Freezepok/CAD-Paspa/Useless Box/Dokumentation/Dokumentation JH/Screenshots/Montage_10.png

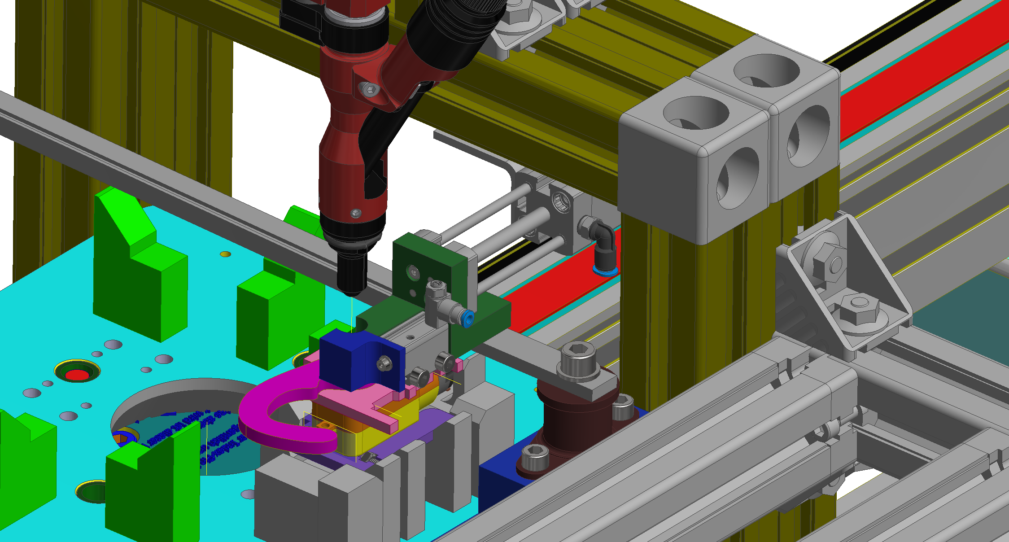
Useless Box/Dokumentation/Dokumentation JH/Screenshots/Montage_10.png
