Freezepok/CAD-Paspa/Useless Box/Dokumentation/Dokumentation JH/Screenshots/Montage_14.png

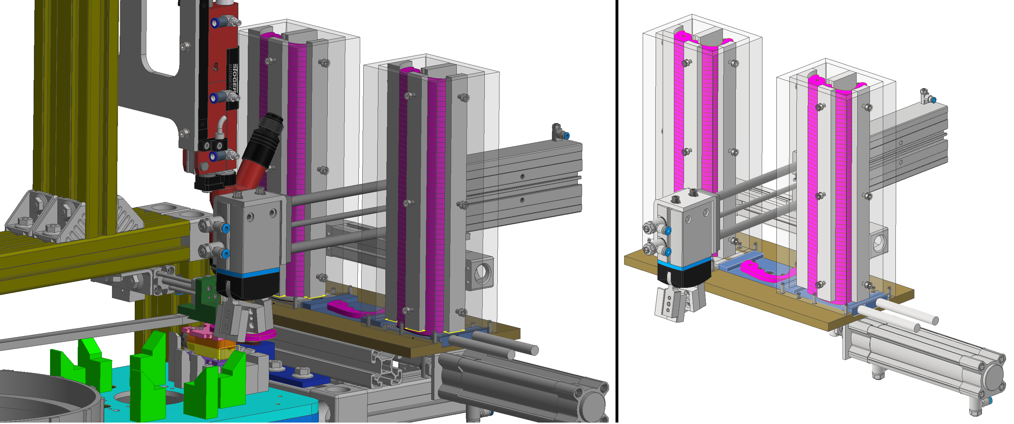
Useless Box/Dokumentation/Dokumentation JH/Screenshots/Montage_14.png
