Freezepok/CAD-Paspa/Useless Box/Praesentation/Praesentation_Gruppe5.pptx

## Useless Box

- Gruppe 5: Fingermontage auf der Antriebseinheit

- Jakob Hoffman, Tino Stöhr, Erik Reisich | MR | SoSe 2025

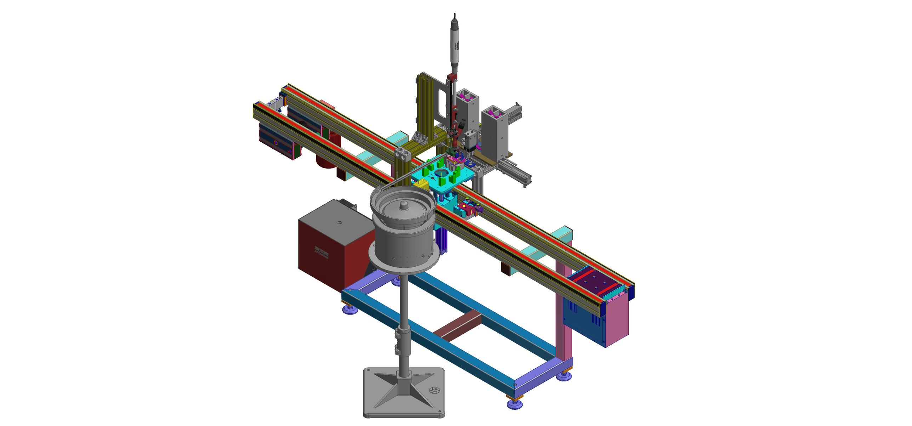
[picture p3: figure]

Useless Box | Jakob Hoffman, Tino Stöhr, Erik Reisich | MR | SoSe 2025

## Themen

- Konzeptentwicklung
- Baugruppen
- Fazit

## Konzeptentwicklung

- Aufgabenstellung
- erste Ideen
- Vorgehensweise

## Konzeptentwicklung

## Baugruppen

- Erkennung Wellenlage
- Handhabung Finger
- Handhabung Unterlegscheiben
- Verschraubeinheit

## Baugruppen

## Fazit

## Fazit

## Slide 9

- Gruppe 5

- Vielen Dank
