Freezepok/CAD-Paspa/Useless Box/__Projekt_Useless_Box.pdf

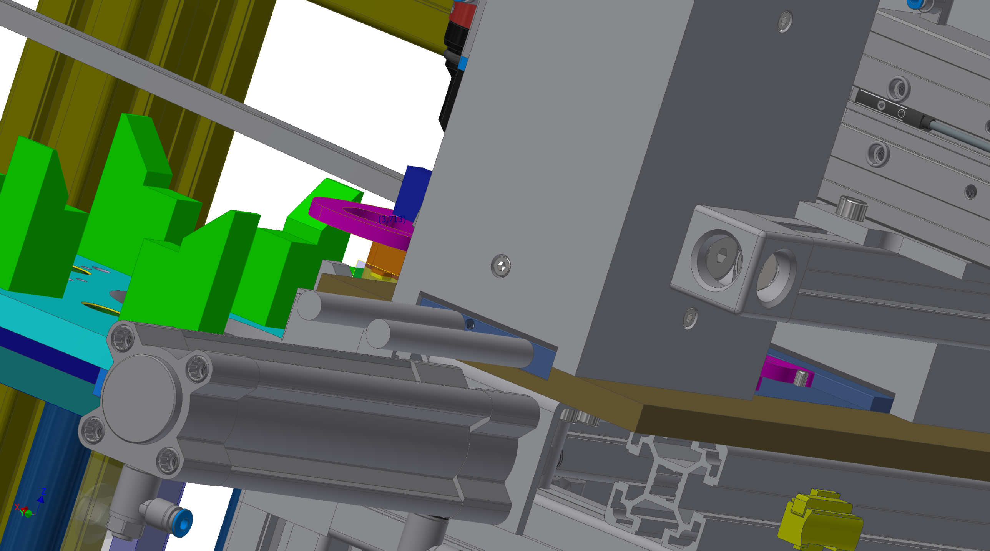
[picture p26: page 1]
