Freezepok/CAD-Paspa/Paspa/Vorlesung/KmC-03.pdf

## Konstruieren mit CAD

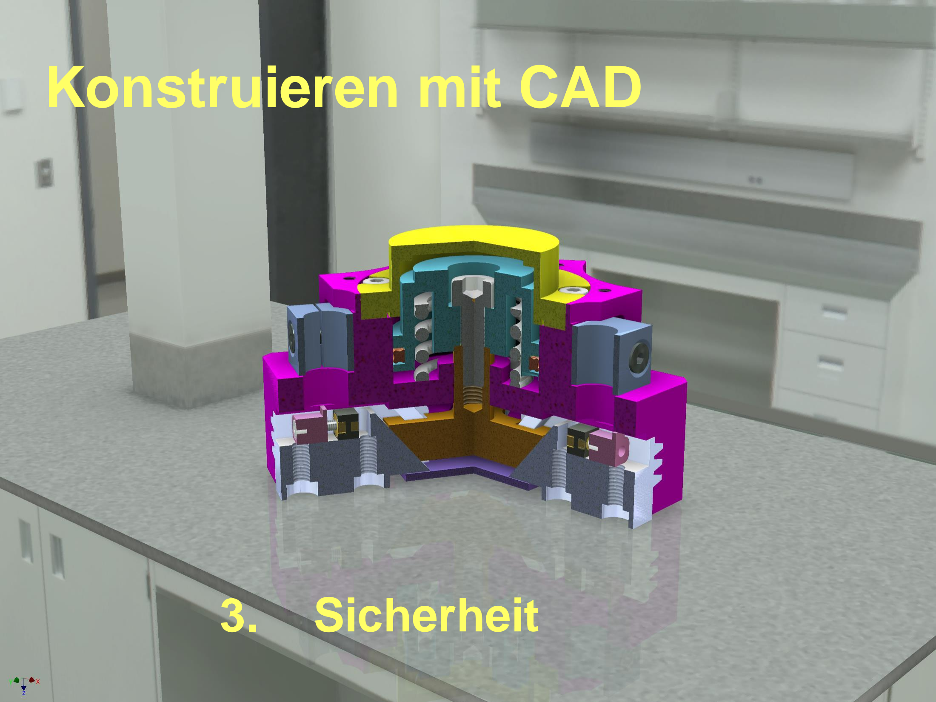
[picture p27: page 1]

### 3. Sicherheit

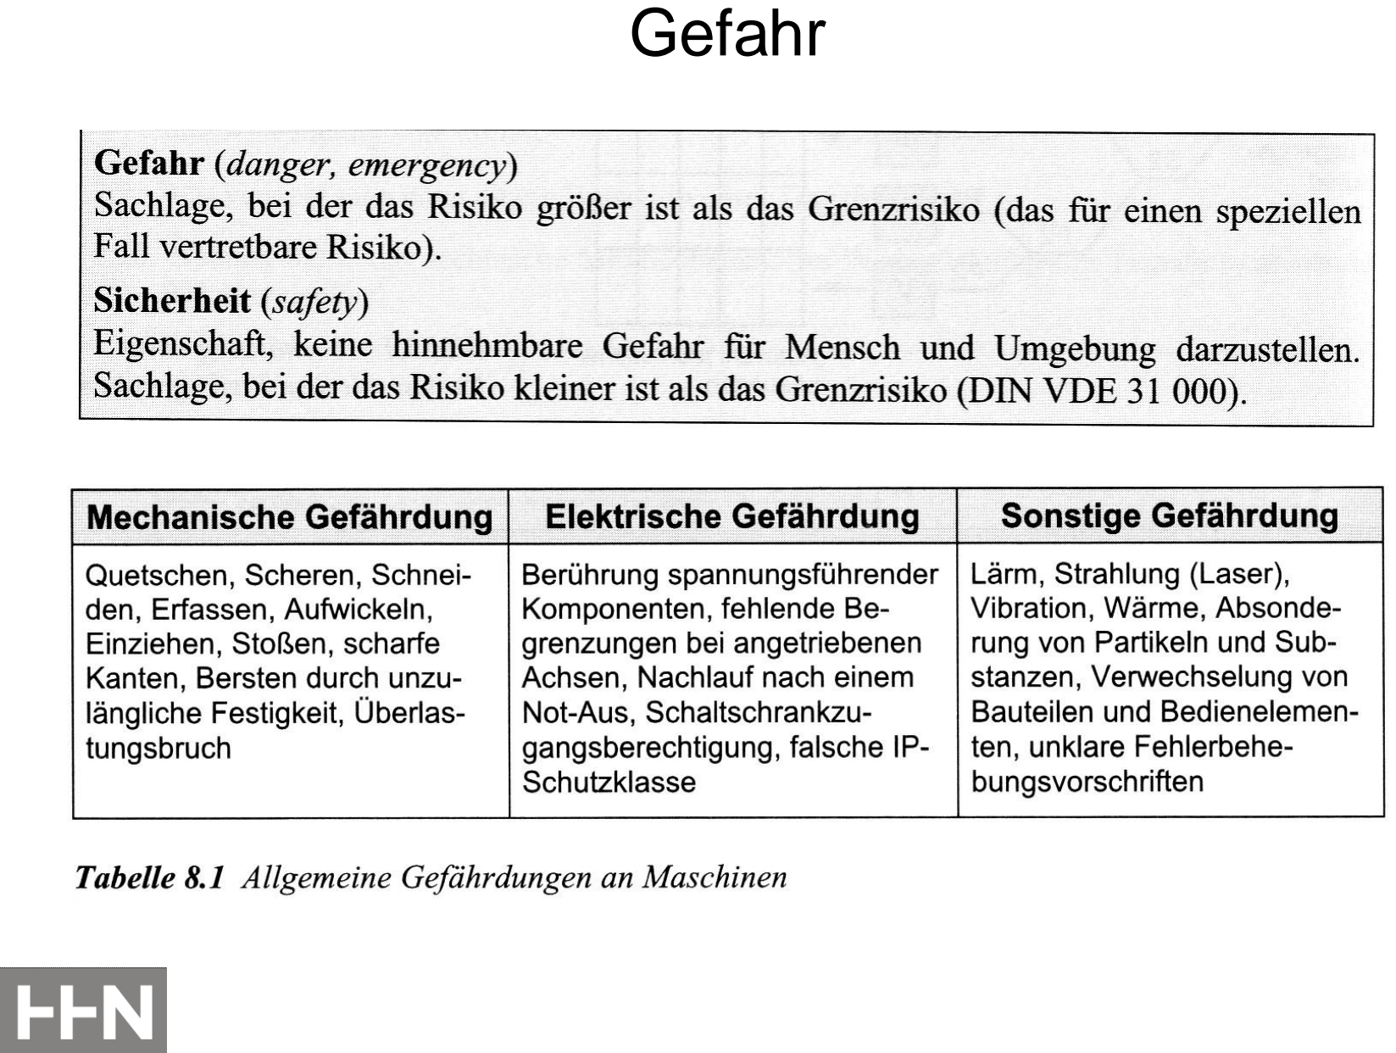
[picture p28: page 2]

Gefahr

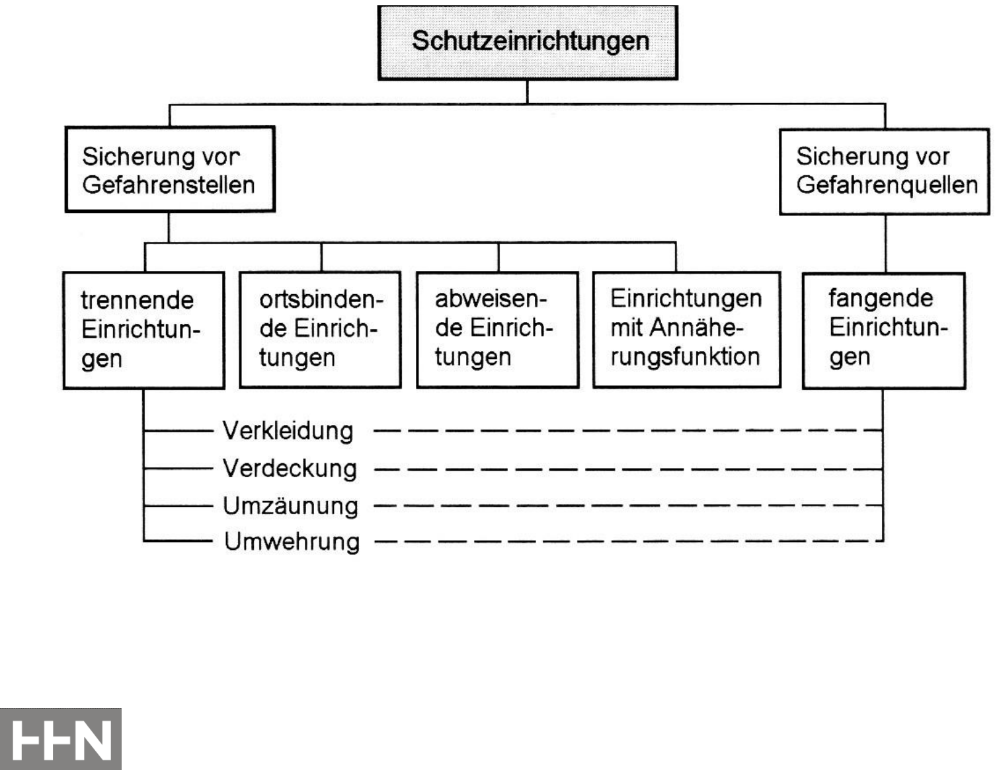
[picture p29: page 3]

Schutzeinrichtungen

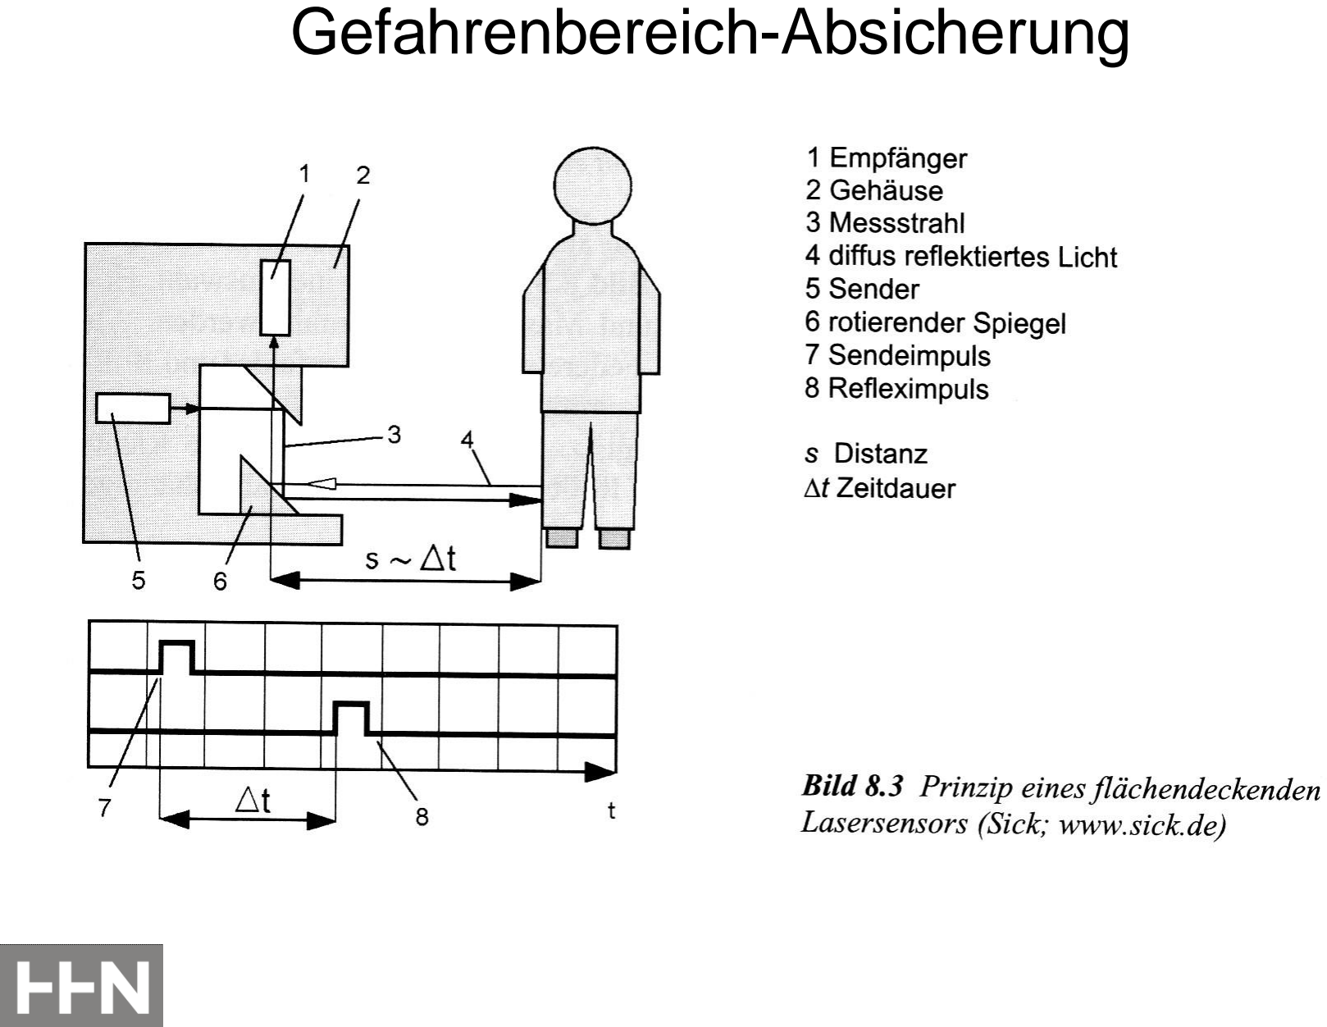
[picture p30: page 4]

Gefahrenbereich-Absicherung

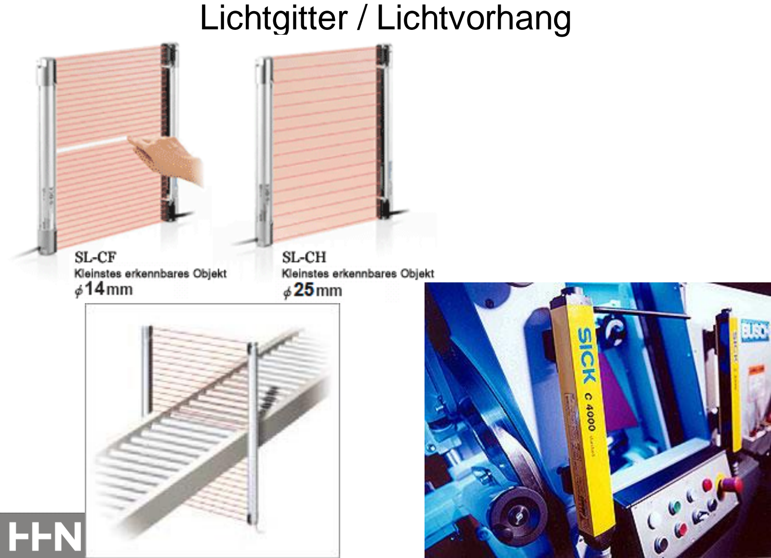
[picture p31: page 5]

Lichtgitter / Lichtvorhang

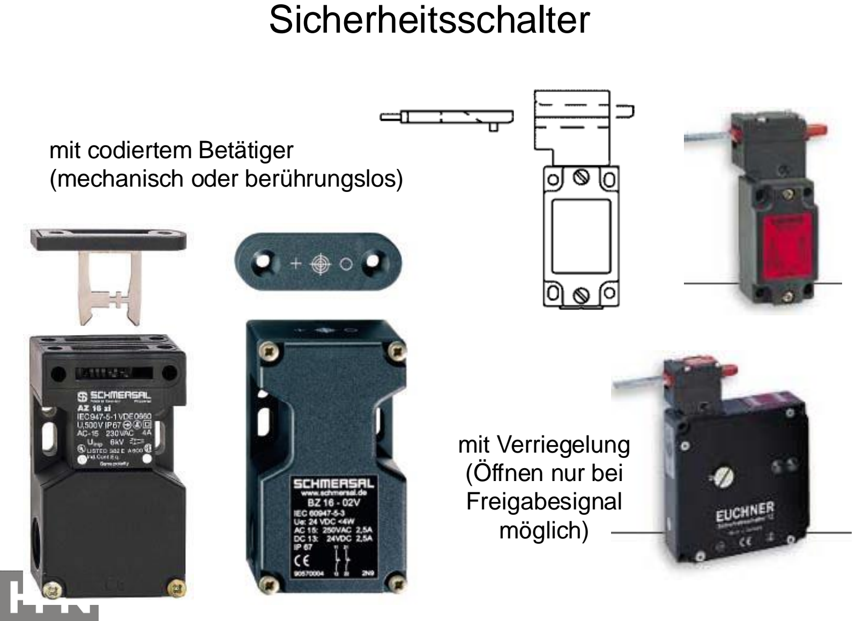
[picture p32: page 6]

Sicherheitsschalter

mit codiertem Betätiger
(mechanisch oder berührungslos)

mit Verriegelung
(Öffnen nur bei
Freigabesignal
möglich)

Sicherheitsvorrichtung bei Teilezuführung

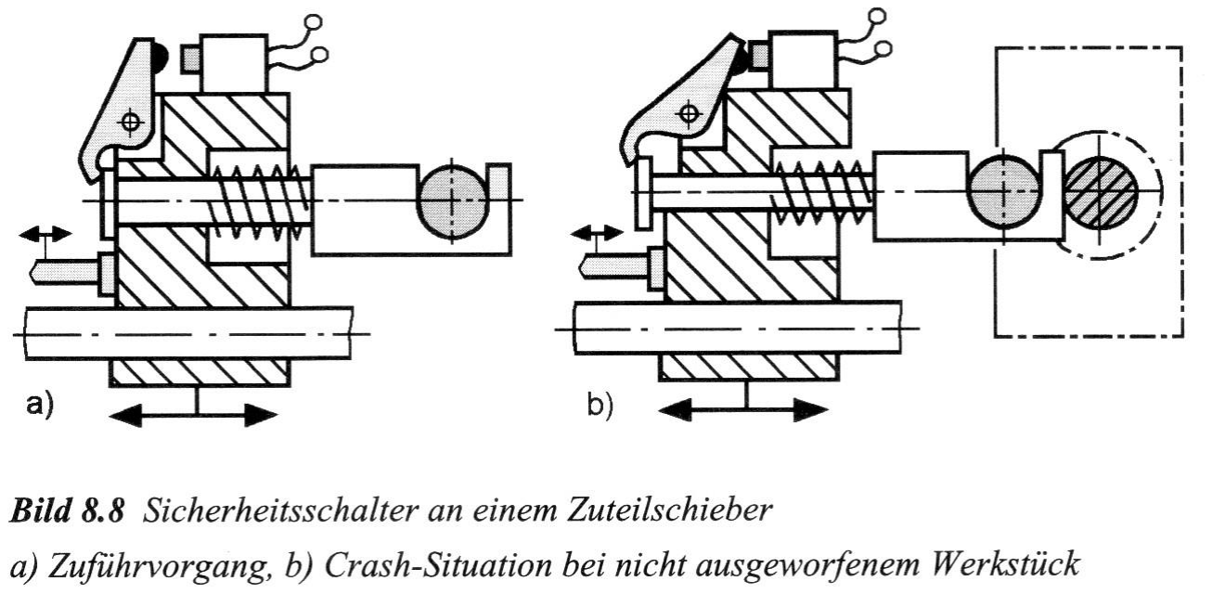
[picture p33: figure]

Sicherheitsvorrichtung bei Teilezuführung

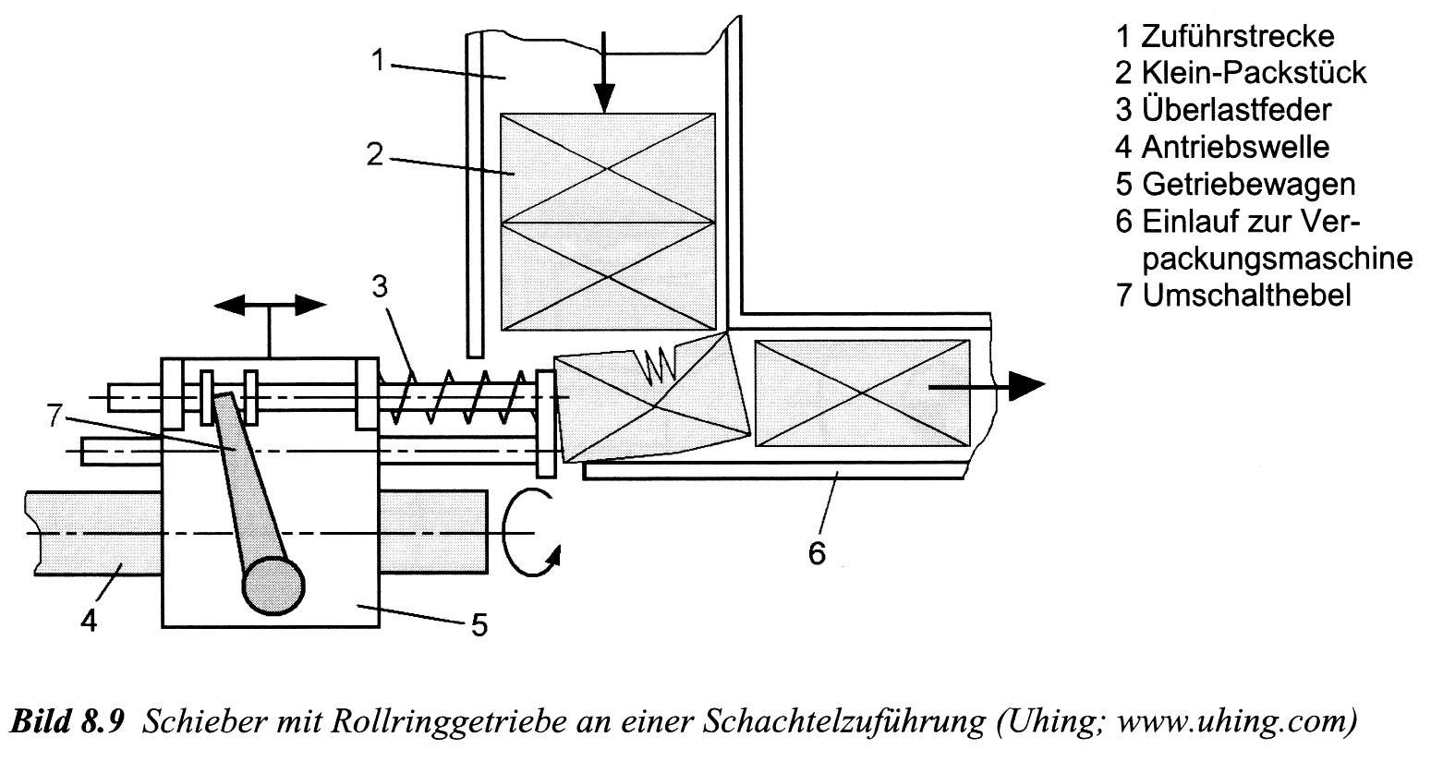
[picture p34: figure]
