Freezepok/CAD-Paspa/Paspa/Vorlesung/KmC-05.pdf

## Methodische Produktentwicklung

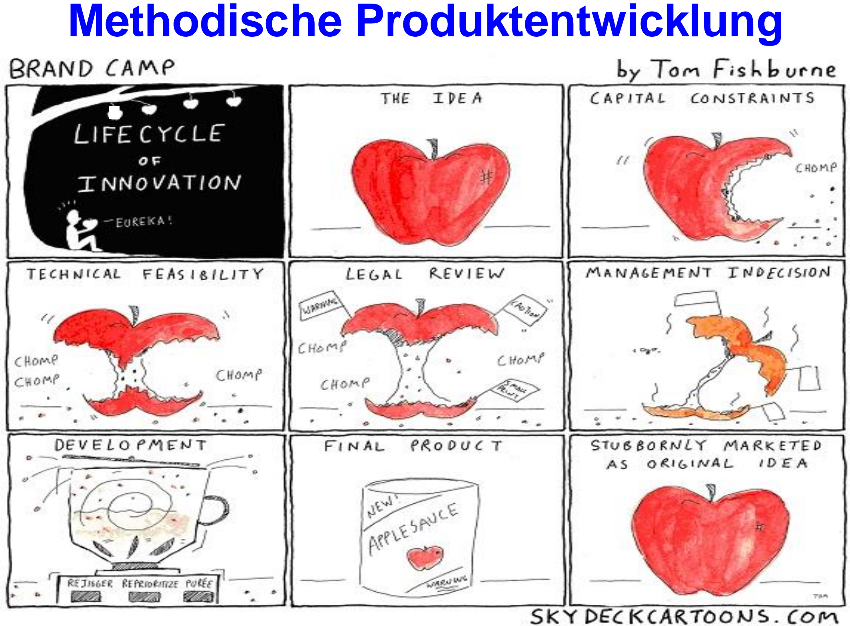
[picture p35: page 1]

Zunahme der
Informationen zur
Erzeugung einer
Lösungsvielfalt

Einschränkung der
Lösungsvielfalt

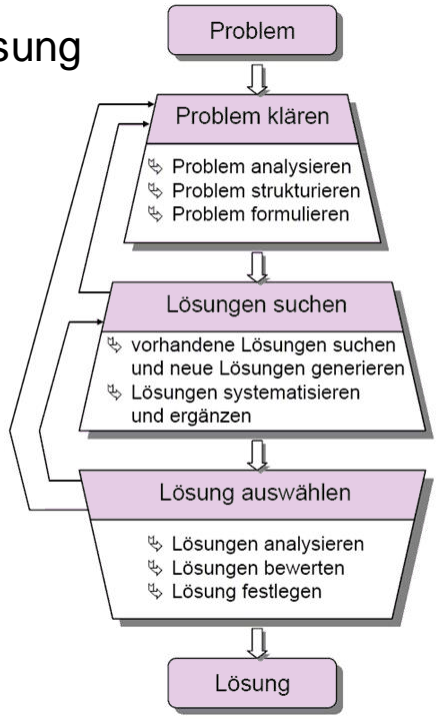
[picture p36: figure]

## Vom Problem zur Lösung

## Teilschritte

## Entwicklungsprozess nach VDI 2223

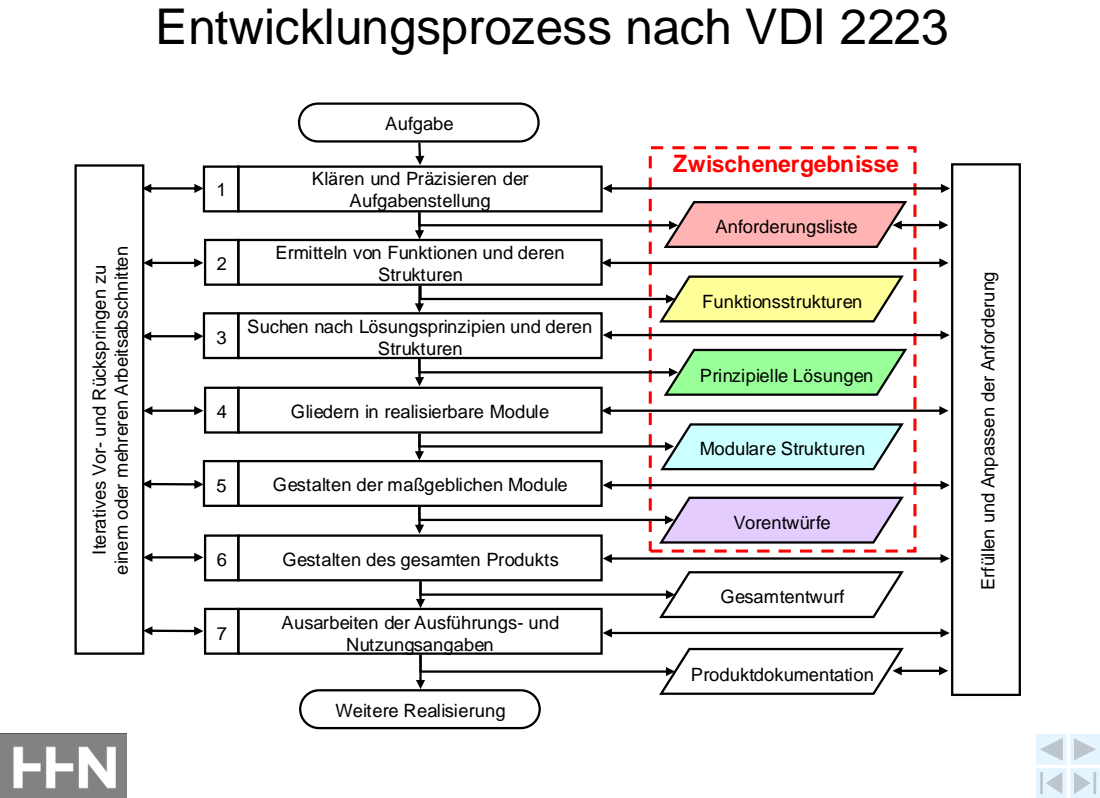
[picture p37: page 3]
Zwischenergebnisse; Aufgabe; Aufgabenstellung 1; Strukturen 2; Weitere Realisierung; Gliedern in realisierbare Module; Gestalten der maßgeblichen Module; Gestalten des gesamten Produkts; Nutzungsangaben 7; Anforderungsliste; Funktionsstrukturen; Prinzipielle Lösungen; Modulare Strukturen; Vorentwürfe; Gesamtentwurf; Produktdokumentation

Klären und Präzisieren der

einem oder mehreren Arbeitsabschnitten

Ermitteln von Funktionen und deren

Iteratives Vor- und Rückspringen zu

Erfüllen und Anpassen der Anforderung

Suchen nach Lösungsprinzipien und deren
Strukturen 3

Ausarbeiten der Ausführungs- und

## Straßenbeleuchtung früher | und heute

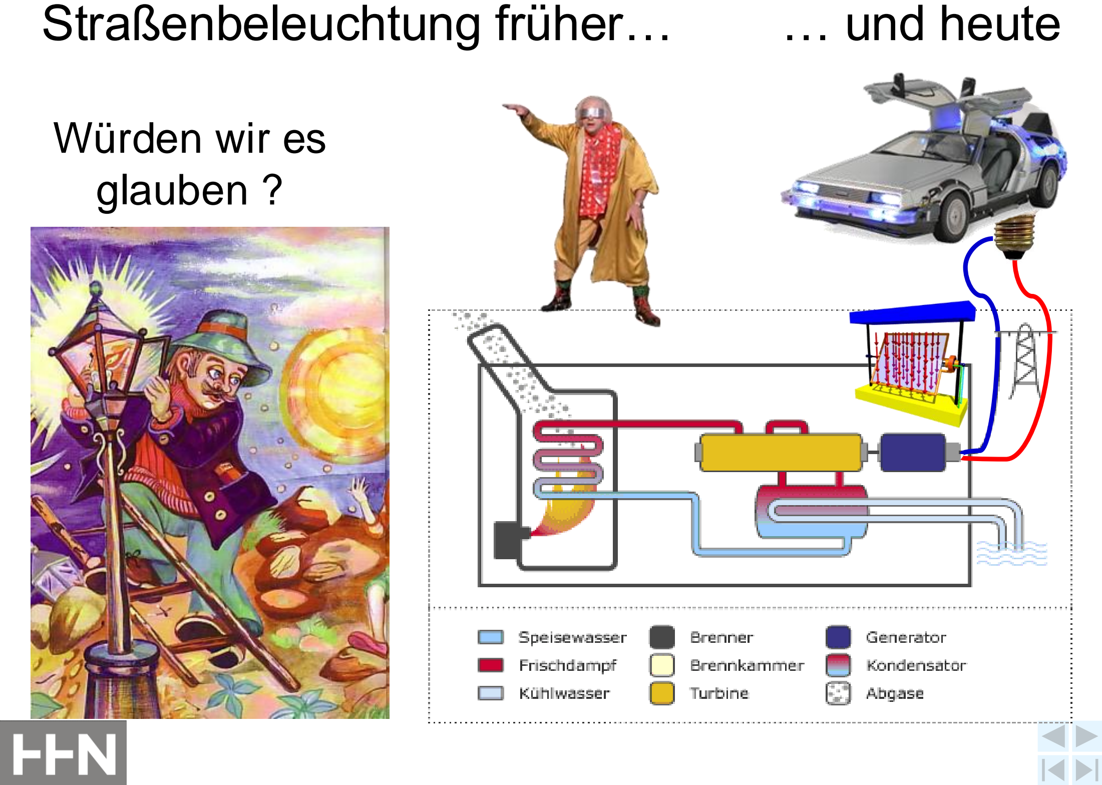
[picture p38: page 4]

Würden wir es
glauben ?

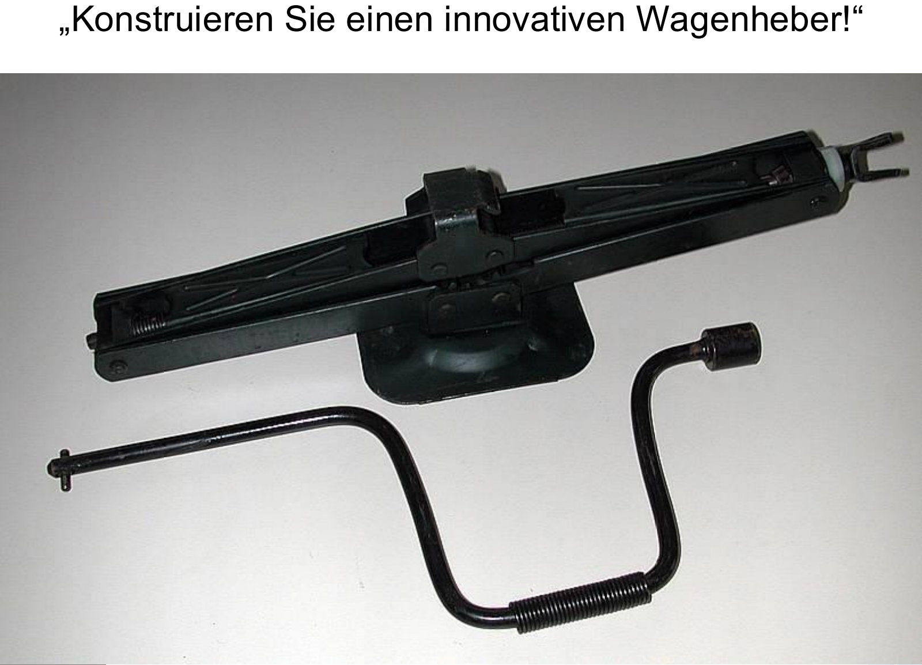
[picture p39: page 5]

„Konstruieren Sie einen innovativen Wagenheber!“

## Die Crux

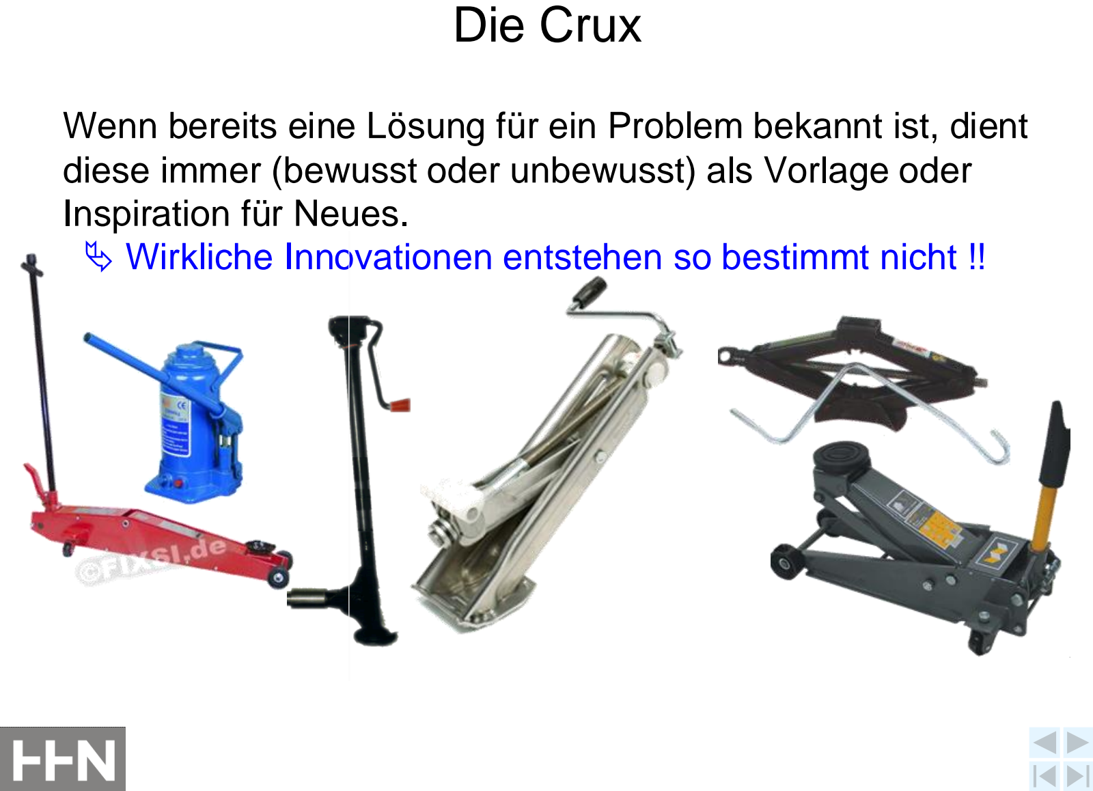
[picture p40: page 6]

Wenn bereits eine Lösung für ein Problem bekannt ist, dient diese immer (bewusst oder unbewusst) als Vorlage oder Inspiration für Neues.
- Wirkliche Innovationen entstehen so bestimmt nicht !!

## Hauptfunktion und Nebenfunktionen

Hauptfunktion
- Fahrzeug anheben
Nebenfunktion
- Befestigung im Fahrzeug bei Nichtgebrauch
- Demontierbar (einfachere Unterbringung)

## Anforderungen

Hauptfunktion
- Fahrzeug anheben
Nebenfunktion
- Befestigung im Fahrzeug bei Nichtgebrauch
- Demontierbar (einfachere Unterbringung)

Teilfunktion
- Fixierung am Fahrzeug ➔ Wo, Wie ?
- Muskelkraft verstärken ➔ Betrag ?
- Fahrzeug oben halten ➔ Gewicht ?

## Anforderungsliste

Nr. | Anforderung | Zahlenwert Toleranz | Forderung Wunsch | Name | Datum
1 | Befestigungsmöglichkeit | | F | AB | 31.10.
2 | Verfügbare Muskelkraft | 100 N | F | EF | 25.09.
3 | Fahrzeugmasse | 2000 kg | F | AB | 05.11.
4 | Unterbringung | | W | GH | 10.12.
5 | Demontierbarkeit | W | CF | 08.11.

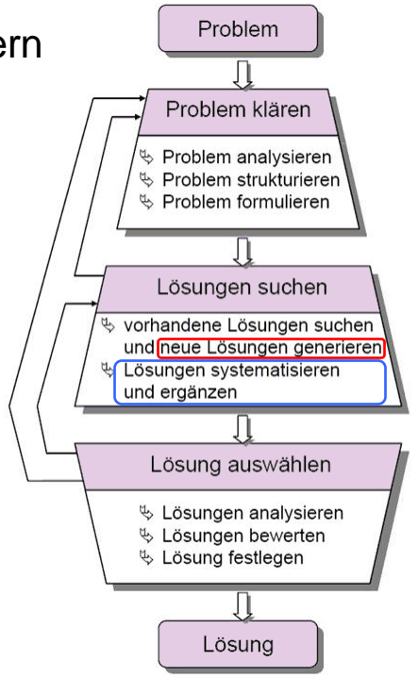
[picture p41: figure]

## Lösungsraum erweitern

## Lösungsraum erweitern

- Bekannte oder zufällig gefundene Lösungen könnten unterschieden werden anhand:
– Effekte, Form, Größe, Wirkflächen, Freiheitsgrade, Verbindungsarten, Fertigungsverfahren
- Gezielte Variation einzelner Merkmale vereinfacht die Suche nach alternativen Lösungen
- Zusammenfassung der Kombinationen einzelner Merkmale in Matrix-Form
- Zunächst freibleibende Felder deuten auf weitere, bisher unbekannte Lösungen hin (Systematische Erweiterung)

## Aufgabe: „Objekt beschleunigen“ (vgl. „Werfen“)

# Brainstorming: 1.Idee: 2.Idee: 3.Idee: 4.Idee:

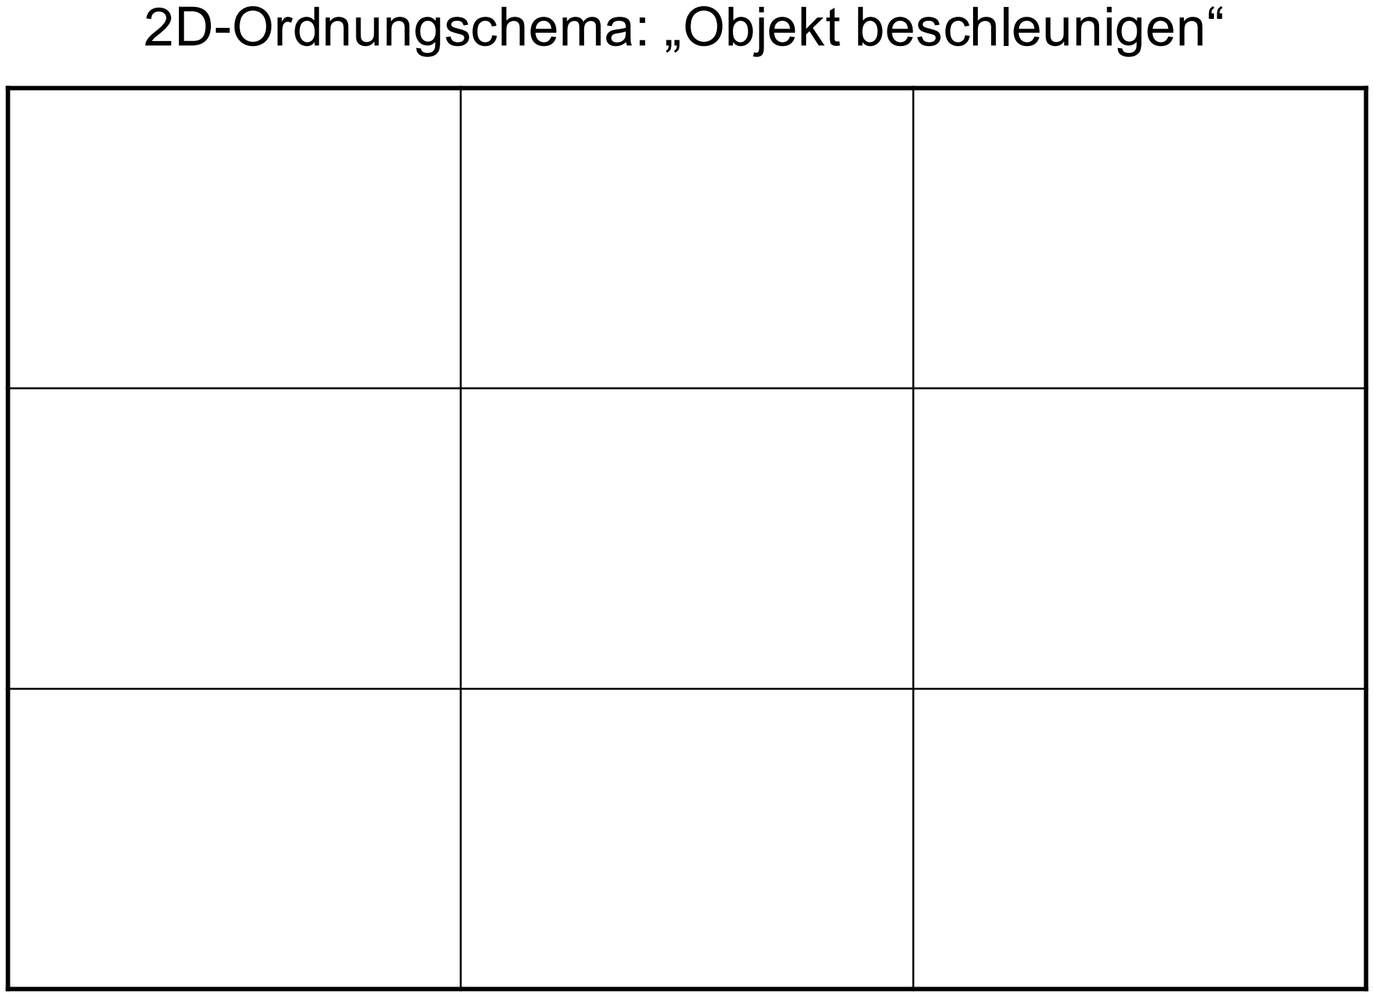
[picture p42: figure]
2D-Ordnungschema: „Objekt beschleunigen“

## Morphologischer Kasten

- Hilfsmittel zur Zusammenfassung von Teillösungen für Teilfunktionen
- Erlaubt die übersichtliche Kombination zu verschiedensten Gesamtlösungen
Funktion | Lösungen
Teilfunktion 1 | Teillösung 1.1 | Teillösung 1.2
Teilfunktion 2 | Teillösung 2.1 | Teillösung 2.2
Teilfunktion 3 | Teillösung 3.1 | Teillösung 3.2 | Teillösung 3.3
Teilfunktion 4 | Teillösung 4.1 | Teillösung 4.2 | Teillösung 4.3
Teilfunktion 5 | Teillösung 5.1 | Teillösung 5.2 | Teillösung 5.3 | Teillösung 5.4
Ges.-Lös. A Ges.-Lös. B | Ges.-Lös. C

## Methodeneinsatz zu vorchristlicher Zeit

Holzscheiben mit gruppierten Konstruktionsmerkmalen zur Entwicklung neuer Kampfmaschinen
(Archimedes v. Syracus, 287-212 v.Chr.)

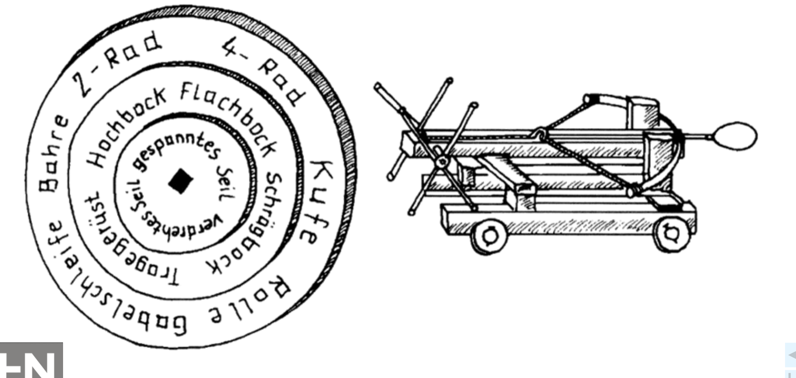
[picture p43: figure]

## Variation der Lage

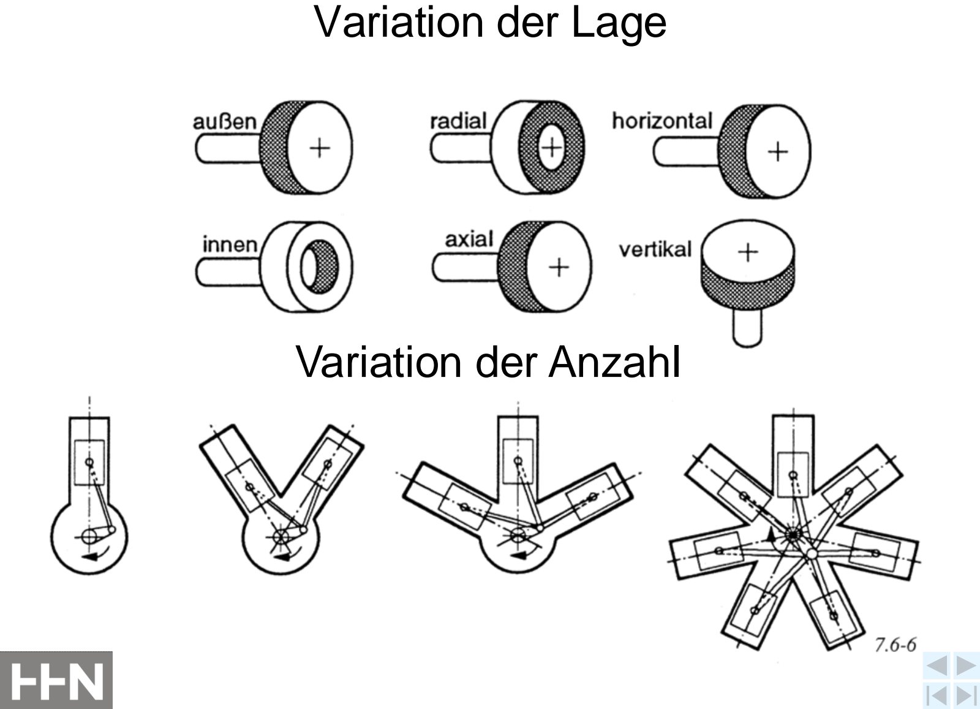
[picture p44: page 16]

## Variation der Anzahl

## Variation der Verbindungsstruktur

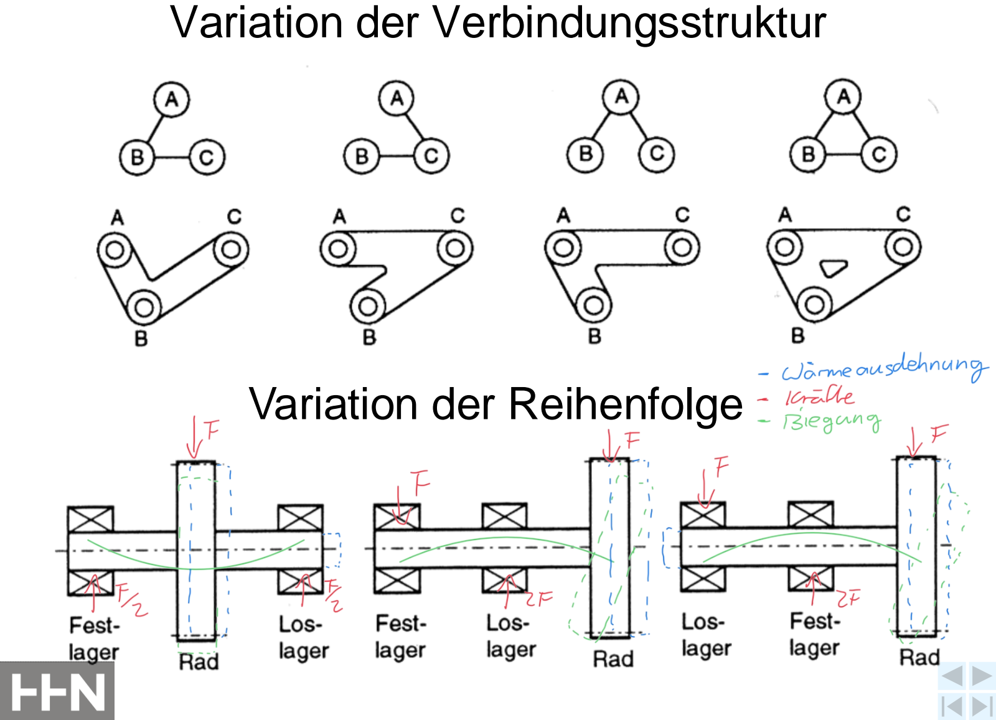
[picture p45: page 17]

## Variation der Reihenfolge

## Variation der Kompaktheit

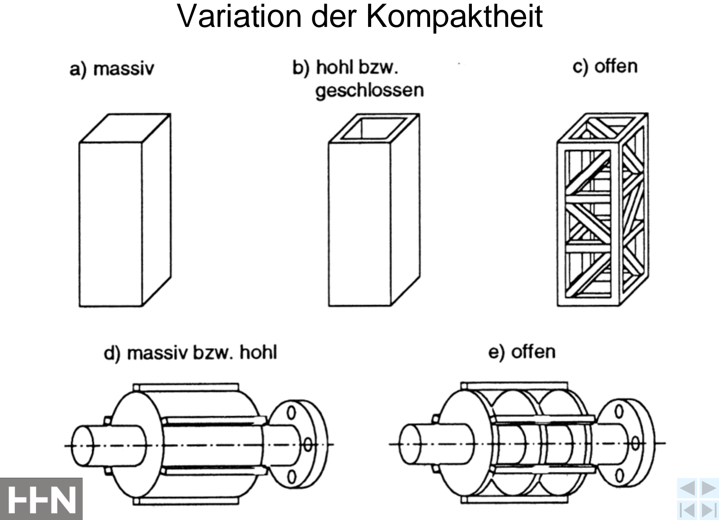
[picture p46: page 18]

Umwelt

System

Wagenheber als System

Abstrakte Betrachtungsweise (Black-Box-Prinzip)
Ein System interagiert über die Systemgrenzen hinweg mit
seiner Umwelt
Systemgrenzen sollte derart festgelegt werden, dass die Zahl der Interaktionen gering ist und die Arten (Funktionen) der Interaktion bekannt bzw. einfach bestimmbar sind
Ein System kann aus Elementen und Subsystemen bestehen

Systemgrenze

Umwelt | Wagenheber als System

Abstrakte Betrachtungsweise (Black-Box-Prinzip)
Ein System interagiert über die Systemgrenzen hinweg mit
seiner Umwelt
Systemgrenzen sollte derart festgelegt werden, dass die Zahl der Interaktionen gering ist und die Arten (Funktionen) der Interaktion bekannt bzw. einfach bestimmbar sind
Ein System kann aus Elementen und Subsystemen bestehen

Untergrund

KFZ | Mensch

System

Systemgrenze

Wirkzusammenhänge
(Relationen)

Wagenheber als System

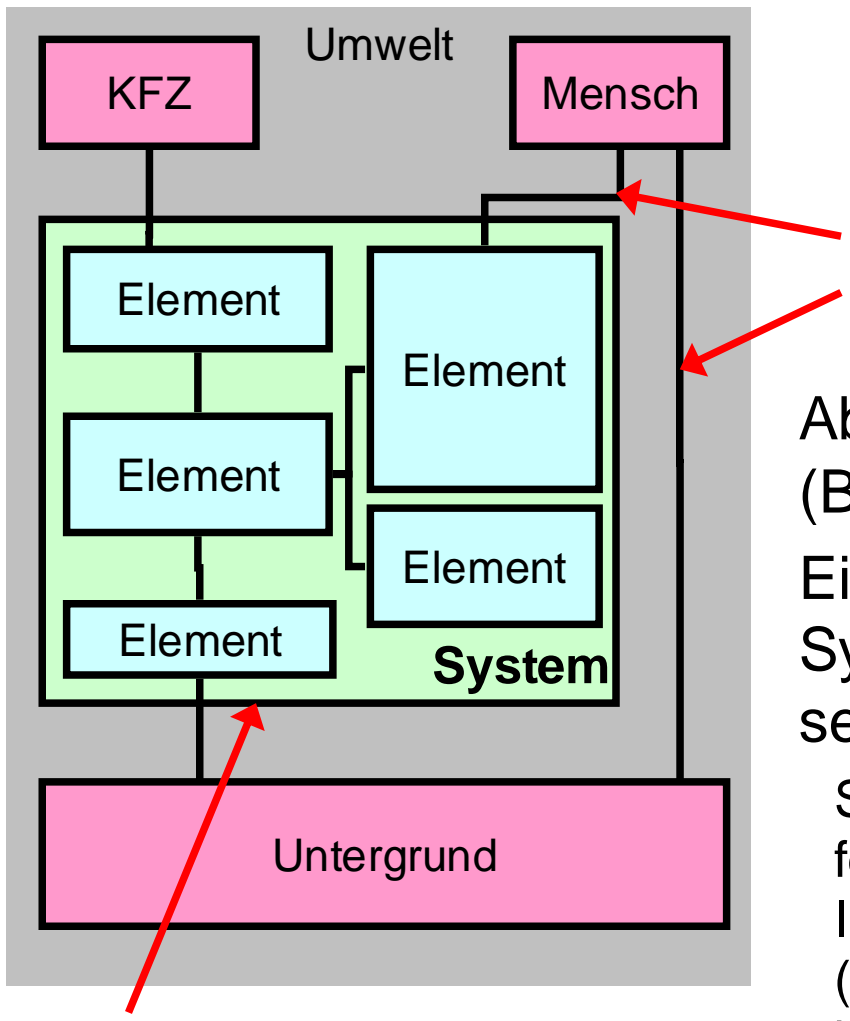
[picture p47: figure]
Umwelt; System; Untergrund; Element; KFZ; Mensch

Abstrakte Betrachtungsweise (Black-Box-Prinzip)
Ein System interagiert über die Systemgrenzen hinweg mit
seiner Umwelt
Systemgrenzen sollte derart festgelegt werden, dass die Zahl der Interaktionen gering ist und die Arten (Funktionen) der Interaktion bekannt bzw. einfach bestimmbar sind
Ein System kann aus Elementen und Subsystemen bestehen

Wirkzusammenhänge
(Relationen)

Systemgrenze

Wagenheber als System

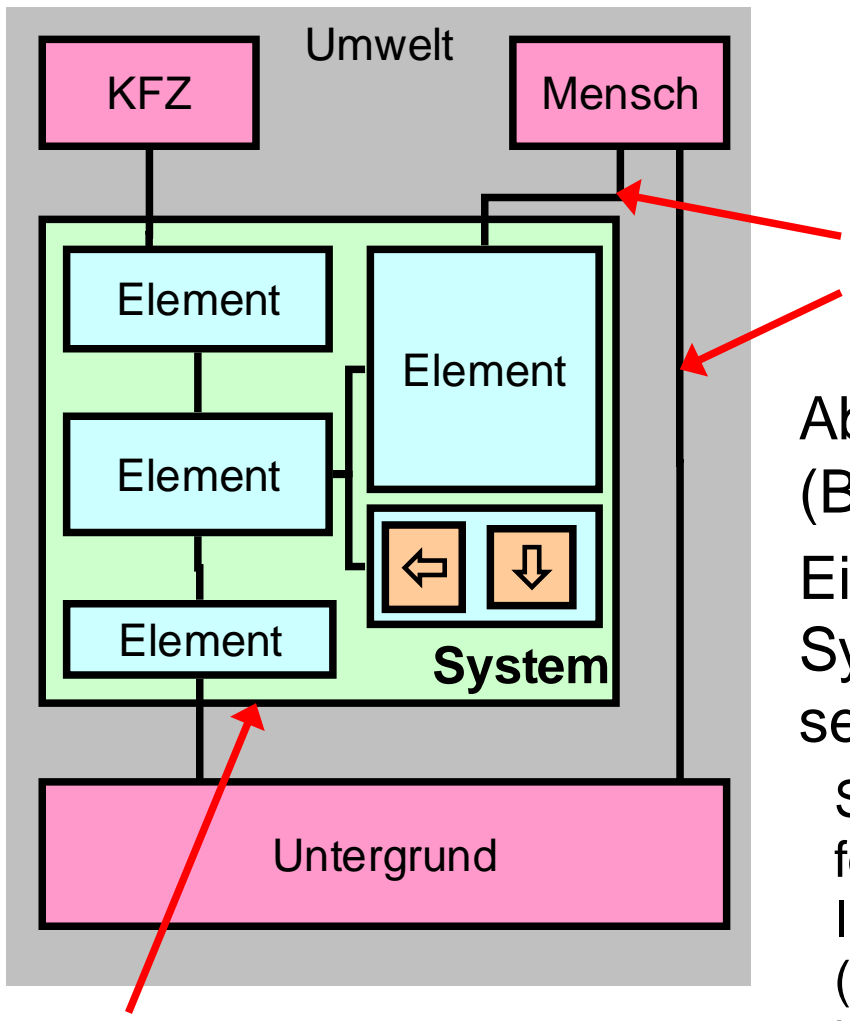
[picture p48: figure]
Umwelt; System; Untergrund; Element; KFZ; Mensch

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

Wirkzusammenhänge
(Relationen)

Systemgrenze

## Systemtheorie (Black-Box-Prinzip)

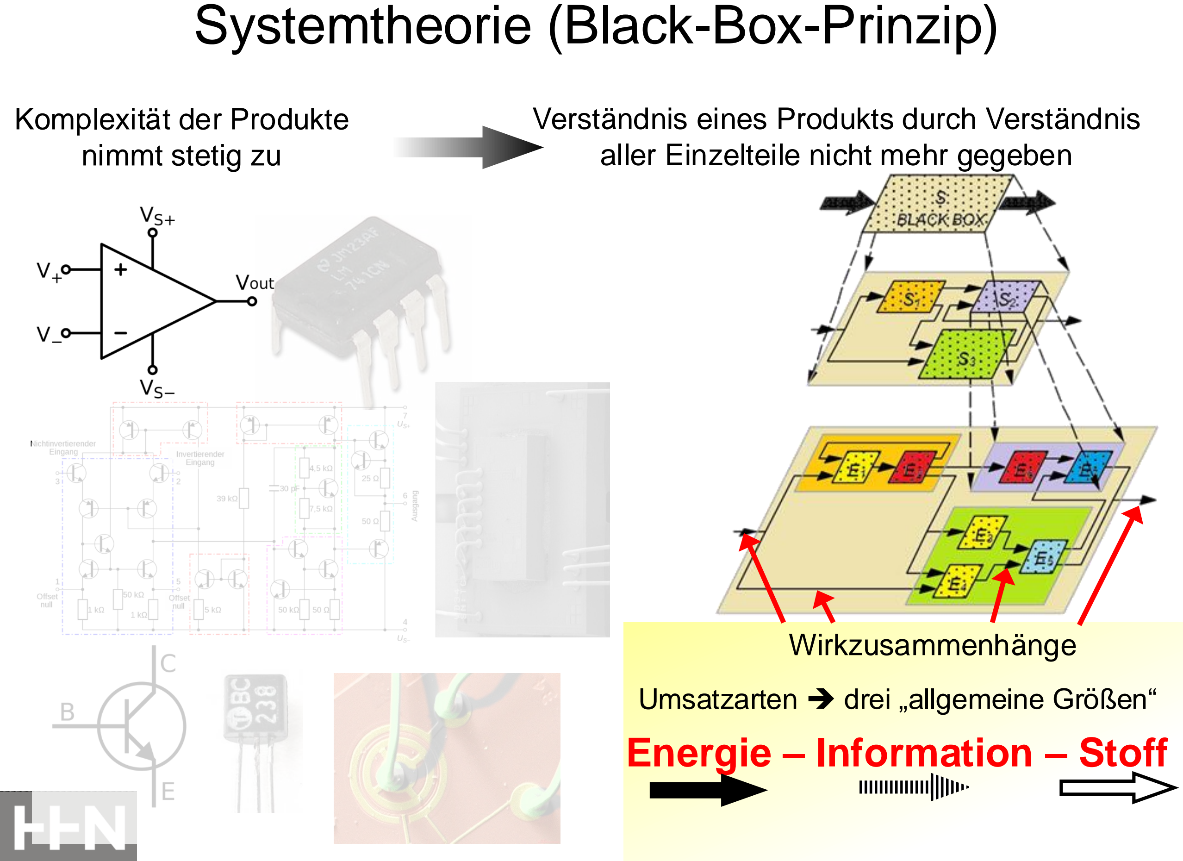
[picture p49: page 23]

Umsatzarten ➔ drei „allgemeine Größen“
Energie – Information – Stoff

Wirkzusammenhänge

Verständnis eines Produkts durch Verständnis aller Einzelteile nicht mehr gegeben

Komplexität der Produkte
nimmt stetig zu

## Funktionen

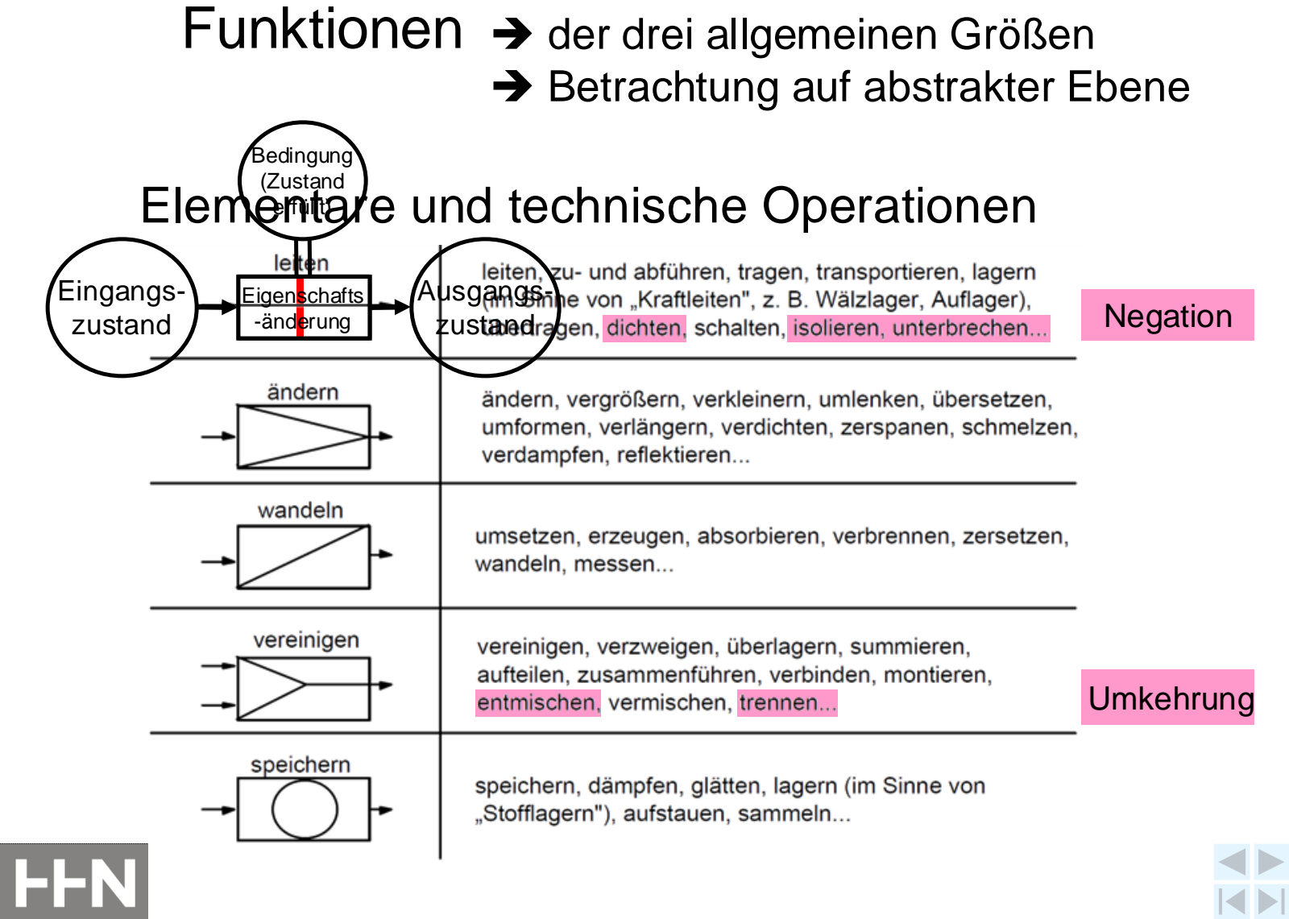
[picture p50: page 24]

Umkehrung

Negation

Ausgangszustand

Eingangszustand

Eigenschafts
-änderung

Bedingung
(Zustand Elementare und technische Operationen erfüllt)

➔ der drei allgemeinen Größen
➔ Betrachtung auf abstrakter Ebene

## Ermitteln von Funktionen

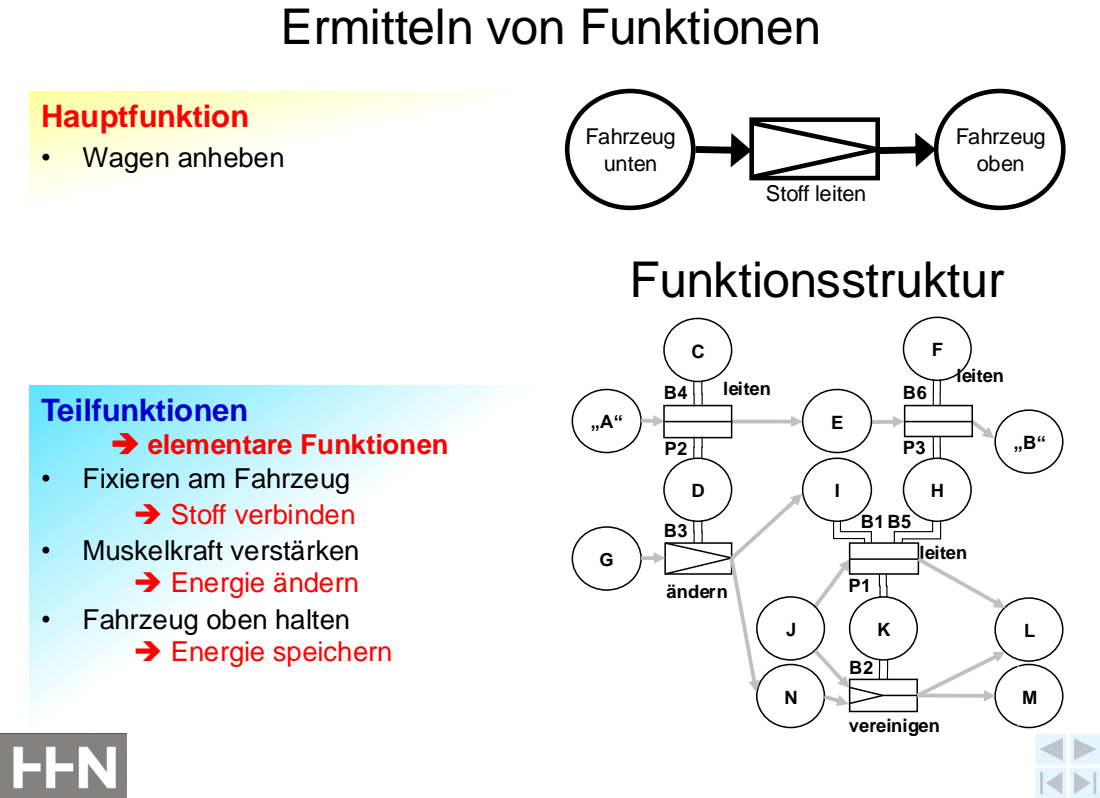
[picture p51: page 25]
Hauptfunktion; • Wagen anheben; • Muskelkraft verstärken; ➔ Stoff verbinden; ➔ Energie ändern; ➔ Energie speichern; Stoff leiten; Fahrzeug oben; Fahrzeug unten; leiten; ändern; vereinigen; Funktionsstruktur

Teilfunktionen
➔ elementare Funktionen
• Fixieren am Fahrzeug

• Fahrzeug oben halten

## Funktionen realisieren ➔ Suche nach Effekten

## Funktionsstruktur Prinziplösung

Effekte
- sind in der Natur vorkommende physikalische und chemische Phänomene
- können nur „entdeckt“ aber nicht „erfunden“ werden
- Die Nutzbarmachung eines Effekts kann sehr wohl eine Erfindung sein

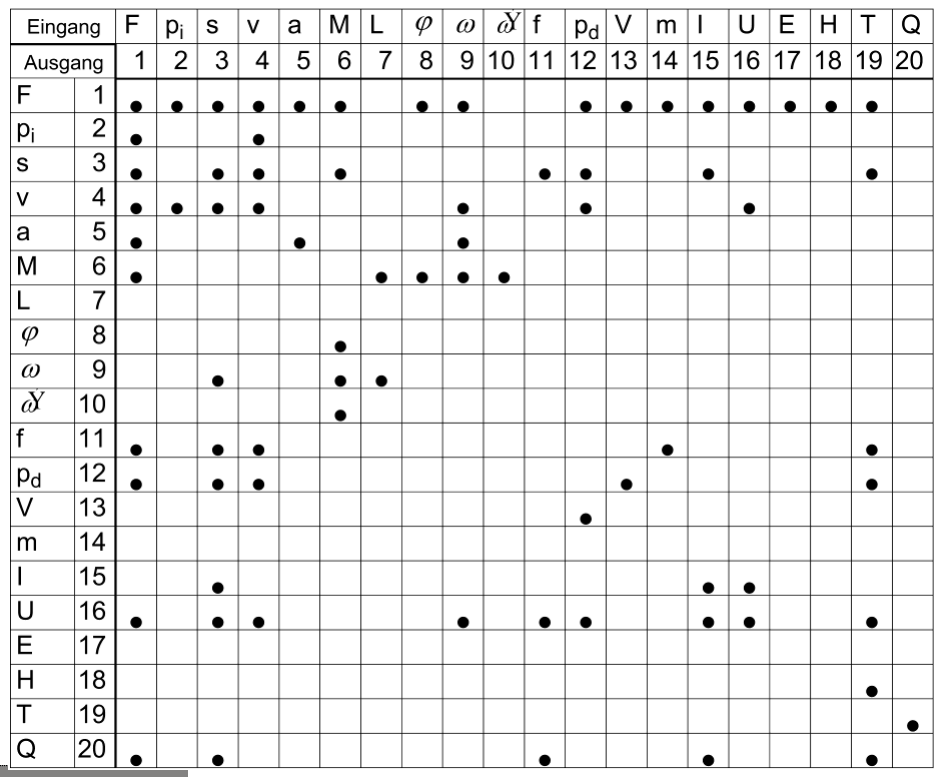
[picture p52: figure]
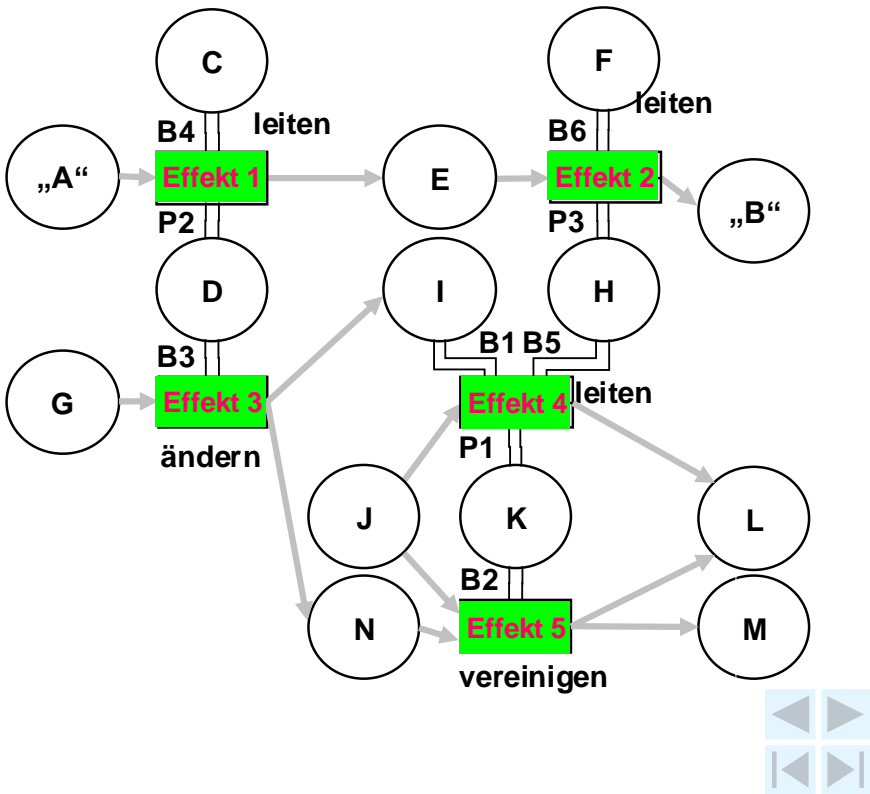
[picture p53: figure]
leiten; ändern; vereinigen; Effekt 1; Effekt 2; Effekt 3; Effekt 4; Effekt 5

## Beispiel: Antrieb eines Schwenkarms

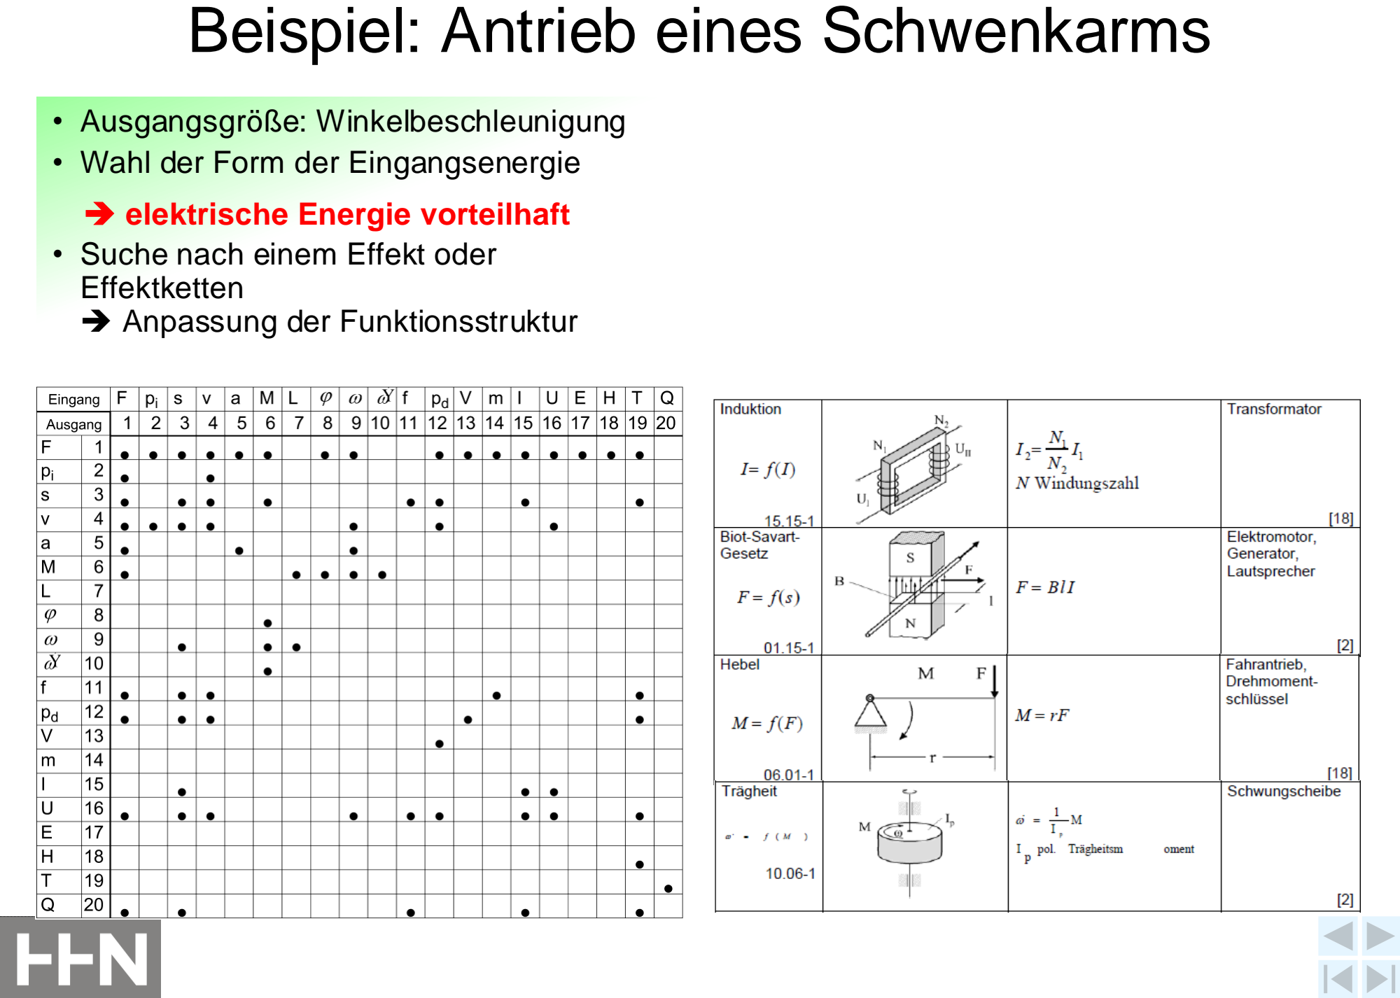
[picture p54: page 27]

- Ausgangsgröße: Winkelbeschleunigung
- Wahl der Form der Eingangsenergie
- Suche nach einem Effekt oder Effektketten
➔ Anpassung der Funktionsstruktur

➔ elektrische Energie vorteilhaft

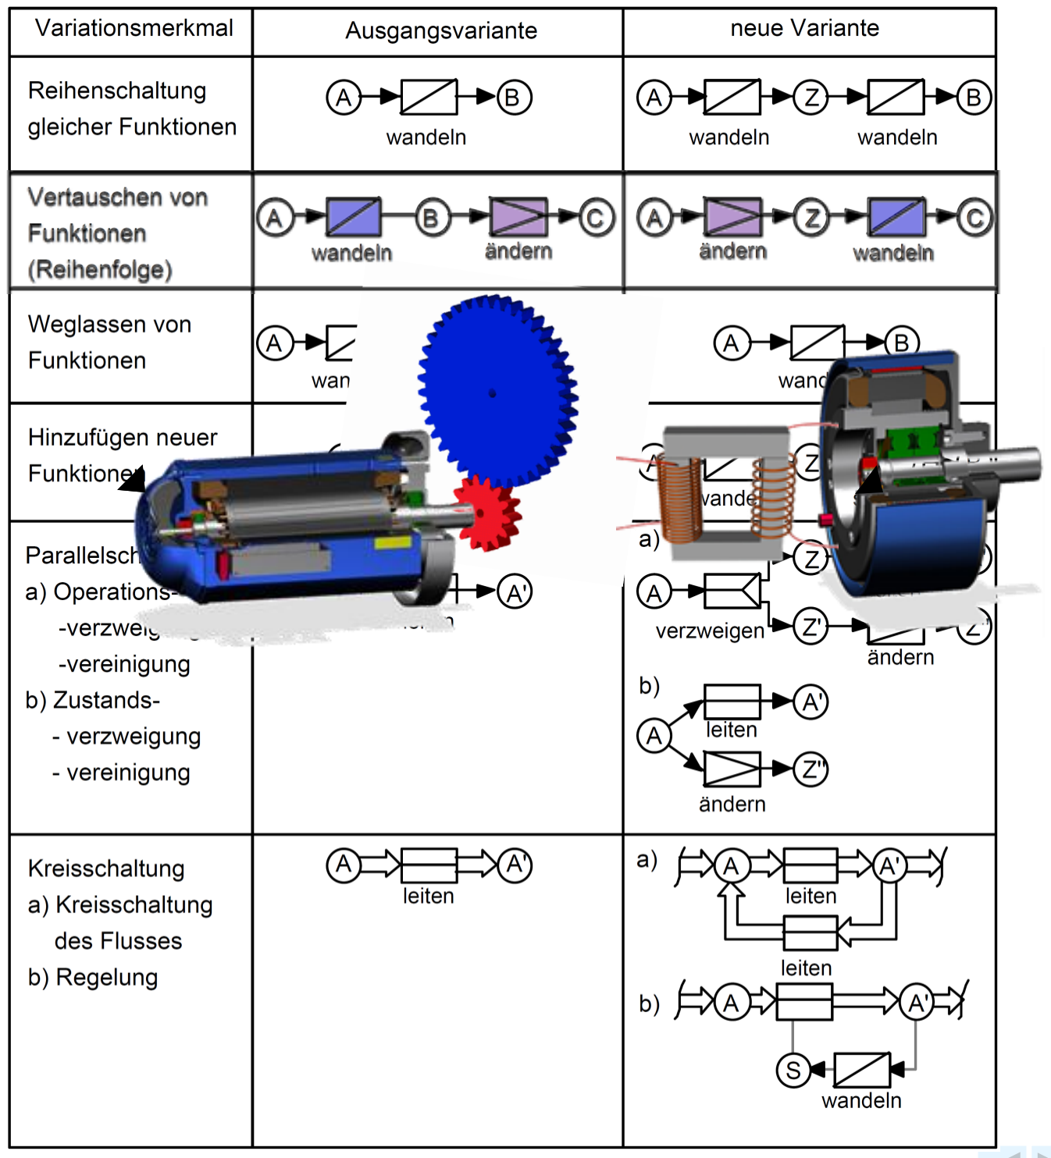
[picture p55: figure]

## Variationen

Vorteil der Abstrahierung:
- Einfacheres Erzeugen
alternativer Lösungen
- Variation der Funktionsstruktur auf der abstrakten Ebene
- Variation der
physikalischen Effekte
- Freimachen von
„Althergebrachtem“
- Überwindung von
Blockaden

01.01 – 01.02

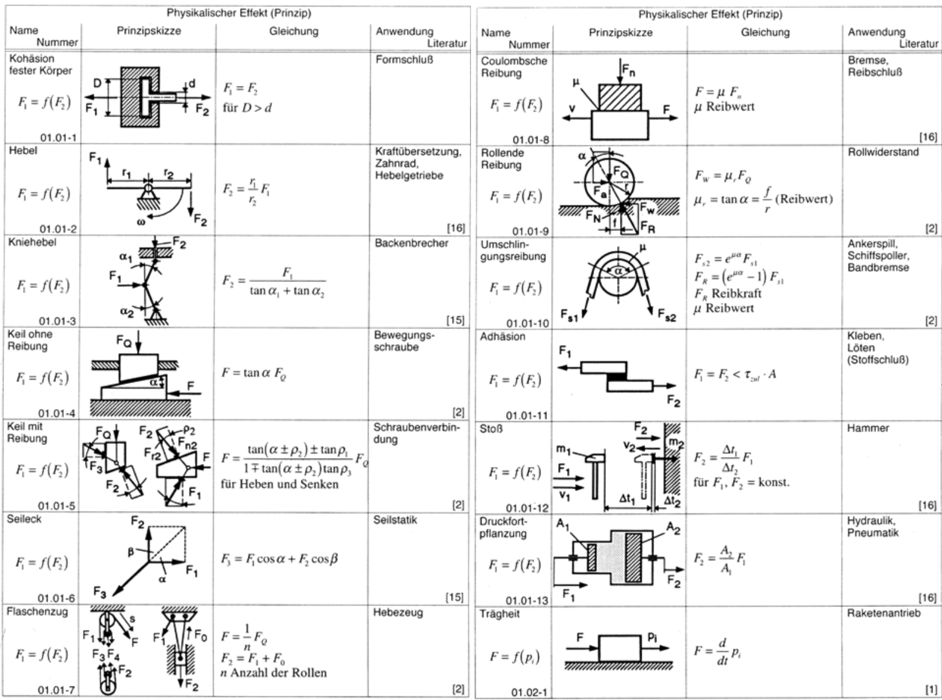
[picture p56: page 29]

01.08 – 01.15

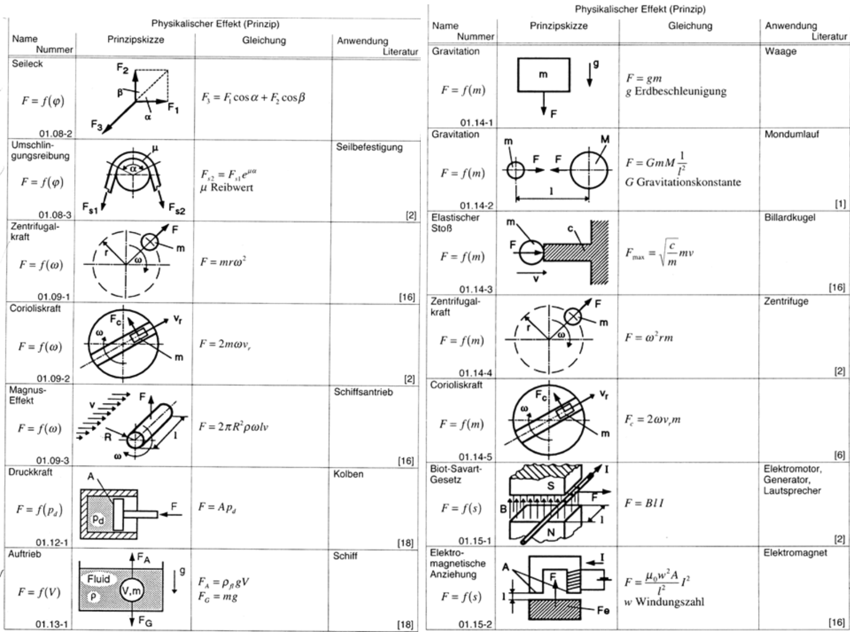
[picture p57: page 30]

## Was ist bekannt?

1. Wagen (Stoff) anheben (Potentielle Energie erhöhen)
2. Wagen oben halten (zugeführte Energie speichern)

A: Schwerenwagenheber
Muskelkraft einbringen ➔ mechanische Kraftverstärkung Energie Speichern ➔ ?

B: Hydraulischer Wagenheber

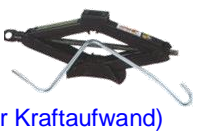
[picture p58: figure]

Muskelkraft einbringen ➔ hydraulisch-mechanische Kraftverstärkung Energie speichern ➔ ?

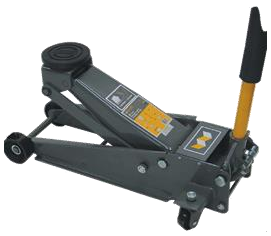
[picture p59: figure]

C: innovative Lösung?

Effekt: Reibung (Nachteilig, da hoher Kraftaufwand)

Stoff trennen (Rückschlagventil für Hydrauliköl)

## Alternative Lösung

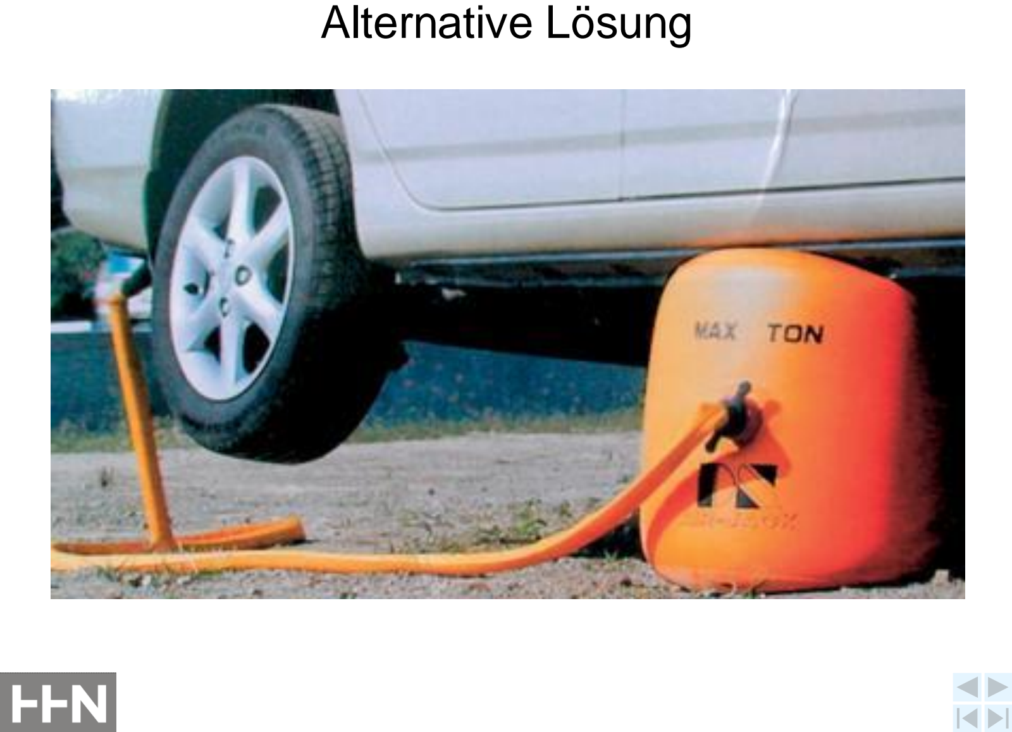
[picture p60: page 32]

## Lösungsauswahl

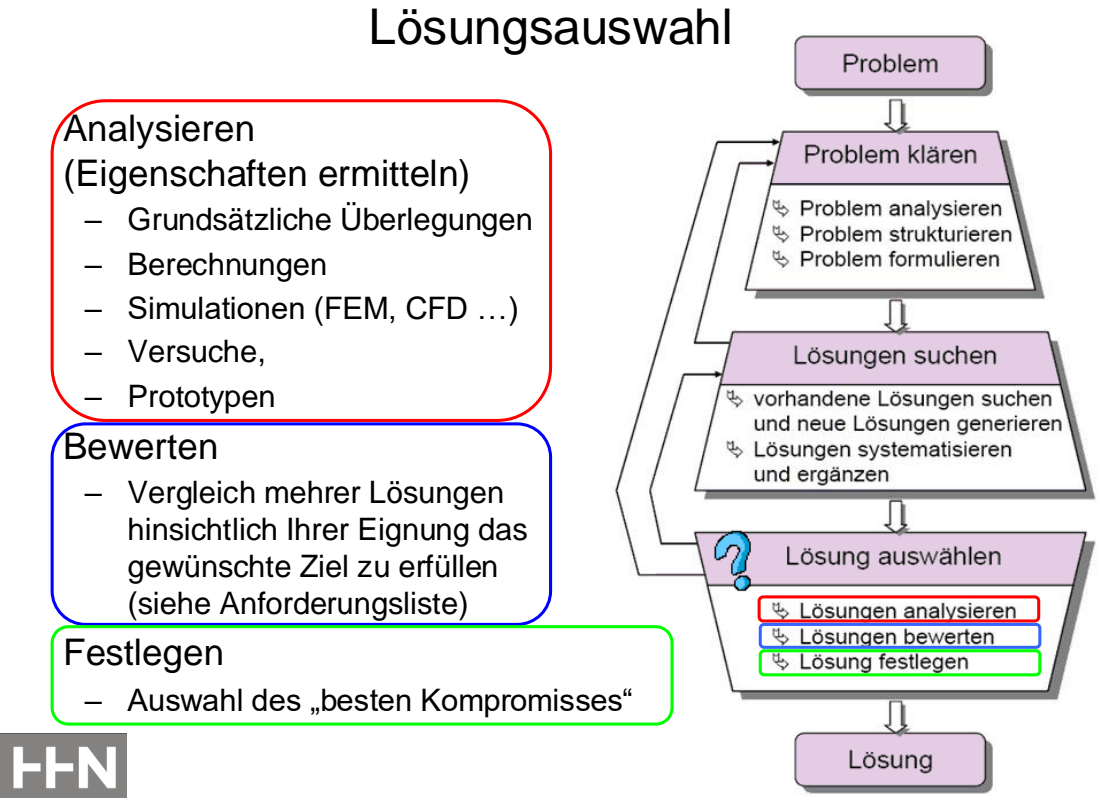
[picture p61: page 33]

Analysieren
(Eigenschaften ermitteln)
– Grundsätzliche Überlegungen
– Berechnungen
– Simulationen (FEM, CFD …)
– Versuche,
– Prototypen
Bewerten
– Vergleich mehrer Lösungen
hinsichtlich Ihrer Eignung das
gewünschte Ziel zu erfüllen
(siehe Anforderungsliste)
Festlegen
– Auswahl des „besten Kompromisses“

## Auswahl anhand von K.O.-Kriterien

Anforderung | Fahr-rad | Motor-rad | PKW | LKW
Nur Führerschein Klasse A und B vorhanden | J | J | J | N
Witterungsunabhängig | N | N | J | J
Lösung verwendbar | N | N | J | N

## Einfache Punktbewertung

Anforderung | Fahr-rad | Motor-rad | PKW | LKW
Geringe Kosten | 6 | 4 | 2 | 1
Hohe Geschwindigkeit | 1 | 6 | 5 | 3
Hoher Komfort | 2 | 4 | 6 | 4
Hohe Nutzlast | 1 | 2 | 4 | 6
Summe | 10 | 16 | 17 | 14
Relativ [%] | | 58 | 94 | 100 | 82

1 = Anforderung nicht erfüllt … 6 = Anforderung sehr gut erfüllt

## Gewichtete Punktbewertung

Anforderung | Gew. G | Fahr-rad | Motor-rad | PKW | LKW
E | E·G | E | E·G | E | E·G | E | E·G
Geringe Kosten | 3 | 6 | 18 | 4 | 12 | 2 | 6 | 1 | 3
Hohe Geschwindigkeit | 5 | 1 | 5 | 6 | 30 | 5 | 25 | 3 | 15
Hoher Komfort | 4 | 2 | 8 | 4 | 16 | 6 | 24 | 4 | 16
Hohe Nutzlast | 1 | 1 | 1 | 2 | 2 | 4 | 4 | 6 | 6
Summe | | | 32 | | 60 | | 59 | | 40
Relativ [%] | | | 53 | | 100 | | 98 | | 67

E: 1 = Anforderung nicht erfüllt … 6 = Anforderung sehr gut erfüllt
