Freezepok/CAD-Paspa/Paspa/Vorlesung/KmC-06.pdf

## Konstruieren mit CAD

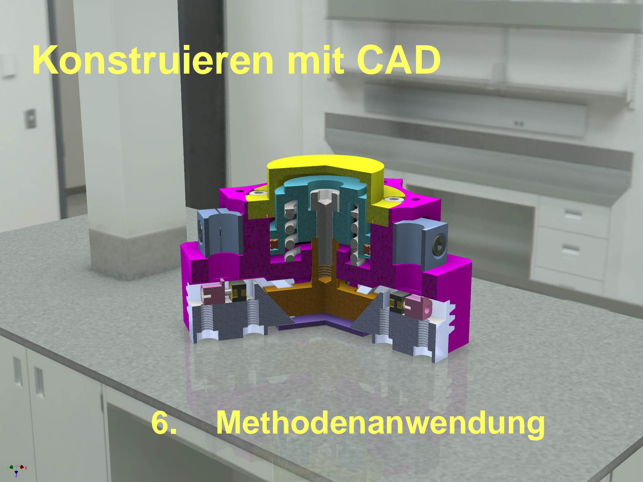
[picture p62: page 1]

## 6. Methodenanwendung

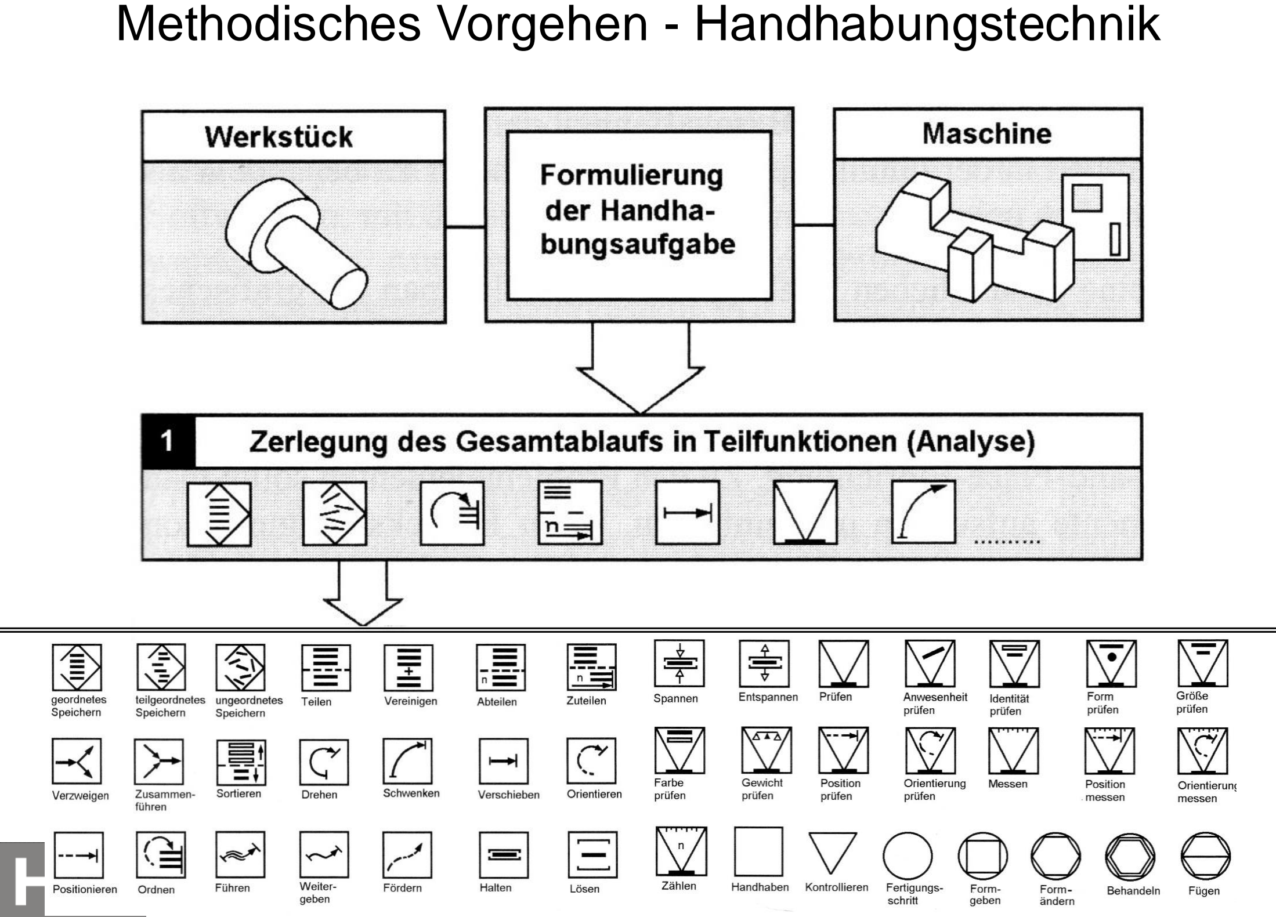
[picture p63: page 2]

Methodisches Vorgehen - Handhabungstechnik

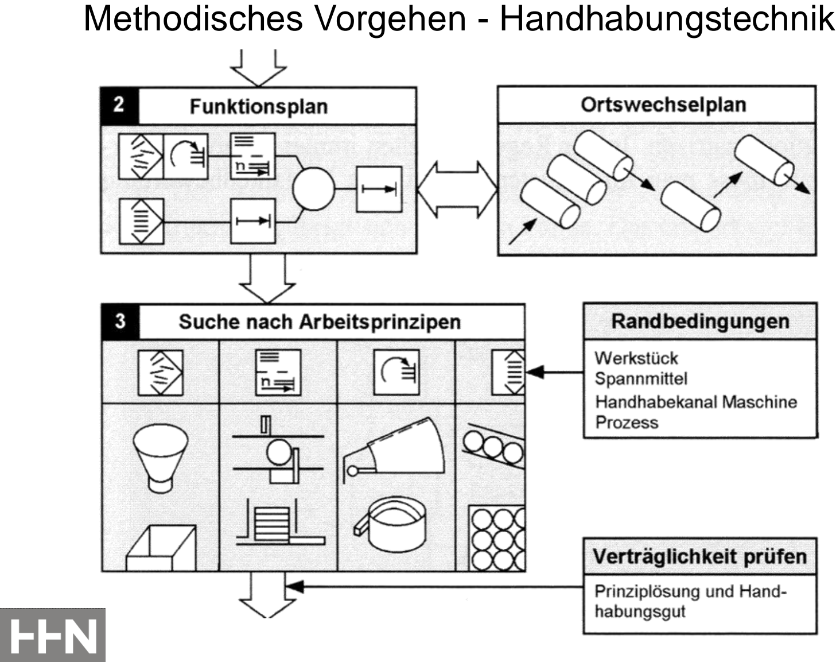
[picture p64: page 3]

Methodisches Vorgehen - Handhabungstechnik

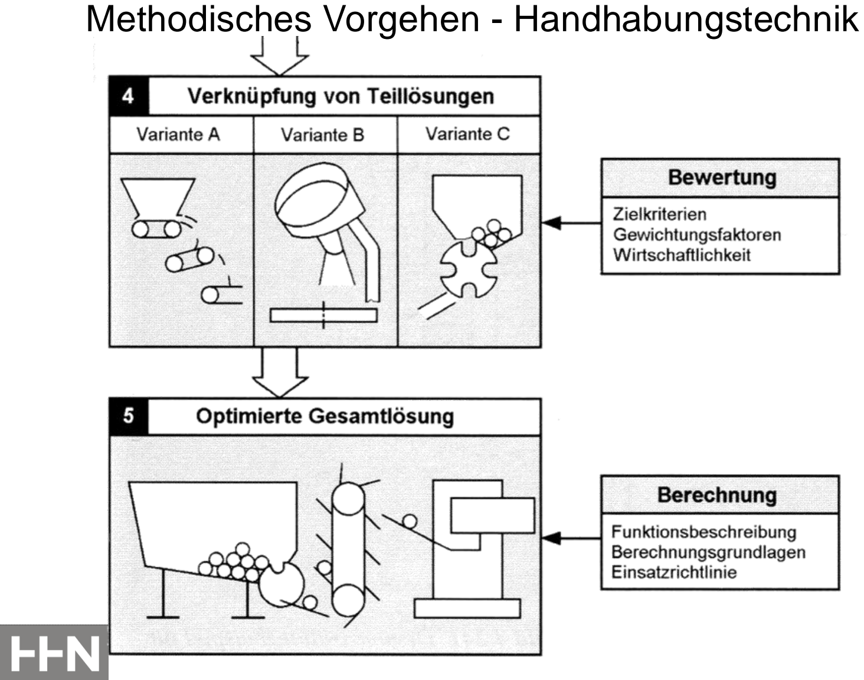
[picture p65: page 4]

Methodisches Vorgehen - Handhabungstechnik

Symbole für Handhabungsoperationen

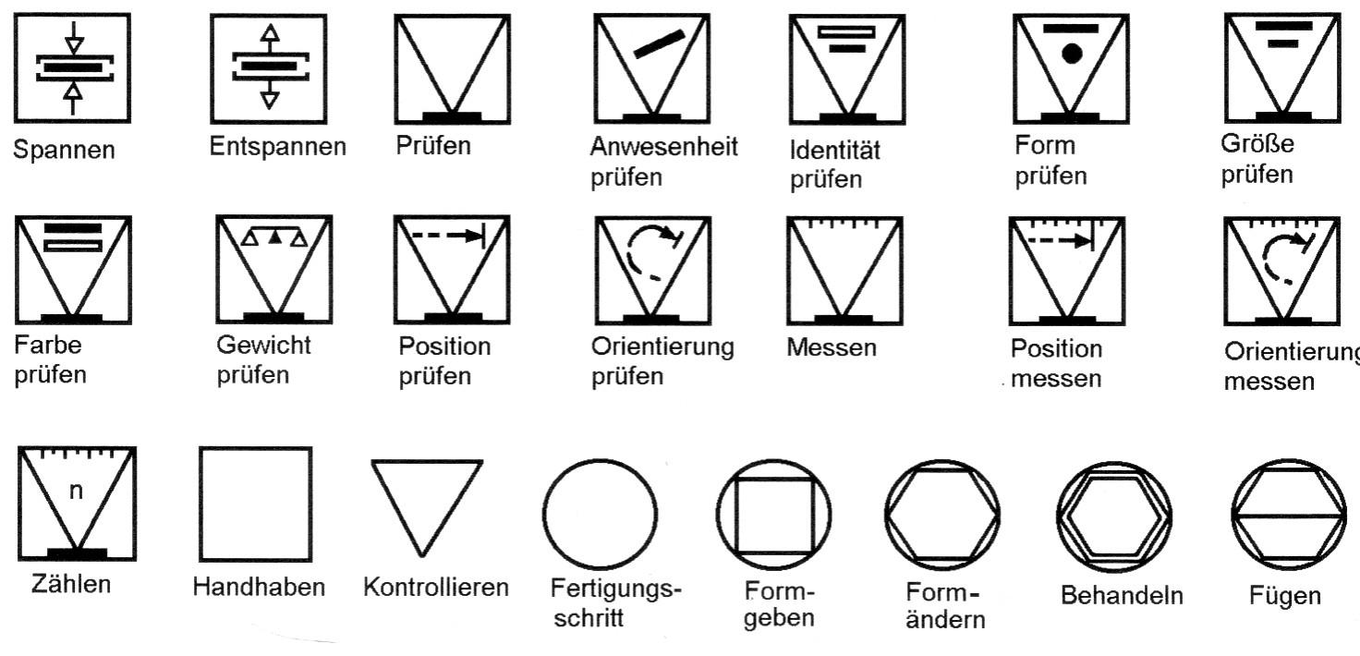
[picture p66: figure]

Symbole für Handhabungsoperationen

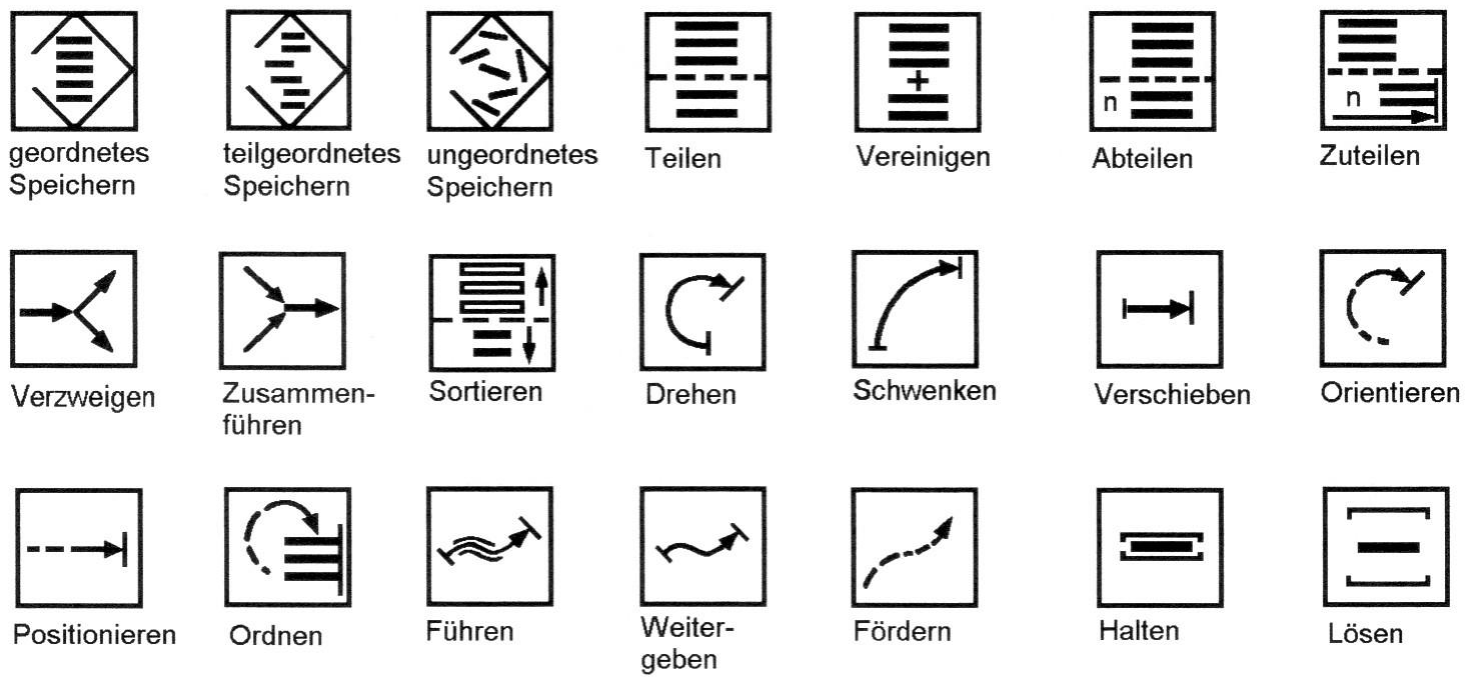
[picture p67: figure]

Morphologischer Kasten (Beispiel)

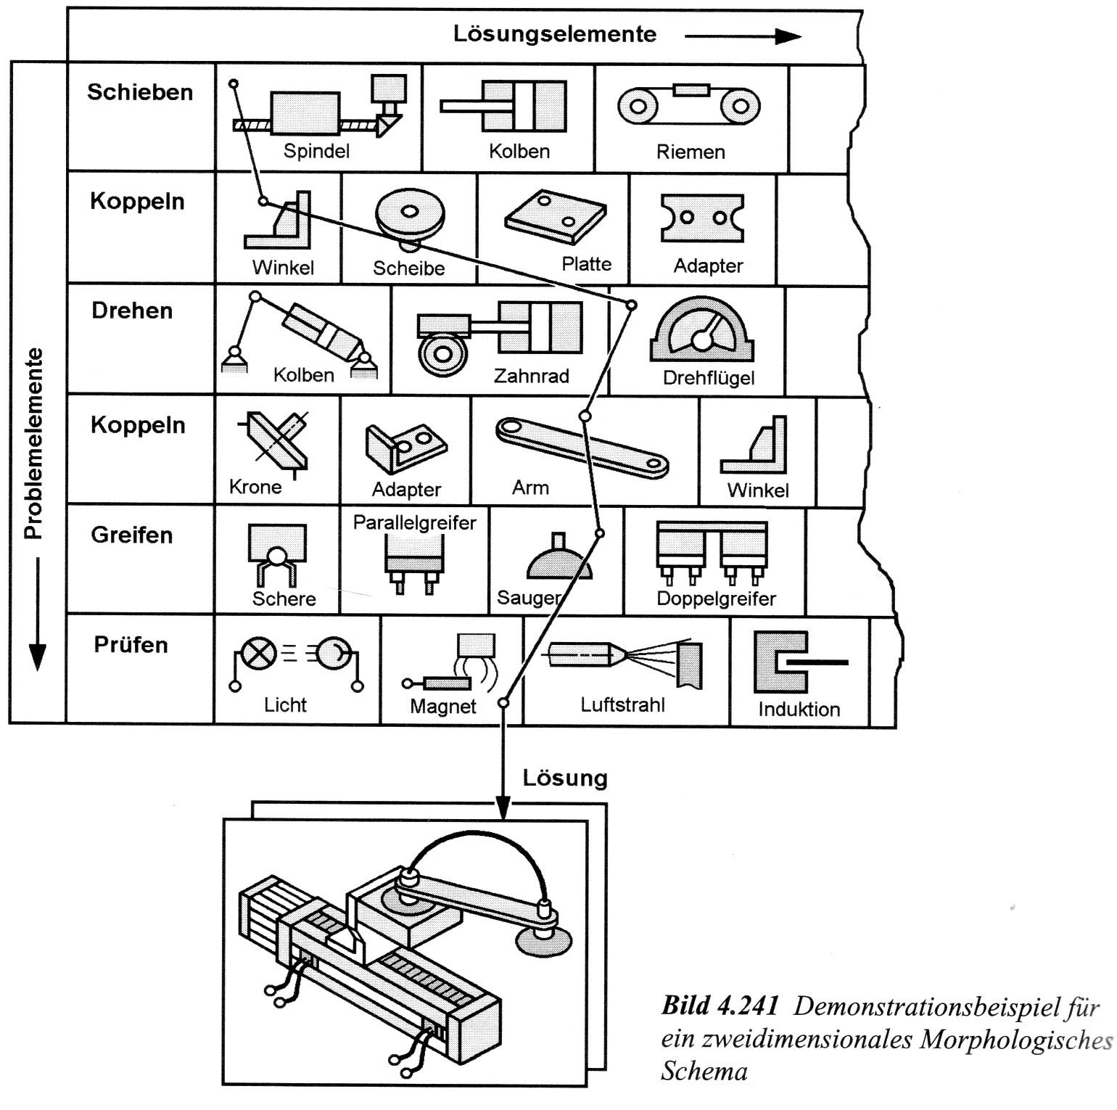
[picture p68: figure]
