Freezepok/CAD-Paspa/Useless Box/Zeichnungen FINAL/Handskizze_Ideen.pdf

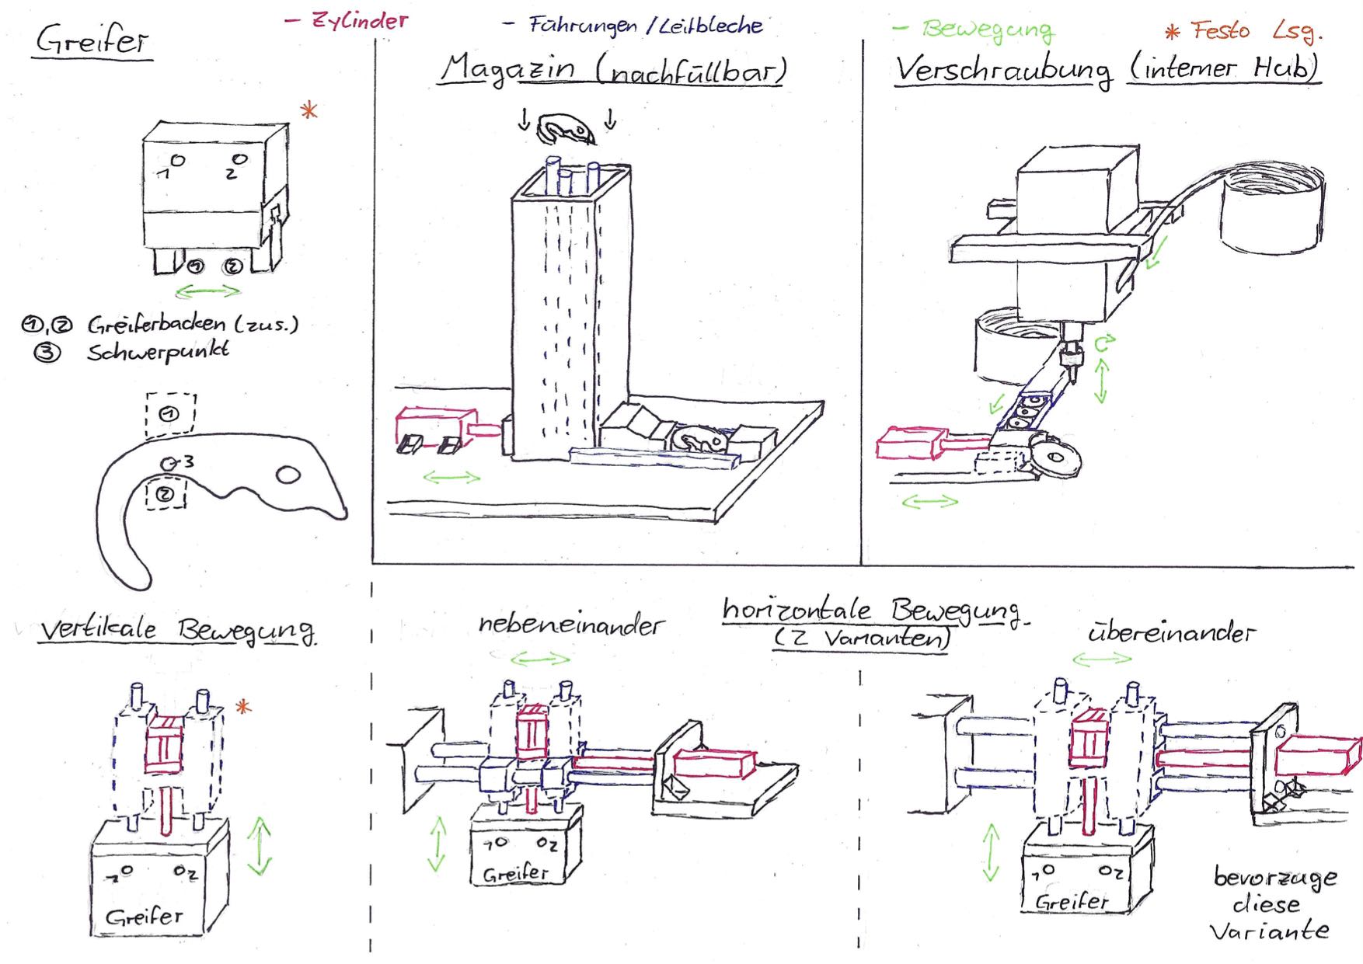
[picture p69: page 1]
