Freezepok/CAD-Paspa/Useless Box/_Useless_Box/Motor_Ausgangswelle schief.png

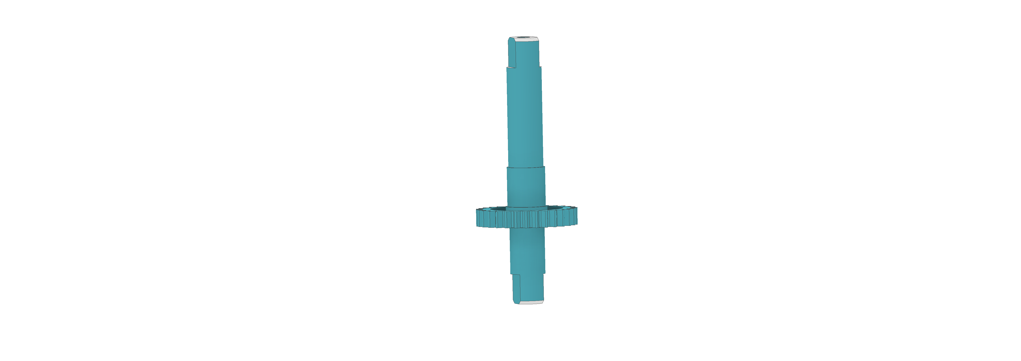
Useless Box/_Useless_Box/Motor_Ausgangswelle schief.png
