Freezepok/CAD-Paspa/Useless Box/Dokumentation/Bilder/HHN BW.jpg

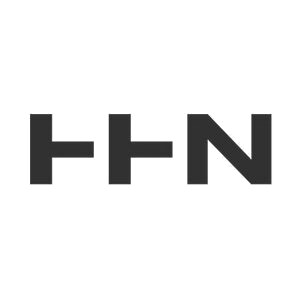
Useless Box/Dokumentation/Bilder/HHN BW.jpg
