Freezepok/CAD-Paspa/Useless Box/Dokumentation/Bilder/Projekt_Useless_Box Detailansicht.png

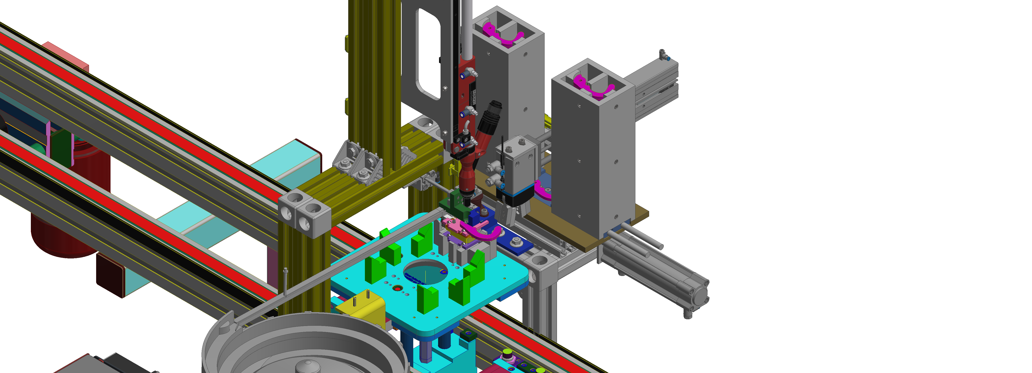
Useless Box/Dokumentation/Bilder/Projekt_Useless_Box Detailansicht.png
