Freezepok/CAD-Paspa/Useless Box/Dokumentation/Bilder/Projekt_Useless_Box Drahtmodell.png

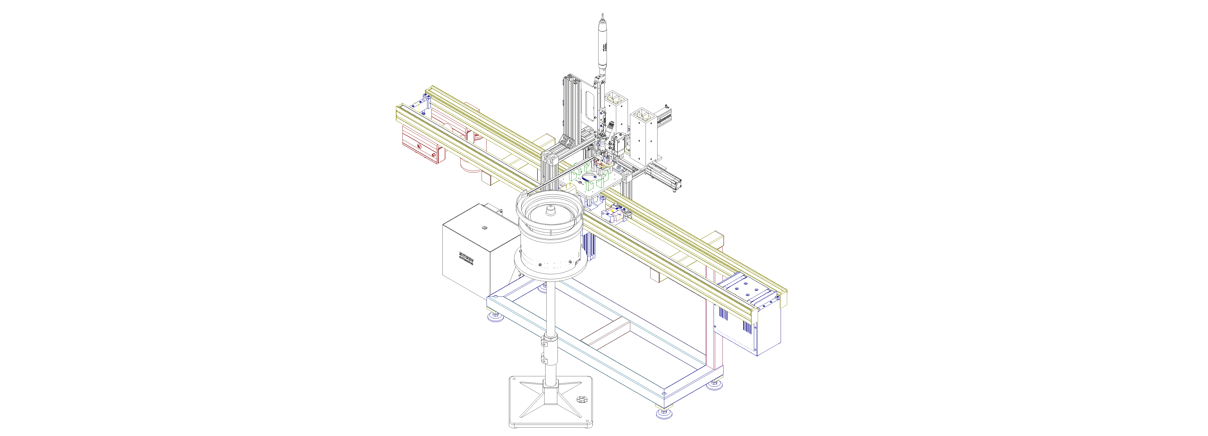
Useless Box/Dokumentation/Bilder/Projekt_Useless_Box Drahtmodell.png
