Freezepok/CAD-Paspa/Useless Box/Dokumentation/Dokumentation JH/Screenshots/Deckblatt.png

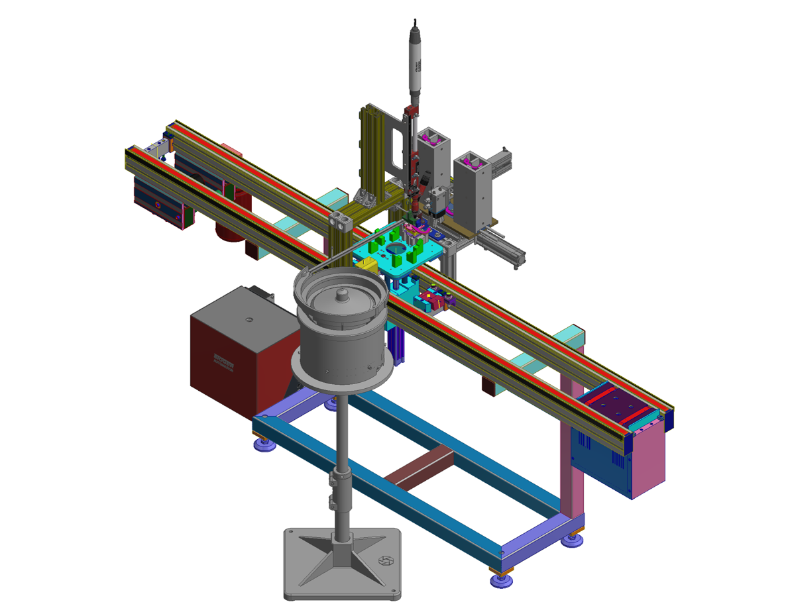
Useless Box/Dokumentation/Dokumentation JH/Screenshots/Deckblatt.png
