Freezepok/CAD-Paspa/Useless Box/Praesentation/Bilder/Greifer_1.png

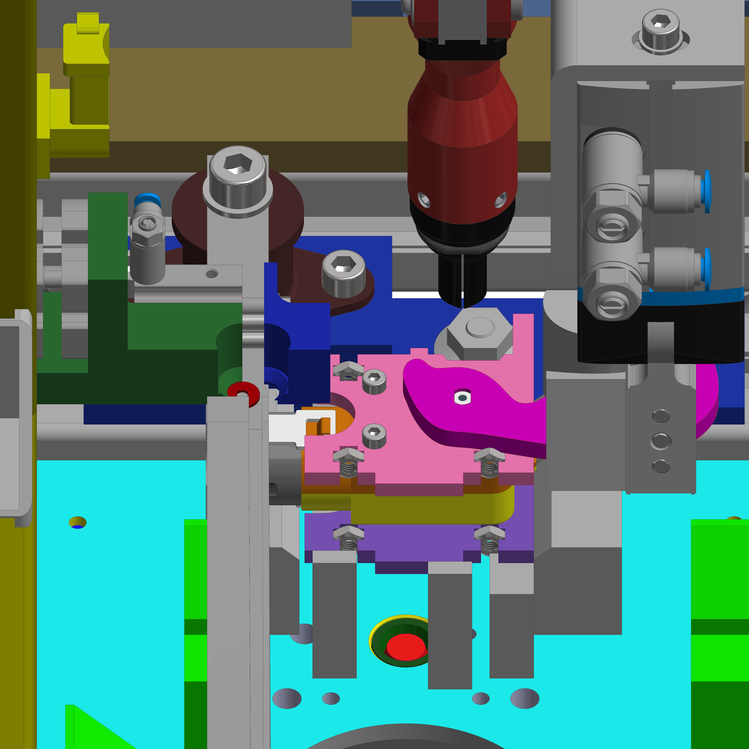
Useless Box/Praesentation/Bilder/Greifer_1.png
