Freezepok/CAD-Paspa/Useless Box/Praesentation/Bilder/Greifer_3.png

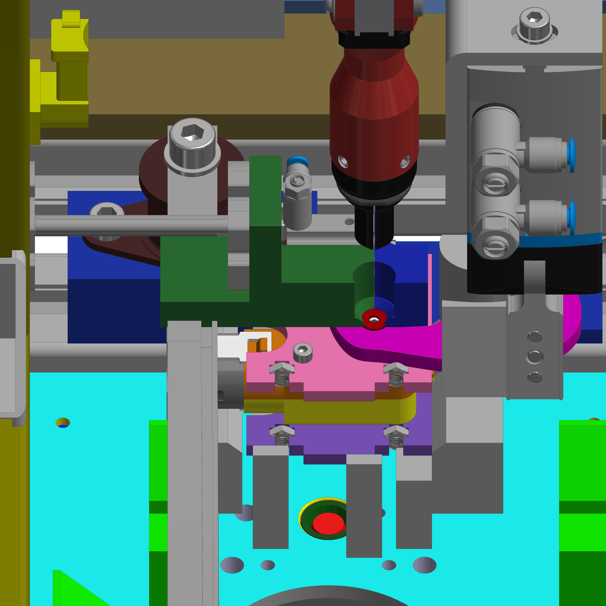
Useless Box/Praesentation/Bilder/Greifer_3.png
