Freezepok/CAD-Paspa/Useless Box/Praesentation/Bilder/Greifer_4.png

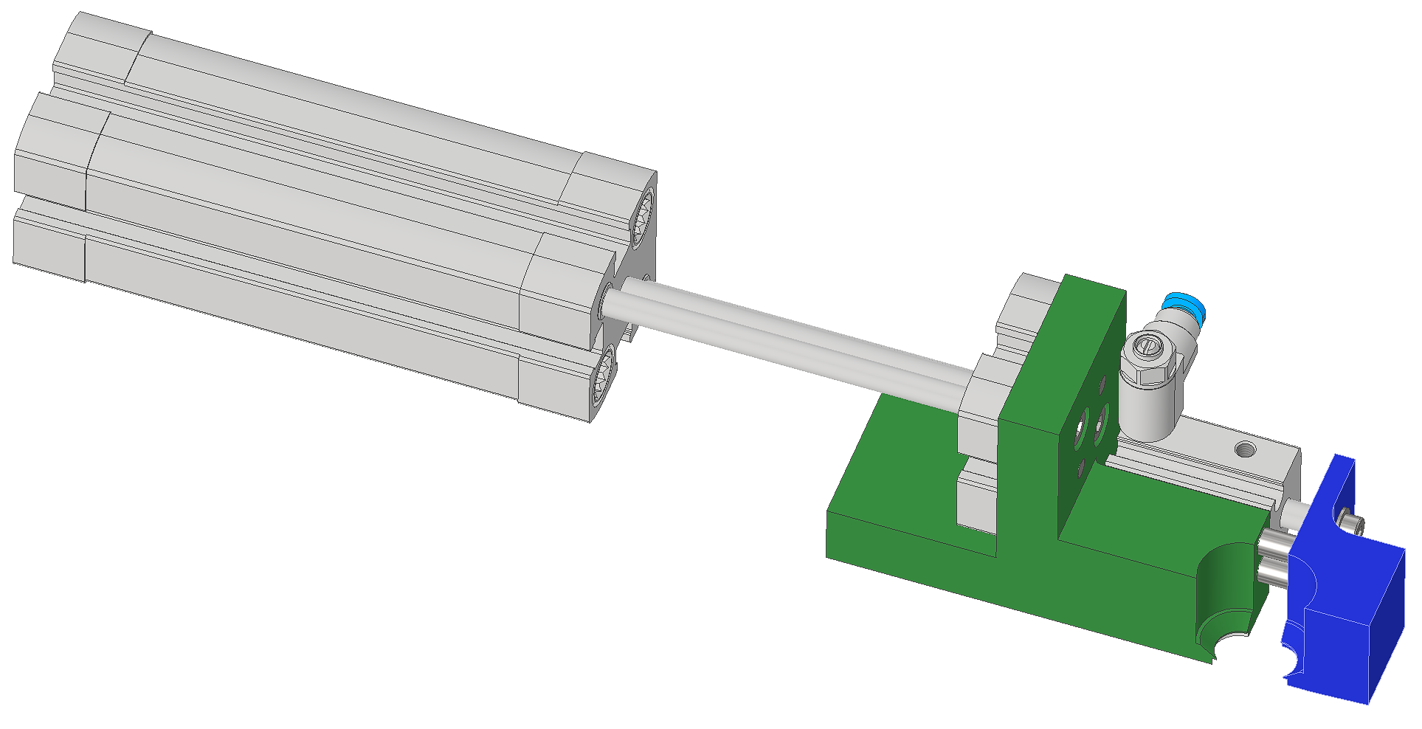
Useless Box/Praesentation/Bilder/Greifer_4.png
