Freezepok/CAD-Paspa/Useless Box/Praesentation/Bilder/Greifer_5.png

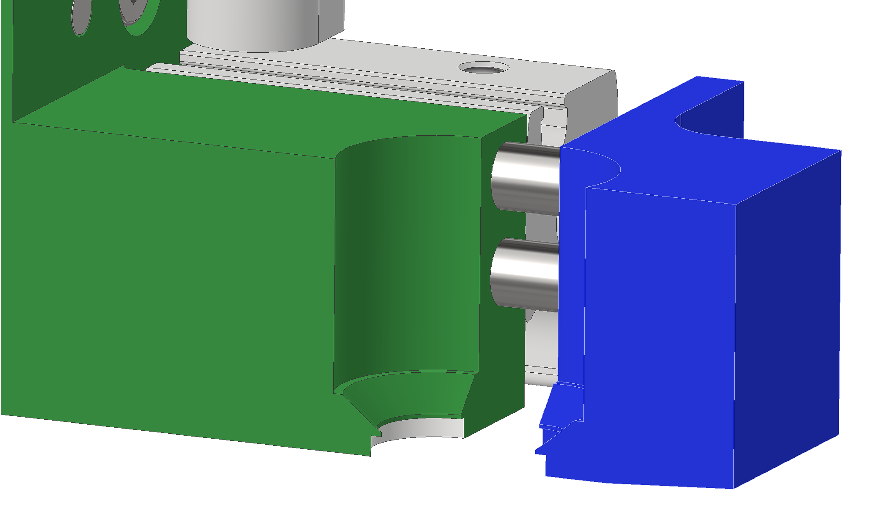
Useless Box/Praesentation/Bilder/Greifer_5.png
