Freezepok/CAD-Paspa/Useless Box/Praesentation/Bilder/Greifer_6.png

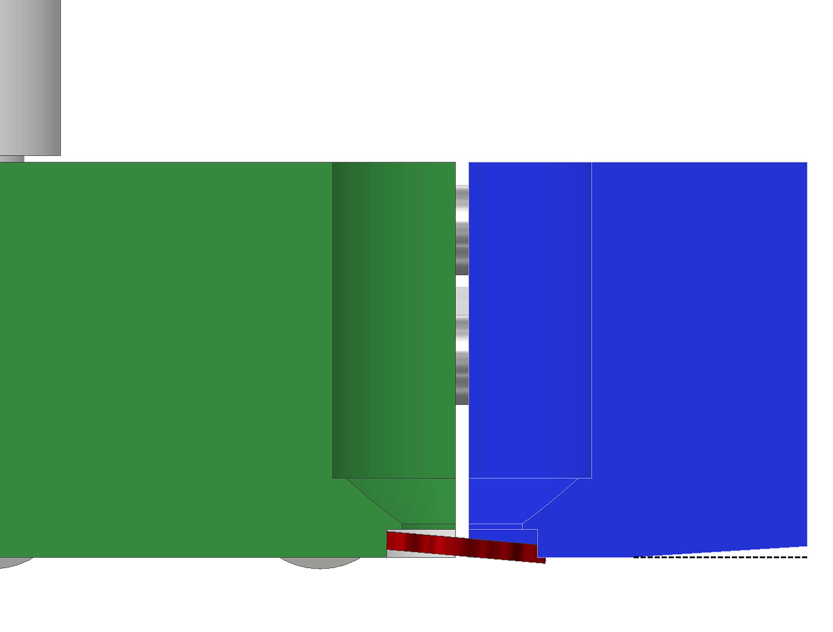
Useless Box/Praesentation/Bilder/Greifer_6.png
