Freezepok/CAD-Paspa/Useless Box/Praesentation/Bilder/Greifer_7.png

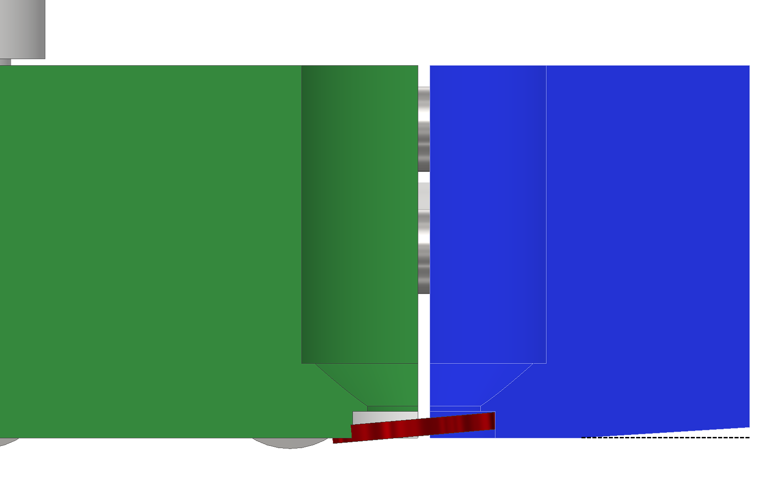
Useless Box/Praesentation/Bilder/Greifer_7.png
