Freezepok/CAD-Paspa/Useless Box/Praesentation/Bilder/Greifer_8.png

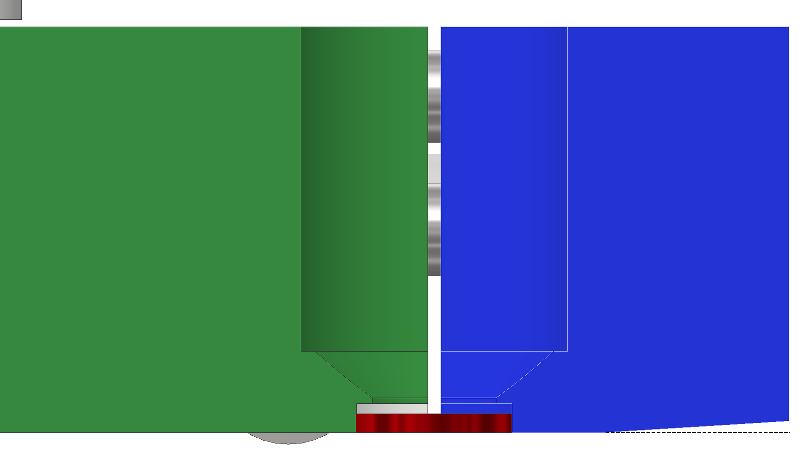
Useless Box/Praesentation/Bilder/Greifer_8.png
