Freezepok/CAD-Paspa/Useless Box/Praesentation/Bilder/Greifer_9.png

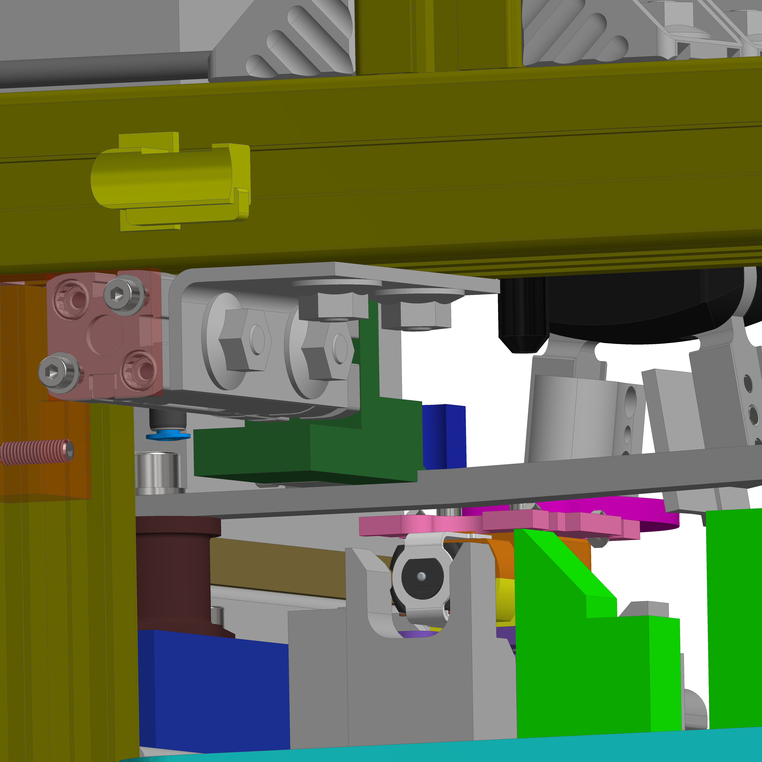
Useless Box/Praesentation/Bilder/Greifer_9.png
