Freezepok/CAD-Paspa/Useless Box/Praesentation/Bilder/Greifer_10.png

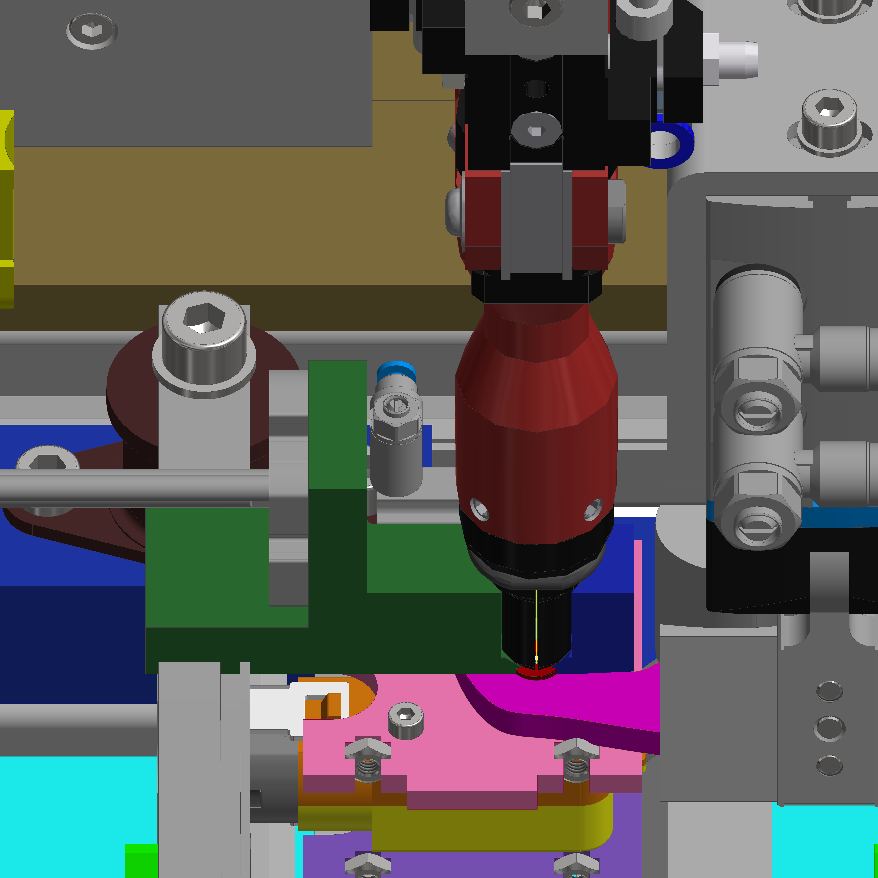
Useless Box/Praesentation/Bilder/Greifer_10.png
