Freezepok/CAD-Paspa/Useless Box/Praesentation/Bilder/Halterung.png

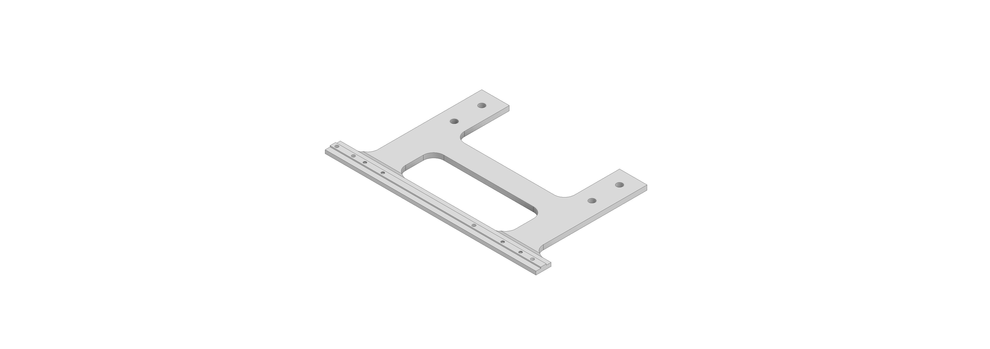
Useless Box/Praesentation/Bilder/Halterung.png
