Freezepok/CAD-Paspa/Useless Box/Praesentation/Bilder/Hubeinheit.png

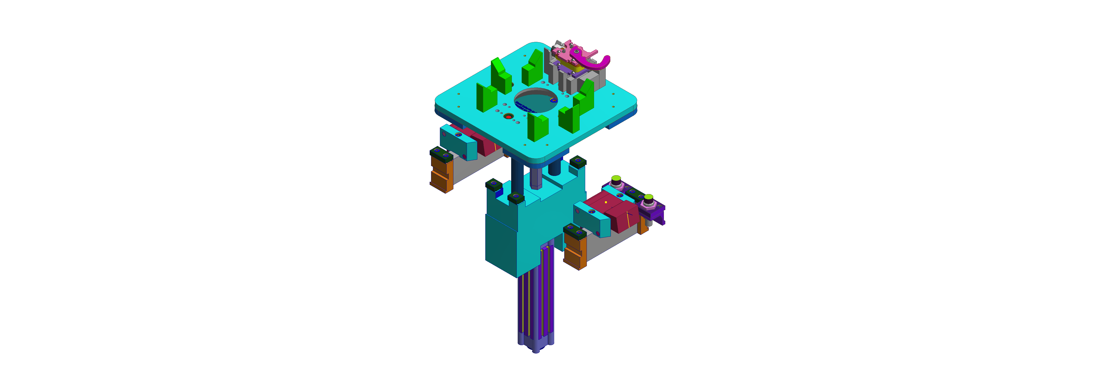
Useless Box/Praesentation/Bilder/Hubeinheit.png
