Freezepok/CAD-Paspa/Useless Box/Praesentation/Bilder/JH_Greifer_Scheibe_final lang.png

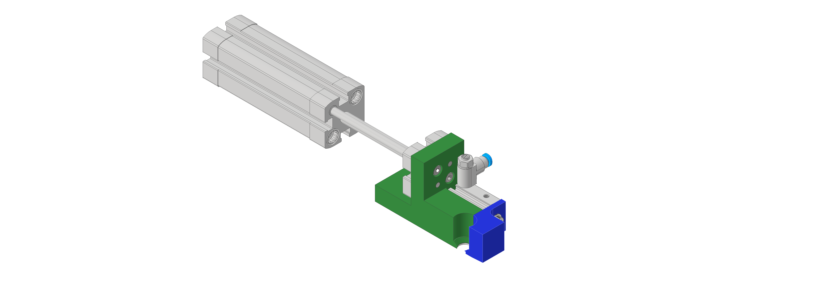
Useless Box/Praesentation/Bilder/JH_Greifer_Scheibe_final lang.png
