Freezepok/CAD-Paspa/Useless Box/Praesentation/Bilder/Kantensensor 2.png

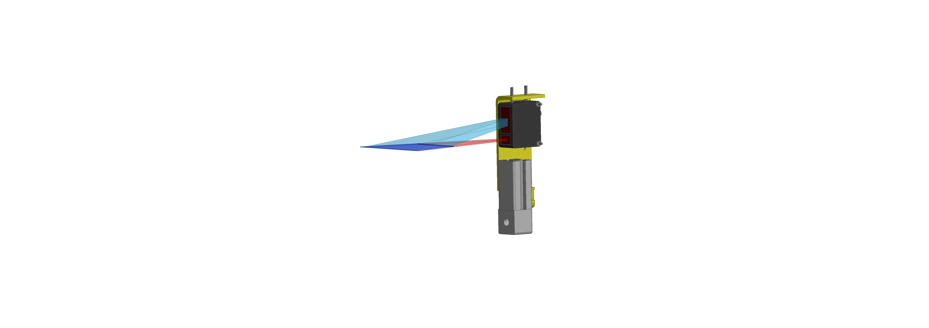
Useless Box/Praesentation/Bilder/Kantensensor 2.png
