Freezepok/CAD-Paspa/Useless Box/Praesentation/Bilder/Kantensensor mit Welle nahe.png

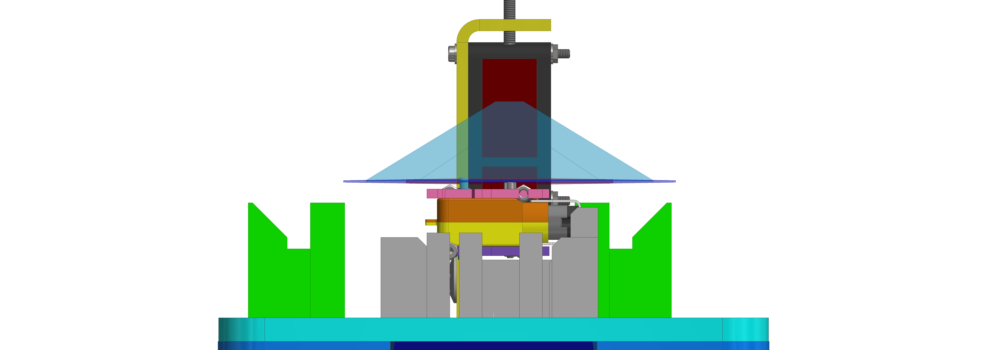
Useless Box/Praesentation/Bilder/Kantensensor mit Welle nahe.png
