Freezepok/CAD-Paspa/Useless Box/Praesentation/Bilder/Kantensensor mit Welle.png

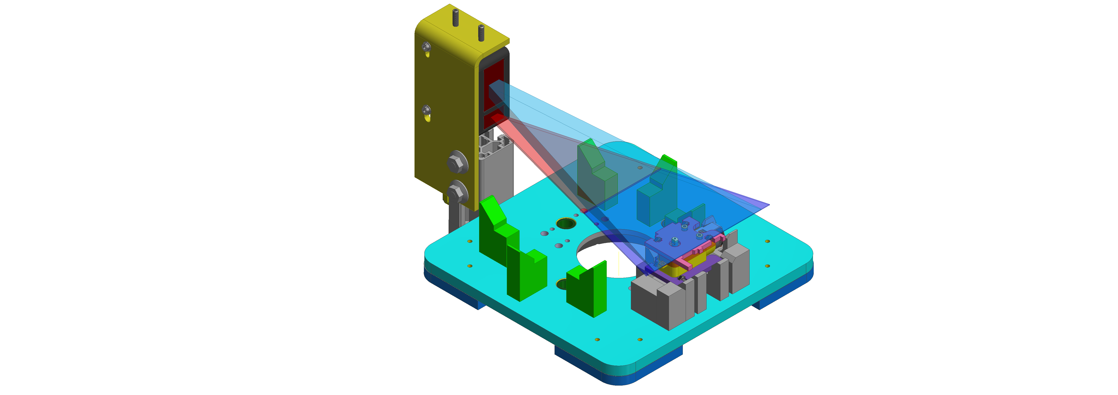
Useless Box/Praesentation/Bilder/Kantensensor mit Welle.png
