Freezepok/CAD-Paspa/Useless Box/Praesentation/Bilder/Kantensensor.png

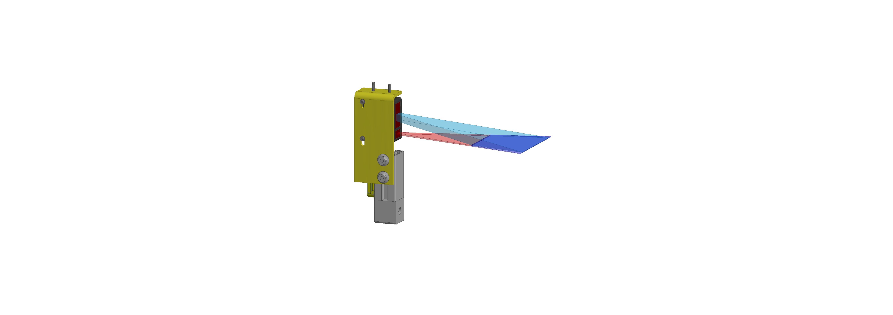
Useless Box/Praesentation/Bilder/Kantensensor.png
