Freezepok/CAD-Paspa/Useless Box/Praesentation/Bilder/TS_V1_Fallmagazin_gesamt.png

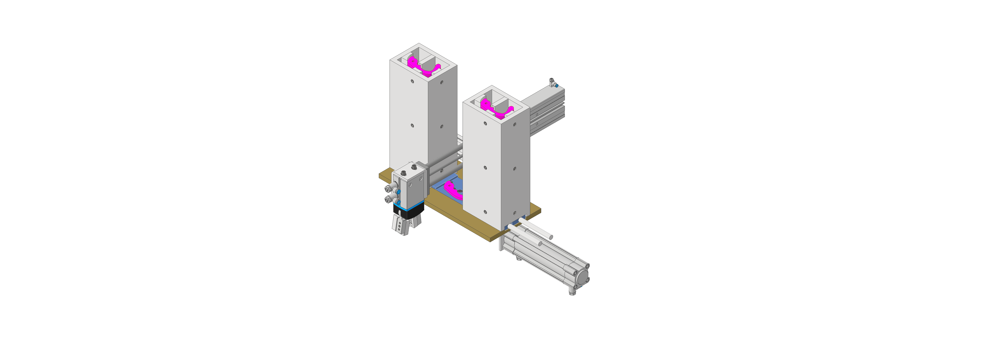
Useless Box/Praesentation/Bilder/TS_V1_Fallmagazin_gesamt.png
