Freezepok/CAD-Paspa/Useless Box/Praesentation/Bilder/Verschraubungseinheit toleranz.png

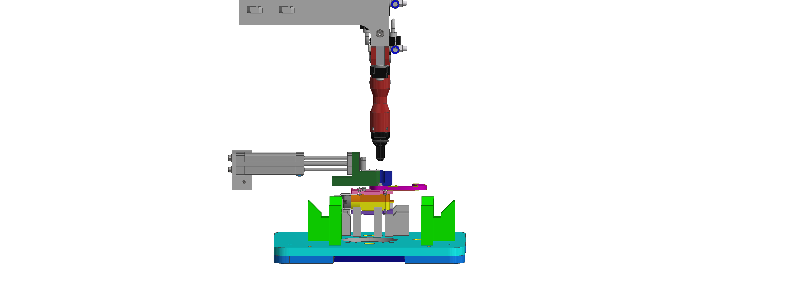
Useless Box/Praesentation/Bilder/Verschraubungseinheit toleranz.png
