Freezepok/CAD-Paspa/Schillo/CAD_Test/Eingangs- und Abschlusstest/Zusammenbau Feder Topf.stp

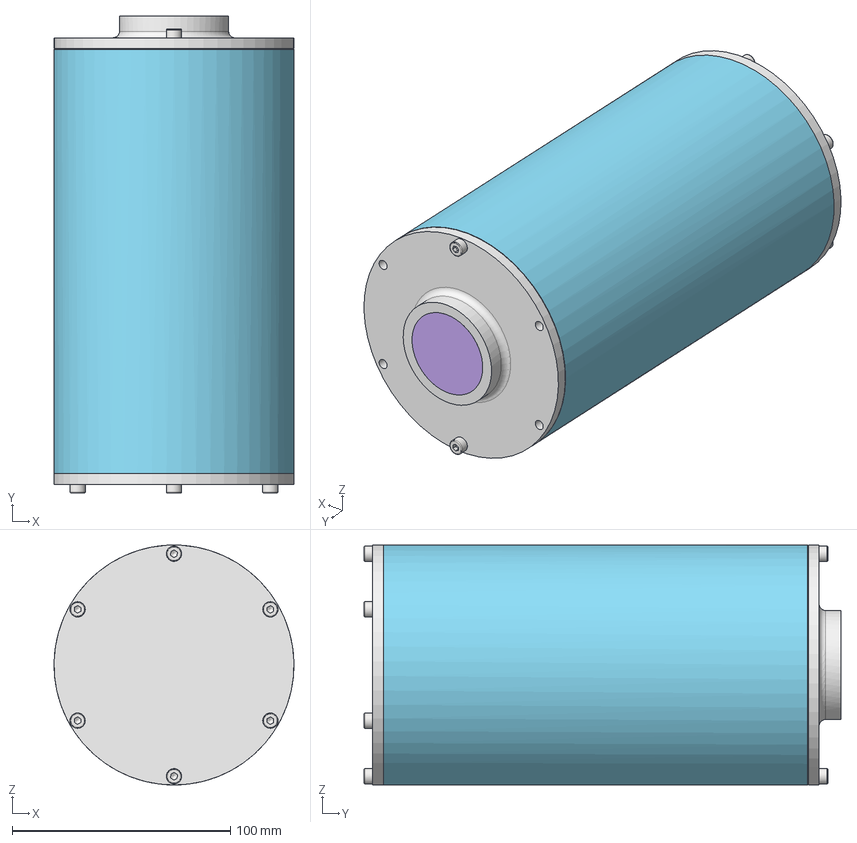
[picture p93: CAD file, 2025-06-01]
Schillo/CAD_Test/Eingangs- und Abschlusstest/Zusammenbau Feder Topf.stp
110.0 x 218.6 x 110.0 mm
Deckel Stempel
Stempel
Gehäuse
ISO 4762 - M4 x 10 x 8
Deckel Stempel 2
Compress Spring1
Topf
Compress Spring1_1
