Freezepok/CAD-Paspa/Useless Box/Dokumentation/Bilder/path1.dxf

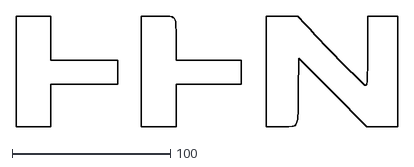
[picture p94: CAD file, 2025-06-25]
Useless Box/Dokumentation/Bilder/path1.dxf
241.0 x 70.0
