Freezepok/CAD-Paspa/Useless Box/Kaufteile/Rexroth_40x40_Profil+Wuerfel/Rexroth_40x40_Wuerfel.stp

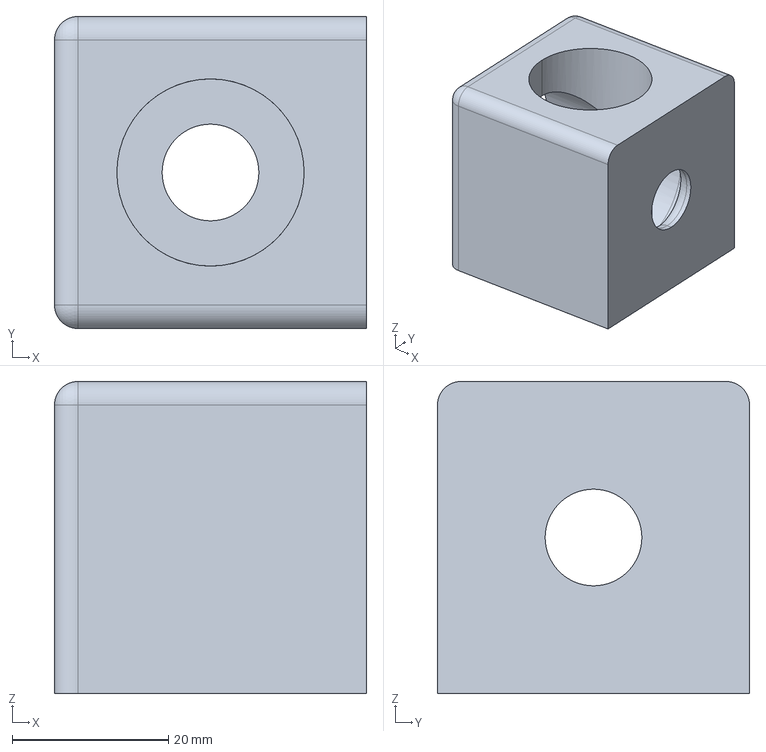
[picture p95: CAD file, 2025-06-19]
Useless Box/Kaufteile/Rexroth_40x40_Profil+Wuerfel/Rexroth_40x40_Wuerfel.stp
40.0 x 40.0 x 40.0 mm
