Freezepok/CAD-Paspa/Useless Box/Kaufteile/Rexroth_Hammermuttern/Rexroth_Hammermutter_8_M6.stp

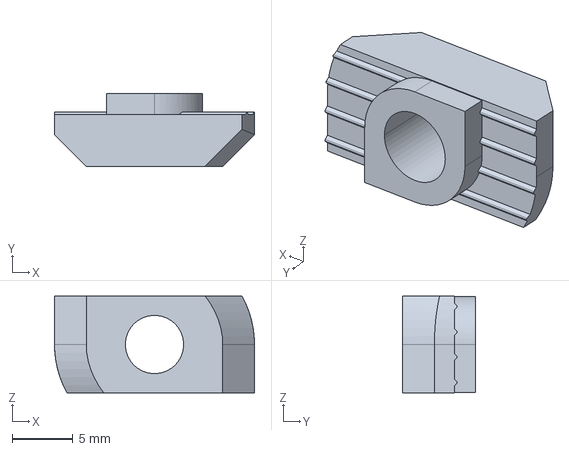
[picture p96: CAD file, 2025-06-19]
Useless Box/Kaufteile/Rexroth_Hammermuttern/Rexroth_Hammermutter_8_M6.stp
16.5 x 6.00 x 8.00 mm
