Freezepok/CAD-Paspa/Useless Box/Kaufteile/Rexroth_Profil+Winkel_30x30/Rexroth_30x30_Winkel_ext.stp

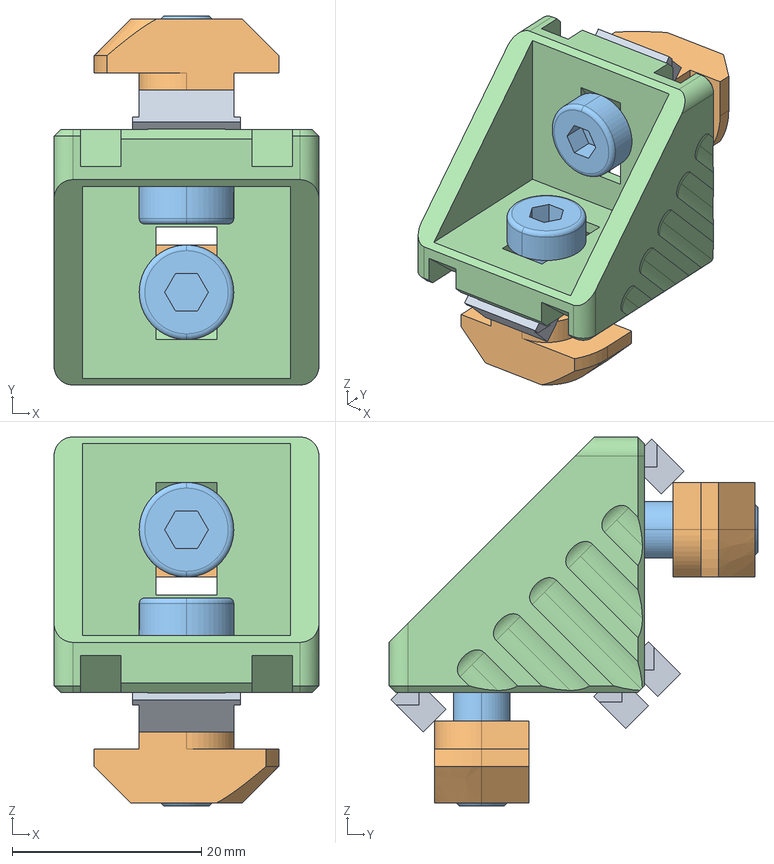
[picture p97: CAD file, 2025-06-19]
Useless Box/Kaufteile/Rexroth_Profil+Winkel_30x30/Rexroth_30x30_Winkel_ext.stp
28.0 x 39.0 x 39.0 mm
