Freezepok/CAD-Paspa/Useless Box/Kaufteile/Rexroth_Profil_40x40_142/Rexroth_Profil_40x40_142.stp

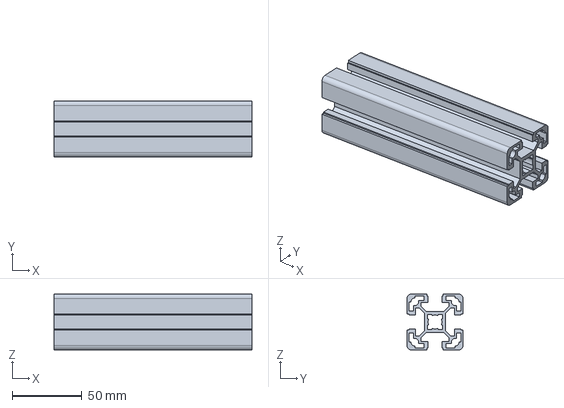
[picture p98: CAD file, 2025-06-19]
Useless Box/Kaufteile/Rexroth_Profil_40x40_142/Rexroth_Profil_40x40_142.stp
142.0 x 40.0 x 40.0 mm
