Freezepok/CAD-Paspa/Useless Box/Kaufteile/Rexroth_Profil_40x40_168mm/Rexroth_Profil_40x40_168mm.stp

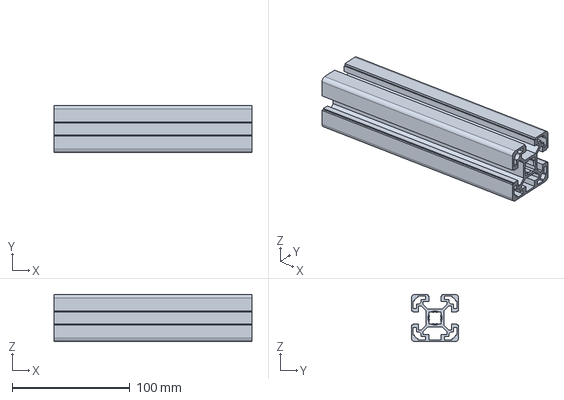
[picture p99: CAD file, 2025-05-27]
Useless Box/Kaufteile/Rexroth_Profil_40x40_168mm/Rexroth_Profil_40x40_168mm.stp
168.0 x 40.0 x 40.0 mm
