Freezepok/CAD-Paspa/Useless Box/Kaufteile/Rexroth_Profil_40x40_60mm/Rexroth_Profil_40x40_60mm.stp

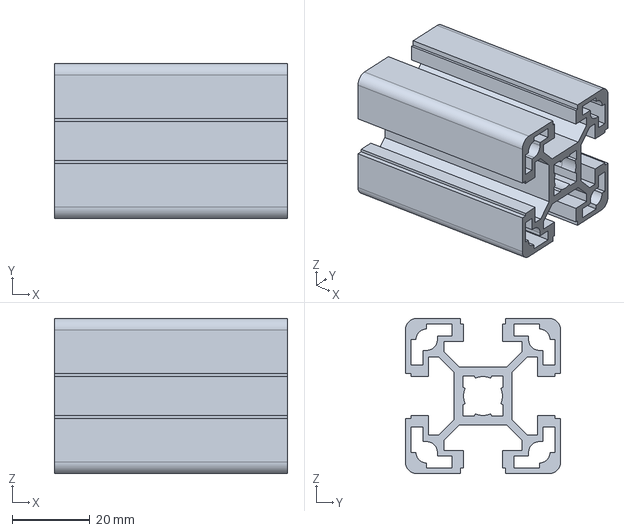
[picture p100: CAD file, 2025-05-27]
Useless Box/Kaufteile/Rexroth_Profil_40x40_60mm/Rexroth_Profil_40x40_60mm.stp
60.0 x 40.0 x 40.0 mm
