Freezepok/CAD-Paspa/Useless Box/Kaufteile/Rexroth_Profil_40x80_227mm/Rexroth_Profil_40x80_227mm.stp

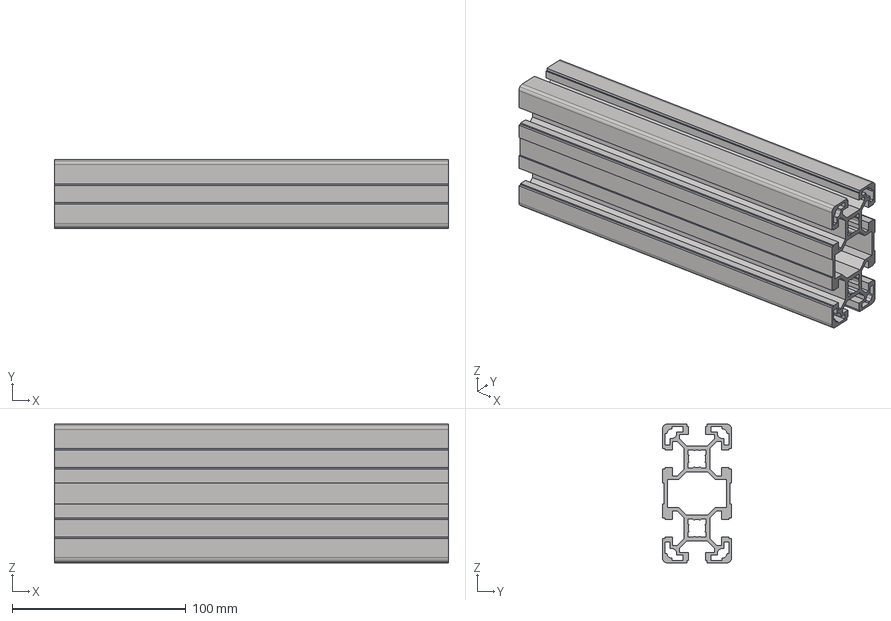
[picture p101: CAD file, 2025-06-17]
Useless Box/Kaufteile/Rexroth_Profil_40x80_227mm/Rexroth_Profil_40x80_227mm.stp
227.0 x 40.0 x 80.0 mm
