Freezepok/CAD-Paspa/Useless Box/Kaufteile/Rexroth_Winkel_100x50/Winkel_Rexroth_3D_203.stp

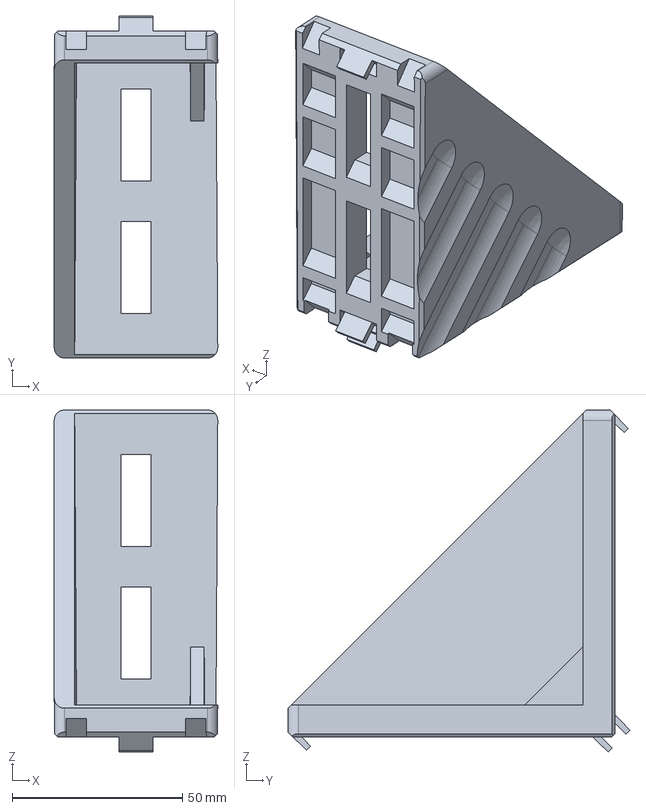
[picture p102: CAD file, 2025-06-17]
Useless Box/Kaufteile/Rexroth_Winkel_100x50/Winkel_Rexroth_3D_203.stp
48.0 x 100.3 x 100.3 mm
