Freezepok/CAD-Paspa/Useless Box/Kaufteile/T-Verbinder 40x40 Rexroth/T_Verbinder_40x40_3D_203.stp

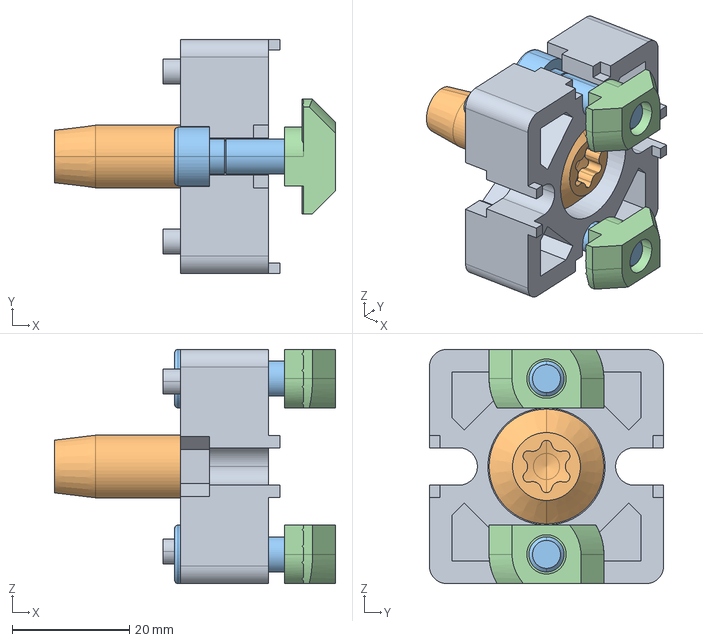
[picture p103: CAD file, 2025-06-17]
Useless Box/Kaufteile/T-Verbinder 40x40 Rexroth/T_Verbinder_40x40_3D_203.stp
48.0 x 40.0 x 40.0 mm
