Freezepok/CAD-Paspa/Useless Box/Kaufteile/WUERTH_federndes_Druckstueck/Wuerth_5099201004_Federndes_Druckstueck,_Kugel,_Edelstahl_LOD_High.stp

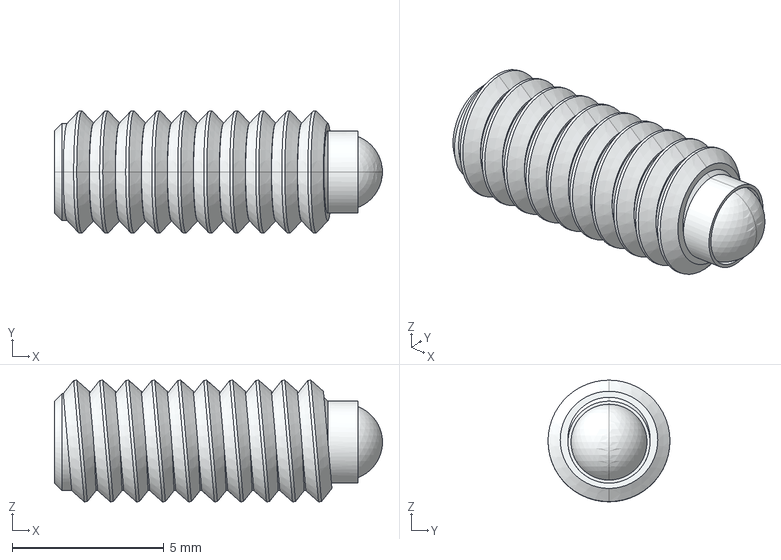
[picture p104: CAD file, 2025-06-13]
Useless Box/Kaufteile/WUERTH_federndes_Druckstueck/Wuerth_5099201004_Federndes_Druckstueck,_Kugel,_Edelstahl_LOD_High.stp
10.8 x 4.02 x 4.01 mm
