Freezepok/CAD-Paspa/Useless Box/Dokumentation/Bilder/HHN.dxf

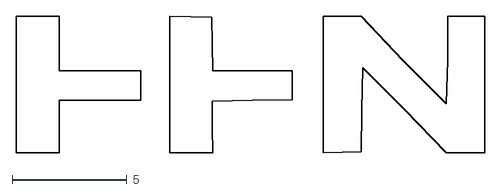
[picture p105: CAD file, 2025-06-25]
Useless Box/Dokumentation/Bilder/HHN.dxf
20.4 x 5.94
