Freezepok/CAD-Paspa/Useless Box/Kaufteile/Rexroth_Profil+Winkel_30x30/Rexroth_30x30_160_ext.stp

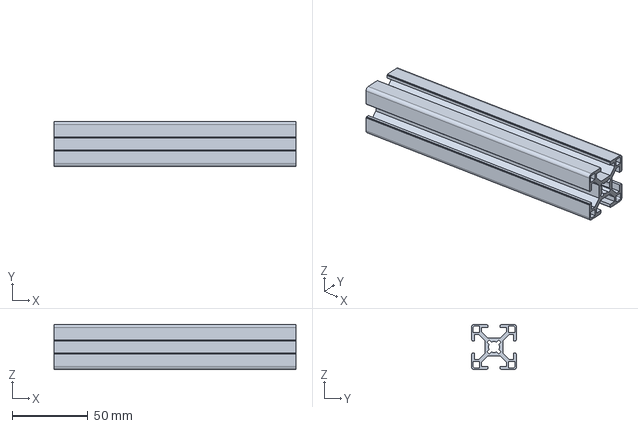
[picture p106: CAD file, 2025-06-19]
Useless Box/Kaufteile/Rexroth_Profil+Winkel_30x30/Rexroth_30x30_160_ext.stp
160.0 x 30.0 x 30.0 mm
