Freezepok/CAD-Paspa/Useless Box/Kaufteile/Rexroth_Profil+Winkel_30x30/Rexroth_30x30_Wuerfel.stp

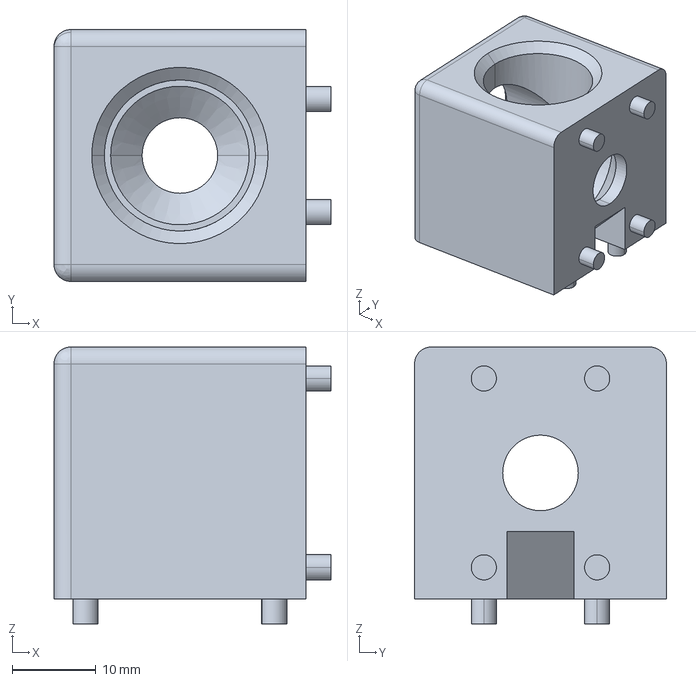
[picture p107: CAD file, 2025-06-19]
Useless Box/Kaufteile/Rexroth_Profil+Winkel_30x30/Rexroth_30x30_Wuerfel.stp
33.0 x 30.0 x 33.0 mm
