Freezepok/CAD-Paspa/(list of files, cad)

Other CAD files:
Schillo/CAD_Test/Zusammenbau Feder Topf_Tino_Stoehr_220758.dwg
Useless Box/Templates/Norm.dwg
Useless Box/Zeichnung ER/__Projekt_Useless_Box.dwg
Useless Box/Zeichnung_ER/Halter_Verschraubung.dwg
Useless Box/Zeichnung_JH/Montagezeichnung Greifer.dwg
Useless Box/Zeichnung_TS/Formnest_Fallmagazin.dwg
Schillo/CAD_Test/Schwalbenschwanzhalterung_Tino_Stoehr_220758.dwg
Useless Box/Zeichnung ER/ER_Montagezeichnung_Fallmagazin.dwg
Useless Box/Zeichnung_JH/Montagezeichnung Kantensensor.dwg
Schillo/CAD_Test/Feder_Topf_Tino_Stoehr_220758_Version2.dwg
Useless Box/Zeichnung_JH/Montagezeichnung Vibrationsämpfereinheit.dwg
Useless Box/Zeichnung_JH/Greiferbacke.dwg
Schillo/CAD_Test/Bauteil1.ipt
Schillo/CAD_Test/Eingangs- und Abschlusstest/Compress Spring11.ipt
Schillo/CAD_Test/Eingangs- und Abschlusstest/Compress Spring12.ipt
Schillo/CAD_Test/Eingangs- und Abschlusstest/Deckel Federnzusammenbau.iam
Schillo/CAD_Test/Eingangs- und Abschlusstest/Deckel Stempel 2.ipt
Schillo/CAD_Test/Eingangs- und Abschlusstest/Deckel Stempel.ipt
Schillo/CAD_Test/Eingangs- und Abschlusstest/Gehaeuse.ipt
Schillo/CAD_Test/Eingangs- und Abschlusstest/OldVersions/Gehaeuse.0012.ipt
Schillo/CAD_Test/Eingangs- und Abschlusstest/OldVersions/Zusammenbau Feder Topf.0006.iam
Schillo/CAD_Test/Eingangs- und Abschlusstest/Schwalbenschwanzhalterung.ipt
Schillo/CAD_Test/Eingangs- und Abschlusstest/Stempel.ipt
Schillo/CAD_Test/Eingangs- und Abschlusstest/Topf.ipt
Schillo/CAD_Test/Eingangs- und Abschlusstest/Zusammenbau Feder Topf.iam
Schillo/CAD_Test/OldVersions/Bauteil1.0001.ipt
Schillo/CAD_Test/OldVersions/Rohrleitung_Tino_Stoehr_220758.0001.ipt
Schillo/CAD_Test/OldVersions/Schwalbenschwanzhalterung_Tino_Stoehr_220758.0004.dwg
Schillo/CAD_Test/OldVersions/Zusammenbau Feder Topf_Tino_Stoehr_220758.0002.dwg
Schillo/CAD_Test/OldVersions/Zusammenbau Feder Topf_Tino_Stoehr_220758_Version2.0002.dwg
Schillo/CAD_Test/Rohrleitung_Tino_Stoehr_220758.ipt
Useless Box/Eigene Bauteile/ER_Backe_Links.ipt
Useless Box/Eigene Bauteile/ER_Backe_Links_neu.ipt
Useless Box/Eigene Bauteile/ER_Backe_Rechts.ipt
Useless Box/Eigene Bauteile/ER_Backe_Rechts_neu.ipt
Useless Box/Eigene Bauteile/ER_Halterung_Kantensensor.ipt
Useless Box/Eigene Bauteile/ER_Halterung_Verschraubeinheit.ipt
Useless Box/Eigene Bauteile/ER_Positionierungseinheit_Backe_int.ipt
Useless Box/Eigene Bauteile/ER_Positionierungseinheit_Backe_int_MIR.ipt
Useless Box/Eigene Bauteile/ER_Positionierungseinheit_Backe_int_MIR1.ipt
Useless Box/Eigene Bauteile/ER_Positionierungseinheit_Greifer.ipt
Useless Box/Eigene Bauteile/ER_Stopper_Rexroth.ipt
Useless Box/Eigene Bauteile/ER_Verbindungsplatte_Verschraubeinheit.ipt
Useless Box/Eigene Bauteile/Fallmagazin/Magazin Wände/ER_Wand_1.ipt
Useless Box/Eigene Bauteile/Fallmagazin/Magazin Wände/ER_Wand_2.ipt
Useless Box/Eigene Bauteile/Fallmagazin/Magazin Wände/ER_Wand_3.ipt
Useless Box/Eigene Bauteile/Fallmagazin/Magazin Wände/ER_Wand_4.ipt
Useless Box/Eigene Bauteile/Fallmagazin/Magazin Wände/Magazin.iam
Useless Box/Eigene Bauteile/Fallmagazin/Magazin Wände/Magazin.ipn
Useless Box/Eigene Bauteile/Fallmagazin/Magazin Wände/OldVersions/ER_Wand_1.0001.ipt
Useless Box/Eigene Bauteile/Fallmagazin/Magazin Wände/OldVersions/ER_Wand_2.0003.ipt
Useless Box/Eigene Bauteile/Fallmagazin/Magazin Wände/OldVersions/ER_Wand_3.0002.ipt
Useless Box/Eigene Bauteile/Fallmagazin/Magazin Wände/OldVersions/ER_Wand_4.0004.ipt
Useless Box/Eigene Bauteile/Fallmagazin/Magazin Wände/OldVersions/Magazin.0001.iam
Useless Box/Eigene Bauteile/Fallmagazin/OldVersions/TS_V1_Fallmagazin_Boden_int.0024.ipt
Useless Box/Eigene Bauteile/Fallmagazin/OldVersions/TS_V1_Fallmagazin_Haltewinkel_Fuehrung_int.0003.ipt
Useless Box/Eigene Bauteile/Fallmagazin/OldVersions/TS_V1_Fallmagazin_Leitbleche_vorne_int.0011.ipt
Useless Box/Eigene Bauteile/Fallmagazin/OldVersions/TS_V1_Fallmagazin_Schieber.0054.iam
Useless Box/Eigene Bauteile/Fallmagazin/OldVersions/TS_V1_Fallmagazin_Schieber_int.0029.ipt
Useless Box/Eigene Bauteile/Fallmagazin/OldVersions/TS_V1_Fallmagazin_Schieberanbindung_int.0002.ipt
Useless Box/Eigene Bauteile/Fallmagazin/OldVersions/TS_V1_Fallmagazin_Stopper_int.0003.ipt
Useless Box/Eigene Bauteile/Fallmagazin/OldVersions/TS_V1_Fallmagazin_Verbindungsstange_int.0006.ipt
Useless Box/Eigene Bauteile/Fallmagazin/OldVersions/TS_V1_Fallmagazin_Wandung_int.0016.ipt
Useless Box/Eigene Bauteile/Fallmagazin/OldVersions/TS_V1_Fallmagazin_Zylinderanbindung_int.0007.ipt
Useless Box/Eigene Bauteile/Fallmagazin/OldVersions/TS_V1_Fallmagazin_Zylinderhalter_int.0005.ipt
Useless Box/Eigene Bauteile/Fallmagazin/OldVersions/TS_V1_Fallmagazin_gesamt.0111.iam
Useless Box/Eigene Bauteile/Fallmagazin/TS_V1_Fallmagazin_Boden_int.ipt
Useless Box/Eigene Bauteile/Fallmagazin/TS_V1_Fallmagazin_Haltewinkel_Fuehrung_int.ipt
Useless Box/Eigene Bauteile/Fallmagazin/TS_V1_Fallmagazin_Leitbleche_hinten_int.ipt
Useless Box/Eigene Bauteile/Fallmagazin/TS_V1_Fallmagazin_Leitbleche_vorne_int.ipt
Useless Box/Eigene Bauteile/Fallmagazin/TS_V1_Fallmagazin_Leitbleche_vorne_int_CPY.ipt
Useless Box/Eigene Bauteile/Fallmagazin/TS_V1_Fallmagazin_Schieber.iam
Useless Box/Eigene Bauteile/Fallmagazin/TS_V1_Fallmagazin_Schieber_int.ipt
Useless Box/Eigene Bauteile/Fallmagazin/TS_V1_Fallmagazin_Schieberanbindung_int.ipt
Useless Box/Eigene Bauteile/Fallmagazin/TS_V1_Fallmagazin_Stopper_int.ipt
Useless Box/Eigene Bauteile/Fallmagazin/TS_V1_Fallmagazin_Verbindungsstange_int.ipt
Useless Box/Eigene Bauteile/Fallmagazin/TS_V1_Fallmagazin_Wandung_int.ipt
Useless Box/Eigene Bauteile/Fallmagazin/TS_V1_Fallmagazin_Wandung_int_CPY.ipt
Useless Box/Eigene Bauteile/Fallmagazin/TS_V1_Fallmagazin_Zylinderanbindung_int.ipt
Useless Box/Eigene Bauteile/Fallmagazin/TS_V1_Fallmagazin_Zylinderhalter_int.ipt
Useless Box/Eigene Bauteile/Fallmagazin/TS_V1_Fallmagazin_gesamt.iam
Useless Box/Eigene Bauteile/Feder_adaptiv.ipt
Useless Box/Eigene Bauteile/Federmagazin/TS_Magazin_Begrenzung_int.ipt
Useless Box/Eigene Bauteile/Federmagazin/TS_Magazin_Begrenzung_int_MIR.ipt
Useless Box/Eigene Bauteile/Federmagazin/TS_Magazin_Begrenzung_int_MIR1.ipt
Useless Box/Eigene Bauteile/Federmagazin/TS_Magazin_Druckfeder_int.ipt
Useless Box/Eigene Bauteile/Federmagazin/TS_Magazin_Feder_int.ipt
Useless Box/Eigene Bauteile/Federmagazin/TS_Magazin_Fuehrungselement_int.ipt
Useless Box/Eigene Bauteile/Federmagazin/TS_Magazin_Gehause_int.ipt
Useless Box/Eigene Bauteile/Federmagazin/TS_Magazin_Gleitbuchse_int.ipt
Useless Box/Eigene Bauteile/Federmagazin/TS_Magazin_Grundplatte_int.ipt.ipt
Useless Box/Eigene Bauteile/Federmagazin/TS_Magazin_gesamt_int.iam
Useless Box/Eigene Bauteile/Finger.ipt
Useless Box/Eigene Bauteile/JH_Greifer_Unterlegscheibe/Eigene Bauteile/JH_Greifer_Scheibe.iam
Useless Box/Eigene Bauteile/JH_Greifer_Unterlegscheibe/Eigene Bauteile/JH_Greifer_Scheibe_final.iam
Useless Box/Eigene Bauteile/JH_Greifer_Unterlegscheibe/Eigene Bauteile/JH_int_Adapterplatte.ipt
Useless Box/Eigene Bauteile/JH_Greifer_Unterlegscheibe/Eigene Bauteile/JH_int_Greiferkoerper.ipt
Useless Box/Eigene Bauteile/JH_Greifer_Unterlegscheibe/Eigene Bauteile/JH_int_Greiferkoerper_Gegenstueck.ipt
Useless Box/Eigene Bauteile/JH_Greifer_Unterlegscheibe/Eigene Bauteile/OldVersions/JH_Greifer_Scheibe.0055.iam
Useless Box/Eigene Bauteile/JH_Greifer_Unterlegscheibe/Eigene Bauteile/OldVersions/JH_Greifer_Scheibe_final.0020.iam
Useless Box/Eigene Bauteile/JH_Greifer_Unterlegscheibe/Eigene Bauteile/OldVersions/JH_int_Adapterplatte.0022.ipt
Useless Box/Eigene Bauteile/JH_Greifer_Unterlegscheibe/Eigene Bauteile/OldVersions/JH_int_Greiferkoerper.0015.ipt
Useless Box/Eigene Bauteile/JH_Greifer_Unterlegscheibe/Eigene Bauteile/OldVersions/JH_int_Greiferkoerper_Gegenstueck.0014.ipt
Useless Box/Eigene Bauteile/JH_Greifer_Unterlegscheibe/Eigene Bauteile/OldVersions/Rexroth_Schraube_Mutter_modifiziert.0003.iam
Useless Box/Eigene Bauteile/JH_Greifer_Unterlegscheibe/Eigene Bauteile/OldVersions/Winkelblech.0004.ipt
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
