Freezepok/CAD-Paspa/Useless Box/Zeichnung ER/ER_Montagezeichnung_Fallmagazin FINAL2.pdf

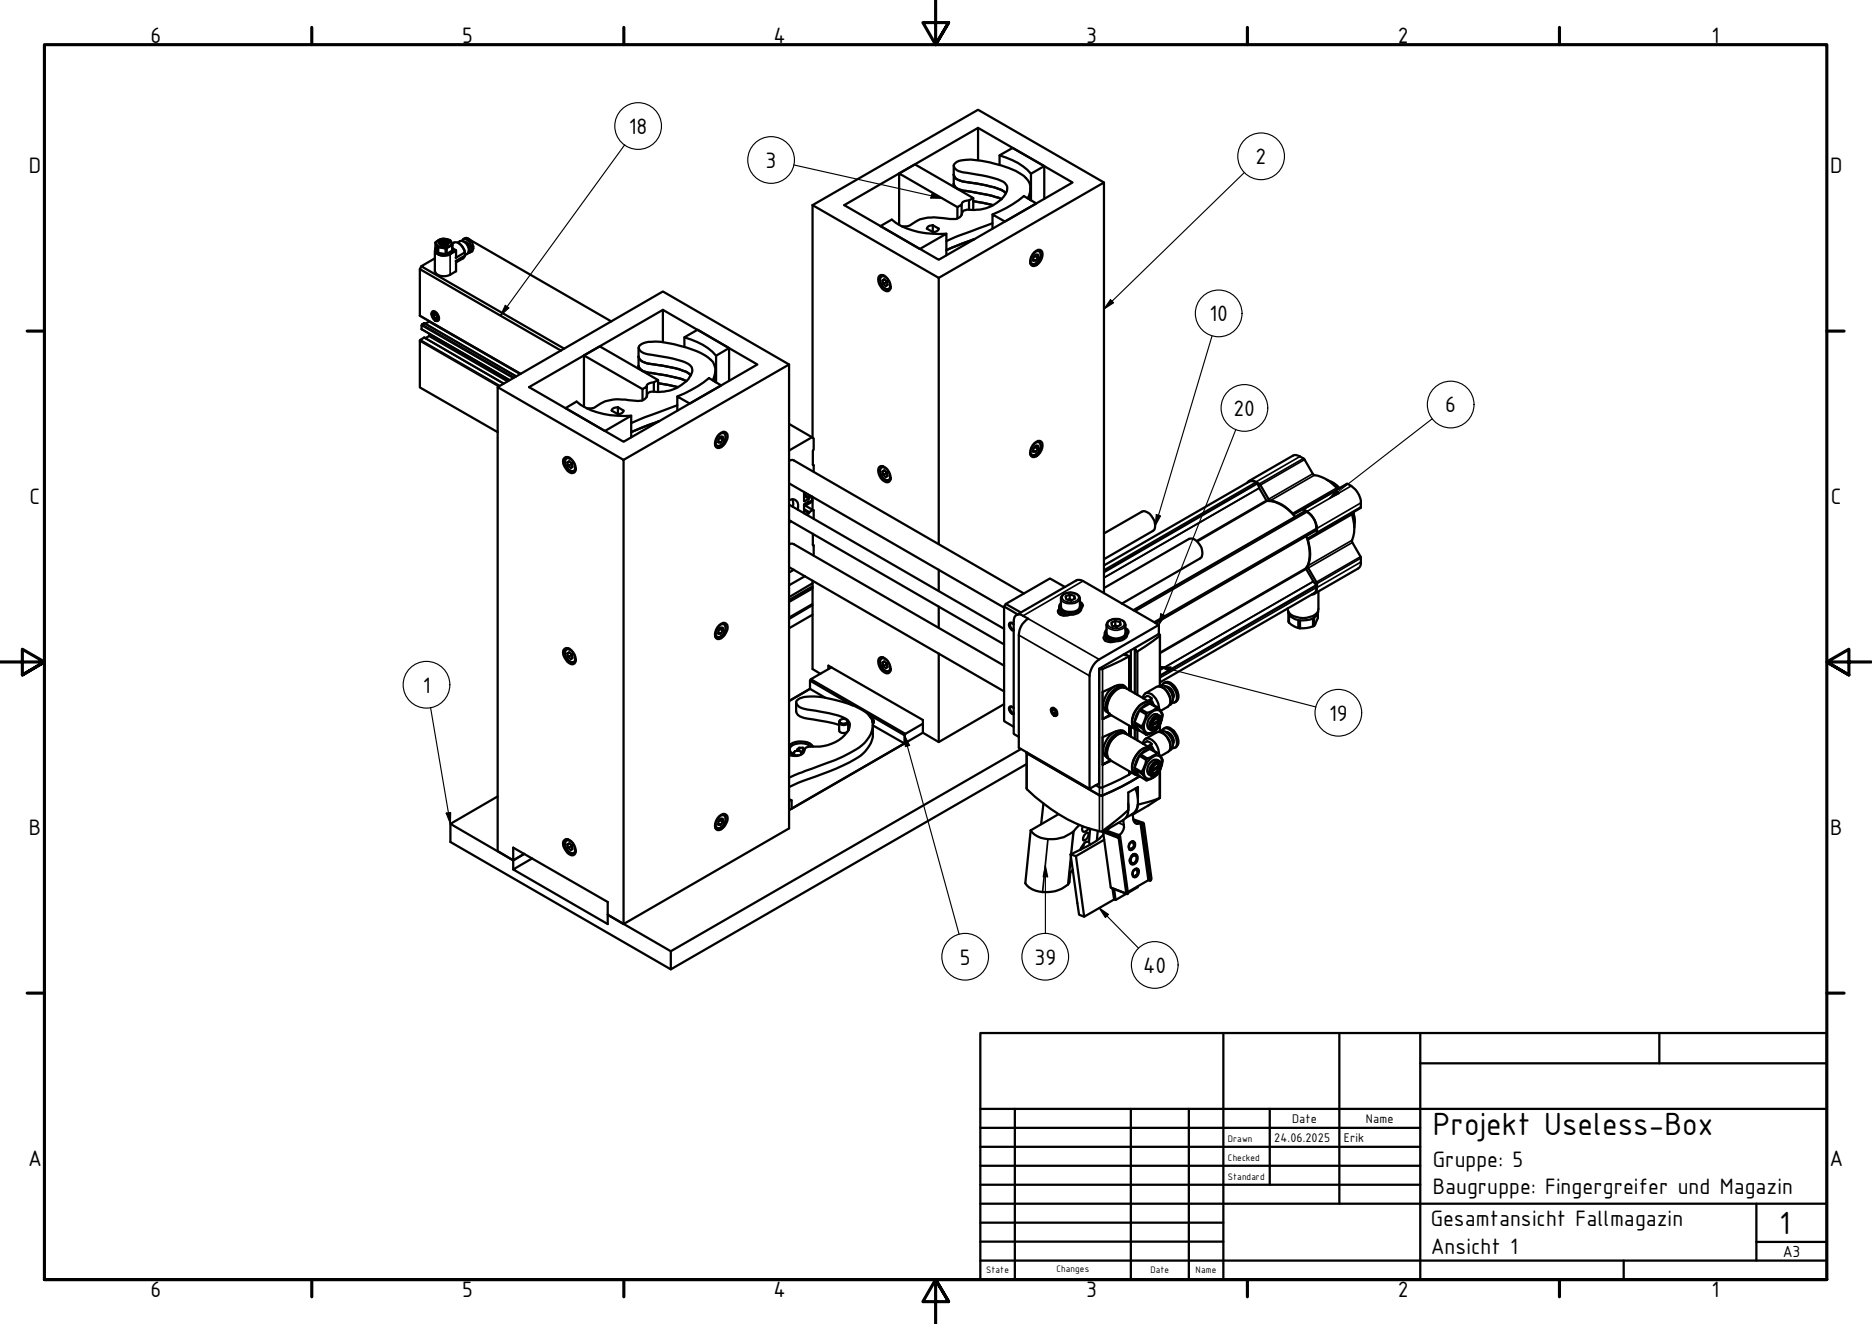
[picture p108: page 1]

Date | Name | Projekt Useless-Box Gruppe: 5 Baugruppe: Fingergreifer und Magazin

Drawn | 24.06.2025 | Erik

Checked

Standard

Gesamtansicht Fallmagazin Ansicht 1

State | Changes | Date | Name

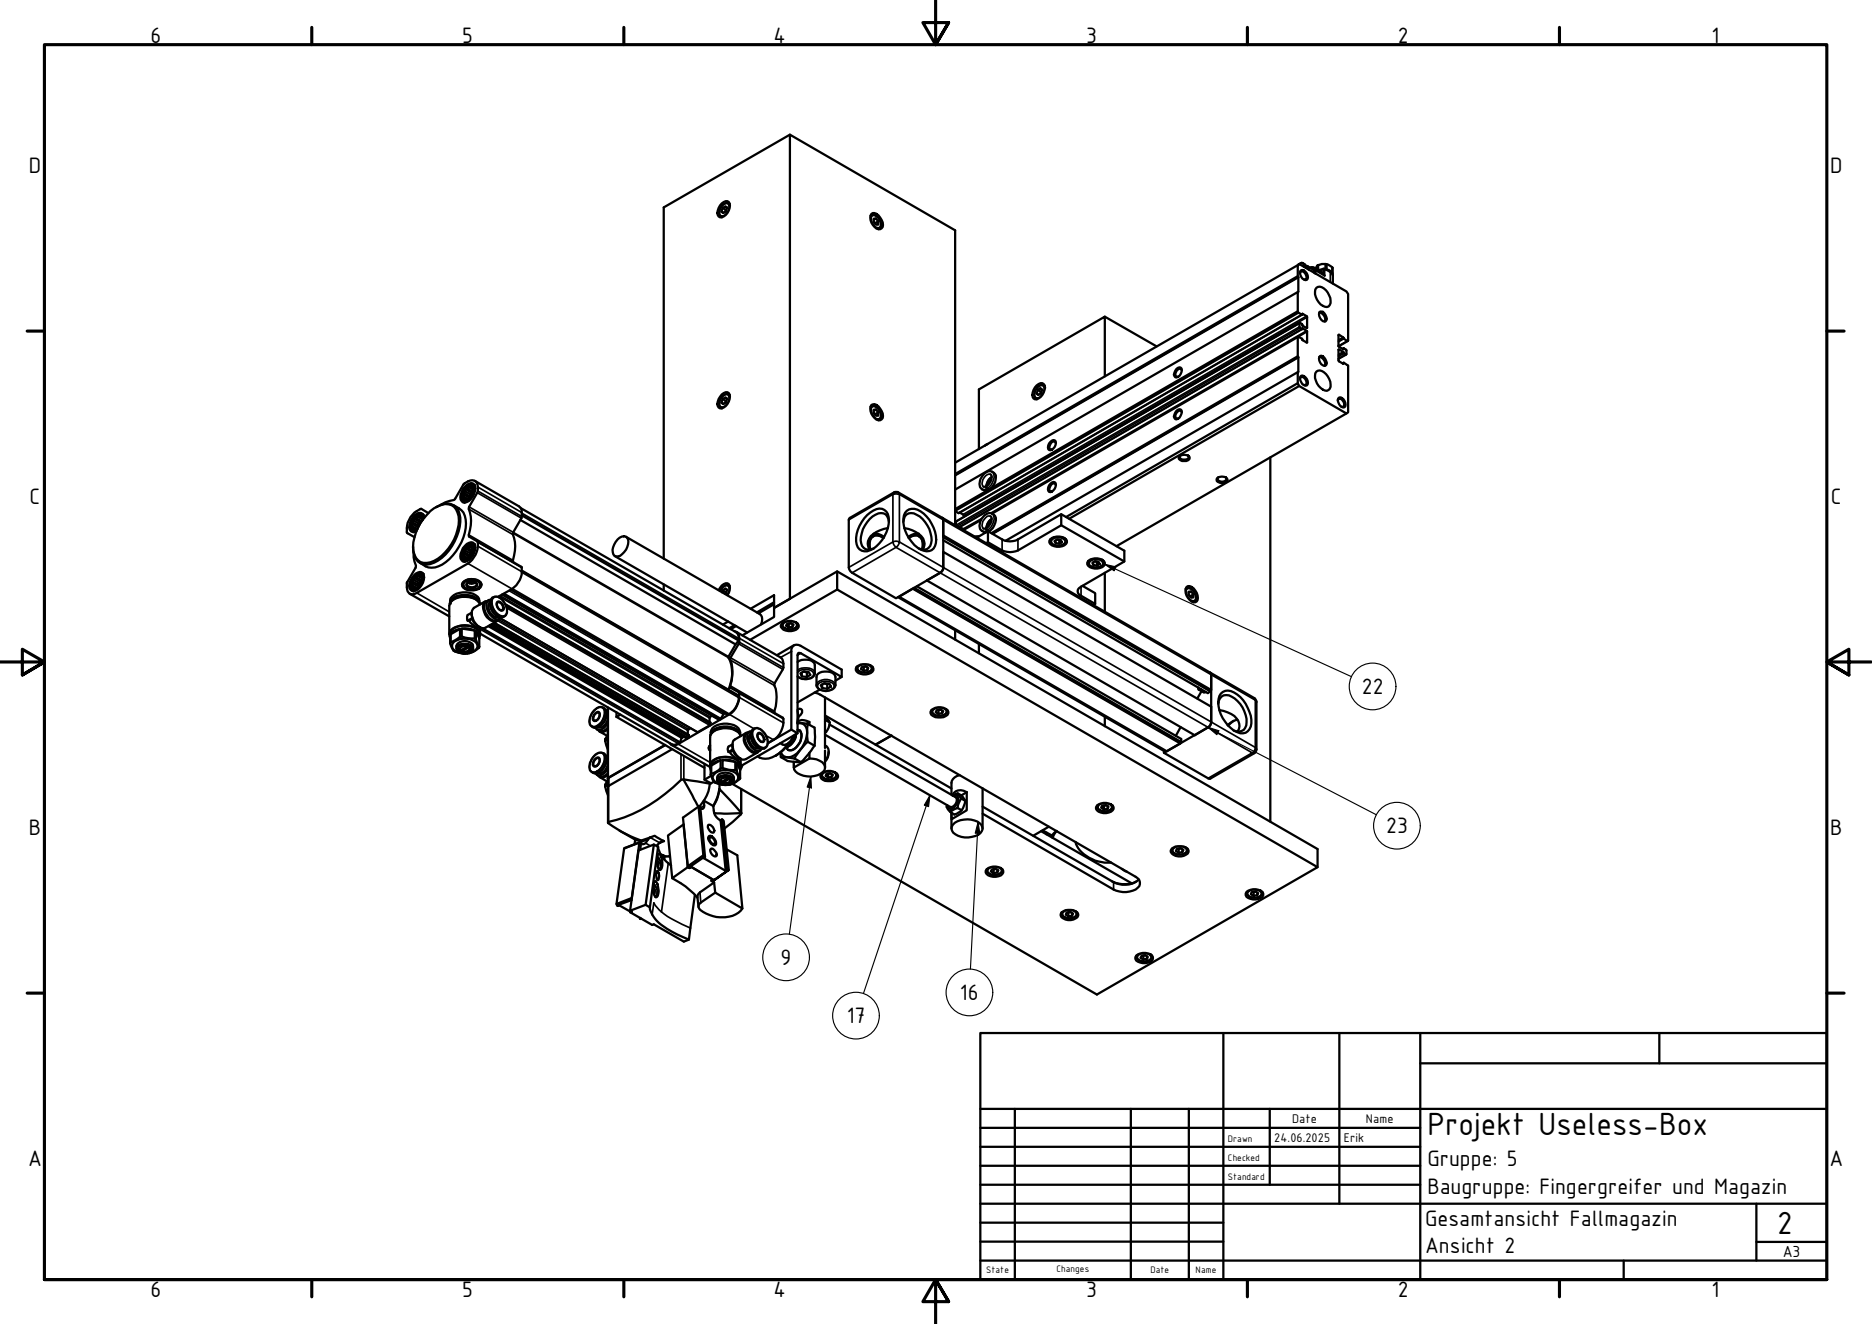
[picture p109: page 2]
Gesamtansicht Fallmagazin Ansicht 2

Date | Name | Projekt Useless-Box Gruppe: 5 Baugruppe: Fingergreifer und Magazin

Drawn | 24.06.2025 | Erik

Checked

Standard

BAUTEILLISTE
OBJEKT | ANZAHL | BEZEICHNUNG | BAUTEILNUMMER | NORM | ZULIEFERER | MATERIAL
1 | 1 | Fallmagazin Boden | | ISO 4762 - m | | S235JR
2 | 2 | Fallmagazin Wandung | | ISO 4762 - m | | S235JR
3 | 2 | Fallmagazin Leitbleche | | ISO 4762 - m | | S235JR
5 | 2 | Fallmagazin Schieber | | ISO 4762 - m | | S235JR
6 | 1 | Zweiwegezylinder | DSBC-32-100-PPVA-N3---(0) | | FESTO | AW-6061
10 | 4 | Fallmagazin Führungsstange | | ISO 4762 - m | | S355J2(+N)
16 | 1 | Fallmagazin Schieberanbindung | | ISO 4762 - m | | S235JR
17 | 1 | Fallmagazin Verbindungsstange | | ISO 4762 - m | | S235JR
18 | 1 | Zweiwegezylinder mit Führung | DFM-16-150-B-P-A-KF---(0) | | FESTO | AW-6061
19 | 1 | Radialgreifer | DHRS-32-A---(0) | | FESTO | AW-6061
20 | 1 | Adapter Greifer | | ISO 4762 - m | | S235JR
22 | 1 | Halterung Fuehrungszylinder | | ISO 4762 - m | | S235JR
23 | 2 | Verbindungsstück Rexrothprofil | Rexroth 30x30 Wuerfel | | Rexroth | S235JR
39 | 1 | Fingergreiferbacke Links | | ISO 4762 - m | | Stahl, gehärtet
40 | 1 | Fingergreiferbacke Rechts | | ISO 4762 - m | | Stahl, gehärtet

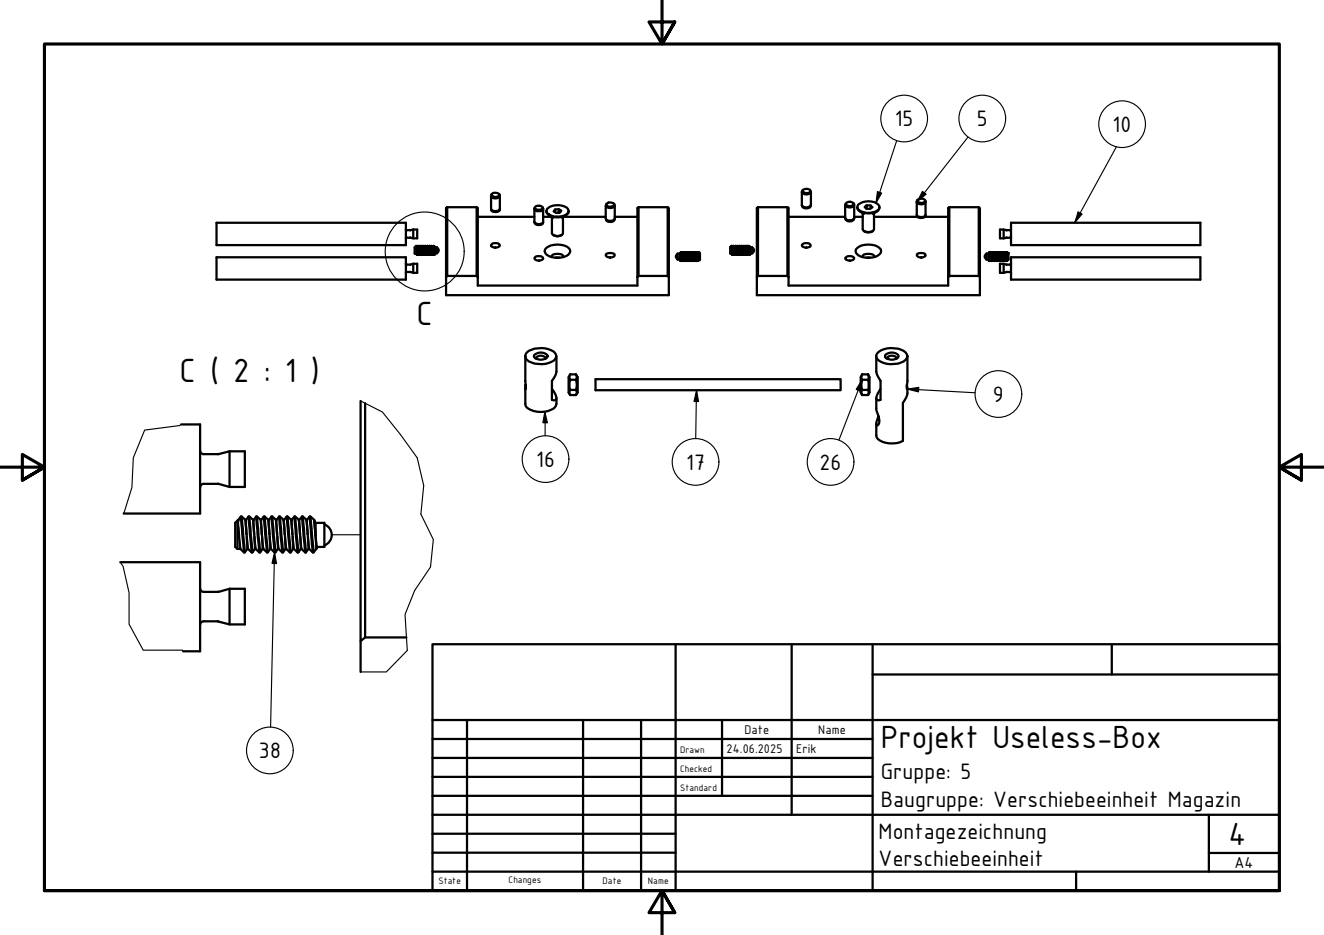
[picture p110: page 4]

Date | Name | Projekt Useless-Box Gruppe: 5 Baugruppe: Verschiebeeinheit Magazin

Drawn | 24.06.2025 | Erik

Checked

Standard

BAUTEILLISTE
OBJEKT | ANZAHL | BEZEICHNUNG | BAUTEILNUMMER | NORM | ZULIEFERER | MATERIAL
5 | 2 | Fallmagazin Schieber | | ISO 4762 - m | | S235JR
9 | 1 | Fallmagazin Zylinderanbindung | | ISO 4762 - m | | S235JR
10 | 4 | Fallmagazin Führungsstange | | ISO 4762 - m | | S355J2(+N)
15 | 2 | Senkkopfschraube | DIN 7991 - M5x12 | DIN 7991 | Autodesk Inc. | Stahl
16 | 1 | Fallmagazin Schieberanbindung | | ISO 4762 - m | | S235JR
17 | 1 | Fallmagazin Verbindungsstange | | ISO 4762 - m | | S235JR
27 | 2 | Zylinderkopfschraube | ISO 4762 - M6 x 12 | ISO 4762 | Autodesk Inc. | Stahl
38 | 4 | Wuerth Federndes Druckstueck Kugel | Wuerth 5099201004 | | Wuerth | Stahl, gehärtet

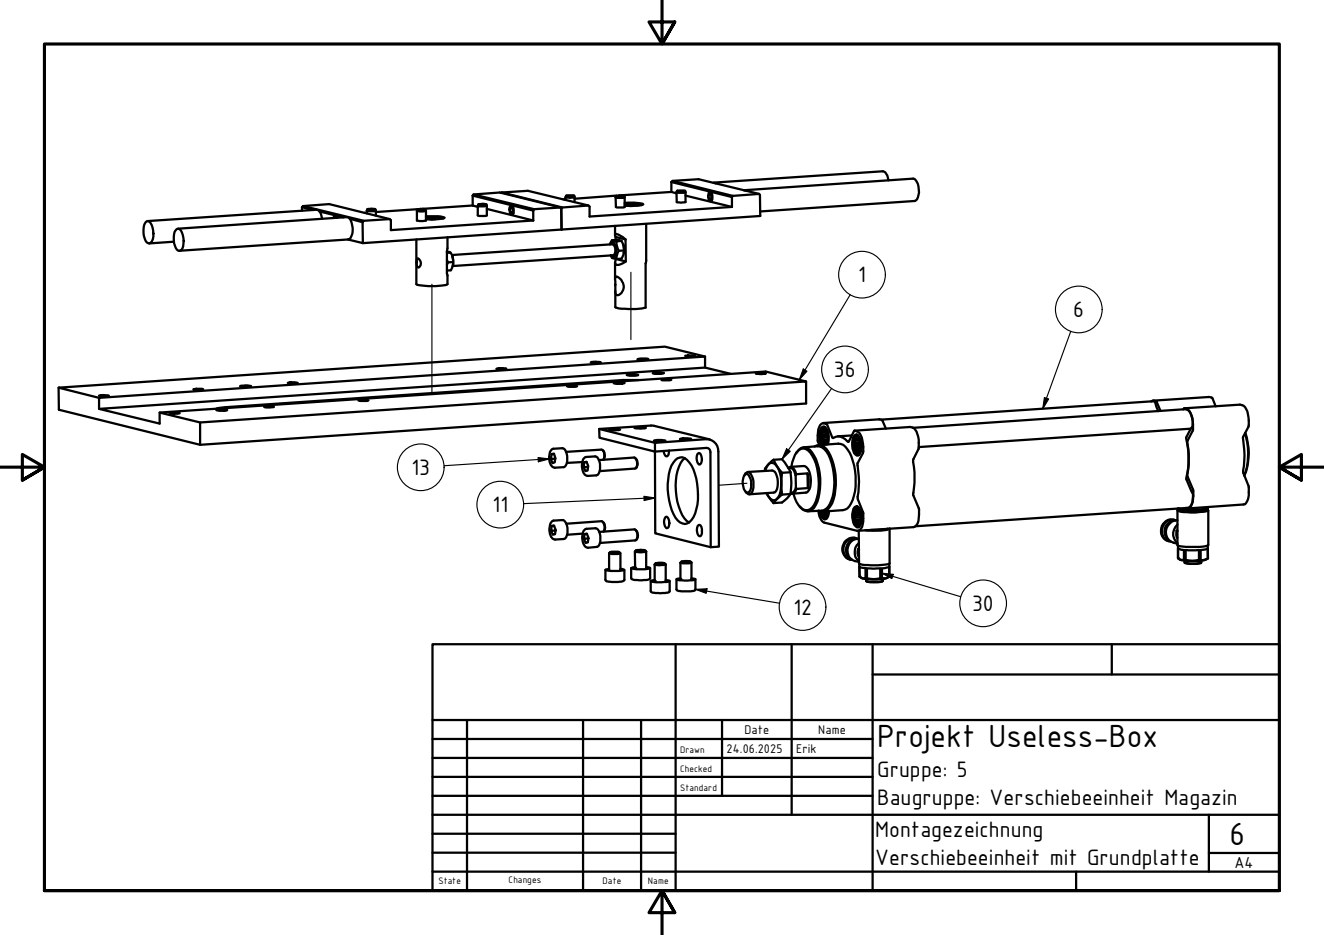
[picture p111: page 6]

Date | Name | Projekt Useless-Box Gruppe: 5 Baugruppe: Verschiebeeinheit Magazin

Drawn | 24.06.2025 | Erik

Checked

Standard

Montagezeichnung
Verschiebeeinheit mit Grundplatte

BAUTEILLISTE
OBJEKT | ANZAHL | BEZEICHNUNG | BAUTEILNUMMER | NORM | ZULIEFERER | MATERIAL
6 | 1 | Zweiwegezylinder | DSBC-32-100-PPVA-N3---(0) | | FESTO | AW-6061
11 | 1 | Fallmagazin Zylinderhalter | | | | S235JR
12 | 4 | Zylinderkopfschraube | ISO 4762 - M5 x 8 | ISO 4762 | Autodesk Inc. | Edelstahl, 440C
13 | 4 | Zylinderkopfschraube | ISO 4762 - M5 x 20 | ISO 4762 | Autodesk Inc. | Edelstahl, 440C
30 | 4 | Drosselrückschlagventil | GRLA-1/8-QS-4-D | | FESTO | AW-6061
36 | 1 | Sechskantmutter M10 | DIN-439-B - M10x1_25 | DIN 439 | Autodesk Inc. | Stahl

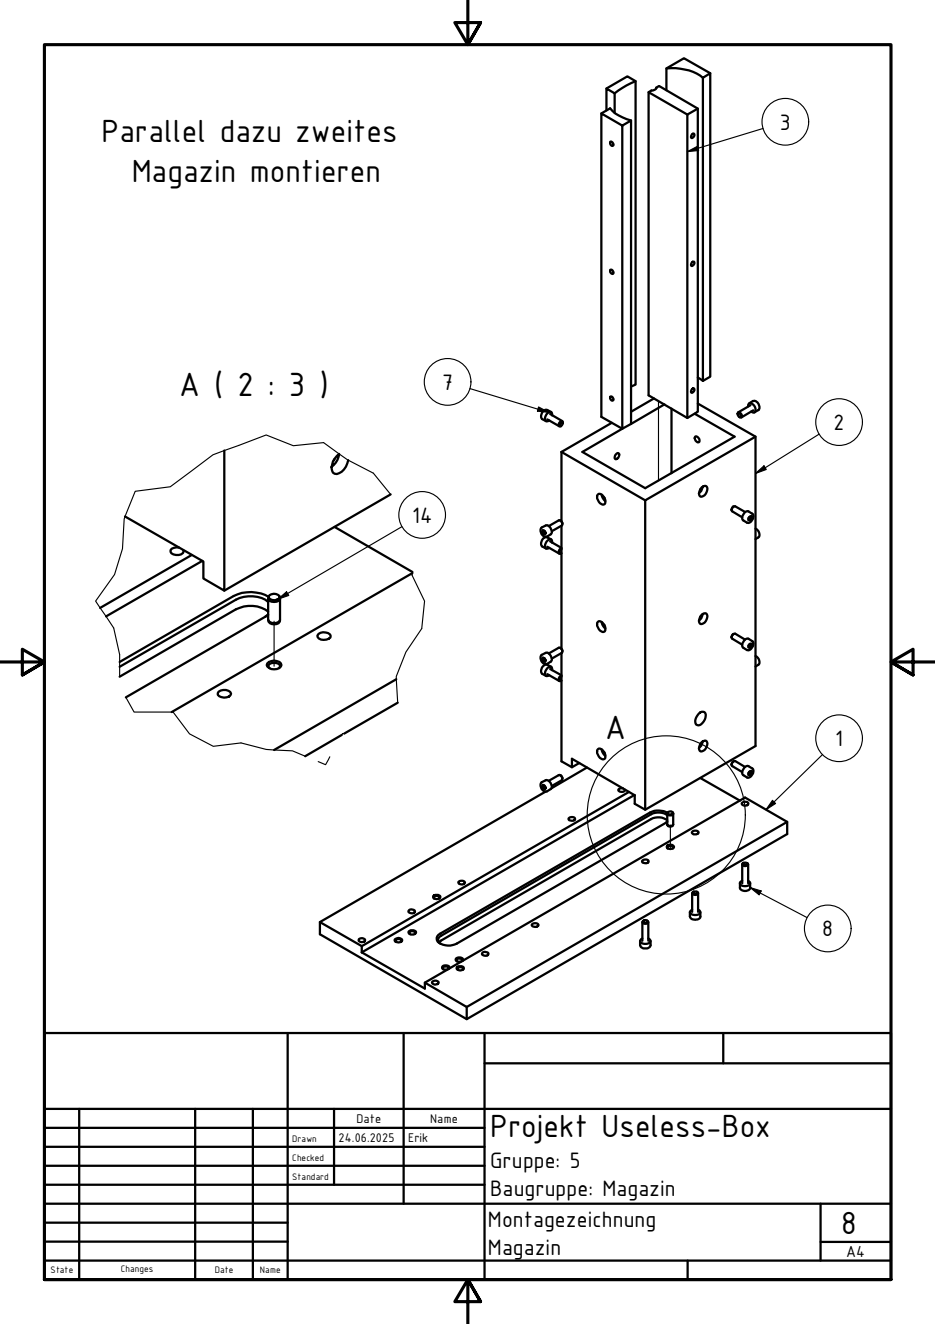
[picture p112: page 8]

Parallel dazu zweites
Magazin montieren

Date | Name | Projekt Useless-Box Gruppe: 5 Baugruppe: Magazin

Drawn | 24.06.2025 | Erik

Checked

Standard

BAUTEILLISTE
OBJEKT | ANZAHL | BEZEICHNUNG | BAUTEILNUMMER | NORM | ZULIEFERER | MATERIAL
1 | 1 | Fallmagazin Boden | | ISO 4762 - m | | S235JR
2 | 2 | Fallmagazin Wandung | | ISO 4762 - m | | S235JR
7 | 24 | Zylinderkopfschraube | ISO 4762 - M4 x 12 | ISO 4762 - m | Autodesk Inc. | Edelstahl, 440C
8 | 12 | Zylinderkopfschraube | ISO 4762 - M4 x 16 | ISO 4762 | Autodesk Inc. | Edelstahl, 440C
14 | 6 | Zylinderstift 4 mm | ISO 2338 - 4 m6 x 10 | DIN EN ISO 2338 | Autodesk Inc. | Edelstahl, austenitisch

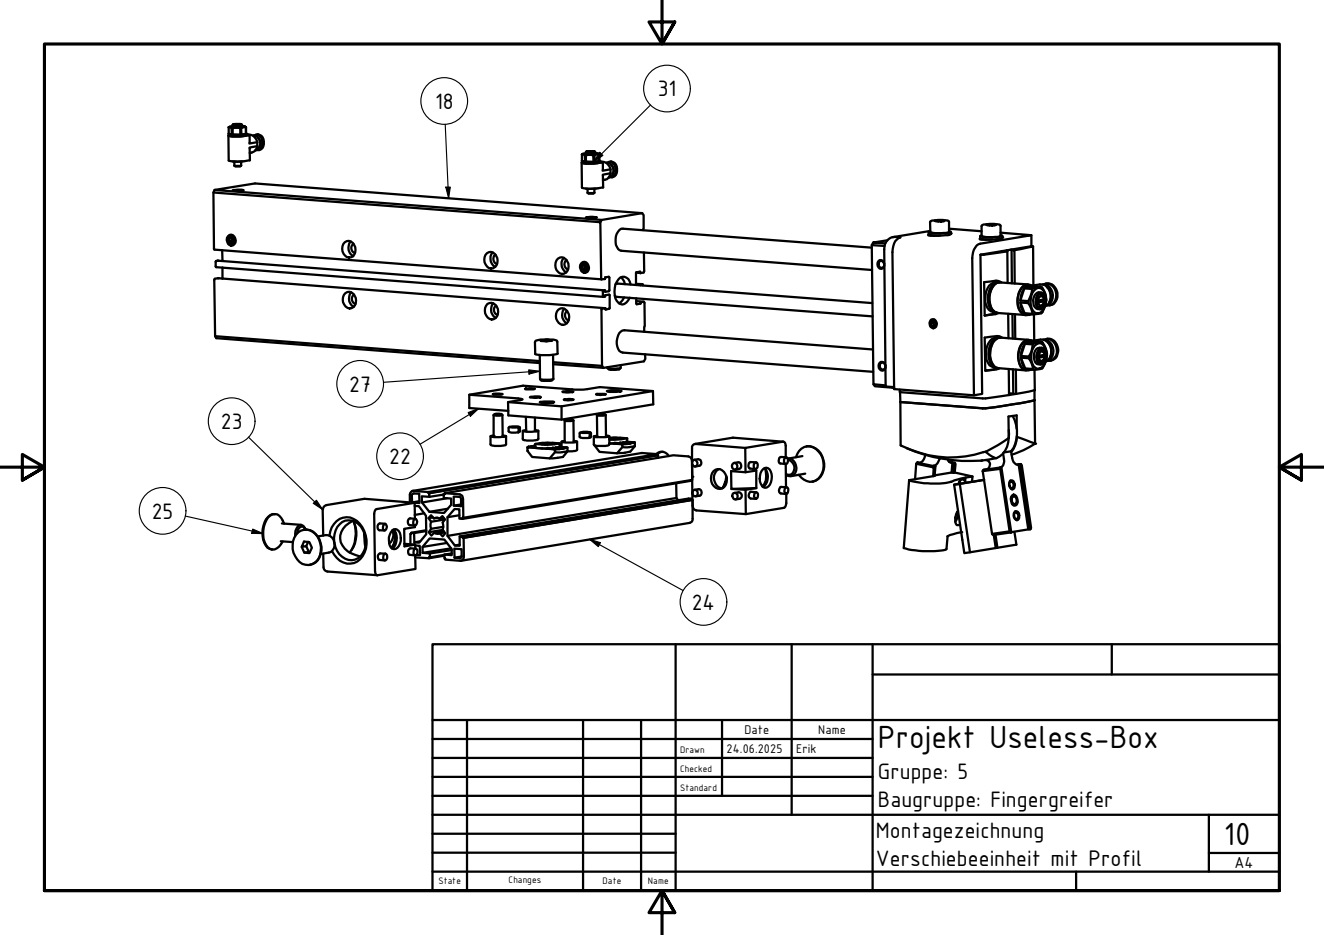
[picture p113: page 10]

Date | Name | Projekt Useless-Box Gruppe: 5 Baugruppe: Fingergreifer

Drawn | 24.06.2025 | Erik

Checked

Standard

Montagezeichnung
Verschiebeeinheit mit Profil

BAUTEILLISTE
OBJEKT | ANZAHL | BEZEICHNUNG | BAUTEILNUMMER | NORM | ZULIEFERER | MATERIAL
18 | 1 | Zweiwegezylinder mit Führung | DFM-16-150-B-P-A-KF---(0) | | FESTO | AW-6061
22 | 1 | Halterung Fuehrungszylinder | | ISO 4762 - m | | S235JR
23 | 2 | Verbindungsstück Rexrothprofil | Rexroth 30x30 Wuerfel | | Rexroth | S235JR
24 | 1 | Rexroth Profil 30x30 160 mm | Rexroth 30x30 160 | | | AW-6061
25 | 4 | Senkkopfschraube | DIN 7991 - M8x16 | DIN 7991 | Autodesk Inc. | Stahl
27 | 2 | Zylinderkopfschraube | ISO 4762 - M6 x 12 | ISO 4762 | Autodesk Inc. | Stahl
31 | 2 | Drosselrückschlagventil | GRLZ-M3-QS-3 | | FESTO | AW-6061

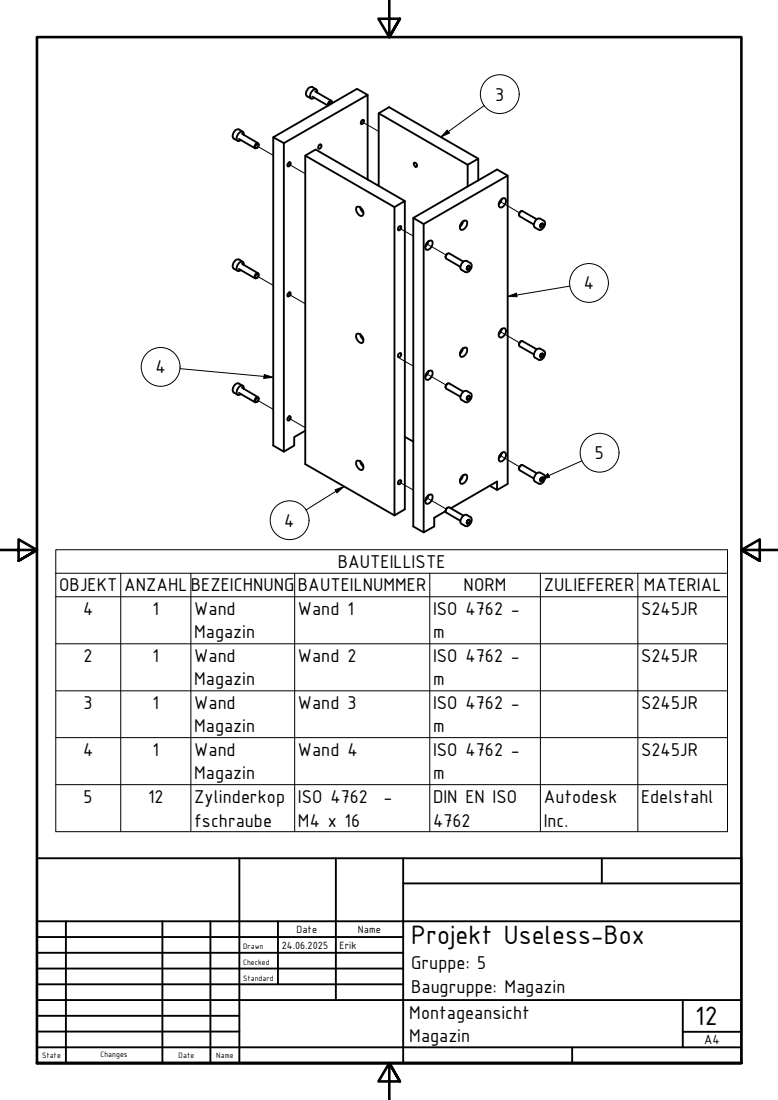
[picture p114: page 12]

OBJEKT | ANZAHL BEZEICHNUNG BAUTEILNUMMER | | | NORM | ZULIEFERER | MATERIAL
4 | 1 | Wand Magazin | Wand 1 | ISO 4762 -m | | S245JR

2 | 1 | Wand Magazin | Wand 2 | ISO 4762 -m | | S245JR

3 | 1 | Wand Magazin | Wand 3 | ISO 4762 -m | | S245JR

4 | 1 | Wand Magazin | Wand 4 | ISO 4762 -m | | S245JR

5 | 12 | Zylinderkop fschraube | ISO 4762 -M4 x 16 | DIN EN ISO 4762 | Autodesk Inc. | Edelstahl

Date | Name | Projekt Useless-Box Gruppe: 5 Baugruppe: Magazin

Drawn | 24.06.2025 | Erik

Checked

Standard

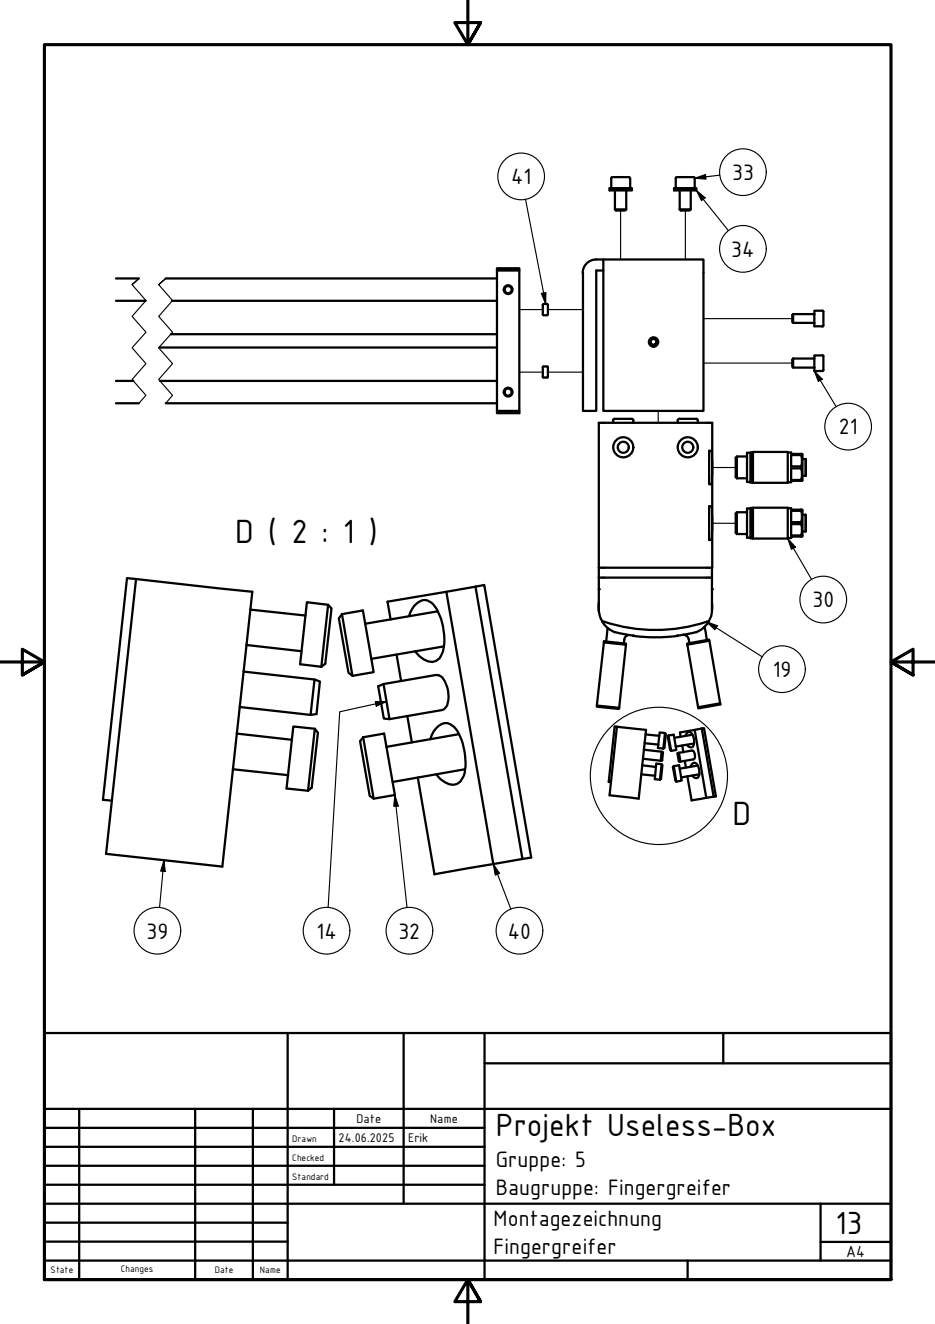
[picture p115: page 13]

Date | Name | Projekt Useless-Box Gruppe: 5 Baugruppe: Fingergreifer

Drawn | 24.06.2025 | Erik

Checked

Standard

BAUTEILLISTE
OBJEKT | ANZAHL | BEZEICHNUNG | BAUTEILNUMMER | NORM | ZULIEFERER | MATERIAL
19 | 1 | Radialgreifer | DHRS-32-A---(0) | | FESTO | AW-6061
21 | 8 | | ISO 4762 - M4 x 10 | ISO 4762 - m | | Edelstahl, 440C
30 | 4 | Drosselrückschlagventil | GRLA-1/8-QS-4-D | | FESTO | AW-6061
32 | 4 | | DIN 6912 - M4 x 10 | DIN 6912 | Autodesk Inc. | Stahl
33 | 2 | | ISO 4762 - M5 x 10 | DIN EN ISO 4762 | Autodesk Inc. | Edelstahl, 440C
34 | 2 | | DIN 125 - A 5,3 | DIN 125 | Autodesk Inc. | Stahl, Weich
39 | 1 | Fingergreiferbacke Links | | ISO 4762 - m | | Stahl, gehärtet
40 | 1 | Fingergreiferbacke Rechts | | ISO 4762 - m | | Stahl, gehärtet
41 | 1 | Führungsring | 8146543 ZBH-5-B:1 | | FESTO | Stahl, gehärtet

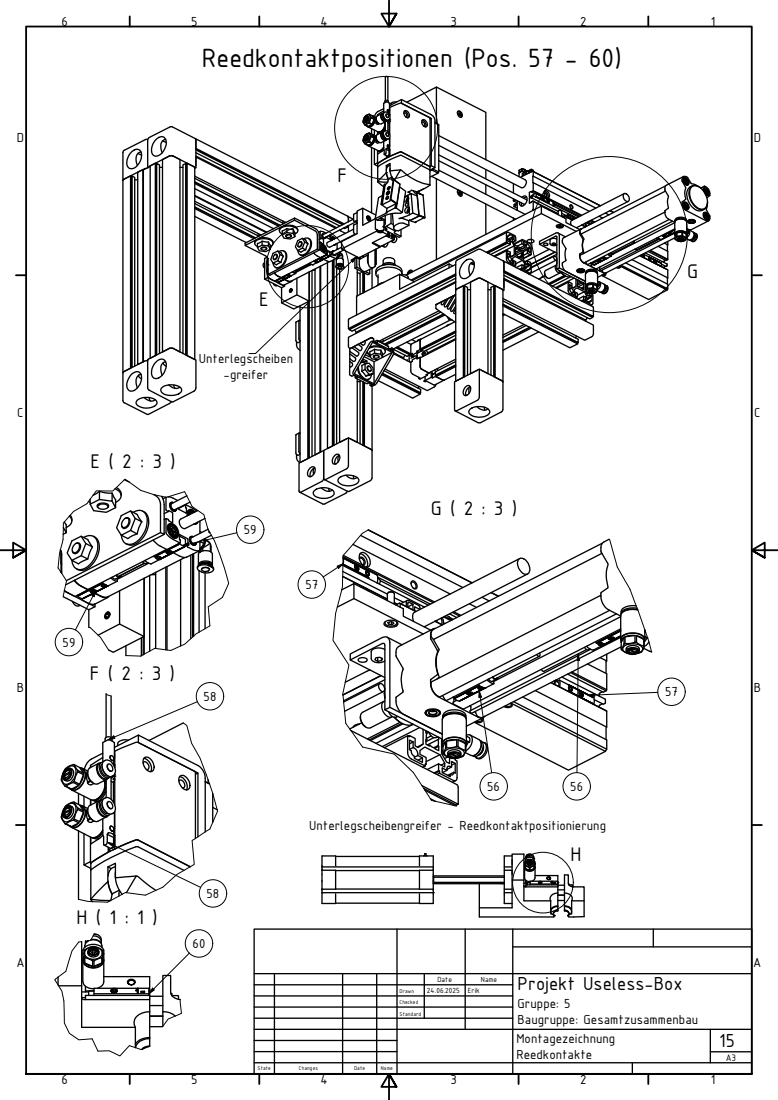
[picture p116: page 15]
Unterlegscheibengreifer - Reedkontaktpositionierung; Reedkontaktpositionen (Pos. 57 - 60)

Date | Name | Projekt Useless-Box Gruppe: 5 Baugruppe: Gesamtzusammenbau

Drawn | 24.06.2025 | Erik

Checked

Standard

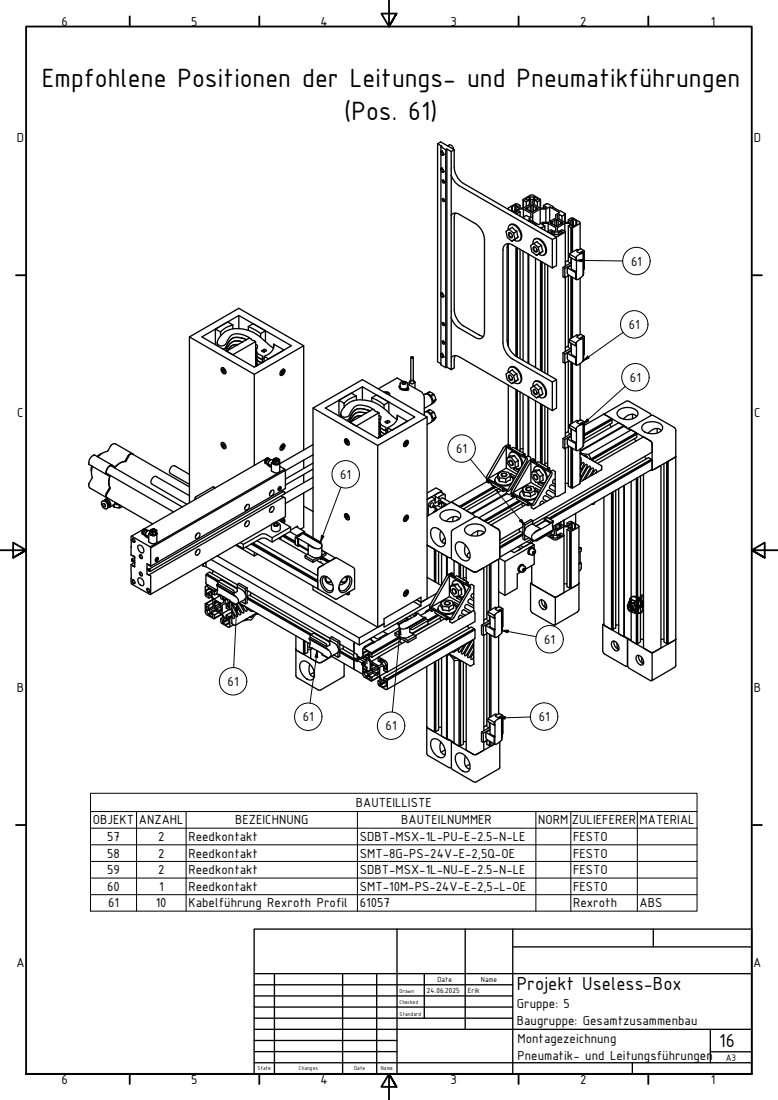
[picture p117: page 16]
(Pos. 61)

Empfohlene Positionen der Leitungs- und Pneumatikführungen

OBJEKT | ANZAHL | BEZEICHNUNG | BAUTEILNUMMER | NORM | ZULIEFERER MATERIAL
57 | 2 | Reedkontakt | SDBT-MSX-1L-PU-E-2.5-N-LE | | FESTO
58 | 2 | Reedkontakt | SMT-8G-PS-24V-E-2,5Q-OE | | FESTO
59 | 2 | Reedkontakt | SDBT-MSX-1L-NU-E-2.5-N-LE | | FESTO
60 | 1 | Reedkontakt | SMT-10M-PS-24V-E-2,5-L-OE | | FESTO
61 | 10 | Kabelführung Rexroth Profil | 61057 | | Rexroth | ABS

Date | Name | Projekt Useless-Box Gruppe: 5 Baugruppe: Gesamtzusammenbau

Drawn | 24.06.2025 | Erik

Checked

Standard

Montagezeichnung
Pneumatik- und Leitungsführungen
