Freezepok/CAD-Paspa/Useless Box/Zeichnungen FINAL/Montagezeichnungen A4.pdf

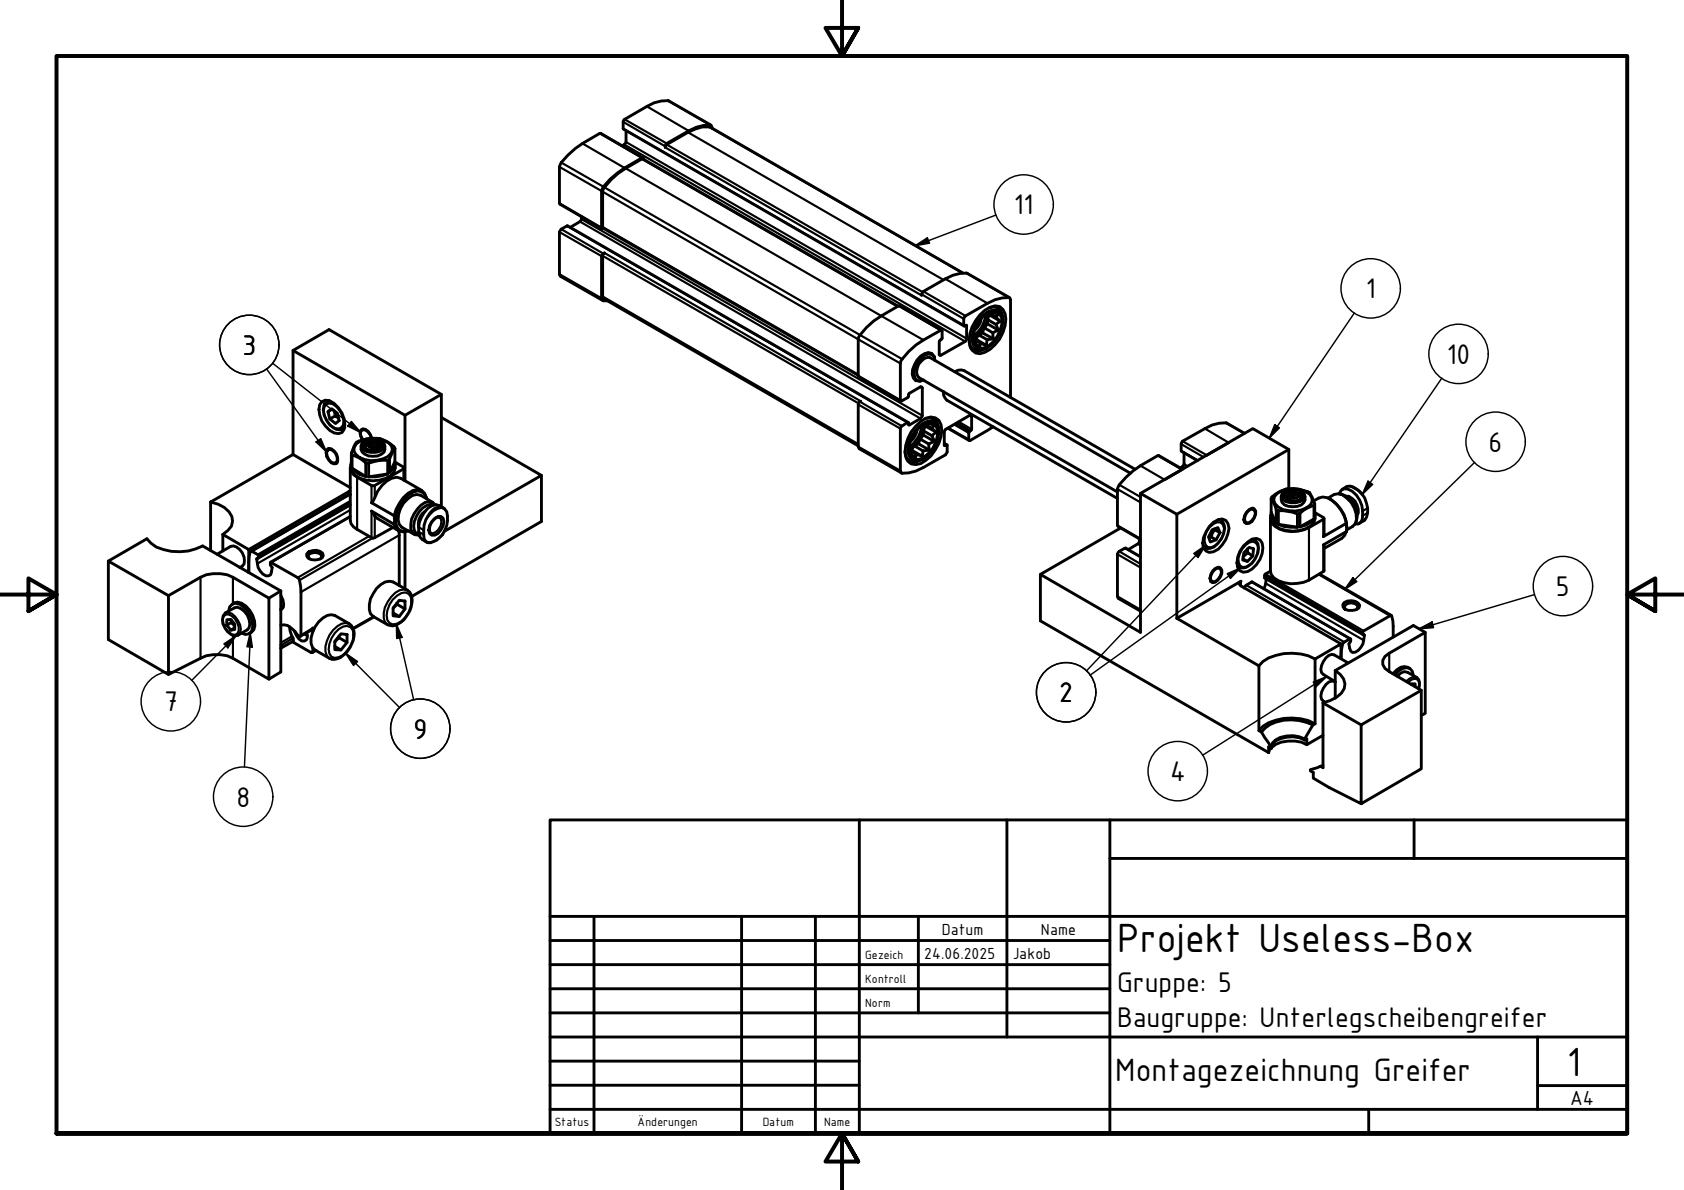
[picture p123: page 1]
Status; Änderungen; Datum; Name; Gezeich; Kontroll; Norm; Jakob

Projekt Useless-Box
Gruppe: 5
Baugruppe: Unterlegscheibengreifer
Montagezeichnung Greifer

BAUTEILLISTE
OBJEKT | ANZAHL | BEZEICHNUNG | BAUTEILNUMMER | NORM | ZULIEFERER | MATERIAL
| | | | | | X90CrMoV18 - gehärtet

Basis Greiferbacke11

Stainless Steel,
440C

Autodesk Inc. DIN EN ISO
4762

ISO 4762 - M3 x 10Zylinderkopfschraube22

Stainless Steel,
Austenitic

Autodesk Inc. DIN EN ISO
2338

ISO 2338 - 3 h8 x 14Zylinderstift23

Stainless Steel,
Austenitic

Autodesk Inc. DIN EN ISO
2338

ISO 2338 - 4 h8 x 14Zylinderstift24

X90CrMoV18 -
gehärtet

ück Gegenst
Greiferbacke

15

FESTO 5267300 AEN-S-6-5-I-APneumatikzylinder (einfachwirkend)

16

Stainless Steel,
440C

Autodesk Inc. DIN EN ISO
4762

ISO 4762 - M2,5 x 5Zylinderkopfschraube17

ibe18 | Steel, MildAutodesk Inc. DIN 125DIN 125 - A 2,7Sche
Stainless Steel,
440C

Autodesk Inc. DIN EN ISO
4762

ISO 4762 - M4 x 16Zylinderkopfschraube29

ückschlagventil110 | FESTO 175043 GRLZ-M3-QS-3Drosselr
ührungszylinder111 | FESTO 537123 ADNGF-12-50-P-AF

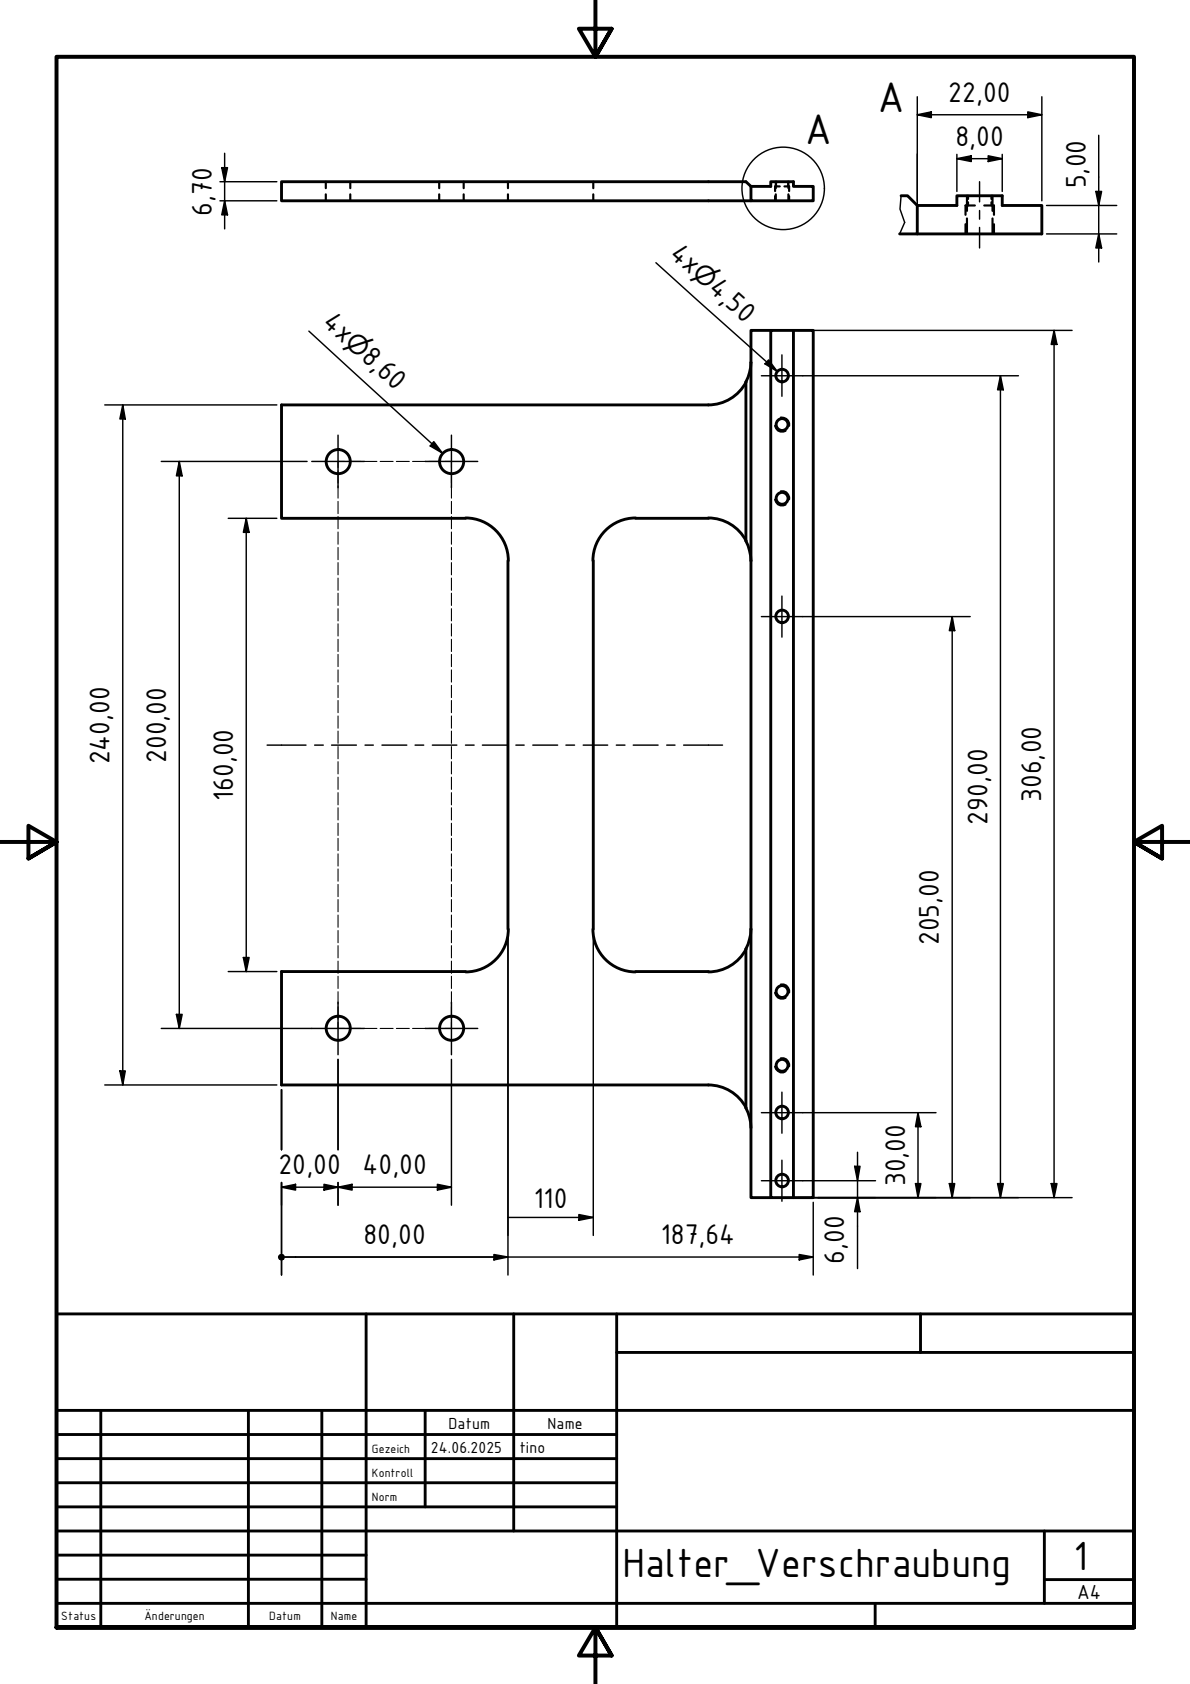
[picture p124: page 4]
Halter_Verschraubung; Status; Änderungen; Datum; Name

Datum | Name

Gezeich | 24.06.2025 | tino

Kontroll

Norm

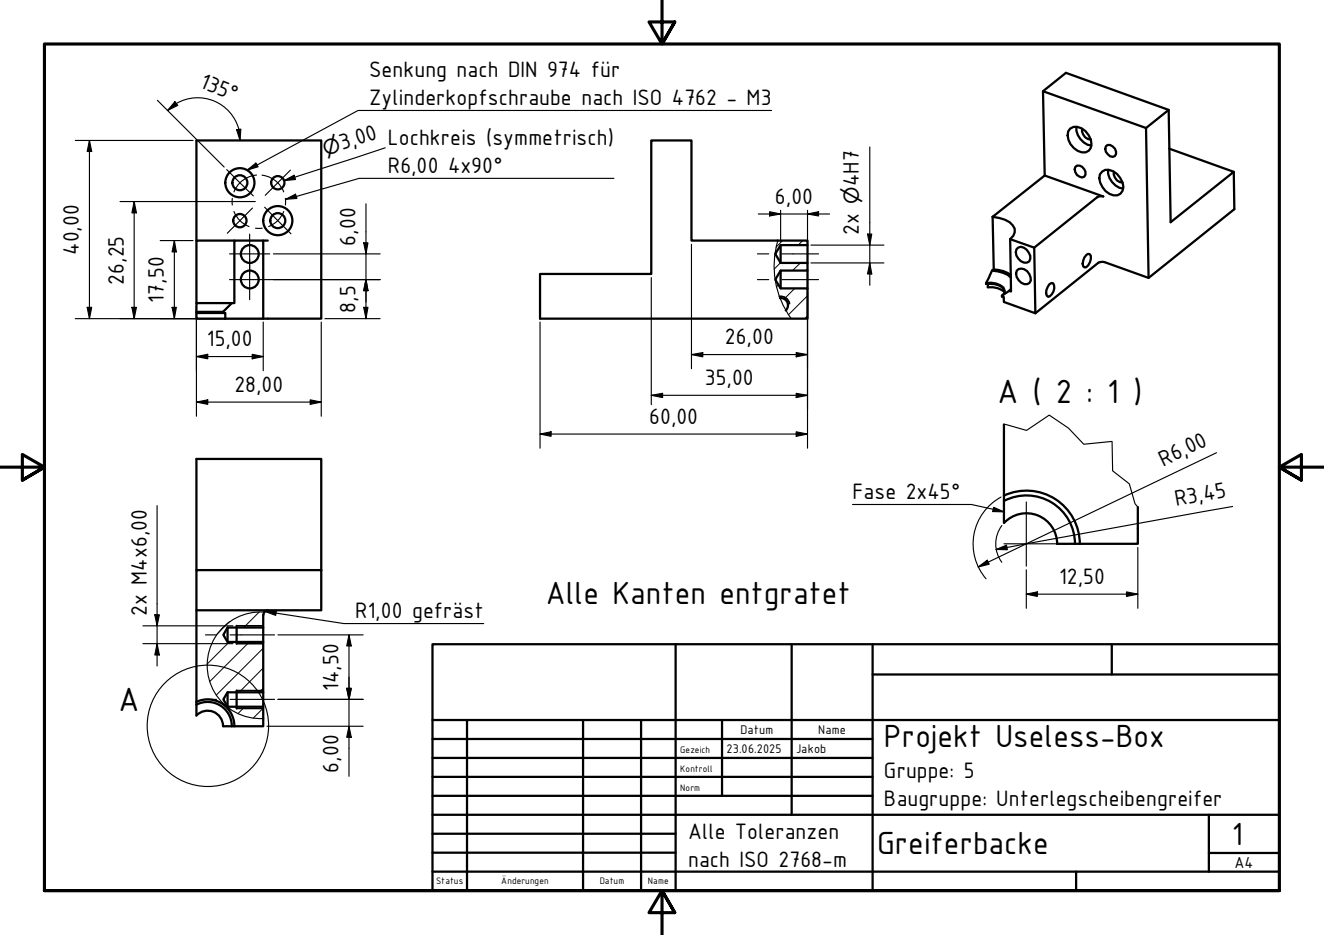
[picture p125: page 5]
Status; Änderungen; Datum; Name; Gezeich; Kontroll; Norm; Jakob; R1,00 gefräst; Fase 2x45°; Alle Toleranzen nach ISO 2768-m

Senkung nach DIN 974 für
Zylinderkopfschraube nach ISO 4762 - M3
Lochkreis (symmetrisch)

Alle Kanten entgratet

Projekt Useless-Box
Gruppe: 5
Baugruppe: Unterlegscheibengreifer
Greiferbacke

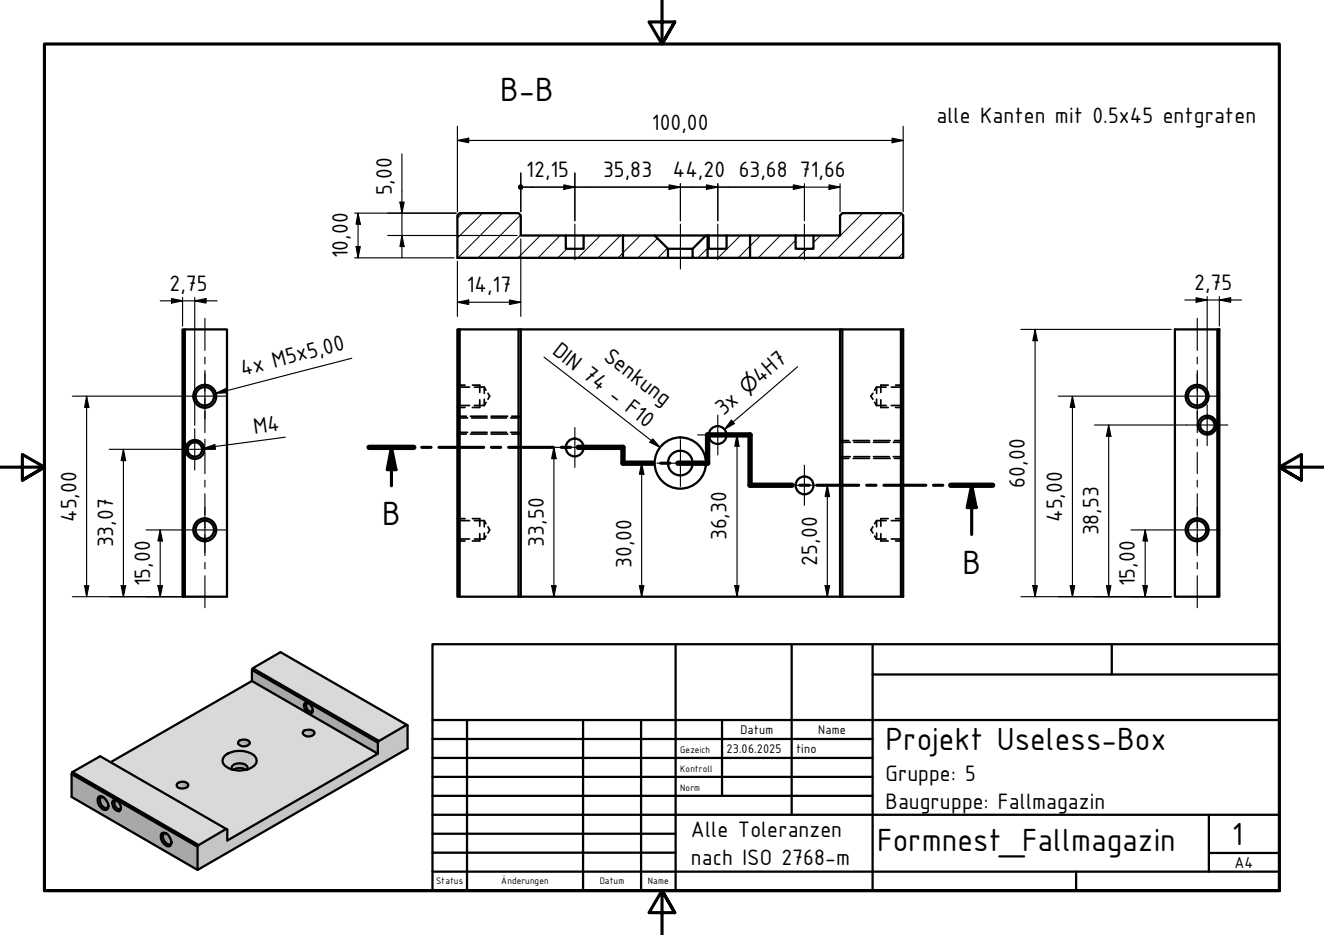
[picture p126: page 6]
Status; Änderungen; Datum; Name; Gezeich; Kontroll; Norm; tino; Senkung; DIN 74 - F10; Alle Toleranzen nach ISO 2768-m

alle Kanten mit 0.5x45 entgraten

Projekt Useless-Box
Gruppe: 5
Baugruppe: Fallmagazin
Formnest_Fallmagazin

BAUTEILLISTE
OBJEKT | ANZAHL | BEZEICHNUNG | BAUTEILNUMMER | NORM | ZULIEFERER | MATERIAL
S235JR ISO 4762 - m Fallmagazin Boden11 S235JR ISO 4762 - m Fallmagazin Wandung22 S235JR ISO 4762 - m Fallmagazin Leitbleche23 S235JR ISO 4762 - m Fallmagazin Schieber25 AW-6061FESTO DSBC-32-100-PPVA-N3-
| | | --(0)

Zweiwegezylinder16

ührungsstange410 | ISO 4762 - m Fallmagazin F | S355J2(+N)
S235JR ISO 4762 - m Fallmagazin Schieberanbindung

116

S235JR ISO 4762 - m Fallmagazin Verbindungsstange

117

AW-6061FESTO DFM-16-150-B-P-A-KF---(0)

Zweiwegezylinder mit Führung118

Radialgreifer 119 | DHRS-32-A---(0) | AW-6061FESTO
S235JR ISO 4762 - m Adapter Greifer120 S235JR ISO 4762 - m Halterung Fuehrungszylinder122
ück | S235JRRexroth Rexroth 30x30 WuerfelVerbindungsst
Rexrothprofil

223

Stahl, gehärtet ISO 4762 - m Fingergreiferbacke Links139 Stahl, gehärtet ISO 4762 - m Fingergreiferbacke Rechts140

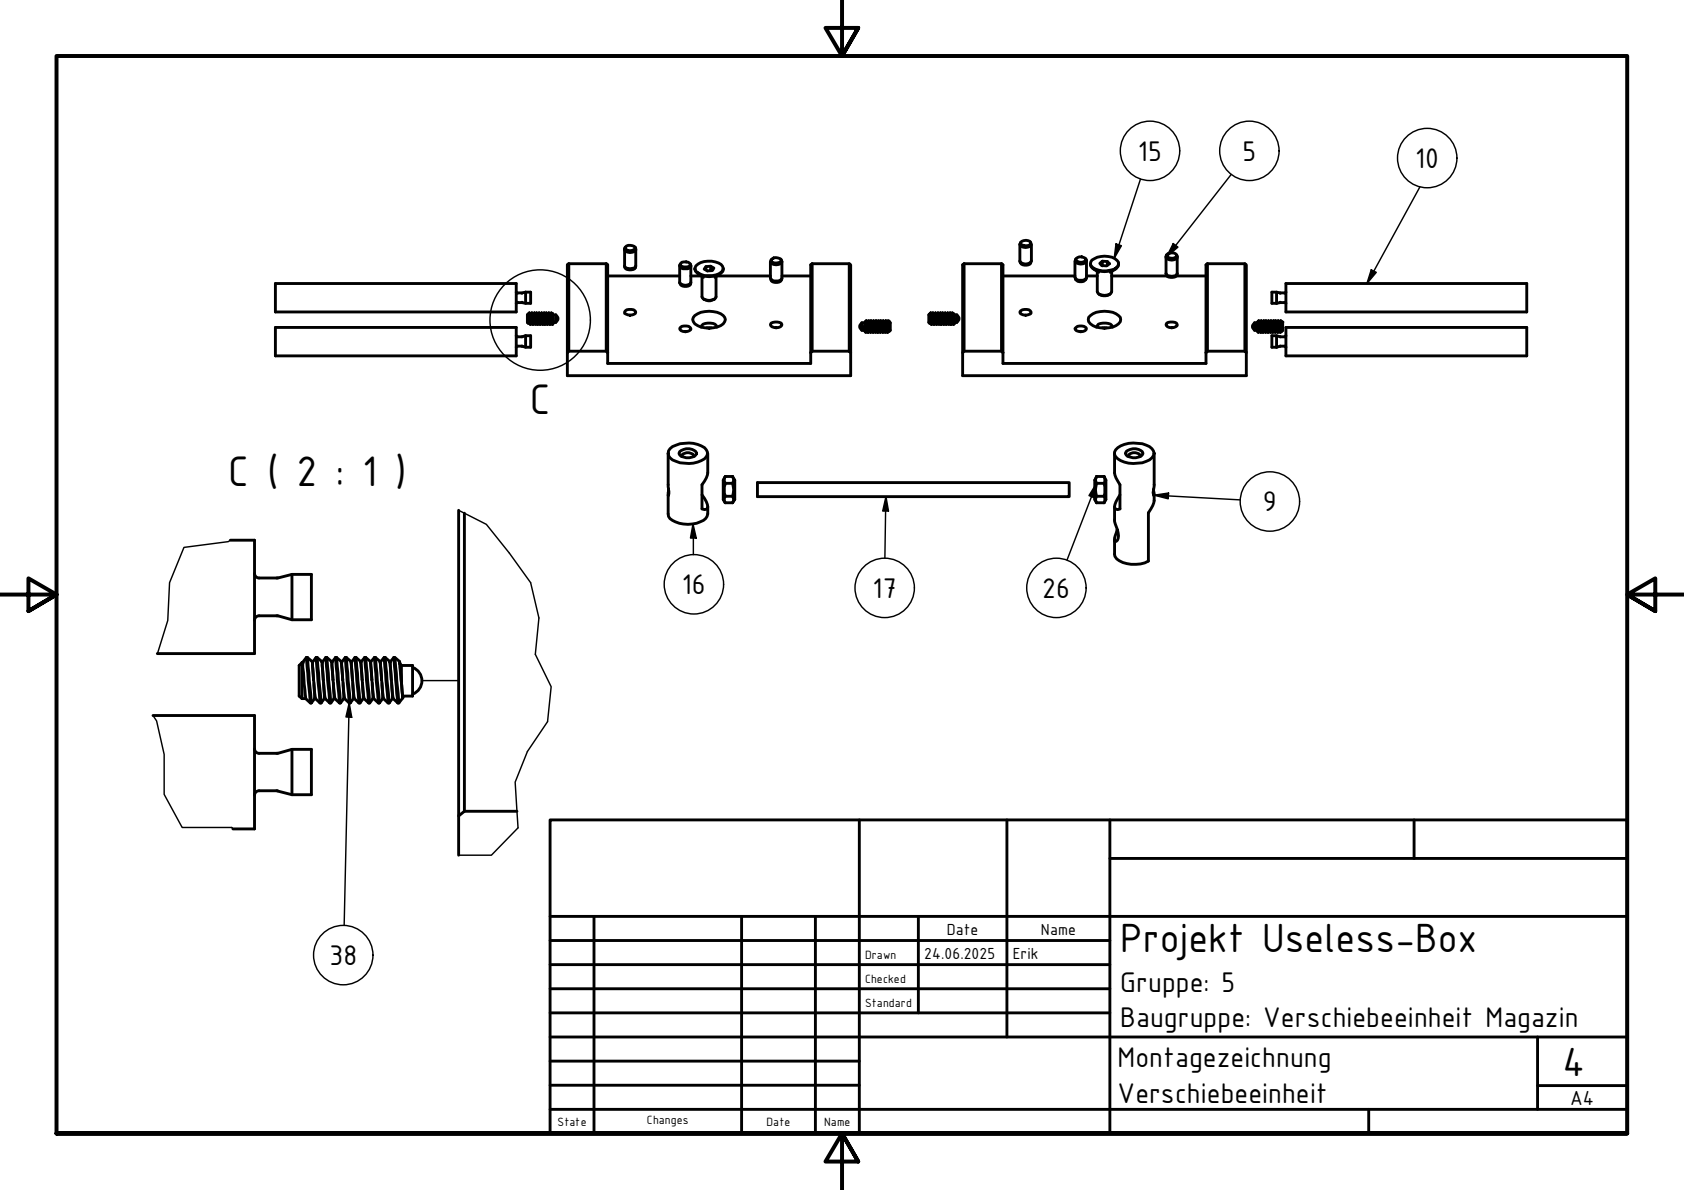
[picture p127: page 8]
State; Changes; Date; Name; Drawn; Checked; Standard; Erik; Projekt Useless-Box

Gruppe: 5
Baugruppe: Verschiebeeinheit Magazin
Montagezeichnung
Verschiebeeinheit

BAUTEILLISTE
OBJEKT | ANZAHL | BEZEICHNUNG | BAUTEILNUMMER | NORM | ZULIEFERER | MATERIAL
S235JR ISO 4762 - m Fallmagazin Boden11 S235JR ISO 4762 - m Fallmagazin Schieber25 S235JR ISO 4762 - m Fallmagazin Zylinderanbindung19
ührungsstange410 | ISO 4762 - m Fallmagazin F | S355J2(+N)
StahlAutodesk
| | | | | Inc.

DIN 7991DIN 7991 - M5x12Senkkopfschraube215

S235JR ISO 4762 - m Fallmagazin Schieberanbindung

116

S235JR ISO 4762 - m Fallmagazin Verbindungsstange

117

StahlAutodesk
Inc.

ISO 4762ISO 4762 - M6 x 12Zylinderkopfschraube227

Stahl, gehärtetWuerth Wuerth 5099201004Wuerth Federndes Druckstueck Kugel

438

## Parallel dazu zweites Magazin montieren

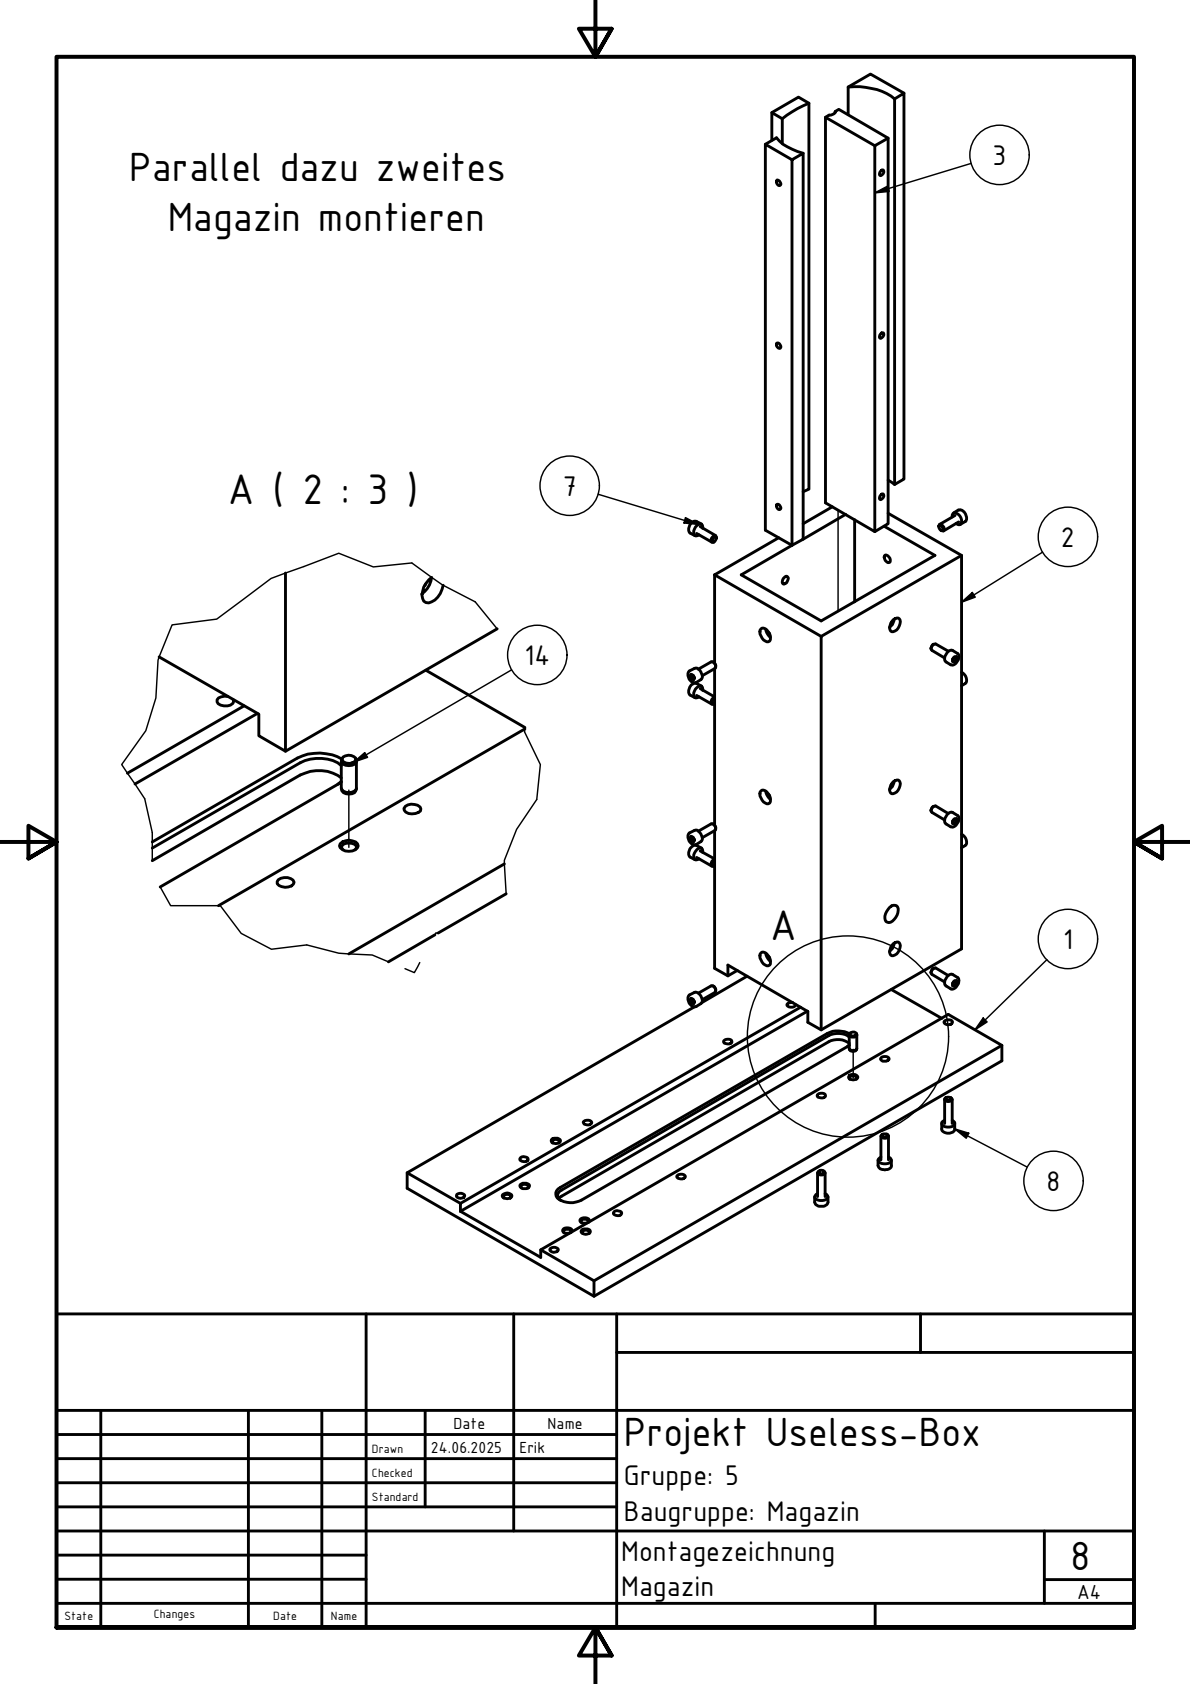
[picture p128: page 10]
State; Changes; Date; Name; Montagezeichnung Magazin

Date | Name | Projekt Useless-Box Gruppe: 5 Baugruppe: Magazin

Drawn | 24.06.2025 | Erik

Checked

Standard

BAUTEILLISTE
OBJEKT | ANZAHL | BEZEICHNUNG | BAUTEILNUMMER | NORM | ZULIEFERER | MATERIAL
S235JR ISO 4762 - m Fallmagazin Boden11 S235JR ISO 4762 - m Fallmagazin Wandung22 Edelstahl, 440CAutodesk
| | | | | Inc.
47 | ISO 4762 - mISO 4762 - M4 x 12Zylinderkopfschraube2

Edelstahl, 440CAutodesk
Inc.

ISO 4762ISO 4762 - M4 x 16Zylinderkopfschraube128

Edelstahl,
austenitisch

Autodesk
Inc.

DIN EN ISO
2338

ISO 2338 - 4 m6 x 10Zylinderstift 4 mm614

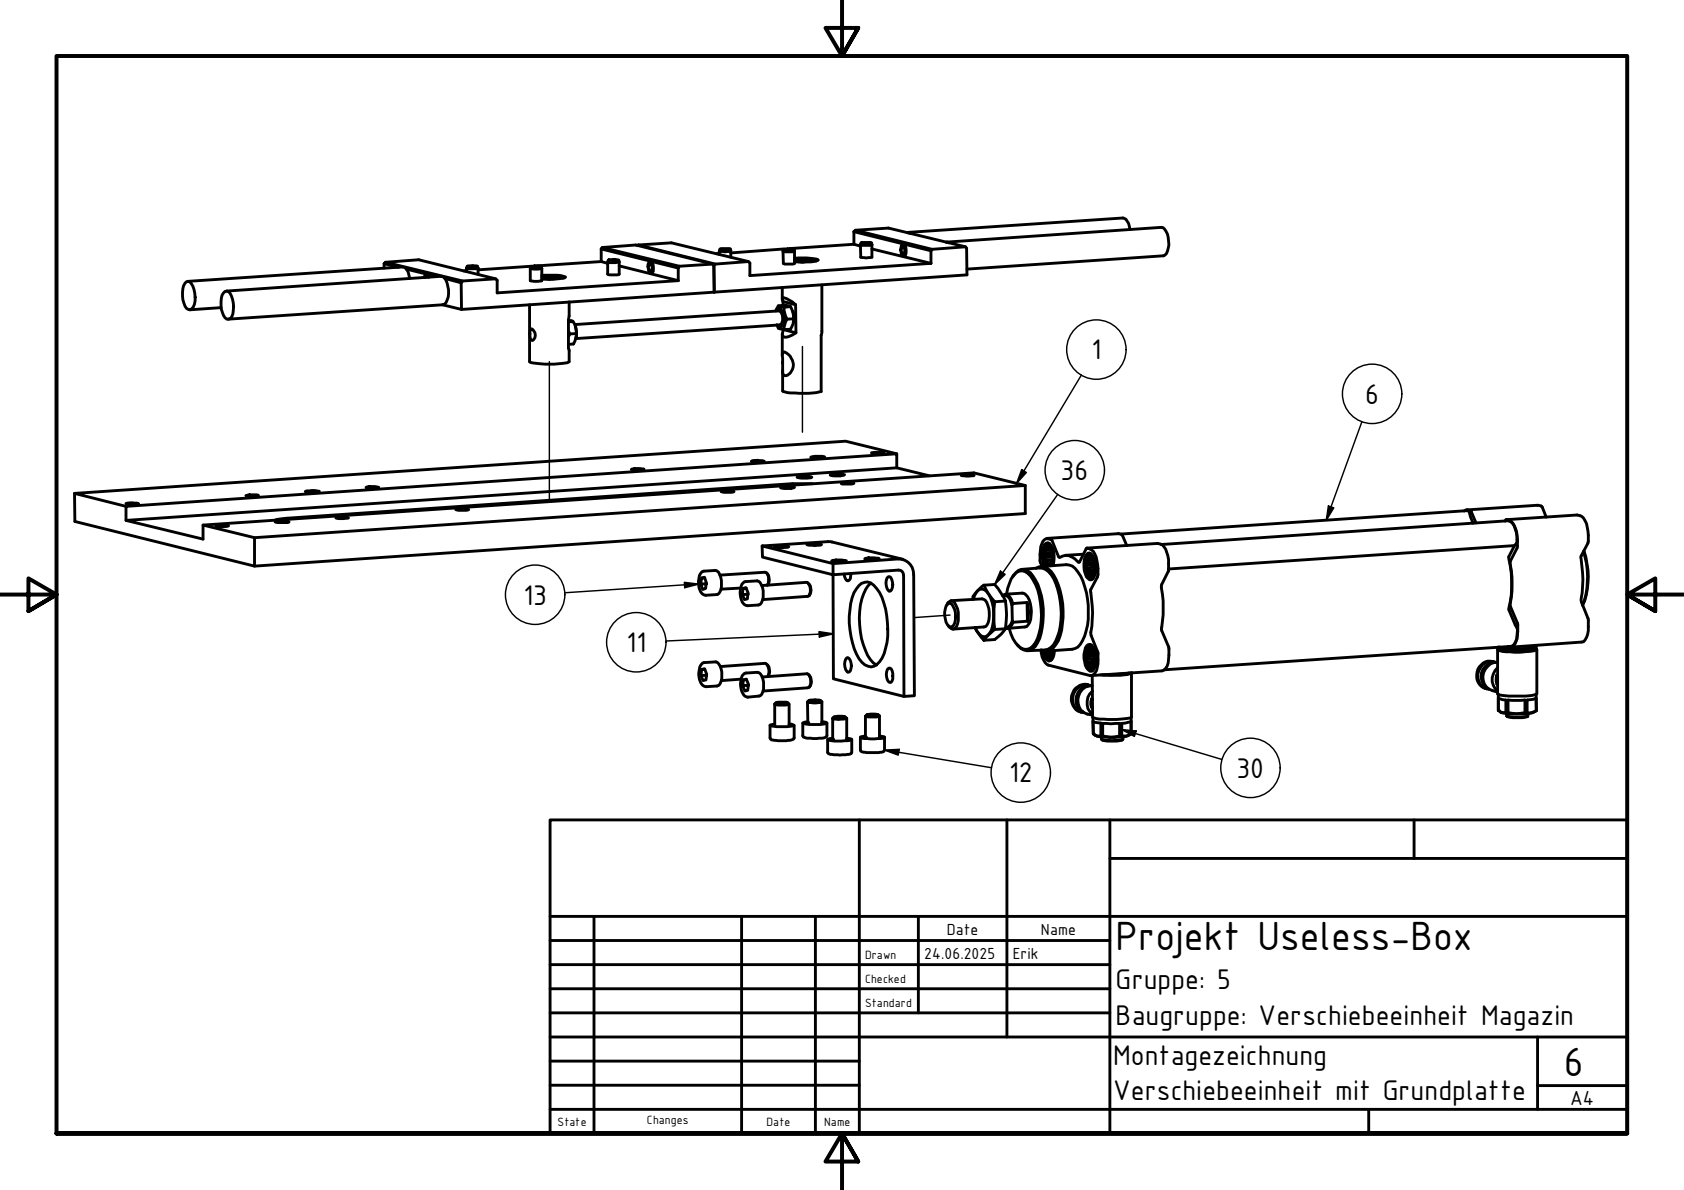
[picture p129: page 12]
State; Changes; Date; Name

Date | Name | Projekt Useless-Box Gruppe: 5 Baugruppe: Verschiebeeinheit Magazin

Drawn | 24.06.2025 | Erik

Checked

Standard

Montagezeichnung
Verschiebeeinheit mit Grundplatte

BAUTEILLISTE
OBJEKT | ANZAHL | BEZEICHNUNG | BAUTEILNUMMER | NORM | ZULIEFERER | MATERIAL
AW-6061FESTO DSBC-32-100-PPVA-N3-
| | | --(0)

Zweiwegezylinder16

S235JR Fallmagazin Zylinderhalter111 Edelstahl, 440CAutodesk
Inc.

ISO 4762ISO 4762 - M5 x 8Zylinderkopfschraube412

Edelstahl, 440CAutodesk
Inc.

ISO 4762ISO 4762 - M5 x 20Zylinderkopfschraube413

ückschlagventil430 | AW-6061FESTO GRLA-1/8-QS-4-DDrosselr
StahlAutodesk
Inc.

DIN 439DIN-439-B - M10x1_25Sechskantmutter M10136

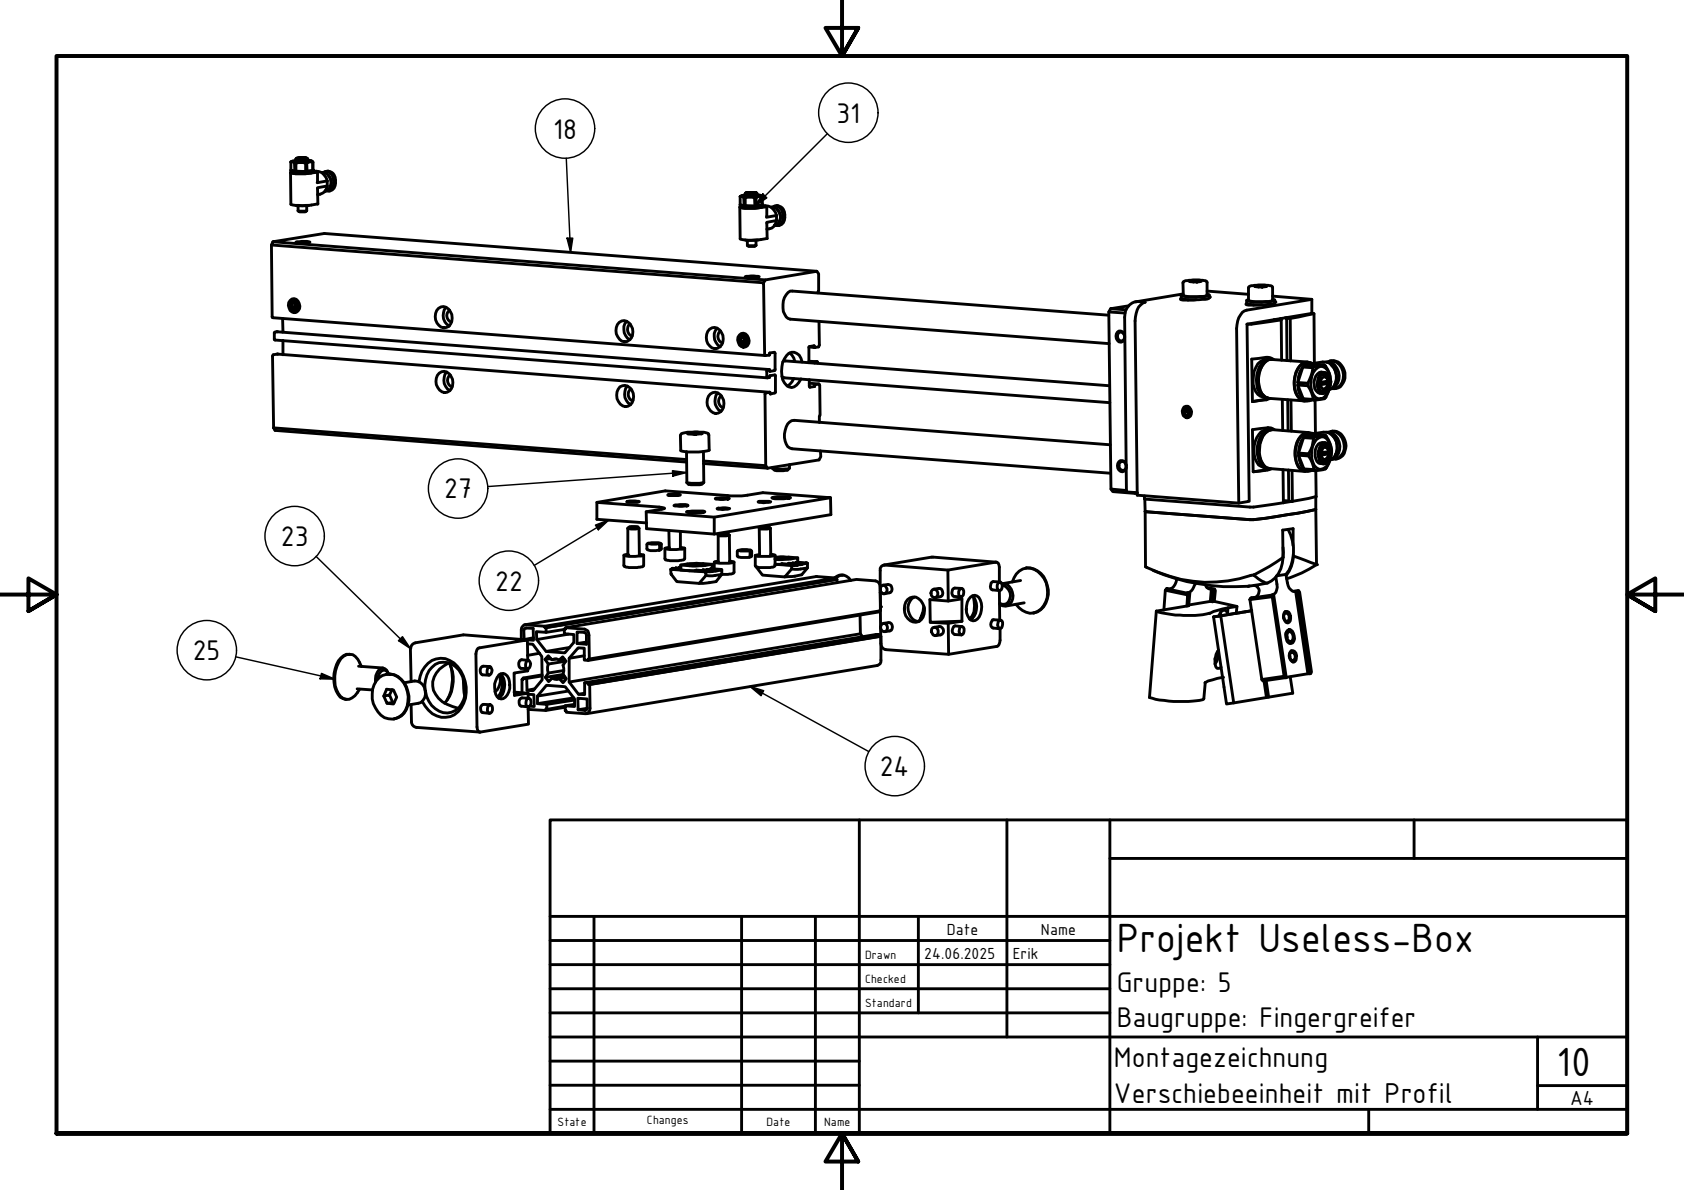
[picture p130: page 14]
State; Changes; Date; Name; Drawn; Checked; Standard; Erik

Projekt Useless-Box
Gruppe: 5
Baugruppe: Fingergreifer
Montagezeichnung
Verschiebeeinheit mit Profil

BAUTEILLISTE
OBJEKT | ANZAHL | BEZEICHNUNG | BAUTEILNUMMER | NORM | ZULIEFERER | MATERIAL
AW-6061FESTO DFM-16-150-B-P-A-KF---(0)

Zweiwegezylinder mit Führung118

S235JR ISO 4762 - m Halterung Fuehrungszylinder122
ück | S235JRRexroth Rexroth 30x30 WuerfelVerbindungsst
Rexrothprofil

223

mm124 | AW-6061 Rexroth 30x30 160Rexroth Profil 30x30 160
StahlAutodesk
Inc.

DIN 7991DIN 7991 - M8x16Senkkopfschraube425

StahlAutodesk
Inc.

ISO 4762ISO 4762 - M6 x 12Zylinderkopfschraube227

ückschlagventil231 | AW-6061FESTO GRLZ-M3-QS-3Drosselr

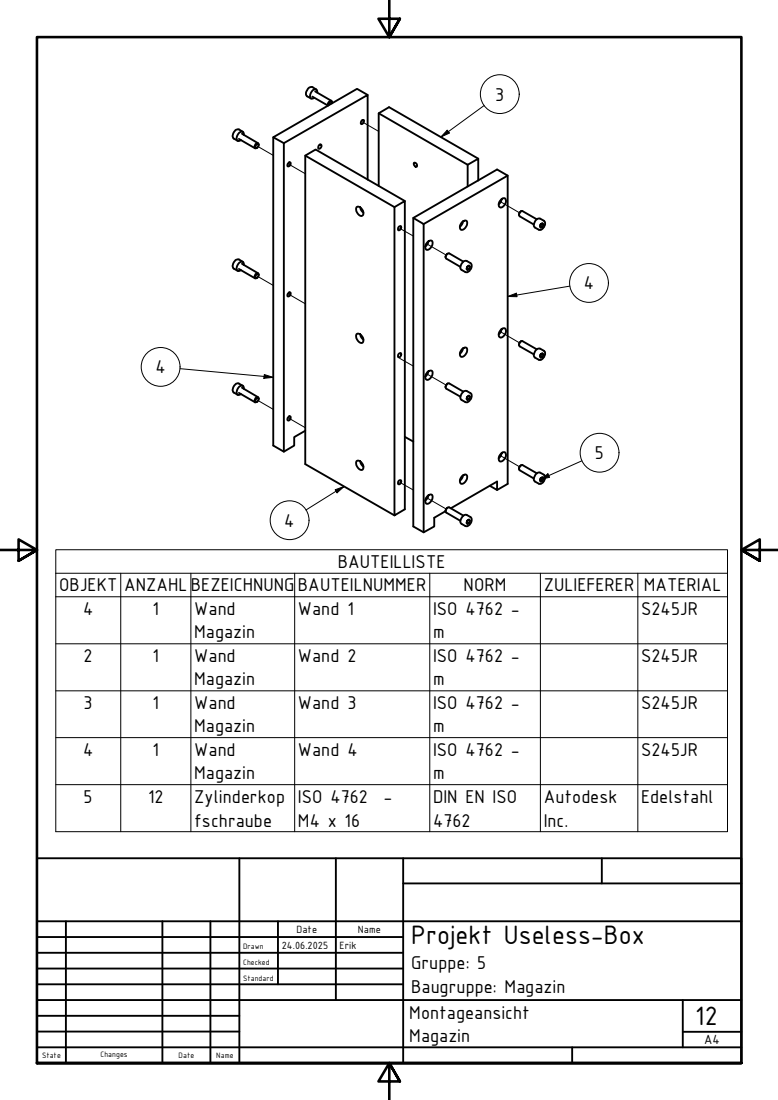
[picture p131: page 16]
BAUTEILLISTE; OBJEKT; ANZAHL BEZEICHNUNG BAUTEILNUMMER; NORM; ZULIEFERER; MATERIAL; S245JR ISO 4762 - m; Wand 1Wand Magazin; Wand 2Wand Magazin; Wand 3Wand Magazin; Wand 4Wand Magazin; EdelstahlAutodesk Inc.; DIN EN ISO 4762; ISO 4762 - M4 x 16; Zylinderkop fschraube; State; Changes; Date; Name; Montageansicht Magazin

Date | Name | Projekt Useless-Box Gruppe: 5 Baugruppe: Magazin

Drawn | 24.06.2025 | Erik

Checked

Standard

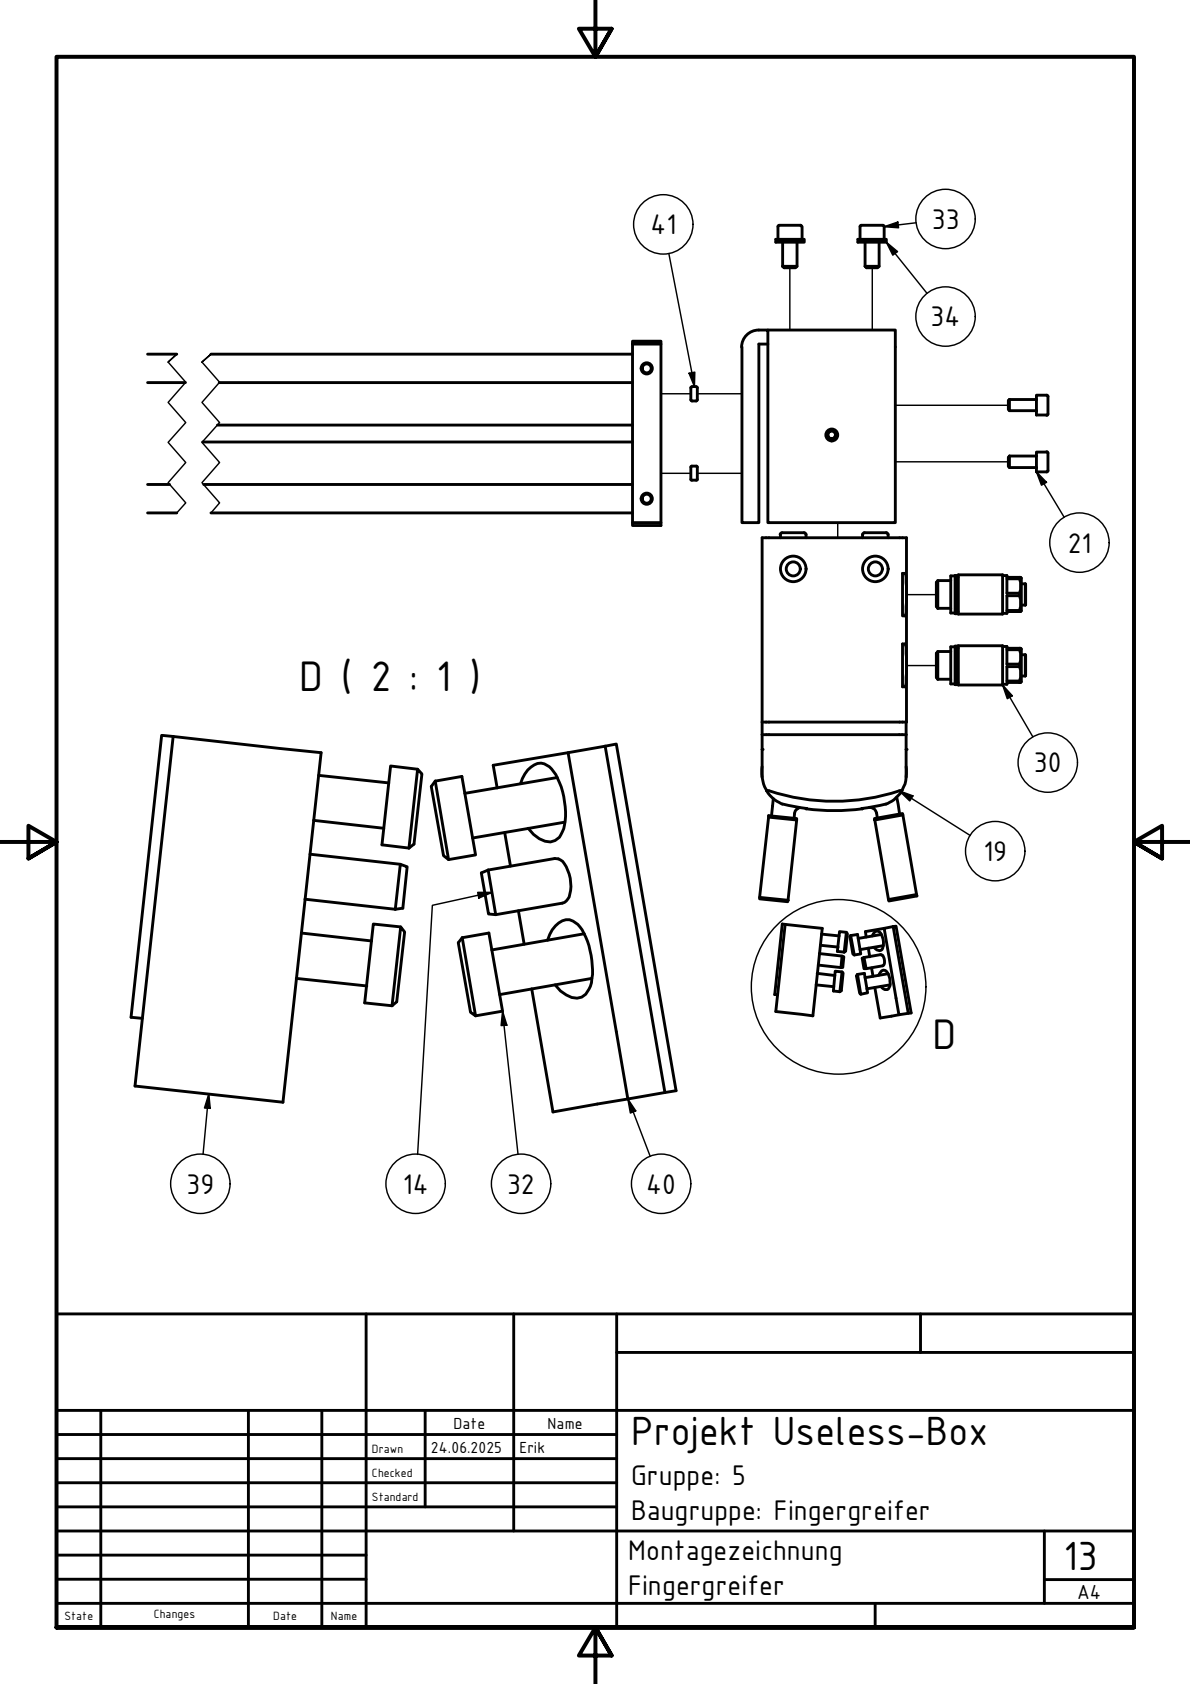
[picture p132: page 17]
State; Changes; Date; Name; Montagezeichnung Fingergreifer

Date | Name | Projekt Useless-Box Gruppe: 5 Baugruppe: Fingergreifer

Drawn | 24.06.2025 | Erik

Checked

Standard

BAUTEILLISTE
OBJEKT | ANZAHL | BEZEICHNUNG | BAUTEILNUMMER | NORM | ZULIEFERER | MATERIAL
Radialgreifer 119 | DHRS-32-A---(0) | AW-6061FESTO
Edelstahl, 440C ISO 4762 - mISO 4762 - M4 x 10 821
ückschlagventil430 | AW-6061FESTO GRLA-1/8-QS-4-DDrosselr
StahlAutodesk
| | | | | Inc.

DIN 6912DIN 6912 - M4 x 10 432

Edelstahl, 440CAutodesk
Inc.

DIN EN ISO
4762

ISO 4762 - M5 x 10 233

Stahl, WeichAutodesk
Inc.

DIN 125DIN 125 - A 5,3 234

Stahl, gehärtet ISO 4762 - m Fingergreiferbacke Links139 Stahl, gehärtet ISO 4762 - m Fingergreiferbacke Rechts140
ührungsring141 | Stahl, gehärtetFESTO 8146543 ZBH-5-B:1F
