Freezepok/CAD-Paspa/Useless Box/Dokumentation/Dokumentation JH/Screenshots/Montage_2.png

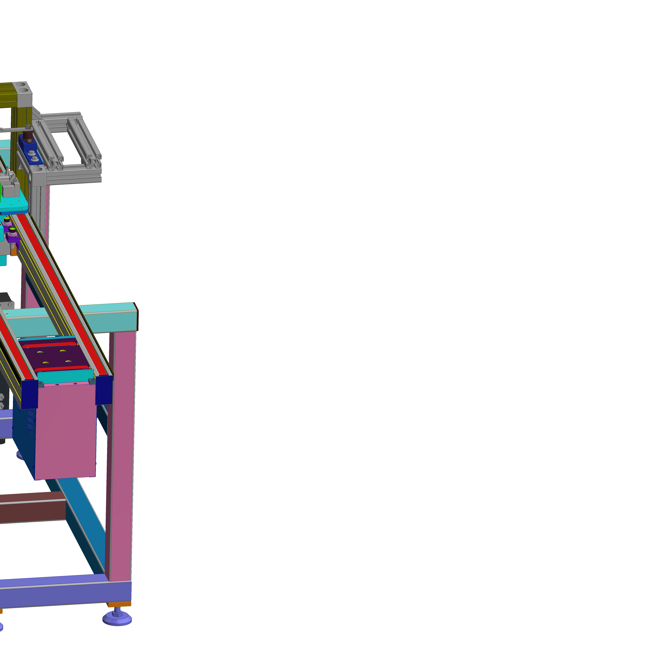
Useless Box/Dokumentation/Dokumentation JH/Screenshots/Montage_2.png
