Freezepok/CAD-Paspa/Useless Box/Dokumentation/Dokumentation JH/Screenshots/Montage_3.png

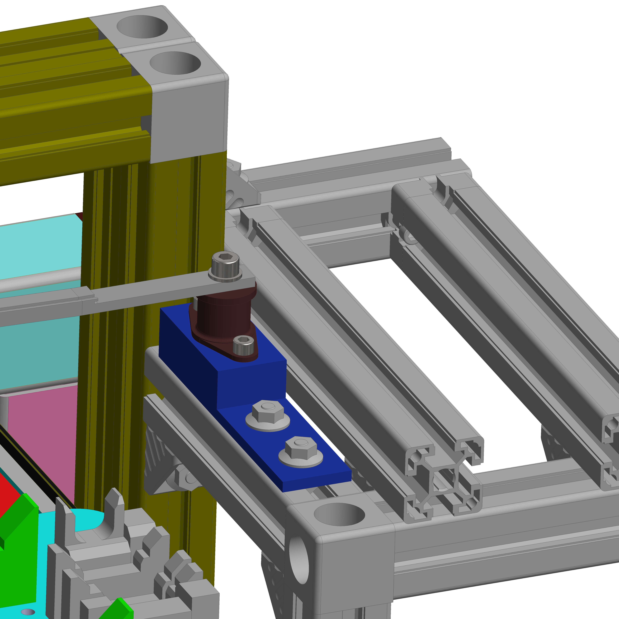
Useless Box/Dokumentation/Dokumentation JH/Screenshots/Montage_3.png
