Freezepok/CAD-Paspa/Useless Box/Dokumentation/Dokumentation JH/Screenshots/Montage_5.png

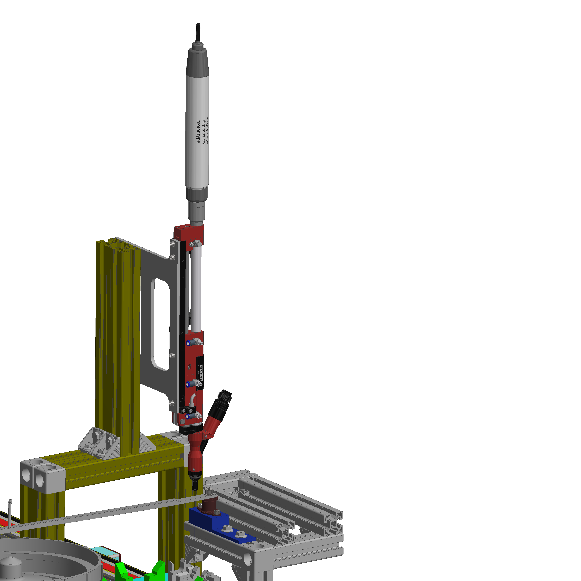
Useless Box/Dokumentation/Dokumentation JH/Screenshots/Montage_5.png
