Freezepok/CAD-Paspa/Useless Box/Dokumentation/Dokumentation JH/Screenshots/Montage_6.png

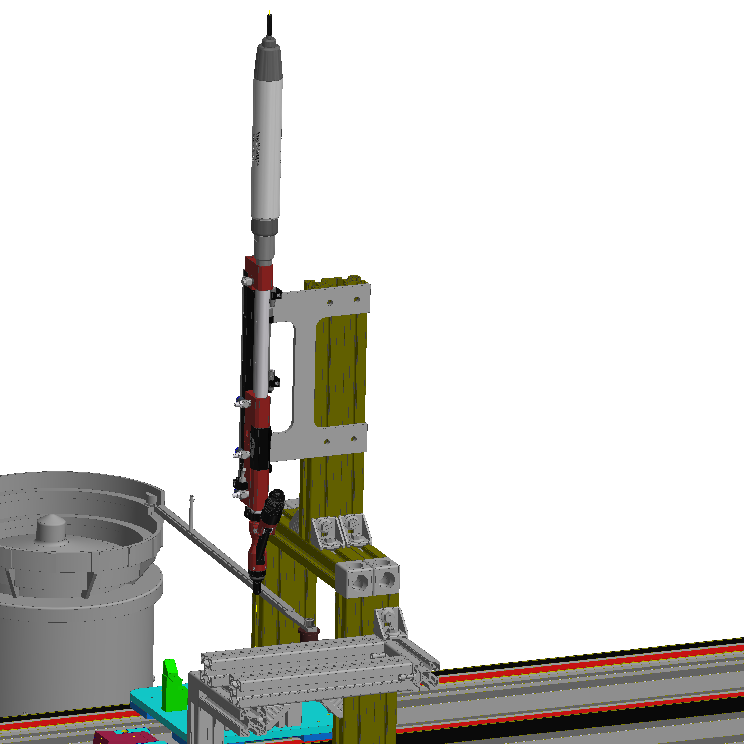
Useless Box/Dokumentation/Dokumentation JH/Screenshots/Montage_6.png
