Freezepok/CAD-Paspa/Useless Box/Dokumentation/Dokumentation JH/Screenshots/Montage_8.png

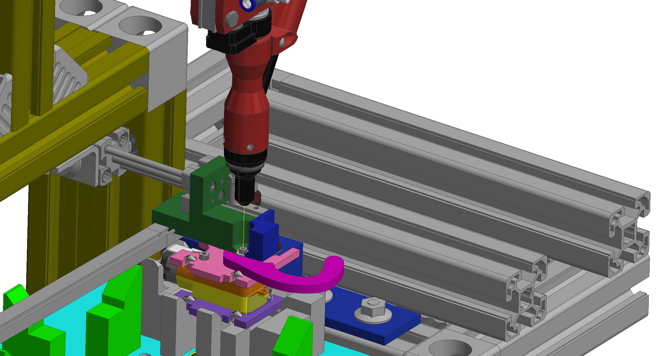
Useless Box/Dokumentation/Dokumentation JH/Screenshots/Montage_8.png
