Freezepok/CAD-Paspa/Useless Box/Dokumentation/Dokumentation JH/Screenshots/Montage_9.png

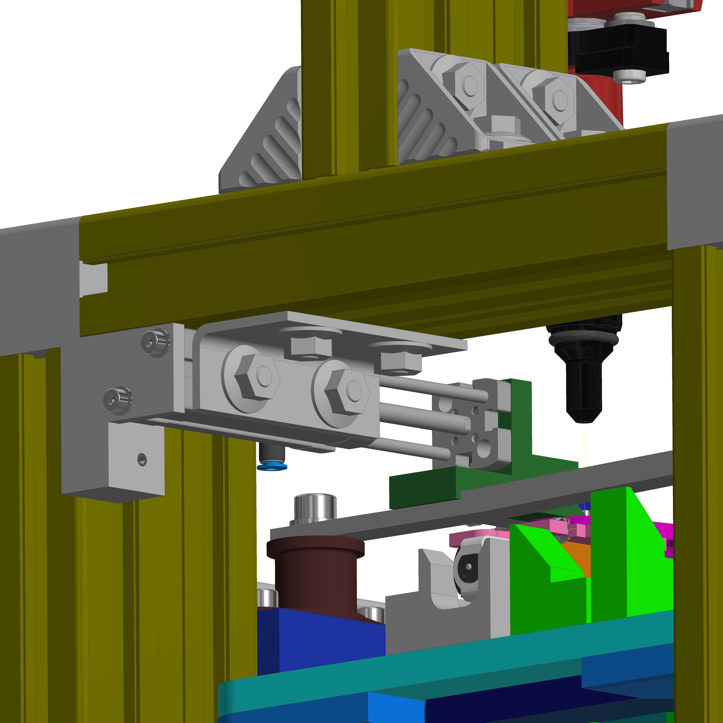
Useless Box/Dokumentation/Dokumentation JH/Screenshots/Montage_9.png
