Freezepok/CAD-Paspa/Useless Box/Dokumentation/Dokumentation JH/Screenshots/Montage_12.png

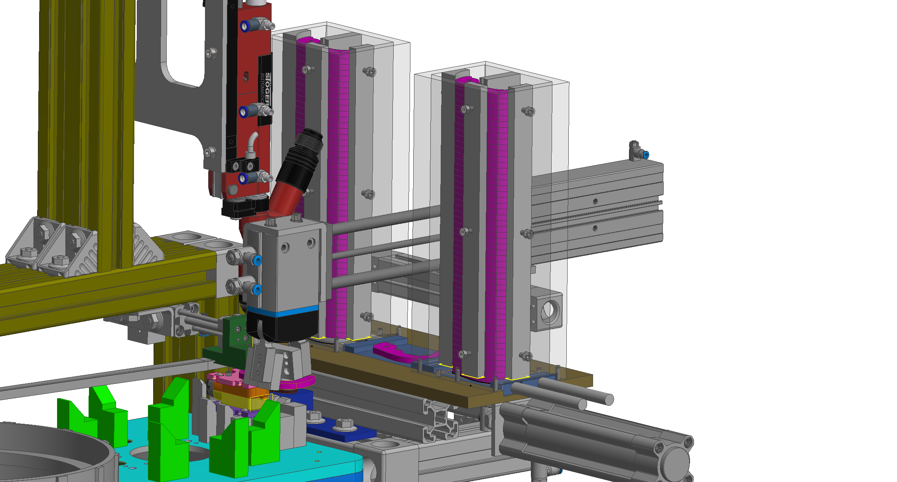
Useless Box/Dokumentation/Dokumentation JH/Screenshots/Montage_12.png
