Freezepok/CAD-Paspa/Useless Box/Dokumentation/Dokumentation JH/Screenshots/Montage_13.png

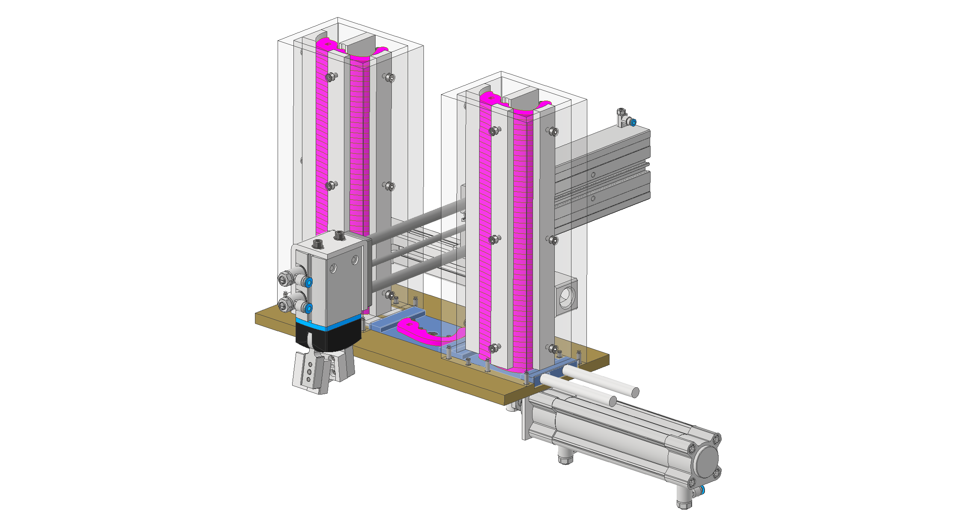
Useless Box/Dokumentation/Dokumentation JH/Screenshots/Montage_13.png
