Freezepok/CAD-Paspa/Useless Box/Dokumentation/Dokumentation JH/Screenshots/Montage_15.png

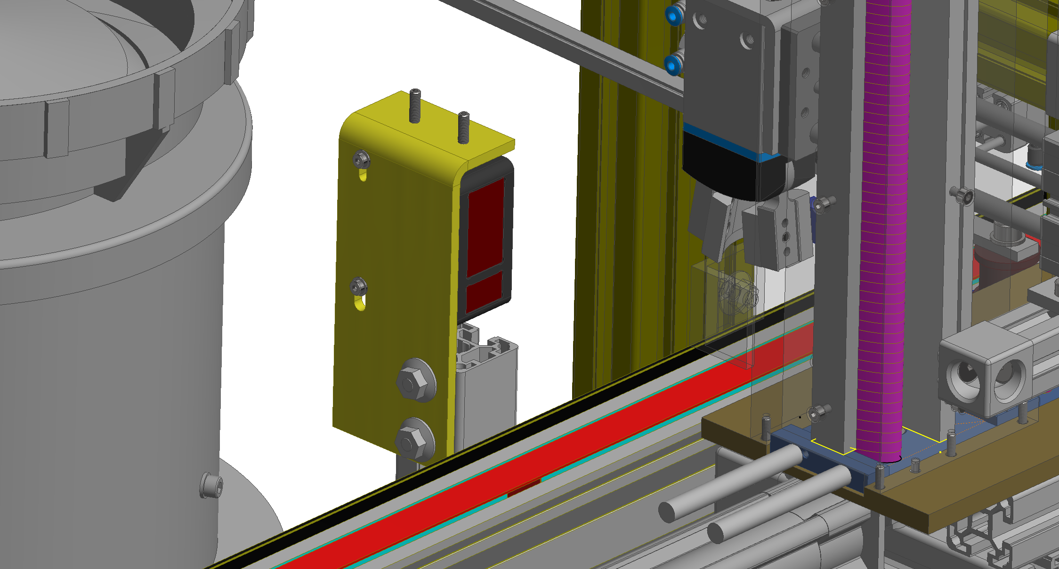
Useless Box/Dokumentation/Dokumentation JH/Screenshots/Montage_15.png
