Freezepok/CAD-Paspa/Useless Box/Dokumentation/Dokumentation JH/Screenshots/Montage_16.png

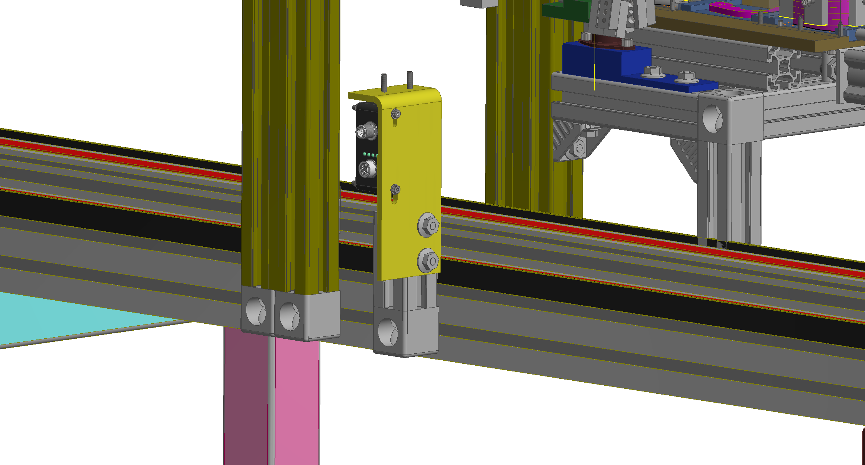
Useless Box/Dokumentation/Dokumentation JH/Screenshots/Montage_16.png
