Freezepok/CAD-Paspa/Useless Box/Zeichnungen FINAL/Montagezeichnungen A3 hochkant.pdf

F

G

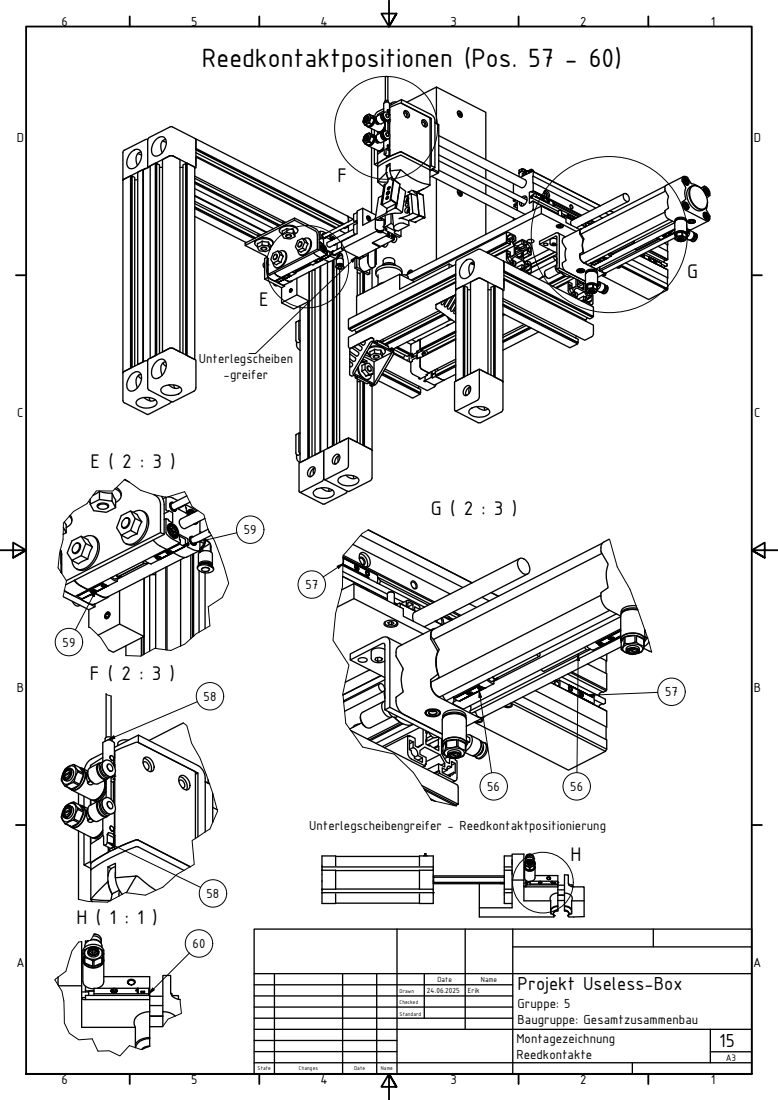
[picture p143: page 1]
State; Changes; Date; Name; Drawn; Checked; Standard; Erik; Unterlegscheibengreifer - Reedkontaktpositionierung; Reedkontaktpositionen (Pos. 57 - 60); Unterlegscheiben -greifer

Projekt Useless-Box
Gruppe: 5
Baugruppe: Gesamtzusammenbau
Montagezeichnung
Reedkontakte

# Empfohlene Positionen der Leitungs- und Pneumatikführungen (Pos. 61)

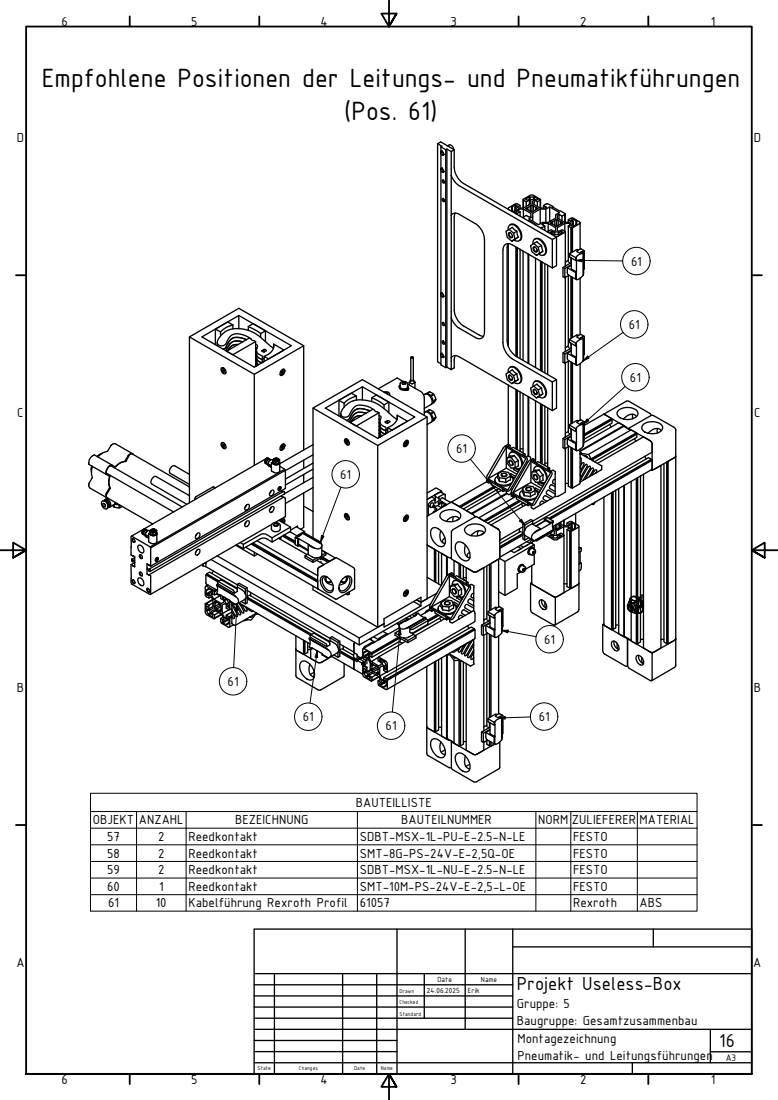
[picture p144: page 2]
BAUTEILLISTE; OBJEKT; ANZAHL; BEZEICHNUNG; BAUTEILNUMMER; NORM; ZULIEFERER MATERIAL; ührung Rexroth Profil1061; ABSRexroth 61057Kabelf; State; Changes; Date; Name

FESTO SDBT-MSX-1L-PU-E-2.5-N-LEReedkontakt257
FESTO SMT-8G-PS-24V-E-2,5Q-OEReedkontakt258
FESTO SDBT-MSX-1L-NU-E-2.5-N-LEReedkontakt259
FESTO SMT-10M-PS-24V-E-2,5-L-OEReedkontakt160

Date | Name | Projekt Useless-Box Gruppe: 5 Baugruppe: Gesamtzusammenbau

Drawn | 24.06.2025 | Erik

Checked

Standard

Montagezeichnung
Pneumatik- und Leitungsführungen
