Freezepok/CAD-Paspa/Useless Box/Zeichnungen FINAL/Montagezeichnungen A3.pdf

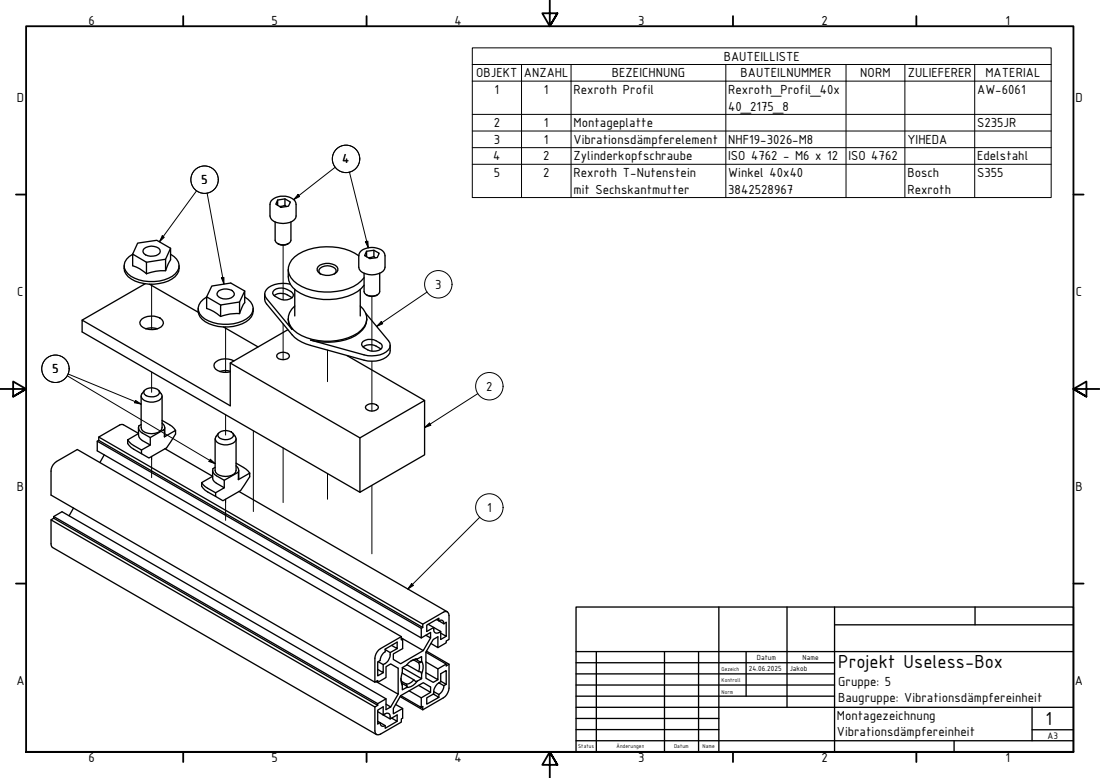
[picture p145: page 1]
BAUTEILLISTE; OBJEKT; ANZAHL; BEZEICHNUNG; BAUTEILNUMMER; NORM; ZULIEFERER; MATERIAL; AW-6061 Rexroth_Profil_40x 40_2175_8; Rexroth Profil11; S235JR Montageplatte12; ämpferelement13; YIHEDA NHF19-3026-M8Vibrationsd; raube24; Edelstahl ISO 4762ISO 4762 - M6 x 12Zylinderkopfsch; S355Bosch Rexroth; Winkel 40x40 3842528967; Rexroth T-Nutenstein mit Sechskantmutter; Status; Änderungen; Datum; Name; Gezeich; Kontroll; Norm; Jakob

Projekt Useless-Box
Gruppe: 5
Baugruppe: Vibrationsdämpfereinheit
Montagezeichnung
Vibrationsdämpfereinheit

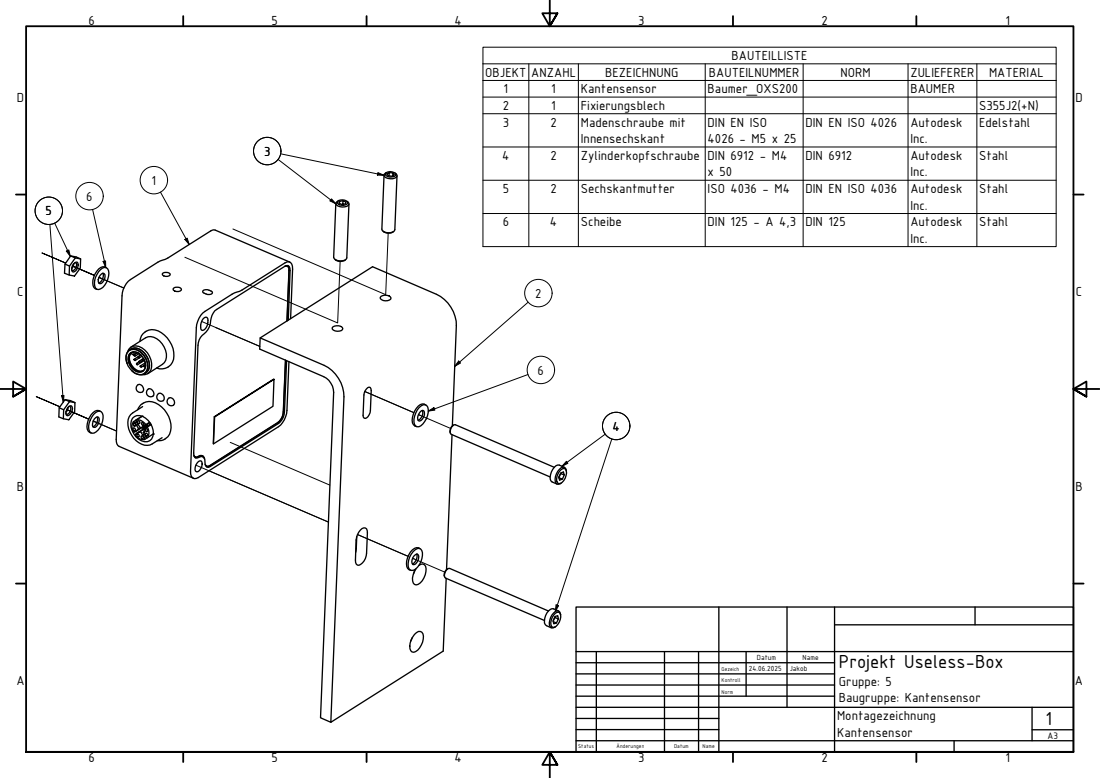
[picture p146: page 2]
BAUTEILLISTE; OBJEKT; ANZAHL; BEZEICHNUNG; BAUTEILNUMMER; NORM; ZULIEFERER; MATERIAL; BAUMER Baumer_OXS200Kantensensor11; Fixierungsblech12; EdelstahlAutodesk Inc.; Madenschraube mit Innensechskant; StahlAutodesk Inc.; Zylinderkopfschraube24; StahlAutodesk Inc. StahlAutodesk Inc.; DIN 125DIN 125 - A 4,3Scheibe46; Status; Änderungen; Datum; Name; Kantensensor

DIN EN ISO 4026DIN EN ISO
DIN 6912DIN 6912 - M4

DIN EN ISO 4036ISO 4036 - M4Sechskantmutter25

Datum | Name | Projekt Useless-Box Gruppe: 5 Baugruppe: Kantensensor

Gezeich | 24.06.2025 | Jakob

Kontroll

Norm

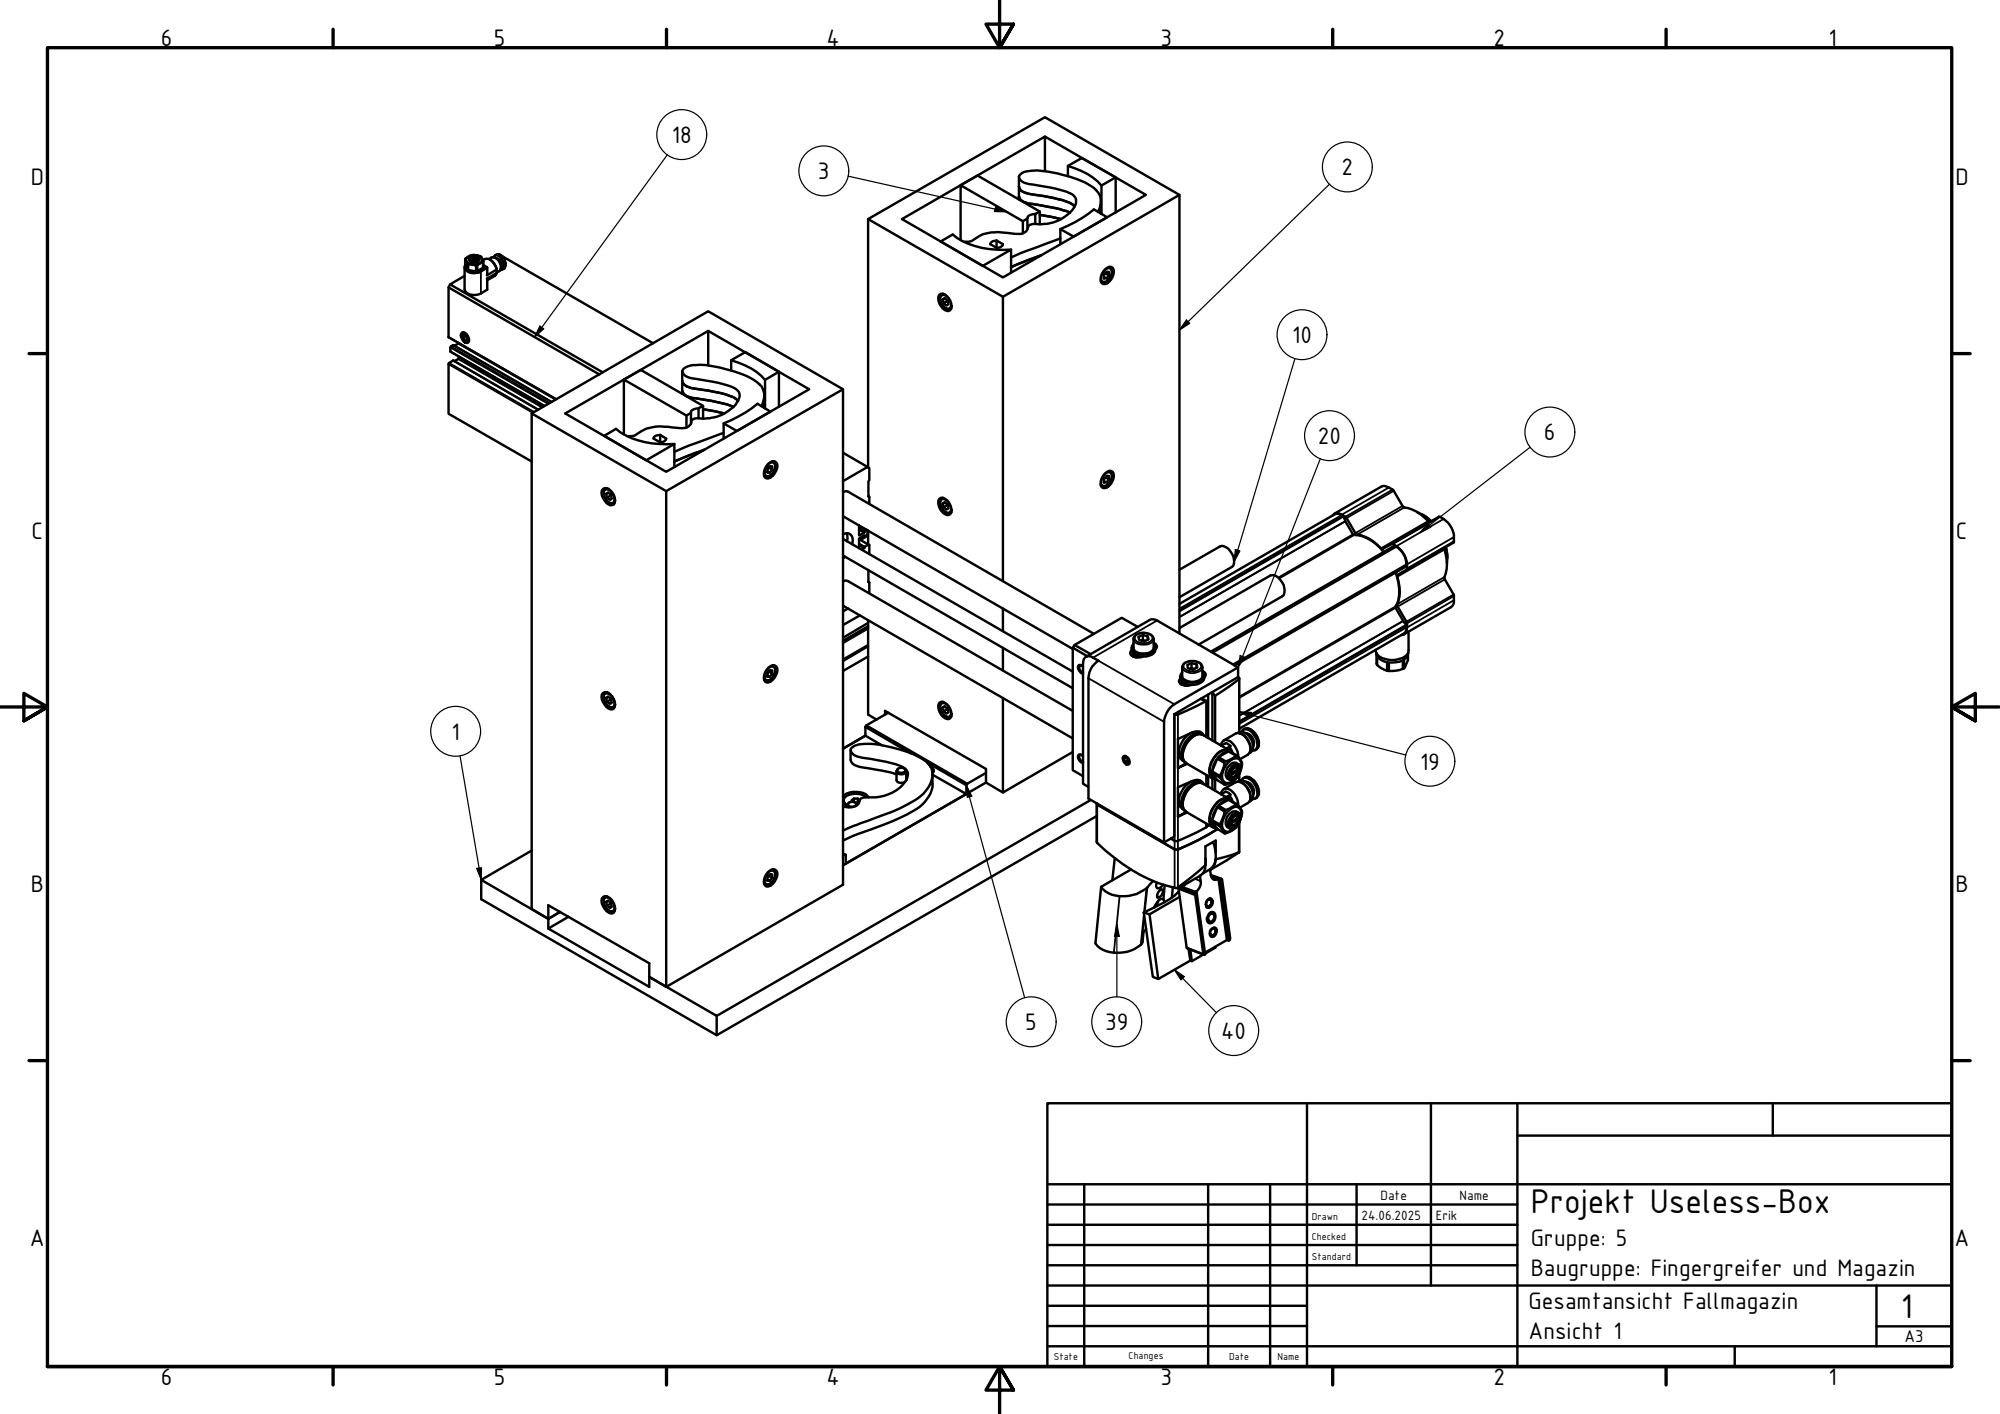
[picture p147: page 3]
State; Changes; Date; Name; Drawn; Checked; Standard; Erik

Projekt Useless-Box
Gruppe: 5
Baugruppe: Fingergreifer und Magazin
Gesamtansicht Fallmagazin
Ansicht 1

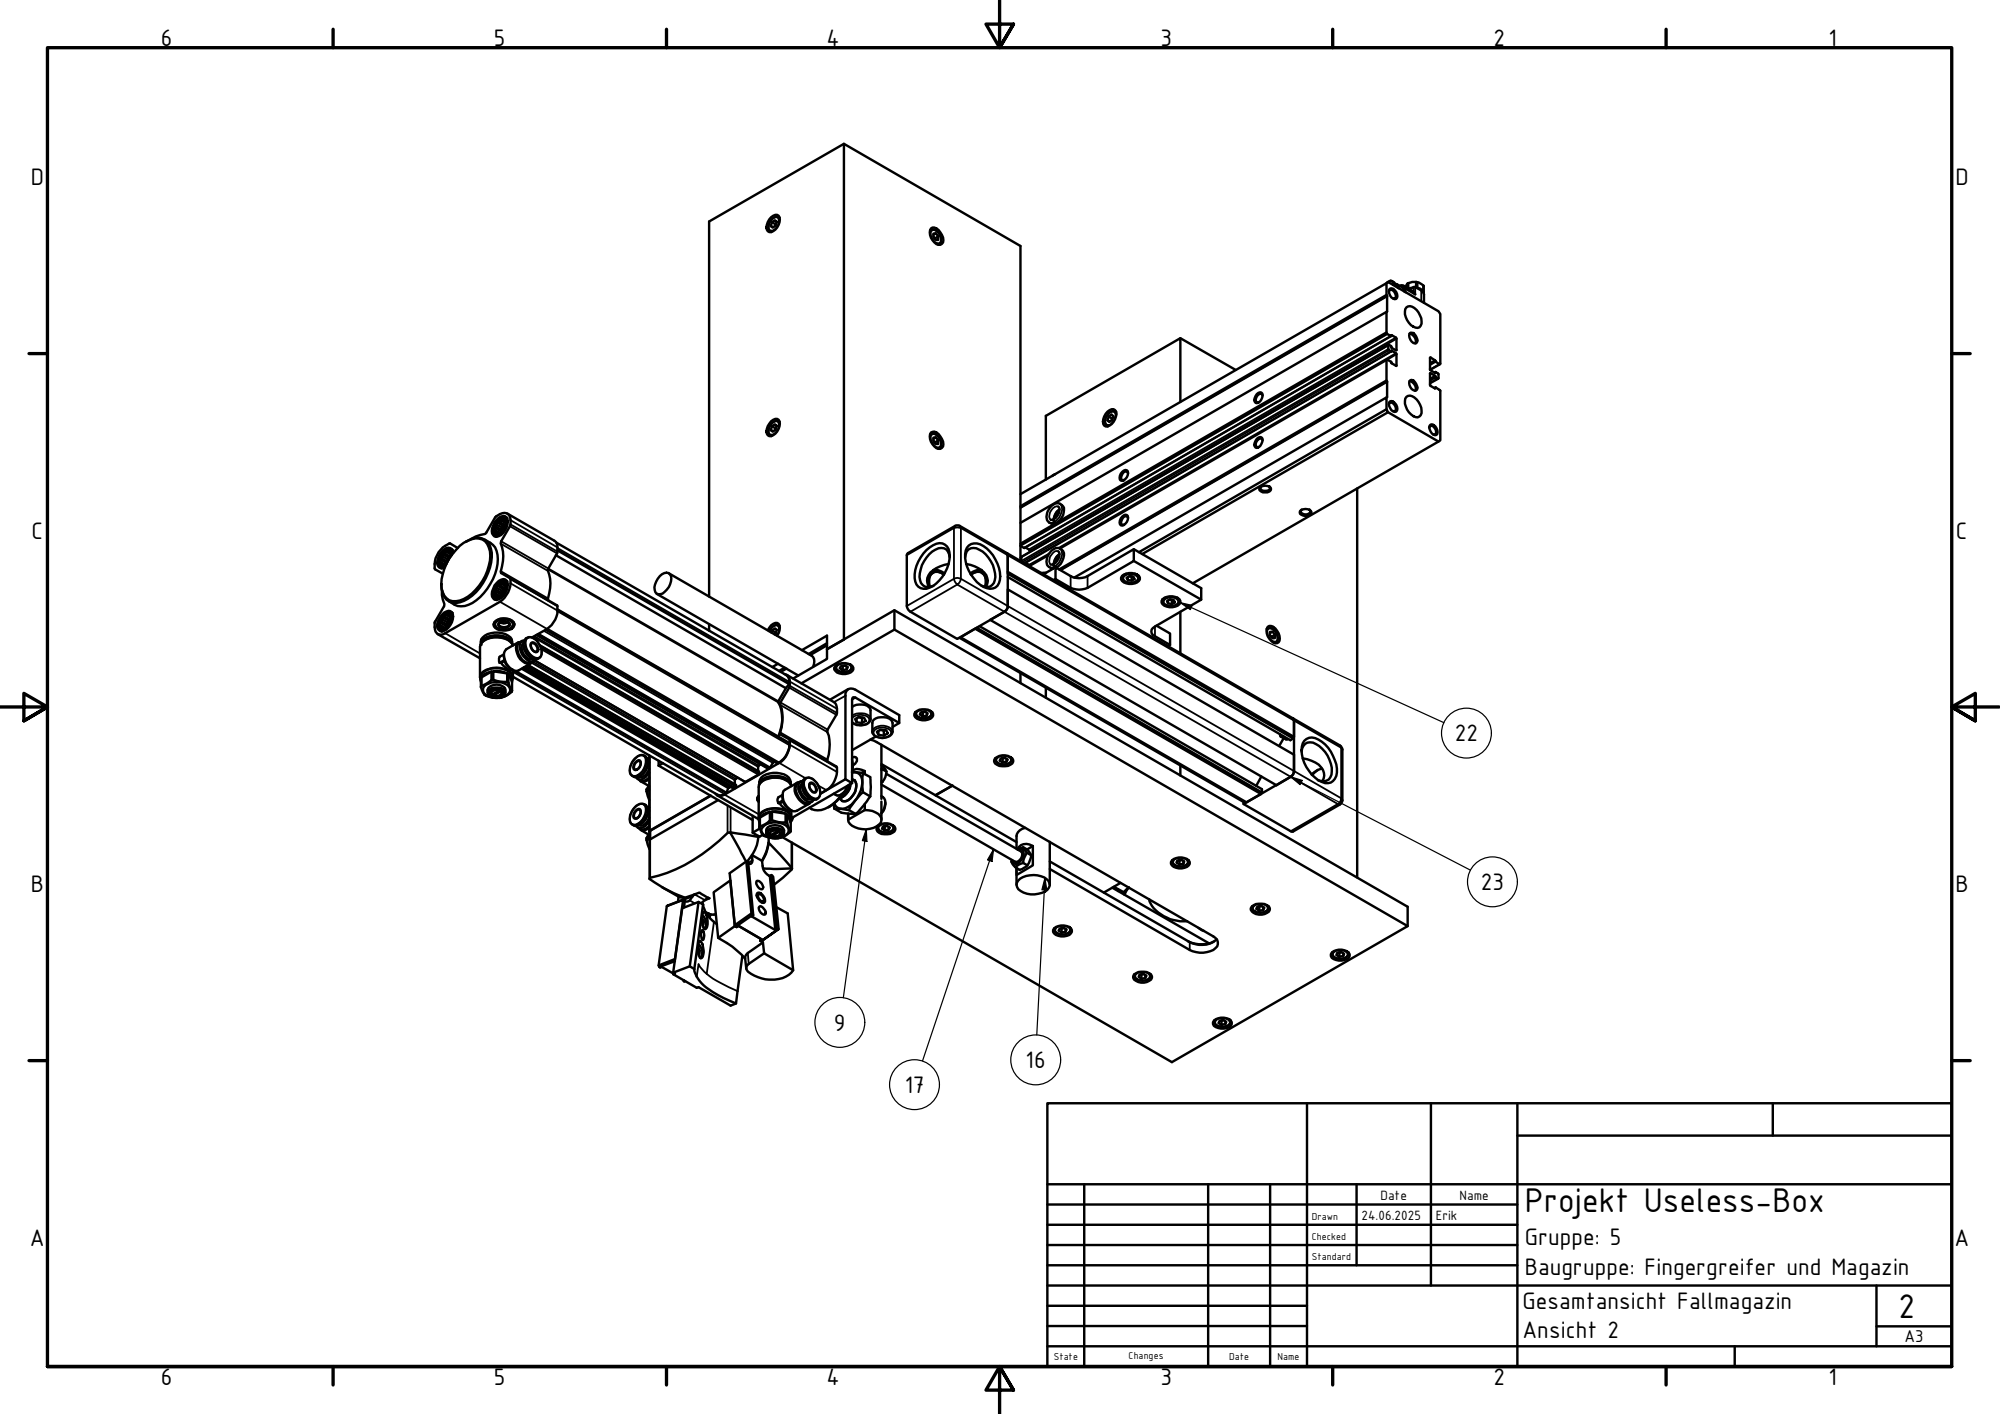
[picture p148: page 4]
Gesamtansicht Fallmagazin Ansicht 2

Date | Name | Projekt Useless-Box Gruppe: 5 Baugruppe: Fingergreifer und Magazin

Drawn | 24.06.2025 | Erik

Checked

Standard

F

G

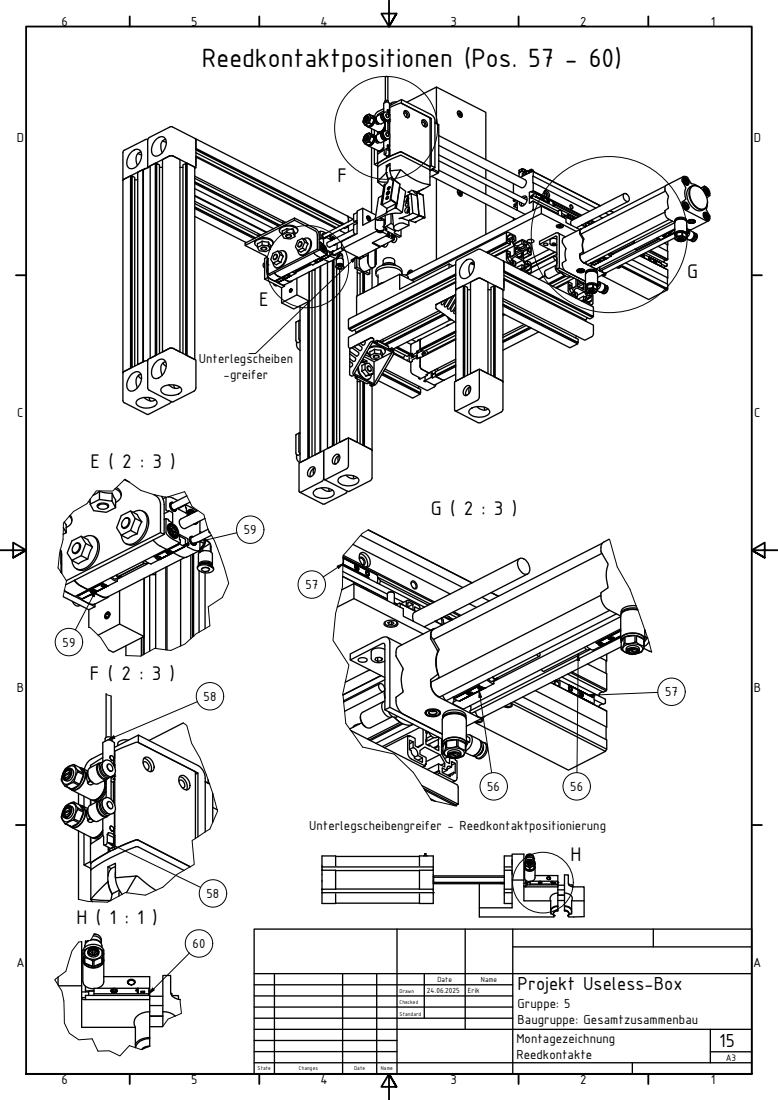
[picture p149: page 5]
Drawn; Checked; Standard; Date; Name; Erik; Unterlegscheibengreifer - Reedkontaktpositionierung; Reedkontaktpositionen (Pos. 57 - 60); Unterlegscheiben -greifer; Reedkontakte

Projekt Useless-Box
Gruppe: 5
Baugruppe: Gesamtzusammenbau

# Empfohlene Positionen der Leitungs- und Pneumatikführungen (Pos. 61)

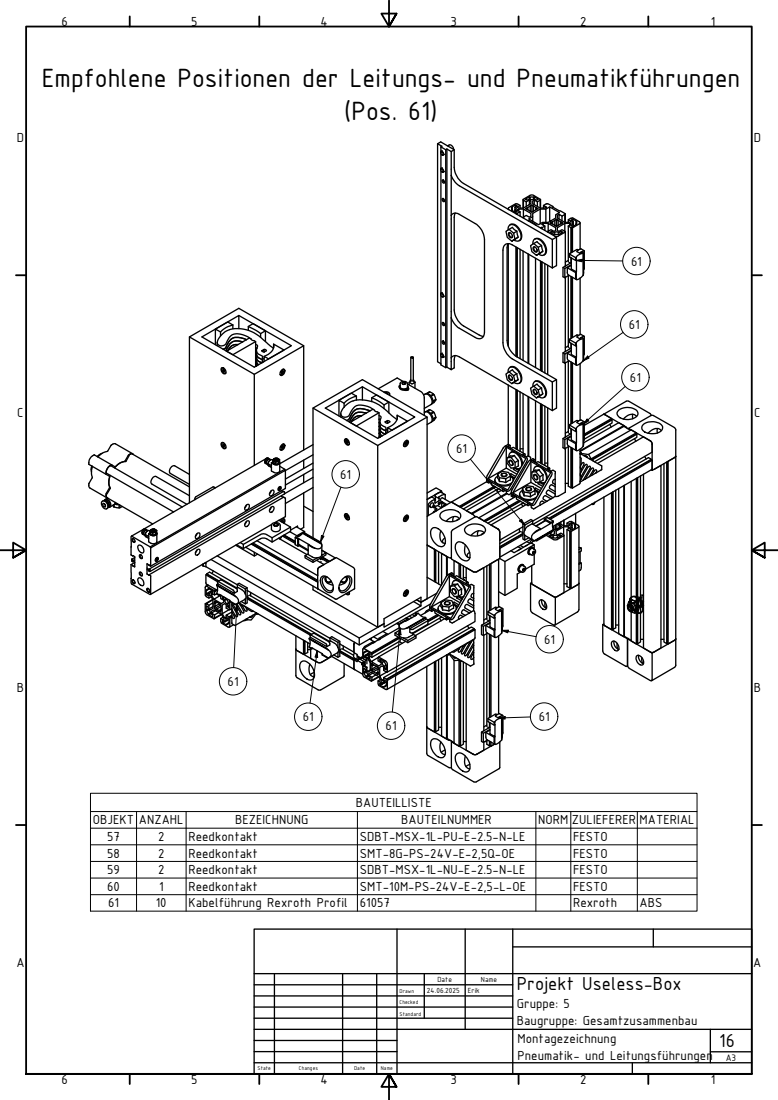
[picture p150: page 6]
BAUTEILLISTE; OBJEKT; ANZAHL; BEZEICHNUNG; BAUTEILNUMMER; NORM; ZULIEFERER MATERIAL; ührung Rexroth Profil1061; ABSRexroth 61057Kabelf

FESTO SDBT-MSX-1L-PU-E-2.5-N-LEReedkontakt257
FESTO SMT-8G-PS-24V-E-2,5Q-OEReedkontakt258
FESTO SDBT-MSX-1L-NU-E-2.5-N-LEReedkontakt259
FESTO SMT-10M-PS-24V-E-2,5-L-OEReedkontakt160

Date | Name | Projekt Useless-Box Gruppe: 5 Baugruppe: Gesamtzusammenbau

Drawn | 24.06.2025 | Erik

Checked

Standard

Pneumatik- und Leitungsführungen
