Freezepok/CAD-Paspa/Useless Box/Dokumentation/Dokumentation JH/Richtlinien/Demo-Doku.pdf

# 5 Anhang 1: Montagezeichnungen und Stücklisten

# 5 Anhang 1: Montagezeichnungen und Stücklisten

5.1 | Klemmbefestigung | Zeichnungsnummer 0010

Die Zeichnung 0010 zeigt den Gesamtzusammenbau.

# Die Stückliste enthält alle Infos zur Beschaffung der Fertigungsteile, Kauf-

teile und Normteile sowie der vorzubereitenden (Unter-)Baugruppen.

# Mit Hilfe der Positionsnummern wird ein Bezug zur zeichnerischen Dar-

stellung geschafften.

# Der Maschinentisch ist nur zur Verdeutlichung dargestellt. Er gehört nicht

zur Baugruppe und ist deshalb auch nicht auf der Stückliste aufgeführt.

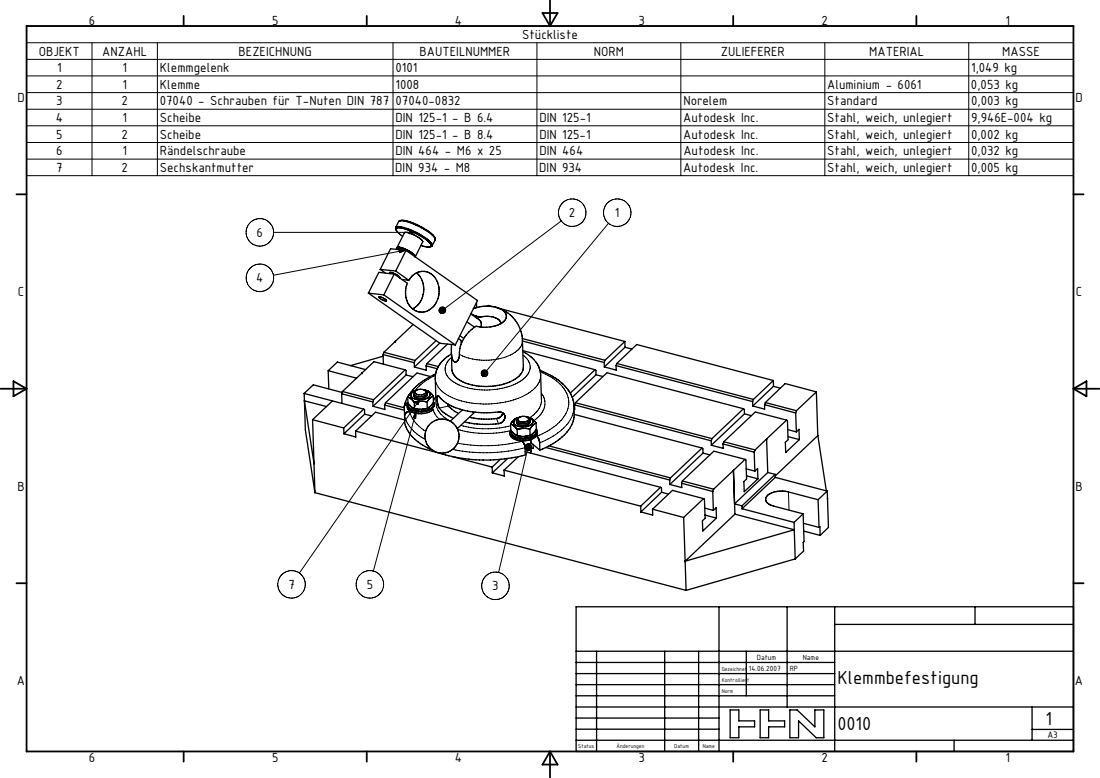
[picture p151: page 2]
Klemmbefestigung; Status; Änderungen; Datum; Name; Gezeichnet; Kontrolliert; Norm; OBJEKT; ANZAHL; BEZEICHNUNG; BAUTEILNUMMER; NORM; ZULIEFERER; MATERIAL; MASSE; Klemmgelenk

Stückliste

2 | 1 | Klemme | 1008 | | | Aluminium - 6061 | 0,053 kg
3 | 2 | 07040 - Schrauben für T-Nuten DIN 787 | 07040-0832 | | Norelem | Standard | 0,003 kg
4 | 1 | Scheibe | DIN 125-1 - B 6.4 | DIN 125-1 | Autodesk Inc. | Stahl, weich, unlegiert | 9,946E-004 kg
5 | 2 | Scheibe | DIN 125-1 - B 8.4 | DIN 125-1 | Autodesk Inc. | Stahl, weich, unlegiert | 0,002 kg
6 | 1 | Rändelschraube | DIN 464 - M6 x 25 | DIN 464 | Autodesk Inc. | Stahl, weich, unlegiert | 0,032 kg
7 | 2 | Sechskantmutter | DIN 934 - M8 | DIN 934 | Autodesk Inc. | Stahl, weich, unlegiert | 0,005 kg

5 | Anhang 1: Montagezeichnungen und Stücklisten
5.2 | Klemmgelenk | Zeichnungsnummer 0101

# Die Zeichnung 0101 besteht aus drei Blättern und zeigt die Baugruppe

Klemmgelenk.

# Auf Blatt 1 ist die Stückliste und eine Ansicht des Klemmgelenks darge-

stellt.

# Blatt 2 zeigt eine Draufsicht und eine Schnittansicht durch das Klemmgelenk. Diese Zeichnung verdeutlicht die Funktionsweise. Um eine schnelle Vorstellung der wirklichen Größe zu haben sind die Hauptmaße eingetra-

gen.

# Blatt 3 verdeutlicht den Zusammenbau mit Hilfe einer Explosionsdarstel-

lung.

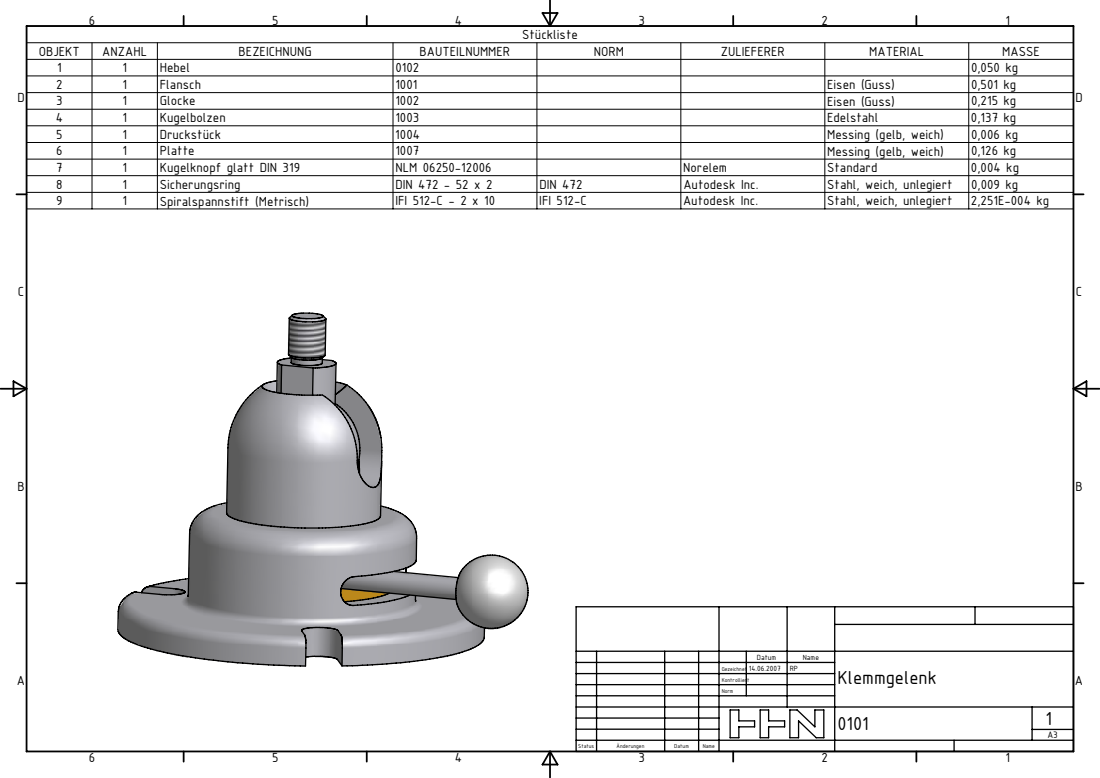
[picture p152: page 4]
Klemmgelenk; Gezeichnet; Kontrolliert; Norm; Datum; Name; OBJEKT; ANZAHL; BEZEICHNUNG; BAUTEILNUMMER; NORM; ZULIEFERER; MATERIAL; MASSE; Hebel

Stückliste

2 | 1 | Flansch | 1001 | | | Eisen (Guss) | 0,501 kg
3 | 1 | Glocke | 1002 | | | Eisen (Guss) | 0,215 kg
4 | 1 | Kugelbolzen | 1003 | | | Edelstahl | 0,137 kg
5 | 1 | Druckstück | 1004 | | | Messing (gelb, weich) | 0,006 kg
6 | 1 | Platte | 1007 | | | Messing (gelb, weich) | 0,126 kg
7 | 1 | Kugelknopf glatt DIN 319 | NLM 06250-12006 | | Norelem | Standard | 0,004 kg
8 | 1 | Sicherungsring | DIN 472 - 52 x 2 | DIN 472 | Autodesk Inc. | Stahl, weich, unlegiert | 0,009 kg
9 | 1 | Spiralspannstift (Metrisch) | IFI 512-C - 2 x 10 | IFI 512-C | Autodesk Inc. | Stahl, weich, unlegiert | 2,251E-004 kg

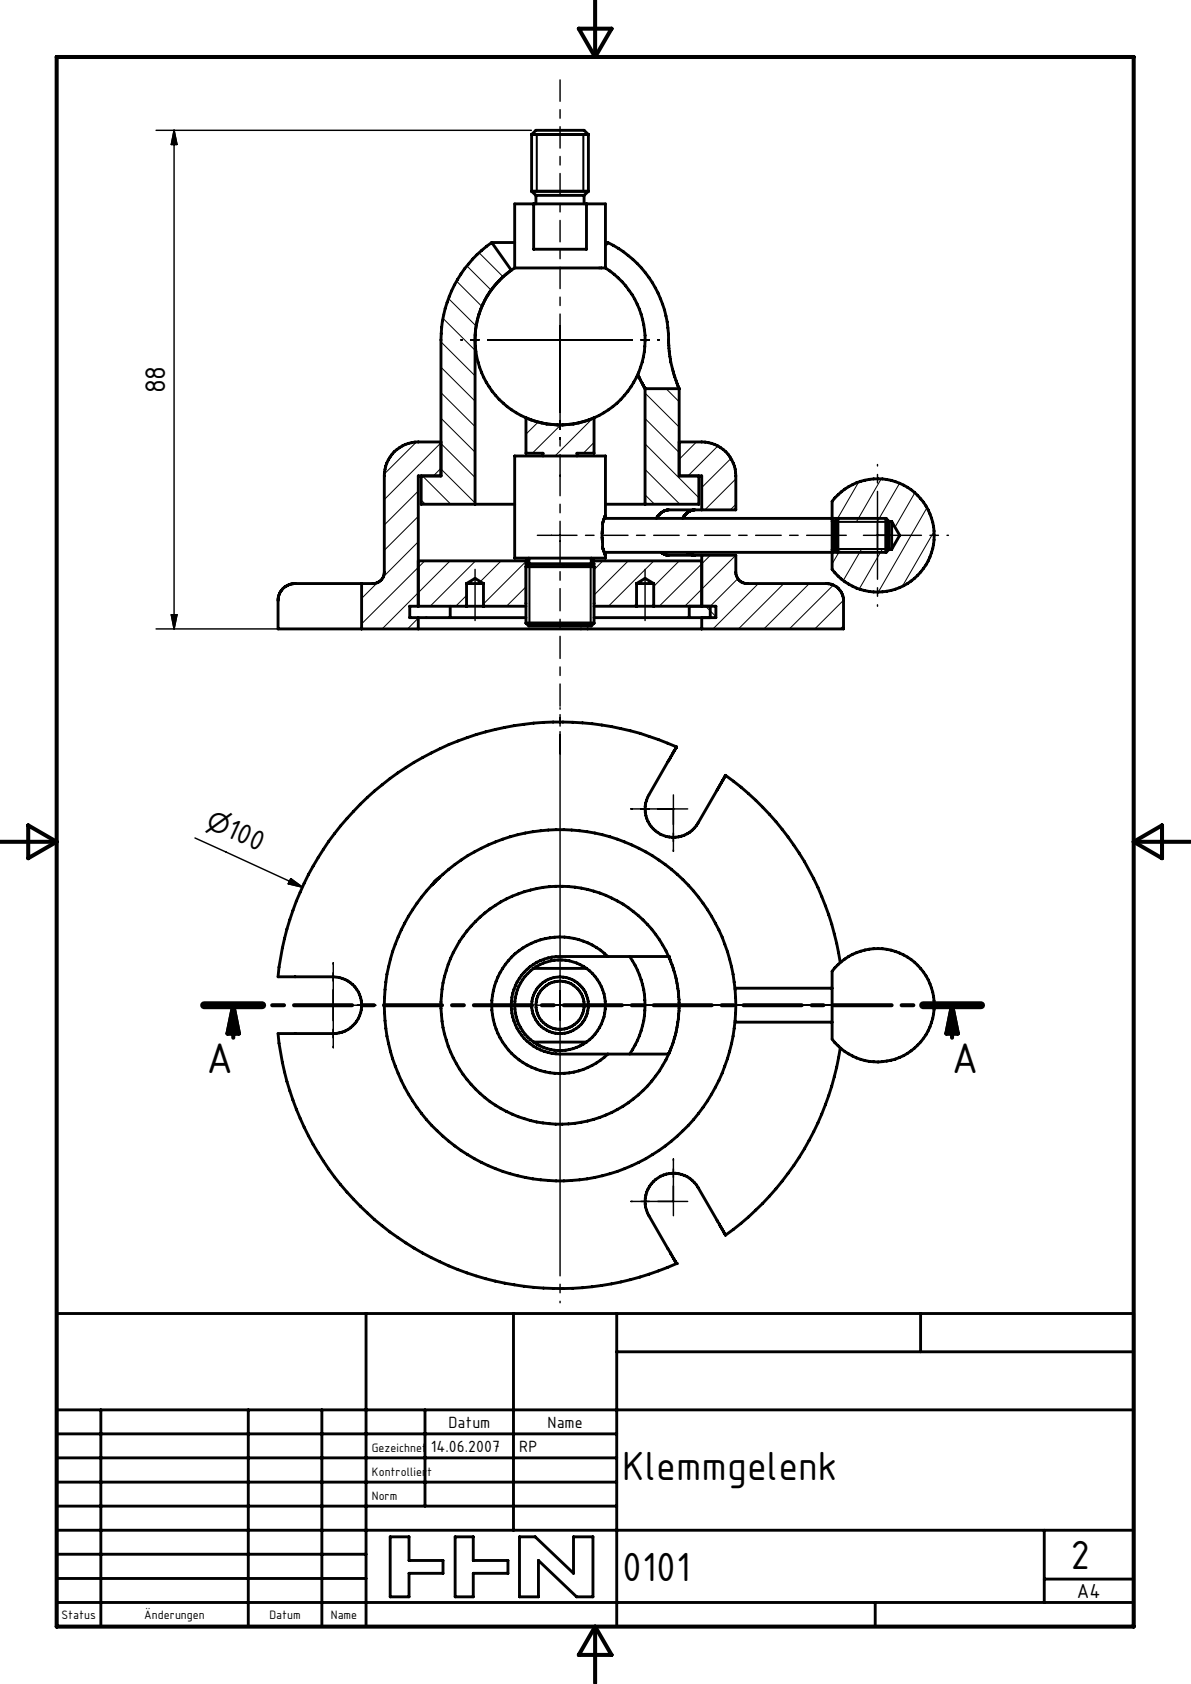
[picture p153: page 5]
Klemmgelenk; Gezeichnet; Kontrolliert; Norm; Datum; Name

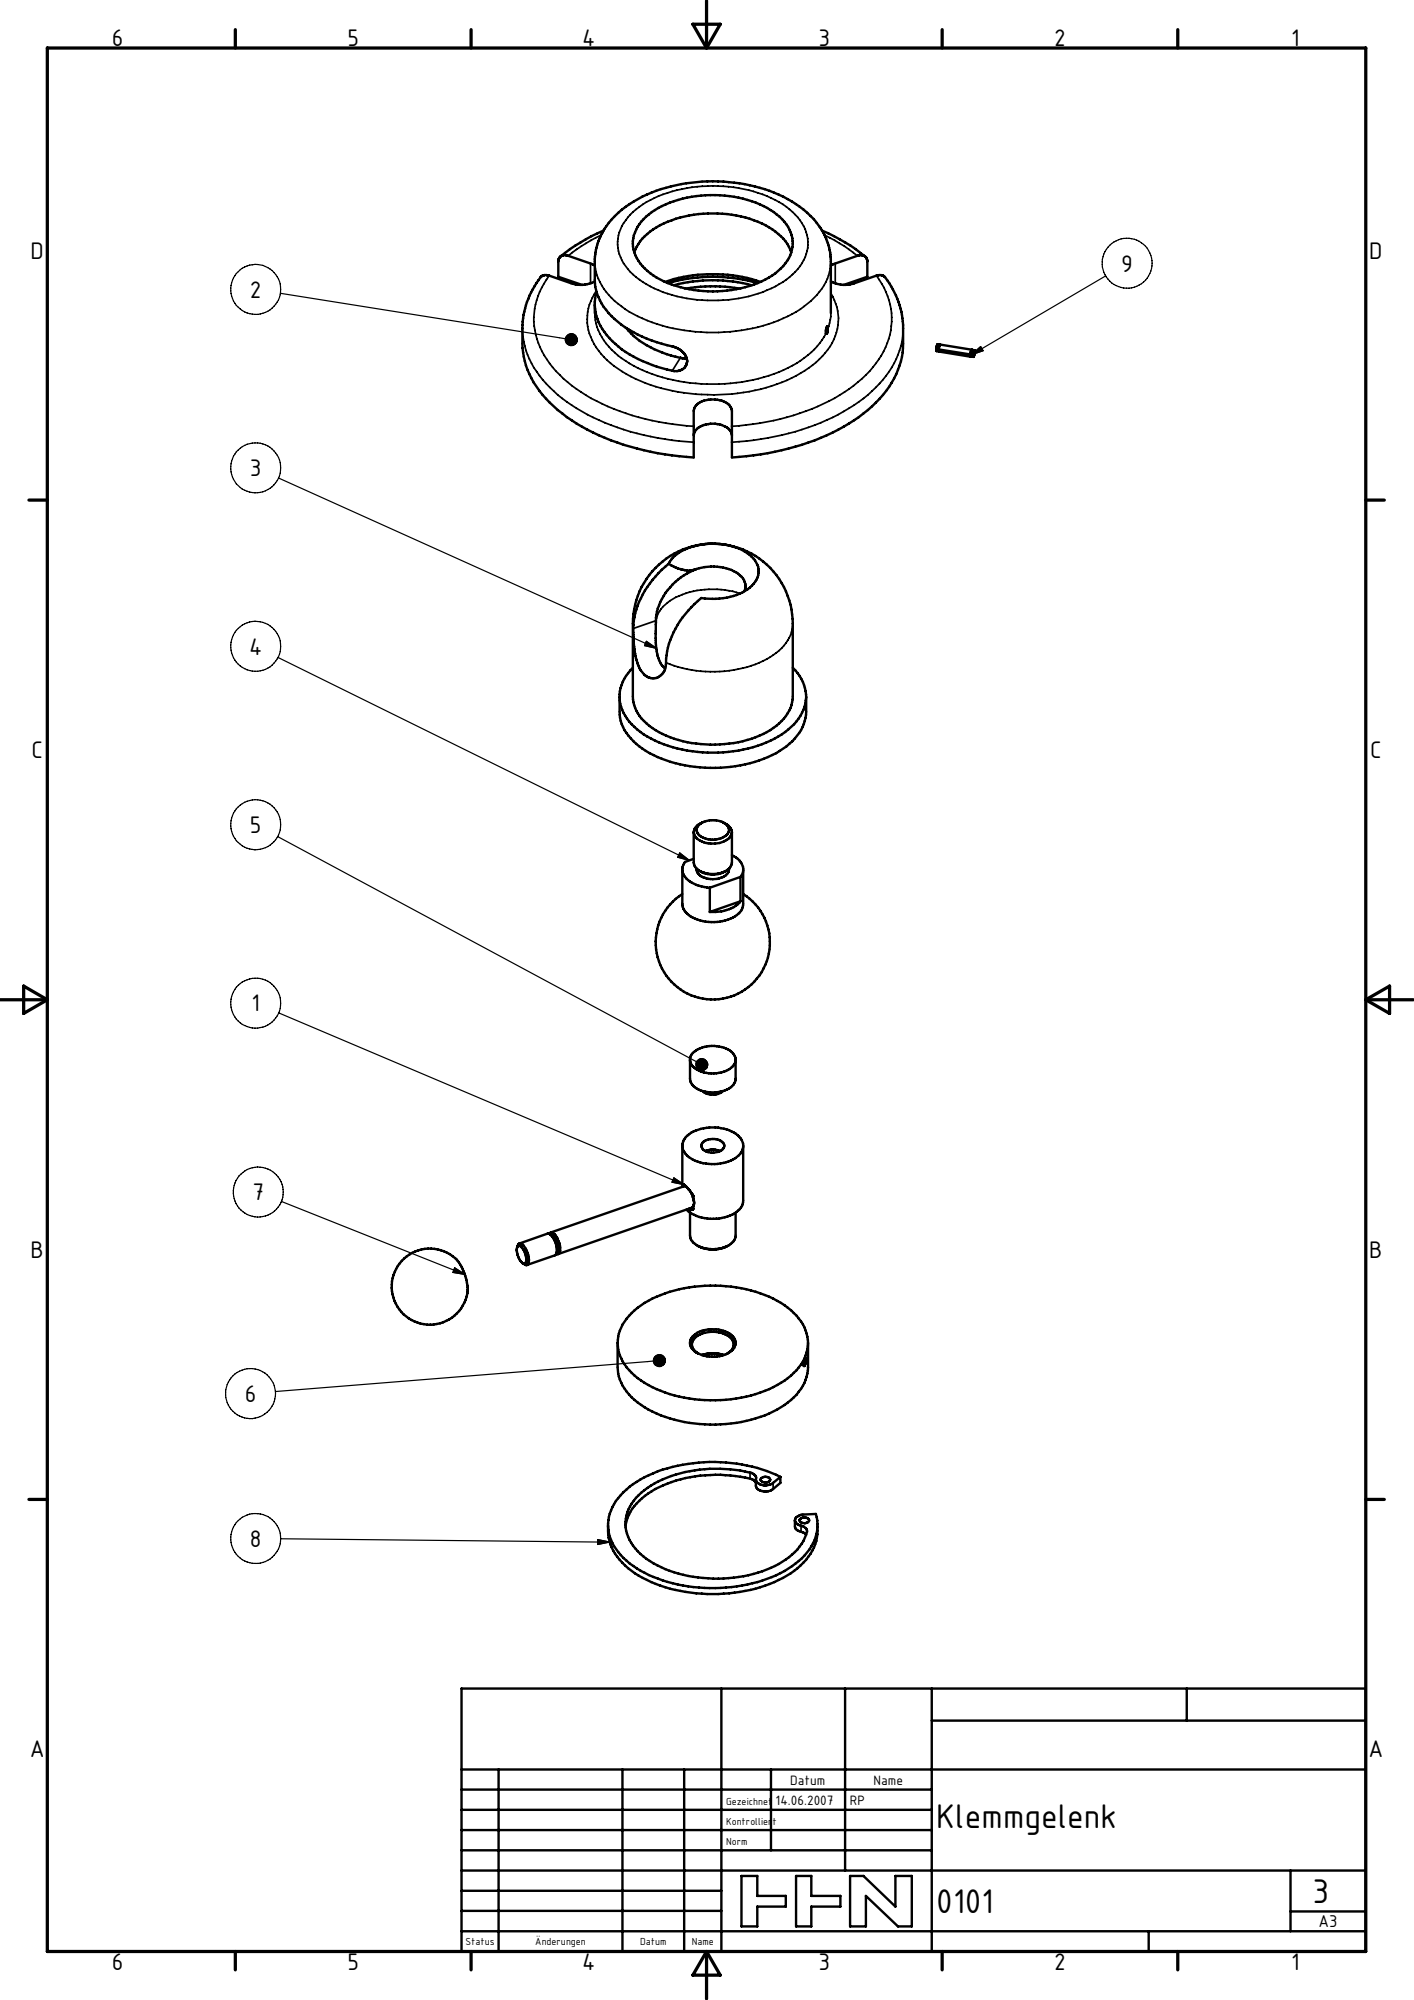
[picture p154: page 6]
Klemmgelenk; Gezeichnet; Kontrolliert; Norm; Datum; Name

5 | Anhang 1: Montagezeichnungen und Stücklisten
5.3 | Hebel | Zeichnungsnummer 0102

# Die Zeichnung 0102 zeigt eine Unterbaugruppe („zweite Ebene“). Diese

Baugruppe wird vor der Montage des Klemmgelenks (0101) montiert.

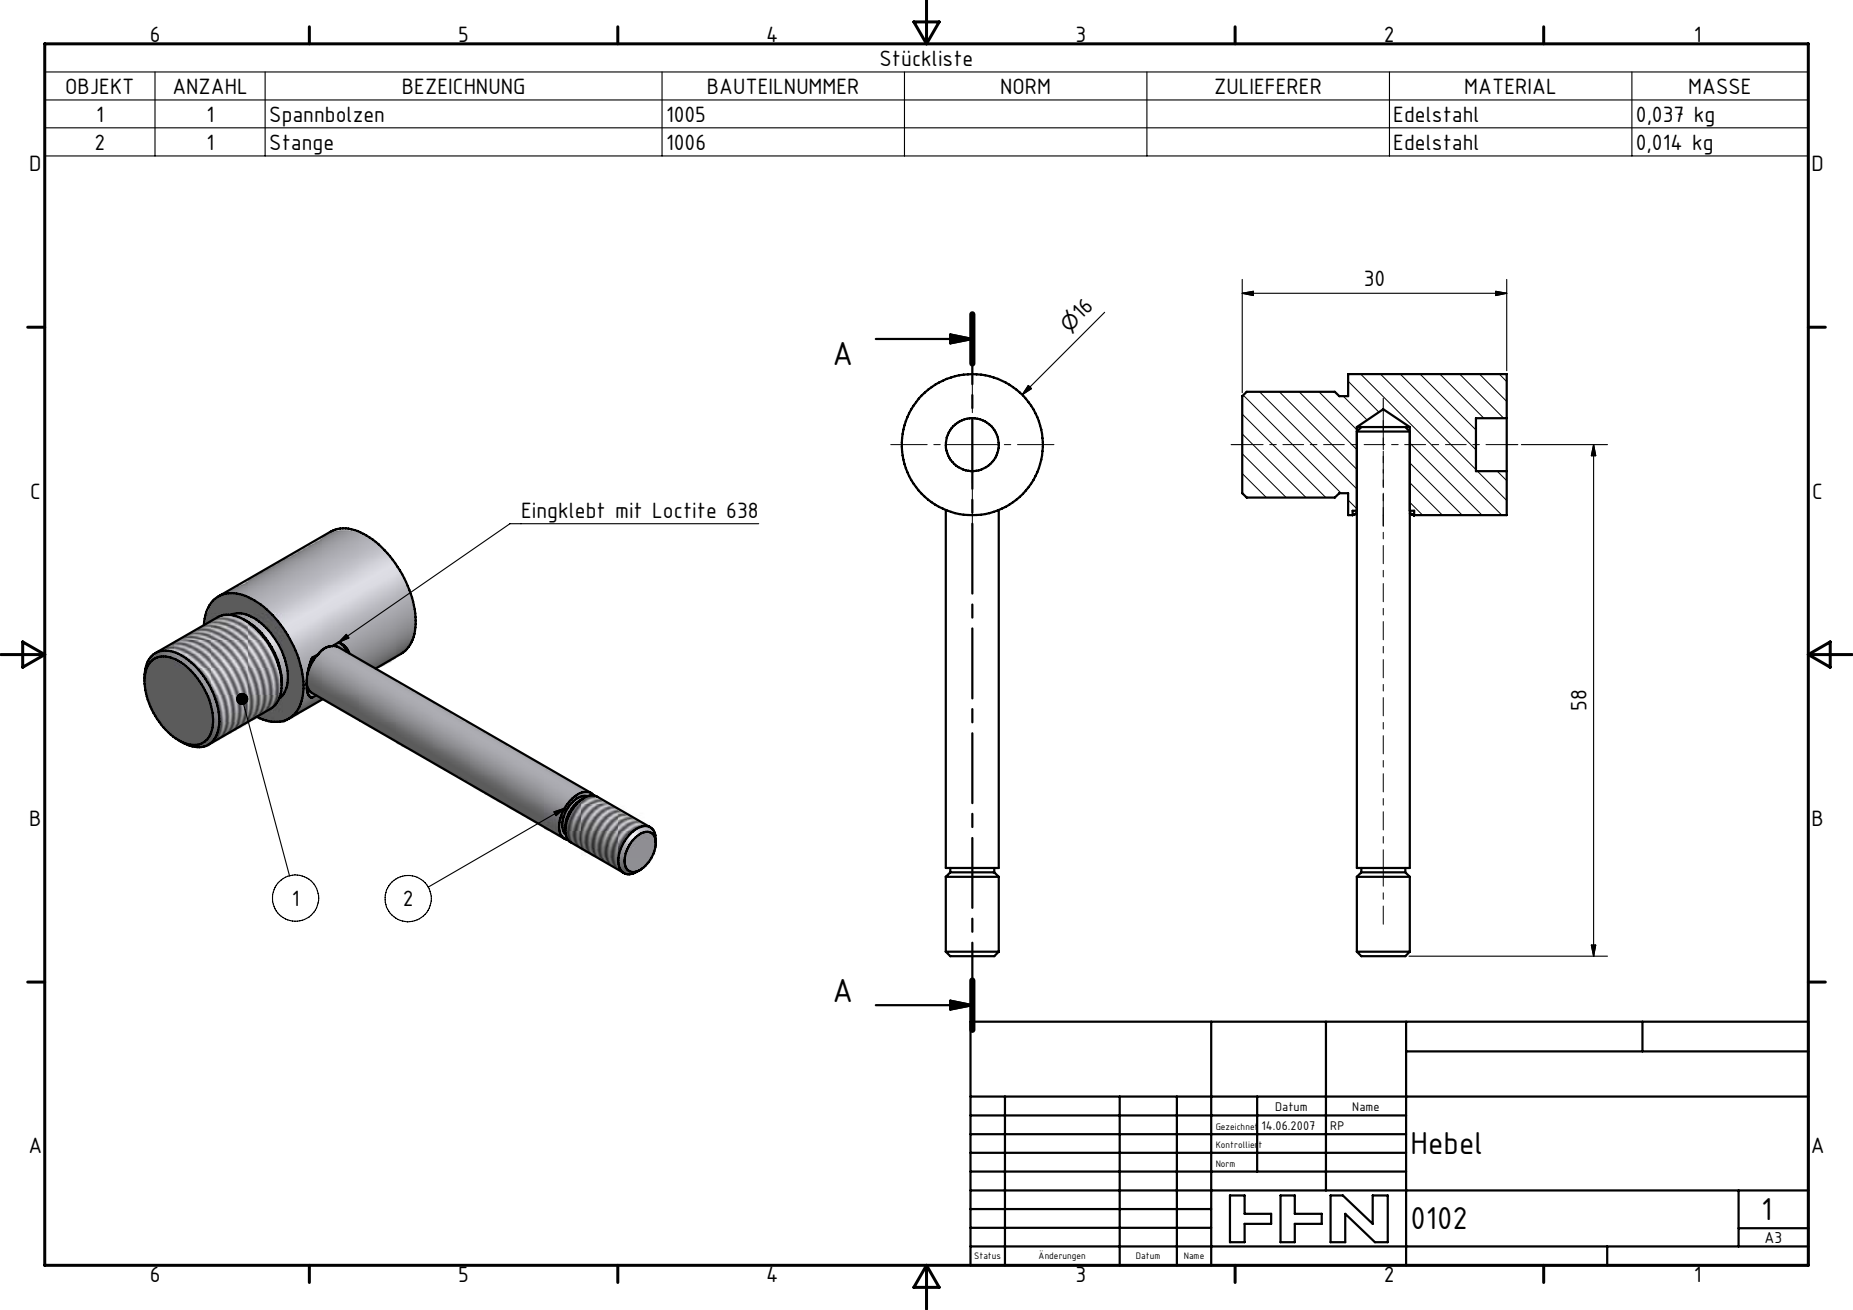
[picture p155: page 8]
Hebel; Gezeichnet; Kontrolliert; Norm; Datum; Name; OBJEKT; ANZAHL; BEZEICHNUNG; BAUTEILNUMMER; NORM; ZULIEFERER; MATERIAL; MASSE; Spannbolzen; Edelstahl

Stückliste

2 | 1 | Stange | 1006 | Edelstahl | 0,014 kg

Eingklebt mit Loctite 638

# 6 Anhang 2: Fertigungszeichnungen

# 6 Anhang 2: Fertigungszeichnungen

6.1 | Flansch | Zeichnungsnummer 1001

# (nicht dargestellt)

6.2 | Glocke | Zeichnungsnummer 1002

# (nicht dargestellt)

6.3 | Kugelbolzen | Zeichnungsnummer 1003

# (nicht dargestellt)

6.4 | Druckstück | Zeichnungsnummer 1004

# (nicht dargestellt)

6.5 | Spannbolzen | Zeichnungsnummer 1005

# (siehe nächste Seite)

n16

n6 H8

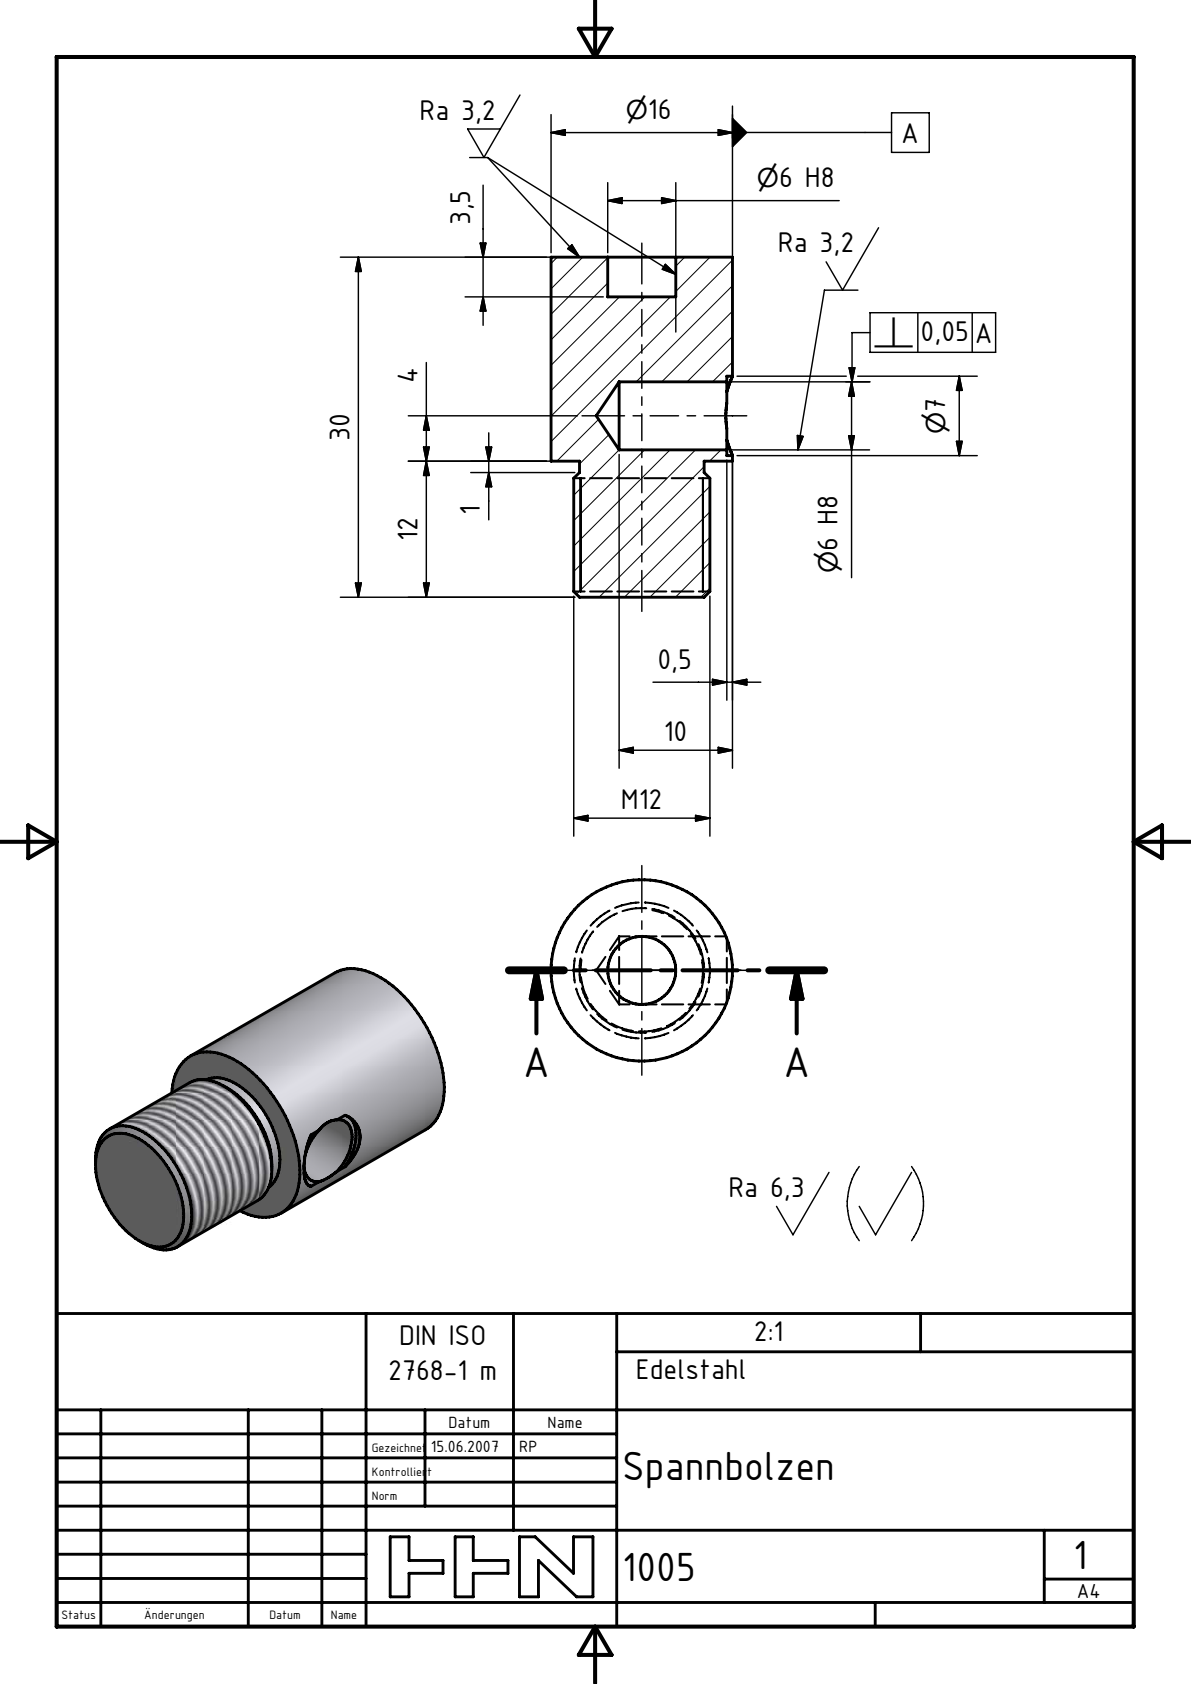
[picture p156: page 10]
Spannbolzen; Gezeichnet; Kontrolliert; Norm; Datum; Name; Edelstahl; DIN ISO

6 | Anhang 2: Fertigungszeichnungen
6.6 | Stange | Zeichnungsnummer 1006

# (nicht dargestellt)

6.7 | Platte | Zeichnungsnummer 1007

# (nicht dargestellt)

6.8 | Klemme | Zeichnungsnummer 1008

# (nicht dargestellt)
