Freezepok/CAD-Paspa/Useless Box/Zeichnung_JH/Montagezeichnung Greifer.pdf

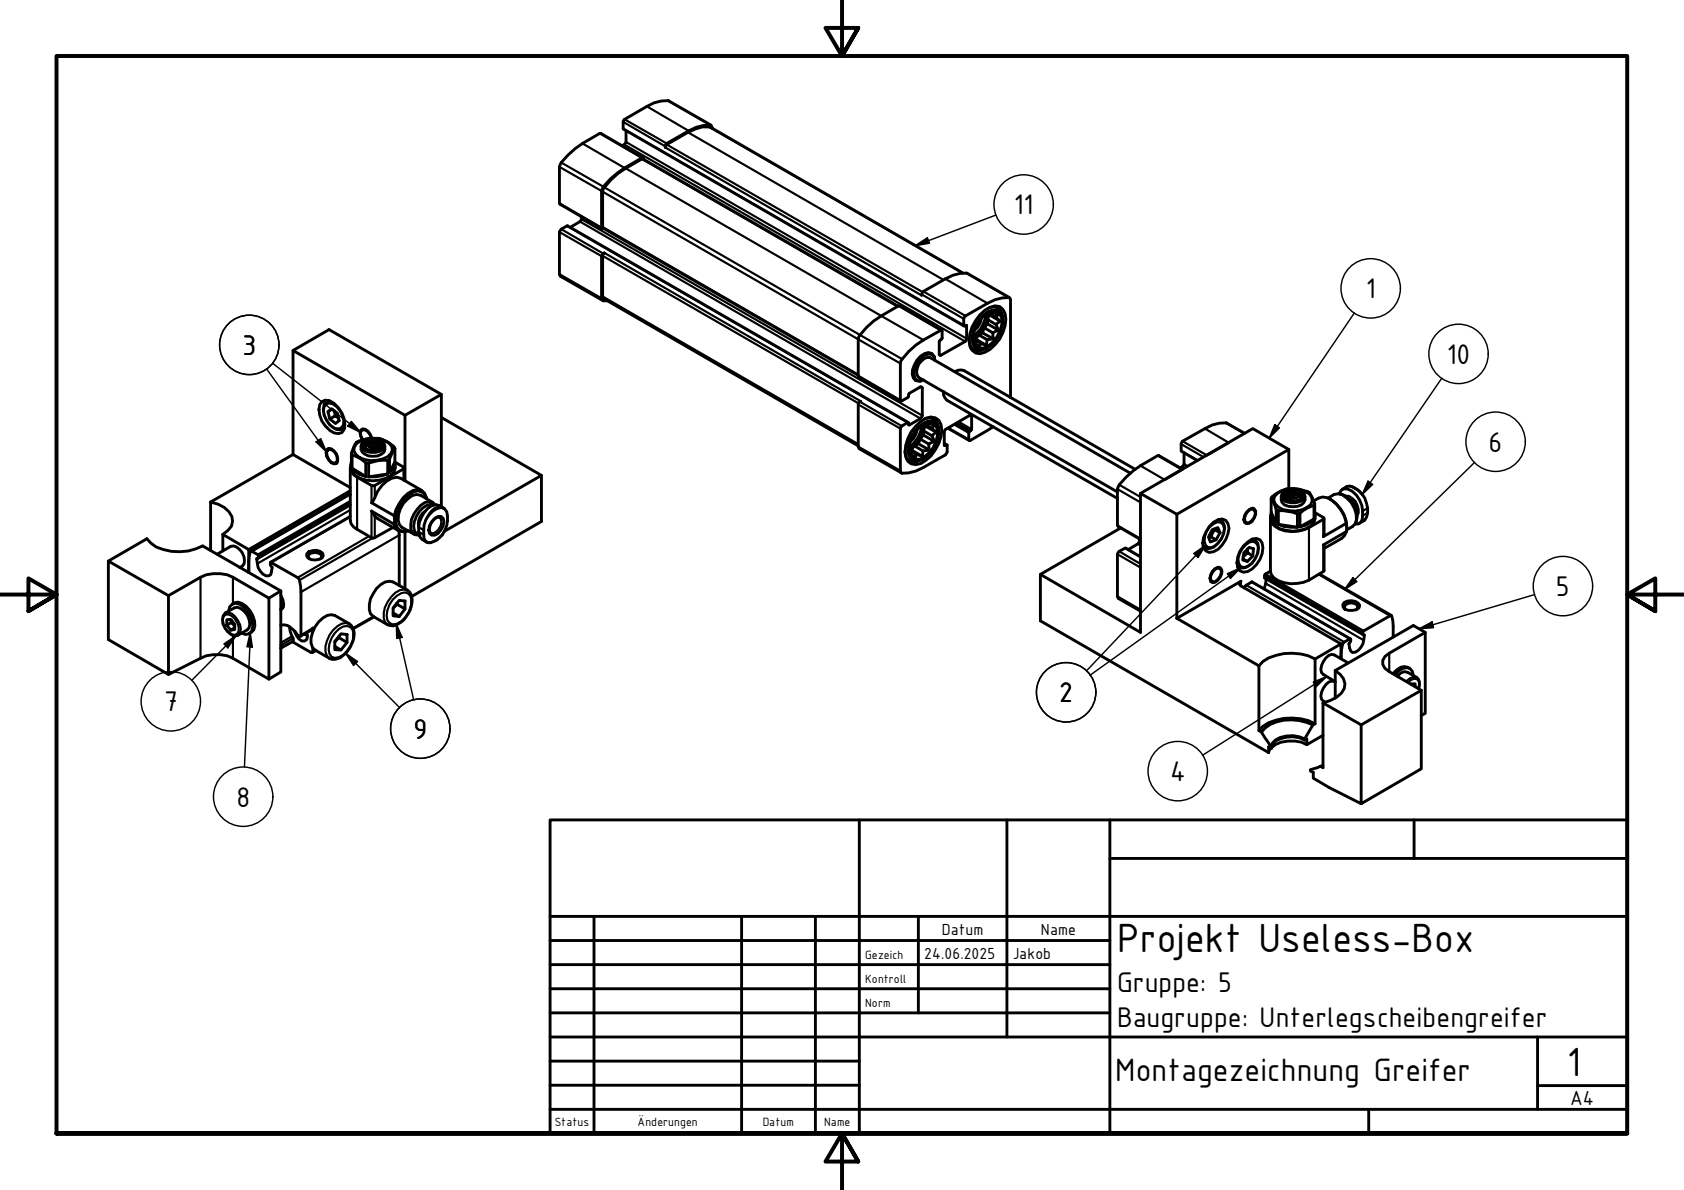
[picture p157: page 1]
Montagezeichnung Greifer

Datum | Name | Projekt Useless-Box Gruppe: 5 Baugruppe: Unterlegscheibengreifer

Gezeich | 24.06.2025 | Jakob

Kontroll

Norm

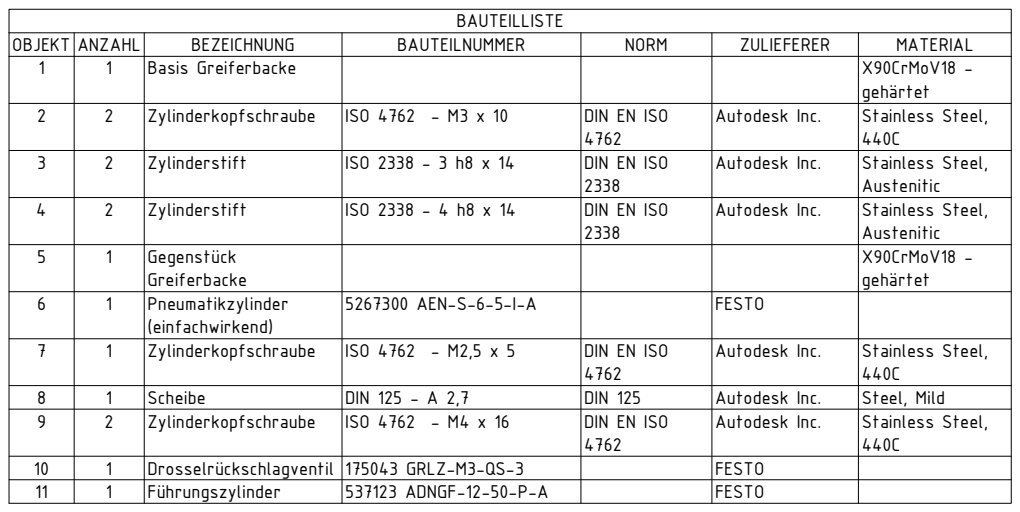
[picture p158: page 2]

OBJEKT | ANZAHL | BEZEICHNUNG | BAUTEILNUMMER | NORM | ZULIEFERER | MATERIAL
1 | 1 | Basis Greiferbacke | | | | X90CrMoV18 -gehärtet

2 | 2 | Zylinderkopfschraube | ISO 4762 - M3 x 10 | DIN EN ISO 4762 | Autodesk Inc. | Stainless Steel, 440C

3 | 2 | Zylinderstift | ISO 2338 - 3 h8 x 14 | DIN EN ISO 2338 | Autodesk Inc. | Stainless Steel, Austenitic

4 | 2 | Zylinderstift | ISO 2338 - 4 h8 x 14 | DIN EN ISO 2338 | Autodesk Inc. | Stainless Steel, Austenitic

5 | 1 | Gegenstück Greiferbacke | | | | X90CrMoV18 -gehärtet

6 | 1 | Pneumatikzylinder (einfachwirkend) | 5267300 AEN-S-6-5-I-A | | FESTO

7 | 1 | Zylinderkopfschraube | ISO 4762 - M2,5 x 5 | DIN EN ISO 4762 | Autodesk Inc. | Stainless Steel, 440C

8 | 1 | Scheibe | DIN 125 - A 2,7 | DIN 125 | Autodesk Inc. | Steel, Mild
9 | 2 | Zylinderkopfschraube | ISO 4762 - M4 x 16 | DIN EN ISO 4762 | Autodesk Inc. | Stainless Steel, 440C

10 | 1 | Drosselrückschlagventil | 175043 GRLZ-M3-QS-3 | | FESTO
11 | 1 | Führungszylinder | 537123 ADNGF-12-50-P-A | | FESTO
