Freezepok/CAD-Paspa/Useless Box/Zeichnung_JH/Montagezeichnung Vibrationsämpfereinheit.pdf

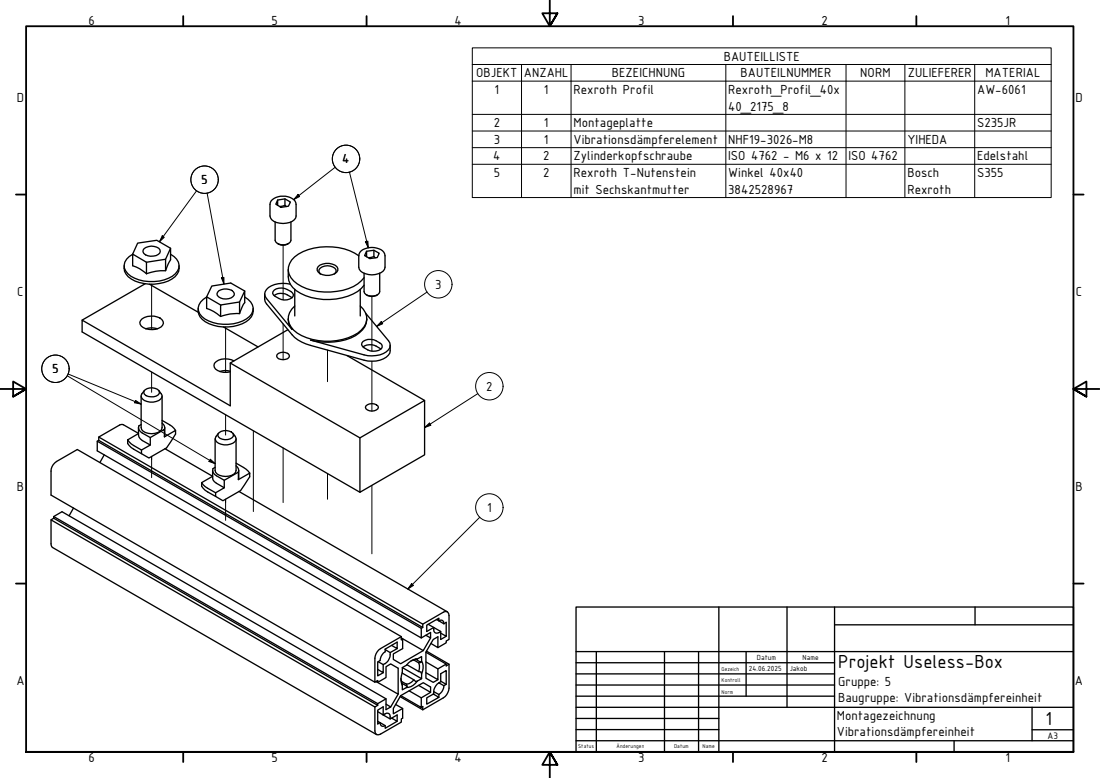
[picture p160: page 1]

OBJEKT | ANZAHL | BEZEICHNUNG | BAUTEILNUMMER | NORM | ZULIEFERER | MATERIAL
1 | 1 | Rexroth Profil | Rexroth_Profil_40x 40_2175_8 | | | AW-6061

2 | 1 | Montageplatte | | | | S235JR
3 | 1 | Vibrationsdämpferelement | NHF19-3026-M8 | | YIHEDA
4 | 2 | Zylinderkopfschraube | ISO 4762 - M6 x 12 | ISO 4762 | | Edelstahl
5 | 2 | Rexroth T-Nutenstein mit Sechskantmutter | Winkel 40x40 3842528967 | | Bosch Rexroth | S355

Datum | Name | Projekt Useless-Box Gruppe: 5 Baugruppe: Vibrationsdämpfereinheit

Gezeich | 24.06.2025 | Jakob

Kontroll

Norm
