Freezepok/CAD-Paspa/Useless Box/Zeichnung_ER/Halter_Verschraubung.pdf

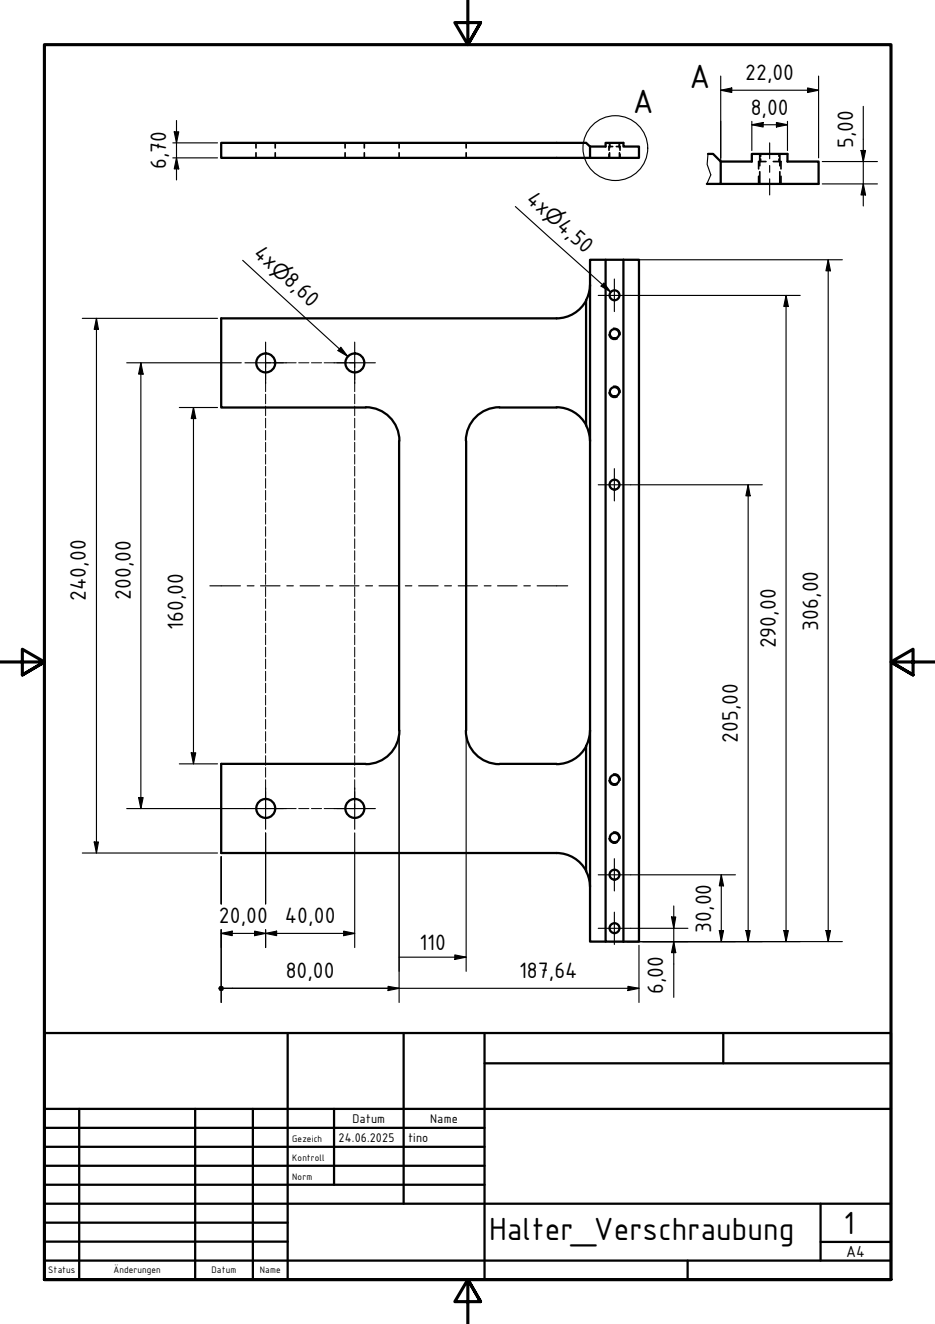
[picture p161: page 1]

Datum | Name

Gezeich | 24.06.2025 | tino

Kontroll

Norm
