Freezepok/CAD-Paspa/Useless Box/Zeichnung_JH/Greiferbacke.pdf

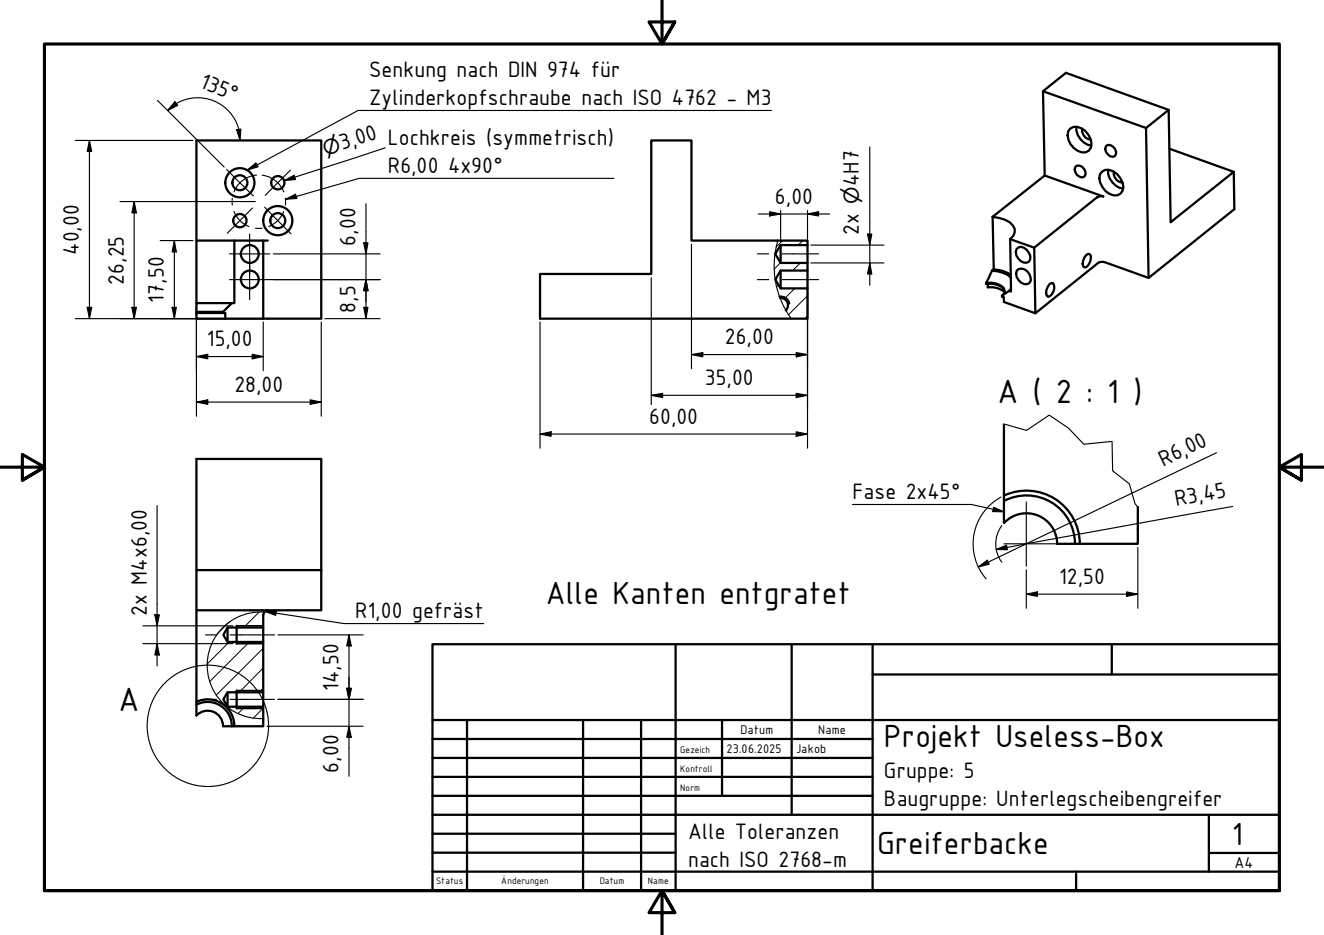
[picture p162: page 1]
R1,00 gefräst; Fase 2x45°; Alle Toleranzen nach ISO 2768-m

Senkung nach DIN 974 für
Zylinderkopfschraube nach ISO 4762 - M3
Lochkreis (symmetrisch)

Alle Kanten entgratet

Datum | Name | Projekt Useless-Box Gruppe: 5 Baugruppe: Unterlegscheibengreifer

Gezeich | 23.06.2025 | Jakob

Kontroll

Norm
