Freezepok/CAD-Paspa/Useless Box/Zeichnung_TS/Formnest_Fallmagazin.pdf

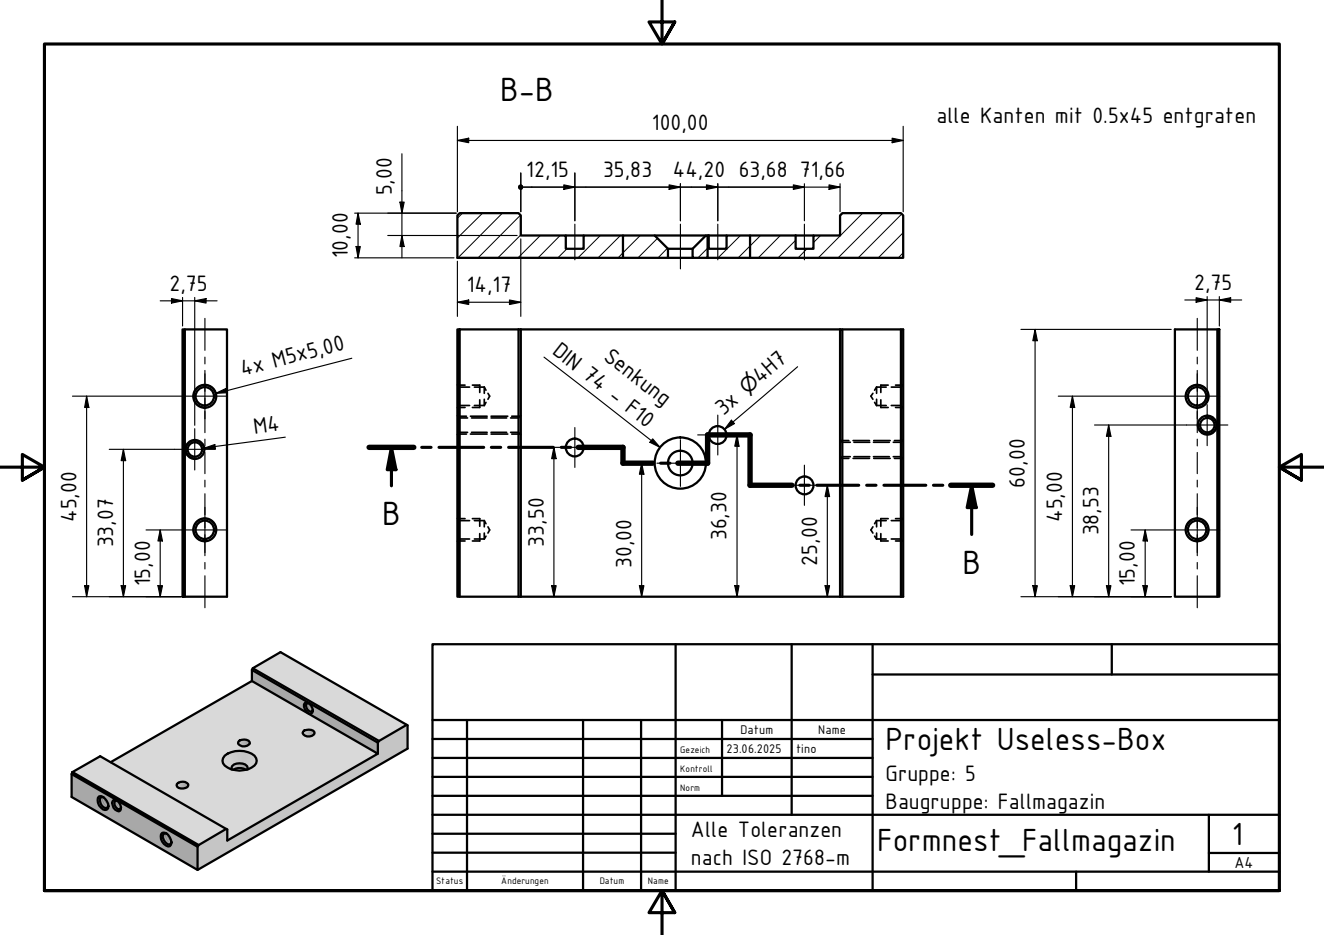
[picture p163: page 1]
DIN 74 - F10; Alle Toleranzen nach ISO 2768-m

alle Kanten mit 0.5x45 entgraten

Datum | Name | Projekt Useless-Box Gruppe: 5 Baugruppe: Fallmagazin

Gezeich | 23.06.2025 | tino

Kontroll

Norm
