Freezepok/CAD-Paspa/(commit log)

2025-05-24 Erster Upload der Baugruppe bisher
    [Antriebseinheit_ZSB.iam, Antriebseinheit_ZSB.ipn, Blech.ipt, DIN 9021 - 2,7.ipt, DIN 934 - M3 x 0,5.ipt, DIN 934 - M4 x 0,7.ipt, DIN EN ISO 4762 - M2,5 x 10.ipt, DIN EN ISO 4762 - M3 x 30.ipt]
2025-05-24 Upload der Handskizze als Test ob alles funktioniert
    [__Projekt_Useless_Box.0022.iam, __Projekt_Useless_Box.iam]
2025-05-27 Befestigung Rahmen und Auslagerung Normteile
    [ISO 2338 - 6 m6 x 50.ipt, ISO 4026 - M6 x 16 - ISO.ipt, ISO 4026 - M8 x 40 - ISO.ipt, ISO 4762 - M6 x 12ISO.ipt, ISO 4762 - M8 x 40ISO.ipt, Rexroth_Profil_40x40_168mm.ipt, Rexroth_Profil_40x40_168mm.stp, Rexroth_Profil_40x40_60mm.ipt]
2025-06-01 Prototyp Magazin
    [Bauteil1.0001.ipt, Bauteil1.ipt, Compress Spring11.ipt, Compress Spring12.ipt, Deckel Federnzusammenbau.iam, Deckel Stempel 2.ipt, Deckel Stempel.ipt, Feder_Topf_Tino_Stoehr_220758_Version2.dwg]
2025-06-13 neues Magazin und Anschlag für die obere Position
    [1376426 DSBC-32-100-PPVA-N3---(0).0015.iam, 1376426 DSBC-32-100-PPVA-N3---(0).iam, 1376426 DSBC-32-100-PPVA-N3---(0)_MIR.0010.iam, 1376426 DSBC-32-100-PPVA-N3---(0)_MIR.iam, 1463250 DSBC-32-100-PPVA_(Z_0).0001.ipt, 1463250 DSBC-32-100-PPVA_(Z_0).ipt, 1463250 DSBC-32-100-PPVA_(Z_0)_MIR.ipt, 1463250 DSBC-32-100_(K).0001.ipt]
2025-06-13 Zukaufteile eingefügt und richtge Abhängigkeiten hinzugefügt
    [1310162 DHRS-25-A---(0).0001.iam, 1310162 DHRS-25-A---(0).iam, 1310162 DHRS-25-A---(Geh).ipt, 1310162 DHRS-25-A---(Griff).ipt, 1376426 DSBC-32-100-PPVA-N3---(0).0015.iam, 1376426 DSBC-32-100-PPVA-N3---(0).0017.iam, 1376426 DSBC-32-100-PPVA-N3---(0).iam, 1376426 DSBC-32-100-PPVA-N3---(0)_MIR.0010.iam]
2025-06-17 erste Version der Anbindung des Magazins an das Gestell
    [1310162 DHRS-25-A---(0).0001.iam, 1310162 DHRS-25-A---(0).iam, 1376426 DSBC-32-100-PPVA-N3---(0).0017.iam, 1376426 DSBC-32-100-PPVA-N3---(0).iam, 1376426 DSBC-32-100-PPVA-N3---(0)_MIR.0012.iam, 1376426 DSBC-32-100-PPVA-N3---(0)_MIR.iam, 1463250 DSBC-32-100-PPVA_(Z_0).0001.ipt, 1463250 DSBC-32-100-PPVA_(Z_0).ipt]
2025-06-17 backen neu
    [1310164 DHRS-32-A---(0).0002.iam, 1310164 DHRS-32-A---(0).iam, 1310164 DHRS-32-A---(Geh).ipt, 1310164 DHRS-32-A---(Griff).ipt, 8137184 ZBH-9-B.ipt, ER_Backe_Links_neu.ipt, ER_Backe_Rechts_neu.ipt, Finger.0007.ipt]
2025-06-17 Greifer passt so
    [1310164 DHRS-32-A---(0).0003.iam, 1310164 DHRS-32-A---(0).0004.iam, 1310164 DHRS-32-A---(0).iam, 1376426 DSBC-32-100-PPVA-N3---(0).0029.iam, 1376426 DSBC-32-100-PPVA-N3---(0).0030.iam, 1376426 DSBC-32-100-PPVA-N3---(0).iam, 1376426 DSBC-32-100-PPVA-N3---(0)_MIR.0023.iam, 1376426 DSBC-32-100-PPVA-N3---(0)_MIR.0024.iam]
2025-06-17 Jakobs Greifer ist grob positioniert
    [1376426 DSBC-32-100-PPVA-N3---(0).0030.iam, 1376426 DSBC-32-100-PPVA-N3---(0).0031.iam, 1376426 DSBC-32-100-PPVA-N3---(0).iam, 175043 GRLZ-M3-QS-3.0001.ipt, 175043 GRLZ-M3-QS-3.ipt, 5267300 AEN-S-6-5-I-A---(0_high).0002.iam, 5267300 AEN-S-6-5-I-A---(0_high).iam, 5267300 AEN-S-6-5-I-A---(highH).ipt]
2025-06-17 Halterung Greifer Jakop
    [1.0001.ipt, 1.ipt, 1310164 DHRS-32-A---(Geh).0001.ipt, 1310164 DHRS-32-A---(Geh).ipt, 1310164 DHRS-32-A---(Griff).0001.ipt, 1310164 DHRS-32-A---(Griff).ipt, 1376426 DSBC-32-100-PPVA-N3---(0).0031.iam, 1376426 DSBC-32-100-PPVA-N3---(0).0036.iam]
2025-06-19 Magazin + Greifer-Fuehrung angebungen
    [1310164 DHRS-32-A---(0).0004.iam, 1310164 DHRS-32-A---(0).0009.iam, 1310164 DHRS-32-A---(0).iam, 1376426 DSBC-32-100-PPVA-N3---(0).0036.iam, 1376426 DSBC-32-100-PPVA-N3---(0).0052.iam, 1376426 DSBC-32-100-PPVA-N3---(0).iam, 165565807 18793263 170831 DFM-12-100-P-A-GF---(fdt_d_0).0008.iam, 165565807 18793263 170831 DFM-12-100-P-A-GF---(fdt_d_0).0009.iam]
2025-06-19 Delete Useless Box/._.DS_Store
    wird nichtmehr benötigt
2025-06-19 Delete Useless Box/.DS_Store
    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
2025-06-19 Delete Useless Box/Kaufteile/._.DS_Store
    wird nicht benötigt
2025-06-19 Delete Useless Box/Kaufteile/._Festo_Fuehrungszylinder_100
    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
2025-06-19 Delete Useless Box/Kaufteile/._Festo_Fuehrungszylinder_150
    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
2025-06-19 Delete Useless Box/Kaufteile/._Festo_Radialgreifer_DHRS_25_A
    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
2025-06-19 Delete Useless Box/Kaufteile/.DS_Store
    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
2025-06-20 Kantenerkennung implementiert
    [1376426 DSBC-32-100-PPVA-N3---(0).0052.iam, 1376426 DSBC-32-100-PPVA-N3---(0).0057.iam, 1376426 DSBC-32-100-PPVA-N3---(0).iam, 3D_OXS200_11728845.ipt, 529120 DFM-16-150-B-P-A-KF---(0).0010.iam, 529120 DFM-16-150-B-P-A-KF---(0).0015.iam, 529120 DFM-16-150-B-P-A-KF---(0).iam, Baumer_OXS200_11728845_1.iam]
2025-06-21 80% der Befestigung der Verschraubungseinheit
    [1376426 DSBC-32-100-PPVA-N3---(0).0057.iam, 1376426 DSBC-32-100-PPVA-N3---(0).0059.iam, 1376426 DSBC-32-100-PPVA-N3---(0).iam, 529120 DFM-16-150-B-P-A-KF---(0).0015.iam, 529120 DFM-16-150-B-P-A-KF---(0).0017.iam, 529120 DFM-16-150-B-P-A-KF---(0).iam, DIN 934 - M5 x 0,8.ipt, ER_Halterung_Verschraubeinheit.0003.ipt]
2025-06-22 Greiferproblem gelöst
    [1.0001.ipt, 1.0002.ipt, 1.ipt, 1376426 DSBC-32-100-PPVA-N3---(0).0059.iam, 1376426 DSBC-32-100-PPVA-N3---(0).0061.iam, 1376426 DSBC-32-100-PPVA-N3---(0).iam, 175043 GRLZ-M3-QS-3.0001.ipt, 175043 GRLZ-M3-QS-3.0003.ipt]
2025-06-22 Vibrationsdämpfer Einheit hinzugefügt
    [1376426 DSBC-32-100-PPVA-N3---(0).0061.iam, 1376426 DSBC-32-100-PPVA-N3---(0).0065.iam, 1376426 DSBC-32-100-PPVA-N3---(0).iam, 529120 DFM-16-150-B-P-A-KF---(0).0019.iam, 529120 DFM-16-150-B-P-A-KF---(0).0021.iam, 529120 DFM-16-150-B-P-A-KF---(0).iam, Adapterplatte_Vibrationsdaempfer.0010.ipt, Adapterplatte_Vibrationsdaempfer.ipt]
2025-06-23 abhängigkeiten erneuert und neue Schrauben für Verbindung
    [1376426 DSBC-32-100-PPVA-N3---(0).0065.iam, 1376426 DSBC-32-100-PPVA-N3---(0).0066.iam, 1376426 DSBC-32-100-PPVA-N3---(0).iam, 529120 DFM-16-150-B-P-A-KF---(0).0021.iam, 529120 DFM-16-150-B-P-A-KF---(0).0022.iam, 529120 DFM-16-150-B-P-A-KF---(0).iam, DIN 125 - A 8,4.ipt, ISO 4762 - M8 x 16ISO.ipt]
2025-06-23 Verschraubungseinheit final befestigt, Unterordner sortiert
    [1376426 DSBC-32-100-PPVA-N3---(0).0066.iam, 1376426 DSBC-32-100-PPVA-N3---(0).0067.iam, 1376426 DSBC-32-100-PPVA-N3---(0).iam, 529120 DFM-16-150-B-P-A-KF---(0).0022.iam, 529120 DFM-16-150-B-P-A-KF---(0).0023.iam, 529120 DFM-16-150-B-P-A-KF---(0).iam, DIN 125 - A 5,3.ipt, DIN 913 - M5 x 16.ipt]
2025-06-23 Ständer Schwingfoerderer
    [1376426 DSBC-32-100-PPVA-N3---(0).0067.iam, 1376426 DSBC-32-100-PPVA-N3---(0).0069.iam, 1376426 DSBC-32-100-PPVA-N3---(0).iam, 31000133platte.ipt, 31000133profil_up(550).ipt, 529120 DFM-16-150-B-P-A-KF---(0).0023.iam, 529120 DFM-16-150-B-P-A-KF---(0).0025.iam, 529120 DFM-16-150-B-P-A-KF---(0).iam]
2025-06-23 Baugruppe vorläufig finalisiert
    [1376426 DSBC-32-100-PPVA-N3---(0).0069.iam, 1376426 DSBC-32-100-PPVA-N3---(0).0073.iam, 1376426 DSBC-32-100-PPVA-N3---(0).iam, 529120 DFM-16-150-B-P-A-KF---(0).0025.iam, 529120 DFM-16-150-B-P-A-KF---(0).0028.iam, 529120 DFM-16-150-B-P-A-KF---(0).iam, Base stand BZB 550-900mm BVL3-H=550.0001.iam, Base stand BZB 550-900mm BVL3-H=550.0002.iam]
2025-06-23 Baugruppe noch besser
    [1376426 DSBC-32-100-PPVA-N3---(0).0073.iam, 1376426 DSBC-32-100-PPVA-N3---(0).0074.iam, 1376426 DSBC-32-100-PPVA-N3---(0).iam, ER_Halterung_Verschraubeinheit.0004.ipt, ER_Halterung_Verschraubeinheit.0005.ipt, ER_Halterung_Verschraubeinheit.ipt, TS_V1_Fallmagazin_gesamt.0090.iam, TS_V1_Fallmagazin_gesamt.0091.iam]
2025-06-23 Zeichnung Formnest Fallmagazin
    [Formnest_Fallmagazin.0010.dwg, Formnest_Fallmagazin.dwg]
2025-06-24 Kollision gelöst
    [529120 DFM-16-150-B-P-A-KF---(0).0028.iam, 529120 DFM-16-150-B-P-A-KF---(0).0030.iam, 529120 DFM-16-150-B-P-A-KF---(0).iam, DIN 913 - M5 x 6.ipt, ER_Positionierungseinheit_Greifer.0001.ipt, ER_Positionierungseinheit_Greifer.0005.ipt, ER_Positionierungseinheit_Greifer.ipt, Rexroth_Profil_40x80_245mm_MIR.0002.ipt]
2025-06-24 Zeichnungen Greiferbacke
    [Greiferbacke für Unterlegscheibe.dwg, Greiferbacke.0015.dwg, Greiferbacke.dwg]
2025-06-24 Aufhängung Verschraubung neu
    [1376426 DSBC-32-100-PPVA-N3---(0).0074.iam, 1376426 DSBC-32-100-PPVA-N3---(0).0075.iam, 1376426 DSBC-32-100-PPVA-N3---(0).iam, ER_Halterung_Verschraubeinheit.0005.ipt, ER_Halterung_Verschraubeinheit.0006.ipt, ER_Halterung_Verschraubeinheit.ipt, TS_V1_Fallmagazin_gesamt.0094.iam, TS_V1_Fallmagazin_gesamt.0095.iam]
2025-06-24 Tinos Zeichnung korrigiert
    [Formnest_Fallmagazin.0010.dwg, Formnest_Fallmagazin.0011.dwg, Formnest_Fallmagazin.dwg]
2025-06-24 Jakobs Zeichnung Korrigiert
    [Greiferbacke.0015.dwg, Greiferbacke.0017.dwg, Greiferbacke.dwg, TS_V1_Fallmagazin_gesamt.0095.iam, TS_V1_Fallmagazin_gesamt.0096.iam, TS_V1_Fallmagazin_gesamt.iam]
2025-06-24 Zeichnung Halterung Verschraubeinheit
    [ER_Halterung_Verschraubeinheit.0001.dwg, Halter_Verschraubung.0002.dwg, Halter_Verschraubung.dwg]
2025-06-24 Explosionszeichnungen für Magazin
    [1310164 DHRS-32-A---(0).0009.iam, 1310164 DHRS-32-A---(0).0010.iam, 1310164 DHRS-32-A---(0).iam, 1376426 DSBC-32-100-PPVA-N3---(0).0075.iam, 1376426 DSBC-32-100-PPVA-N3---(0).0078.iam, 1376426 DSBC-32-100-PPVA-N3---(0).iam, 153004 QS-1_8-8.ipt, 193143 GRLA-1_8-QS-4-D.ipt]
2025-06-24 Zeichnungen + gepfuschtes Ventil
    [1376426 DSBC-32-100-PPVA-N3---(0).0078.iam, 1376426 DSBC-32-100-PPVA-N3---(0).0079.iam, 1376426 DSBC-32-100-PPVA-N3---(0).iam, 153333 QSML-M5-4.0002.ipt, 153333 QSML-M5-4.ipt, 529120 DFM-16-150-B-P-A-KF---(0).0036.iam, 529120 DFM-16-150-B-P-A-KF---(0).0037.iam, 529120 DFM-16-150-B-P-A-KF---(0).iam]
2025-06-25 aufgelöstes Bauteil ersetzt
    [31000133profil_up(550).0001.ipt, 31000133profil_up(550).ipt, Base stand BZB 550-900mm BVL3-H=550.0002.iam, Base stand BZB 550-900mm BVL3-H=550.0003.iam, Base stand BZB 550-900mm BVL3-H=550.iam, JH_Greifer_Scheibe_final.0017.iam, JH_Greifer_Scheibe_final.0018.iam, JH_Greifer_Scheibe_final.iam]
2025-06-25 Baugruppe mit kleinen Änderungen
    [1376426 DSBC-32-100-PPVA-N3---(0).0079.iam, 1376426 DSBC-32-100-PPVA-N3---(0).0080.iam, 1376426 DSBC-32-100-PPVA-N3---(0).iam, 529120 DFM-16-150-B-P-A-KF---(0).0037.iam, 529120 DFM-16-150-B-P-A-KF---(0).0038.iam, 529120 DFM-16-150-B-P-A-KF---(0).iam, TS_V1_Fallmagazin_Schieber.iam, TS_V1_Fallmagazin_gesamt.0105.iam]
2025-06-25 Explosionszeichnungen Magazin fertig!
    [Bewegeeinheit Schieber Explosion.0005.ipn, Bewegeeinheit Schieber Explosion.0006.ipn, Bewegeeinheit Schieber Explosion.ipn, Explosionszeichnung Schieber und Zylinder.0003.ipn, Explosionszeichnung Schieber und Zylinder.0004.ipn, Explosionszeichnung Schieber und Zylinder.ipn, Fingergreifer Explosion.0001.ipn, Fingergreifer Explosion.0002.ipn]
2025-06-25 Reed Sensoren eingebaut
    [1247168 ASCF-M-23-S DM 2_1-3_4.ipt, 1376426 DSBC-32-100-PPVA-N3---(0).0080.iam, 1376426 DSBC-32-100-PPVA-N3---(0).0082.iam, 1376426 DSBC-32-100-PPVA-N3---(0).iam, 529120 DFM-16-150-B-P-A-KF---(0).0038.iam, 529120 DFM-16-150-B-P-A-KF---(0).0039.iam, 529120 DFM-16-150-B-P-A-KF---(0).iam, 534255 SMBK-10.ipt]
2025-06-25 Alle Montagezeichnungen
    [1376426 DSBC-32-100-PPVA-N3---(0).0082.iam, 1376426 DSBC-32-100-PPVA-N3---(0).0085.iam, 1376426 DSBC-32-100-PPVA-N3---(0).iam, 529120 DFM-16-150-B-P-A-KF---(0).0039.iam, 529120 DFM-16-150-B-P-A-KF---(0).0041.iam, 529120 DFM-16-150-B-P-A-KF---(0).iam, 61057.ipt, Bewegeeinheit Schieber Explosion.0006.ipn]
2025-06-25 Jetzt aber wirklich Montagezeichnungen
    [JH_Greifer_Scheibe_final.0018.iam, JH_Greifer_Scheibe_final.0020.iam, JH_Greifer_Scheibe_final.iam, Montagezeichnung Greifer.0013.dwg, Montagezeichnung Greifer.0014.dwg, Montagezeichnung Greifer.dwg, Montagezeichnung Kantensensor.0007.dwg, Montagezeichnung Kantensensor.0008.dwg]
2025-06-26 Dokumentation JH
    [DIN EN ISO 4026 - M5 x 25.0001.ipt, DIN EN ISO 4026 - M5 x 25.0002.ipt, DIN EN ISO 4026 - M5 x 25.ipt]
2025-06-26 Zeichnung und Fazit
    [1376426 DSBC-32-100-PPVA-N3---(0).0085.iam, 1376426 DSBC-32-100-PPVA-N3---(0).0086.iam, 1376426 DSBC-32-100-PPVA-N3---(0).iam, 529120 DFM-16-150-B-P-A-KF---(0).0041.iam, 529120 DFM-16-150-B-P-A-KF---(0).0042.iam, 529120 DFM-16-150-B-P-A-KF---(0).iam, Antriebseinheit_ZSB.0009.iam, Antriebseinheit_ZSB.0010.iam]
2025-06-26 Zeichnungen zusammengetragen
    [Formnest_Fallmagazin.dwg, __Projekt_Useless_Box.0002.ipn, __Projekt_Useless_Box.0003.ipn, __Projekt_Useless_Box.dwg, __Projekt_Useless_Box.ipn]
2025-06-26 Dokumentation finale Version von JH, Korrektur von ER und TS noch erforderlich
2025-06-26 Zeichnungen PDF
    [Bewegeeinheit Schieber Explosion.0007.ipn, Bewegeeinheit Schieber Explosion.0008.ipn, Bewegeeinheit Schieber Explosion.ipn, Fingergreifer Explosion.0003.ipn, Fingergreifer Explosion.0004.ipn, Fingergreifer Explosion.ipn, Fingergreifer Festo Explosion.0002.ipn, Fingergreifer Festo Explosion.0003.ipn]
2025-06-26 Präsentationsfolien Baugruppen Erik und Fazit
    [Antriebseinheit_ZSB.0010.iam, Antriebseinheit_ZSB.0011.iam, Antriebseinheit_ZSB.iam, Motor_Ausgangswelle.0008.ipt, Motor_Ausgangswelle.0009.ipt, Motor_Ausgangswelle.ipt, Motor_Unterseite.0005.ipt, Motor_Unterseite.0006.ipt]
